CarolineMuellenbroich/Giovanni-goes-Giorgio/Neurophotonics/Images/laser-dpss-continuo-113403-3916845.jpg

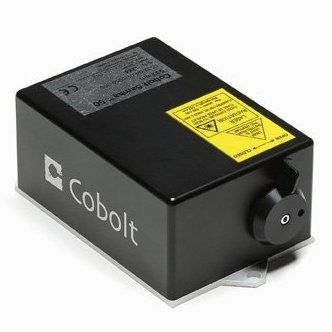
Neurophotonics/Images/laser-dpss-continuo-113403-3916845.jpg
