CarolineMuellenbroich/Giovanni-goes-Giorgio/Neurophotonics/Images/MDSnCxx_medium.jpg

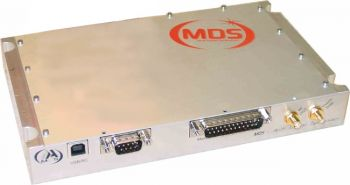
Neurophotonics/Images/MDSnCxx_medium.jpg
