CarolineMuellenbroich/Giovanni-goes-Giorgio/Neurophotonics/Stuff/latex-style-files-used/README.TXT

README - LATEX STYLE FILES USED

These files are supplied in case they are not readily available. It is preferable to download (or have system administrator downloag) current versions from CTAN.ORG.
