CarolineMuellenbroich/Giovanni-goes-Giorgio/Neurophotonics/Submitted files/manuscript_revision.tex

%  The following commands have been added in the SPIE class 
%  file (spieman.cls) and may not be understood in other classes:
%  \affiliations{}, \sup{},\supit{}, \authorinfo{}, \keywords{},
%  \linkable and \video
%  The bibliography style file is called spiejour.bst 

\documentclass[12pt]{spieman}  %>>> 12pt font mandatory; use this for US letter paper 
%%\documentclass[a4paper,12pt]{spieman}  %>>> use this instead for A4 paper
%%\documentclass[nocompress,12pt]{spieman}  %>>> to avoid compression of citations
%% \addtolength{\voffset}{9mm}   %>>> moves text field down
 
\usepackage[]{graphicx}
\usepackage{setspace}
\usepackage{tocloft}
\usepackage{units}
\usepackage{nicefrac}
\usepackage{color}
\usepackage{epstopdf}
\usepackage[globalcitecopy,labelstoglobalaux,sectionbib]{bibunits}
\usepackage[thinspace,thinqspace,squaren]{SIunits}
\usepackage{fancyhdr}
\usepackage{url}
\usepackage{wasysym}
%\usepackage{alltt}
%\renewcommand{\ttdefault}{txtt} 
\usepackage{array}
%\usepackage[version=3]{mhchem}
%\usepackage[T1]{fontenc}
%\usepackage{textcomp}
%\usepackage{verbatim} 
%\usepackage{mathpazo}
%\usepackage{amsmath} %>>> for AMS math formatting including bold Greek symbols
%\usepackage{mathtools}
\usepackage{amssymb}
\usepackage{accents}
%\usepackage{hyperref}
\usepackage{url}
\usepackage{amscd}
\usepackage{epsfig}
\usepackage{cite}
\usepackage{subfig}
\usepackage[globalcitecopy,labelstoglobalaux,sectionbib]{bibunits}
%\usepackage[sectionbib]{bibunits}
\usepackage{appendix}
\usepackage{slashbox}
\usepackage{multirow}
\usepackage{pbox}
%\usepackage{caption}
\usepackage{pdflscape}
\usepackage{nicefrac}
\usepackage{rotating}
\usepackage[colorlinks=true,citecolor=blue,urlcolor=blue,linkcolor=blue,
		pagebackref,
		hyperindex,%linktocpage,
		bookmarksnumbered=true,bookmarksopen=true,bookmarksopenlevel=0,
		pdfstartview=FitV,
		pdfstartpage=1]
	{hyperref} % makes pdf look nice with hyperlinks

\title{Comprehensive optical and data management infrastructure for high-throughput light-sheet microscopy of whole mouse brains} 

\author{M. Caroline M\"{u}llenbroich,\supscr{a,b} Ludovico Silvestri, \supscr{a,c} Leonardo Onofri,\supscr{a} Irene Costantini,\supscr{a} Marcel van 't Hoff,\supscr{a,b} Leonardo Sacconi,\supscr{a,c} Giulio Iannello,\supscr{e} Francesco S. Pavone,\supscr{a,b,c,d}  }

\affiliation{\supscrsm{a}European Laboratory for Non-Linear Spectroscopy (LENS), University of Florence, Italy\\
\supscrsm{b}Department of Physics and Astronomy, University of Florence, Italy\\
\supscrsm{c}National Institute of Optics, National Research Council, Italy\\
\supscrsm{d}International Center for Computational Neurophotonics (ICON Foundation), Italy\\
\supscrsm{e}Integrated Research Centre, University Campus Bio-Medico of Rome, Italy\\
}

%%%%%%%%%%%%%%%%%%%%%%%%%%%%%%%%%%%%%%%%%%%%%%%%%%%%%%%%%%%%% 
\renewcommand{\cftdotsep}{\cftnodots}
\cftpagenumbersoff{figure}
\cftpagenumbersoff{table} 
\begin{document} 
\maketitle 

%%%%%%%%%%%%%%%%%%%%%%%%%%%%%%%%%%%%%%%%%%%%%%%%%%%%%%%%%%%%% 
\begin{abstract}
The comprehensive mapping and quantification of neuronal projections in the central nervous system requires high-throughput imaging of large volumes with microscopic resolution. To this end, we have developed a confocal light-sheet microscope that has been optimised for the 3D imaging of structurally intact clarified whole-mount mouse brains. Here we describe the optical and electro-mechanical arrangement of the microscope and give details on the organisation of the microscope management software. The software orchestrates all components of the microscope, coordinates critical timing and synchronisation and has been written in a versatile and modular structure using the LabVIEW language.  It can easily be adapted and integrated to other microscope systems and has been made freely available to the light-sheet community. The tremendous amount of data routinely generated by light-sheet microscopy further requires novel strategies for data handling and storage. To complete the full imaging pipeline of our high- throughput microscope we further elaborate on big data management from streaming of raw images up to stitching of 3D data sets. The meso-scale neuroanatomy imaged at micron-scale resolution in those datasets allows characterisation and quantification of neuronal projections in unsectioned mouse brains. 
\end{abstract}

%>>>> Include a list of up to six keywords after the abstract
\keywords{Light-sheet microscopy, selective plane illumination microscopy, whole brain imaging, data management, software management, high-throughput imaging}

%>>>> Include contact information for corresponding author
{\noindent \footnotesize{\bf Address all correspondence to}: Francesco S. Pavone, LENS, University of Florence, Via Nello Carrara 1, 50019 Sesto Fiorentino (FI), Italy; Tel: +39 055 457 2480; E-mail:  \linkable{francesco.pavone@unifi.it} }
%%%%%%%%%%%%%%%%%%%%%%%%%%%%%%%%%%%%%%%%%%%%%%%%%%%%%%%%%%%%%

\begin{spacing}{2}   % use double spacing for rest of manuscript

%%%%%%%%%%%%%%%%%%%%%%%%%%%%%%%%%%%%%%%%%%%%%%%%%%%%%%%%%%%%%
\section{Introduction}
\label{sect:intro}  

The highly ambitious project of mapping and understanding each and every neuronal projection in the whole brain has been moved to feasible reality by the recent advent of light-sheet fluorescent microscopy (LSFM)\cite{Huisken2004,Dodt2007,Keller2012}. With this technique 3D data sets can be acquired with a resolution that is high enough to identify neurons and their dendritic and axonal features in time scales which are no longer the bottle neck of high-throughput acquisition. In LSFM, the sample is illuminated with a thin sheet of light confined into the focal plane of the detection objective, which collects the fluorescence emission along an axis perpendicular to the illumination plane\cite{Huisken2009}. This technique drastically reduces the imaging acquisition time by recording millions of pixels in parallel due to its wide-field detection and affords intrinsic optical sectioning due to the light-sheet illumination. Consequently fluorophores outside the light-sheet are neither bleached nor contribute blurring out-of-focus noise. Together these attributes cause a high spatio-temporal resolution and an excellent signal to noise ratio in LSFM. 

Several challenges remain to be overcome, however, to allow fast and, most of all, systematic production of reliable datasets and their meaningful interpretation to further our understanding of neuronal networks. Those challenges include fast, cheap and reproducible sample preparation and mounting, automated image acquisition and, most crucially, storage, interpretation and analysis of the vast data sets light-sheet microscopy routinely produces\cite{Freeman2014,Burns2014}. The mapping and understanding of this ``big data" is an immense task that requires the expertise of computer scientists to employ fully automated, scalable post-processing, for example, to do blood vessel segmentation or cell counting\cite{Frasconi2014}. On the other hand, the imaging of large, intrinsically opaque samples in LSFM necessitates clearing protocols based on refractive index matching which render the tissue transparent\cite{Chung2013,Tomer2014}. Therefore technological advances in LSFM need to be matched by novel development in the area of information- and biotechnology.

Here we will present a state-of-the-art light-sheet microscope, as it is implemented in our lab, that is especially well suited to acquire 3D data sets of clarified and structurally intact mouse brains. The LSFM features double-sided illumination with a digitally scanned light-sheet and a sample chamber which has been specifically designed for the the imaging of large ($> 1cm^3$) immersed and freely movable samples. After briefly introducing the optical setup we explain how to prepare and mount the samples for stable 3D imaging for several days. In addition, a full description of the control hardware and software is presented. The microscope software coordinates every microscope component and ensures critical timing and synchronisation between those components. We further give a systematic and robust approach to handle and store light-sheet microscopy data of several terabytes. To conclude the comprehensive and high-throughput imaging pipeline we furthermore elaborate on stitching of large 3D data sets. The imaging capabilities of our light-sheet microscope are exemplified with tomographies of whole transgenic mouse brains.

\section{Optical setup}

\subsection{Laser unit}		
The custom-made confocal light-sheet microscope is equipped with five linearly polarised, continuous-wave lasers for fluorescence excitation (Fig. \ref{fig:excitation},A). The wavelengths were chosen to excite the most common fluorophores (see Table \ref{tab:optomechanics} for the manufacturer and specifications of microscope components). The beam from each laser is first collimated and expanded with a telescope made of singlet lenses (f140, f200) and then combined into a common path with a mirror and a long-pass filter (Semrock, LaserMUX\texttrademark\ series). From here on all lenses are achromatic doublets coated for the visible spectrum. An acousto-optical tunable filter (AOTF) acts as fast ($\mu s$) electronically tunable filter and intensity modulator. Due its nonlinear response we measured the AOTF light transmittance for each wavelength as a function of radio frequency amplitude and determined a look-up table to linearise the output. The zero order light is blocked by an iris. A 1:1 telescope (f150,f150) is used to re-collimate the beam after the AOTF. An electro-optical laser modulator (EOM) acts like a wave plate with electronically controlled retardation and rapidly rotates (few hundreds ns) the input polarisation of the excitation light by $90\degree$. A digital line is used to switch between the voltage levels, allowing control of the frequency with which the polarisation is changed (see also section \ref{sec:timing} on timing).

\subsection{Illumination unit}		
The light impinges onto a polarising beam splitter cube which splits the excitation light depending on its polarisation into one of the two identical excitation arms. The beam diameter is reduced with a telescope (f350, f200) whose telecentric plane coincides with the mirrored surface of a galvanometric scanner (galvo). Both galvos are mounted on a custom made optical breadboard which features two circular holes to pass the periscopic beams and a large central cut-out for the sample chamber and motor stages (Fig. \ref{fig:excitation},B). 

Each scan mirror surface is re-imaged with a telescope (f50, f100) onto the back aperture of a long working distance low magnification objective (Nikon, 10x 0.3NA WD 17.5mm). The focal lengths of the doublets making up the telescope have been chosen for space considerations and to achieve a $1/e^2$ beam radius of 0.73mm at the back focal plane resulting in an effective NA of 0.025 (see also section \ref{sec:characterisation}). The galvos are in planes conjugated with the back focal plane of their respective excitation objective to ensure that a tilt angle of the galvo converts into a lateral translation of the Gaussian beam across the specimen. The two excitation objectives are designed for air immersion but are immersed into the clearing solution (n=1.45) within the sample chamber. A coverslip glued to the front housing edge serves the dual purpose of maintaining the first diffractive surface between the front optical element and the air and to protect the front lens elements from the clearing agent. A guide to align objectives to a common focus can be found in the supplementary information. The light-sheet is generated digitally\cite{Keller2008a,Keller2008b} by scanning the excitation beam across the focal plane of the detection objective. This generates incoherent illumination resulting in fewer artefacts. Additionally each line in the specimen is illuminated with the same intensity creating a homogeneous light-sheet which is particularly advantageous for the quantitative and qualitative investigation of large samples in their entirety.

\subsection{Detection unit}
			 
Fluorescence is collected with an objective that is specifically designed for immersion in clearing solutions. The objective is equipped with a correction collar allowing for immersion in media with refractive indices ranging from 1.41 to 1.52 (Olympus, XLSLPLN25XGMP, 25x, 1.0NA, effective focal length 7.2 mm, working distance 8mm). A tube lens of 200mm creates an image on a sCMOS camera (Orca Flash4.0, Hamamatsu) with a chip of over 4 megapixels. The cell size of the OrcaFlash is $p^2= (6.5\micro m)^2$ over an active area of $r^2= (13.3mm)^2$. With a 200mm tube lens the field of view (FOV) in the sample is $(480\micro m)^2$ (see also Table \ref{tab:resolution} in the supplementary information for relevant formulas). 

In the camera's rolling shutter acquisition mode only a subset of adjacent horizontal pixel lines is simultaneously exposed and this active detection region is moved across the image sensor\cite{Baumgart2012}. With the delay between the exposure of two adjacent lines set to the minimum time required to read out a single line ($t_{\text{shutter}}=9.7\micro s$) the entire frame of 2048 horizontal lines is activated within 19.86ms. Setting the line exposure time to $t_{\text{exp}}=0.3ms$, for instance, results in $l=\nicefrac{t_{\text{exp}}}{t_{\text{shutter}}}\approx31$  lines being simultaneously exposed at any time. This detection area is swept from the top to the bottom of the chip and acts like a moving, virtual confocal slit corresponding to a width of $s_{\text{object}}=\nicefrac{l p}{M_{\text{eff}}}= 7.2 \micro m $ in the sample space, where $M_{\text{eff}}$ is the effective magnification of the detection objective. With the given values of line exposure and line read out time, the camera acquires images at a full-frame rate of  $R_{\text{frame}} = \nicefrac{1}{(\#_{\text{horiz. lines}}*t_{\text{shutter}}+t_{\text{exp}})} \approx 50Hz$. 

The camera was run as master in the internal trigger mode and a synchronisation pulse generated with the exposure of each new line was used as an output trigger for a DAQ board (NI PCIe-6353, National Instruments) which was operated as slave. The saw-tooth driving signal for the galvo mirrors was generated by the DAQ and synchronised with the pixel line reset pulses from the camera to achieve confocal line detection (see also section \ref{sec:timing} on synchronisation).  

\subsection{Sample mounting and motion}
\label{sec:mounting}
		
We designed a cubic water-tight sample chamber (Fig. \ref{fig:frame2},A) that allows access from all six sides while maintaining the 3D integrity of large clarified and fluorescently labelled mouse brains. The sample chamber is tightly bolted  to the optical breadboard while soft connections using silicone bellows allow for adjustive movements of the objectives and free 3D motion of the motor stages (Fig. \ref{fig:frame2},B). Connections are sealed with rubber rings and silicone caulk and additionally tightened with cable binders. In this way the objectives can be refocused and realigned without compromising the watertight seal of the chamber (Fig. \ref{fig:frame2},C). The clarified brains are imaged immersed in clearing solution composed of 63\% 2,2'-thiodiethanol (TDE) in Phosphate buffered saline (PBS) and a refractive index of $n \approx 1.45$\cite{Costantini}. To fill the entire volume of the sample chamber approximately 150ml clearing solution are needed. A motorised x-, y-, z-, $\theta$-stage (see Table \ref{tab:optomechanics}) allows free 3D motion and rotation of a Teflon cylinder which reaches into the centre of the chamber (Fig. \ref{fig:frame2},D). Illumination and detection axes are horizontal while sample rotation occurs around the vertical axis.		
		
To elucidate neuronal projections in structurally intact tissue it is paramount to be able to image centimeter-sized clarified samples, such as mouse brains, with high resolution in whole mount preparation. The problem of sample mounting in a light-sheet microscope arises from the fact that optical access to the sample is required from 3-4 planar sides leaving only two opposing sides to insert, fix and move the sample. Stable mounting is hereby a key concern as a whole-brain tomography can require image acquisition in excess of 24 hours and the effects of gravity, tissue shrinking/expansion and evaporation of the clearing solution over such time spans might have to be considered. 

For the acquisition of whole-brain data sets, we fix a clarified and fluorescently-labelled mouse brain with super glue to a coverslip (Fig. \ref{fig:frame2},E). The brain is oriented along its axial orientation with the olfactory bulbs at the top and the cerebellum at the bottom of the coverslip. The coverslip is slid into a bottom adaptor and tightened with a plastic-capped grub screw. The bottom adaptor is inserted into a Teflon cylinder with the coverslip being positioned on the far side of the detection objective. Three different slits in the adapter correspond to varying distances to the detection objective and give variability in sample thickness for example to allow also for the mounting of rat brain hemispheres.
	
\subsection{Optical characterisation}
\label{sec:characterisation}
\subsubsection{Theoretical considerations}

The optical properties of a microscope can be quantified by the point-spread function (PSF), which is the image of a point source in object space. The radial (i.e. perpendicular to the detection axis) and axial (i.e. parallel to the detection axis) resolution of the microscope are most commonly described by the full width at half-maximum (FWHM) of the PSF itself along the chosen direction (Fig. \ref{fig:origin},A). In a light-sheet microscope axial and radial resolution are determined by the numerical aperture (NA) of the illumination and detection optics respectively. The radial PSF is a standard Airy function whose FWHM is given by:

\begin{equation}
\text{FWHM}_{\text{radial}} \simeq \frac{0.51 \lambda_0}{\text{NA}_{\text{d}}},
\end{equation}
$\lambda_0$ being the wavelength in vacuum and $\text{NA}_{\text{d}}$ the NA of the detection objective. The axial resolution is dominated by the thickness of the light sheet which for high NA detection objectives is usually larger than the depth of field of the detection objective. If Gaussian beams are used for illumination, the thickness of the light sheet can be calculated by the well-known formulas of Gaussian optics\cite{Teich}. The radius of the beam waist is given by:

\begin{equation}
w_0 = \frac{\lambda f_{\text{i}}^{\text{eff}}}{\pi w},
\end{equation}
where $w$ is the $1/e^2$ radius of the beam entering the illumination objective, $ f_{\text{i}}^{\text{eff}}$ is the effective focal length of the illumination optics and $\lambda$ is the wavelength in the medium ($\lambda = \lambda_0 / n$, $n$ being the refractive index). Note that for air objectives (as the one we use for illumination) the effective focal length is extended by a factor $n$ when used inside a medium with refractive index different from unity\cite{Silvestri2012}.
The axial FWHM is then given by:

\begin{equation}
\text{FWHM}_{\text{axial}} \simeq 1.177 w_0.
\end{equation}
The thickness of the light sheet is not constant throughout the FOV due to the limited depth of focus of the Gaussian beam. The latter can be quantified by the confocal parameter $b$, which is the distance along which the beam $1/e^2$ radius remains relatively constant and smaller than $\sqrt{2} w_0$:

\begin{equation}
b = \frac{2\pi w_0^2}{\lambda} = \frac{2 \lambda  {(f_{\text{i}}^{\text{eff}})}^2}{\pi w^2}.
\end{equation}
The need to have an almost uniform resolution in the camera FOV imposes a lower bound to $b$ and thus (according to the previous equations) a limit to the axial resolution. In our setup we adjusted the telescopes in the excitation path in order to have $w \simeq 0.73 mm$, resulting in $b \simeq 346 \micro m$ (corresponding to 72\% of the FOV) and $\text{FWHM}_{\text{axial}} \simeq 5.13 \micro m$ (assuming $\lambda_0 = 0.5 \micro m$). An overview of the relevant formulas concerning the optical properties of a light-sheet microscope is given in Table \ref{tab:resolution}. The reader is referred to this table as a quick guide to tailor their microscope to their specific needs.

\subsubsection{Experimental characterisation}

For optimal imaging it is crucial that the sample-emitted line of fluorescence is in the centre of the rolling shutter at the start of each image acquisition and furthermore travels with the same speed during stack acquisition. To this end the galvo scanners were calibrated using a fluorescein solution in the sample chamber and an image of the focal line was acquired for a set of mirror angles. By fitting each focal line profile to a Gaussian curve the position of the beam main axis was determined and plotted against the voltage applied to the galvo scanner. A linear fit to this data yielded the precise amplitude and offset for each galvo scanner. The finite width of the confocal slit was hereby taken into account such that maximum beam deflection corresponded to the central pixel line of the confocal slit coinciding with the first and last pixel row on the camera chip. From the same data the average FWHM of the Gaussian excitation line over the FOV of the camera was calculated as $(8.60\pm0.67)\micro m$ (n= 14). The disagreement with the theoretical value of $5.13 \micro m$ is likely attributed to the refractive index mismatch introduced in the excitation arm by the protective coverslip and by the optical path inside a medium with a refractive index different from air, both causing spherical aberrations\cite{Booth2001}.

For quantitative analysis of spatial resolution and the signal to noise ratio (SNR) image stacks of nanometric fluorescent beads ($0.51 \micro m$ diameter, Bangs Laboratories) were acquired. The spatial resolution, in agreement with previous findings\cite{Wilson1987,Cox2004}, was not affected by the confocal slit width on the camera (Fig. \ref{fig:origin},B). The lateral and axial FWHMs were $(1.00\pm0.04) \micro m$ and $(8.13\pm0.14) \micro m$ respectively, averaged through stack depths and confocal slit widths. The experimentally determined lateral FWHM was larger than the theoretically calculated value of $0.26 \micro m$ by a factor of four. The discrepancy is likely caused by higher order aberrations introduced by the gel embedding the fluorescent beads exacerbated by the high NA of our detection objective\cite{Schwertner2004,Schwertner2007}.

Qualitatively, the SNR increased with increasing slit width up to a maximum around the $1/e^2$ illumination beam diameter of $8.6 \micro m$ and then decreased again with further increasing slit width (Fig. \ref{fig:origin},C) in agreement with previous observations\cite{Baumgart2012}.   

\section{Microscope management software}

\subsection{General design}
The many components of the microscope (camera, lasers, AOTF, stages, etc.) are orchestrated and operated through a custom-made software written in the LabVIEW language (National Instruments, Austin, US). Since the microscope should work mainly without human intervention for many hours (a whole-brain tomography can last a couple of days) without losing precise synchronisation, stringent software design is a primary concern. The overall architecture of the software and its practical implementation were chosen to satisfy two main principles; firstly, operation in a distributed environment and secondly, robustness and ease of maintenance. This means, the apparatus should be able to deal with many independent hardware components and with several data streams (see below). Individual processing steps and/or data transfer can be computationally intensive, and may need to be distributed over several computers to perform properly at run-time. Any kind of hardware failure, from timing delays to complete system crash, must be automatically handled to avoid loss of data.

An object-oriented programming framework \cite{castagna1997object} has been used for software development, dividing the entire project into well-defined self-contained modules. This framework, besides helping defining the proper scope of each software component, guarantees robustness, ease of maintenance, scalability and reusability. Code was stored on GitHub (www.github.org) to help multiple users developing software simultaneously. The Murmex software development kit (see supplementary information \ref{sec:murmex}) was used to operate the software efficiently and synchronously on different computers.

\subsection{System timing}
\label{sec:timing}

A schematic overview of the hardware architecture of our LSFM is shown in Fig. \ref{fig:connectivity}. One personal computer (Precision T5600, Dell, see also Table \ref{tab:optomechanics}) controlled all the remote hardware components with the exception of the camera, which was controlled by a second, dedicated computer (Precision T7500, Dell) to handle and manage the enormous streams of data produced (see also section \ref{sec:dataflow}). Various instrumentations were addressed either through computer ports (as USB, RS232 and CameraLink) or via analog and/or digital signals generated by the DAQ board.

Synchronisation of the camera rolling shutter to the scanning of the light sheet was achieved by letting the camera acquiring in free-run mode, and using a trigger output from the camera itself to time the generation of the waveforms sent to the galvo drivers. The HSYNC signal from the camera was used which provided true-type-logic (TTL) pulse every time the rolling shutter stepped from one line to the next one. This trigger signal was used as a clock by the DAQ board so that the line producing the light sheet moved step by step with the rolling shutter. The same HSYNC signal was also used to trigger the DAQ digital signal sent to the laser modulator. Since at each position of the scanning line the modulator should go trough at least two states (vertical and horizontal polarisation), HSYNC was used as a trigger signal while the the much faster internal clock of the DAQ board served as clock.

\section{Data Management}
\label{sec:dataflow}

The volume of an adult mouse brain has been estimated from MRI measurements \cite{Kovacevic2005} as $\simeq 0.5$ $\text{cm}^3$; the same authors determined that a parallelepiped encompassing the whole brain would have a volume of $\simeq 0.9$ $\text{cm}^3$. Given the pixel size of the camera and the magnification of the system, and assuming a $z$ step of 2 $\micro$m, the voxel size amounts to $0.234\times0.234\times2$ $\micro\text{m}^3$. This means that a mouse brain will be represented with about 4.6 TeraVoxels, while a parallelepiped encompassing the brain will result in 8.2 TeraVoxels. Since the camera produces 16 bit images with no compression, each raw voxel occupies 2 bytes of disk space, resulting in 8.3 TB solely for the whole brain and 14.8 TB for the encompassing parallelepiped (see Table \ref{tab:dataproduction}). However, image stacks are acquired with 10\% of linear superposition, which is later used for image stitching. This redundancy expands the size of raw data to 10.2 TB and 18.3 TB, respectively.

This tremendous amount of data challenges the traditional way we interact with our data. Having far passed the point of taking your data home with you on a hard drive at the end of the experiment, the handling of data in light-sheet microscopy requires the development of a robust data management infrastructure and of novel software tools to process the images in order to extract meaningful information.

The camera flushed the data stream directly to a dedicated workstation with 12 solid-state drives (SSD) operating in RAID 0 configuration, resulting in a virtual drive of 10.9 TB. Although this was already a large and expensive system for the current SSD technology, it was much smaller than the size of the raw datasets produced in each tomography. We thus connected the workstation to a larger network area storage (NAS) via a 10 Gbit/s network copper cable. The NAS operates in a safer data modality (RAID 5) with 32.4 TB of useful disk space. The NAS is then connected by a dedicated 10 Gbit/s link provided by the Consortium GARR (the Public Institution managing research networks in Italy) to CINECA (the main Italian supercomputing centre). The data flow scheme is summarised in Fig. \ref{fig:DataFlow}.

While transferring data from the SSDs to the NAS, we perform on-the-fly conversion of files generated during sample acquisitions to a losslessly compressed multi-page TIFF format. Our conversion module leveraged the functionalities offered by the interface of the DCIMGAPI library, supplied by Hamamatsu, and the freely available LibTIFF library. The module read a single \textit{.cxd} 3D image and wrote it in a variable number of multi-page TIFF files, depending on the user-defined limit of pages per file. Since the output of the Hamamatsu camera may exceed tens of GB, the image in proprietary format was read slice by slice to minimise memory requirements. The conversion module ran concurrently with the microscope controlling software and was synchronised to convert stack files as soon as they are completed. The module provided options to downsample the image or to save the input image at full or reduced resolution in order to adapt to storage requirements. Usually we downsampled the image in the XY plane by a factor 2 and left the Z sampling unaltered. This downsampling, in combination with the lossless compression offered by the TIFF format, reduced data size by about one order of magnitude. Thus the parallelepiped volume containing the whole mouse brain took up about 2-3 TB of disk space. 

The process executing the file conversion was set to low priority to prevent interference with the Camera component, which needs to be perfectly timed with acquisition. Although file conversion drastically reduces data size, in the current implementation it was slower than data production. The camera flushed data to the SSDs with a rate $R_{\text{data}}$ dependent on the frame rate $R_{\text{frame}}$ and on the image size: $R_{\text{data}} [\text{Bytes}] = 2\cdot R_{\text{frame}} \cdot \#_{\text{pixels}}$
where the factor of two takes into account the 16 bit grey depth of images. The volumetric imaging rate is given by $R_{\text{volume}} = 0.5 R_{\text{data}} \cdot \text{voxel size}$.

With a standard image size of $2048 \times 2048$ pixels, and $R_{\text{frame}}=50$ Hz, data were produced at a rate $R_{\text{data}}=400$ MB/s $\approx 1.37$ TB/h, which resulted in a volumetric rate $R_{\text{volume}} \approx 2.3 \times 10^7$ $\micro\text{m}^3/s$ $\approx 0.08$ $\text{cm}^3$/h. The conversion module freed the SSDs with an average rate of $\approx$ 0.7 TB/h, meaning that the SSDs were actually filled up during imaging at a rate of $\approx$ 0.67 TB/h. Imaging sessions needed thus to be shorter than 16.3 hours which limited the maximum amount of raw data being acquired continuously to $\approx$ 22.3 TB. However, this was well above the disk space needed to image the parallelepiped volume encompassing a whole mouse brain. Larger specimens, as rat brain or portions of human brain, must be imaged in consecutive session until faster strategies for image conversion are devised.

\begin{table}%[t!]
	\centering
		\caption[Data production]{Data production rates for typical camera operation.\label{tab:dataproduction}}
		\begin{tabular}{lrl}
		\\
		Voxel size																								& $0.234 \times 0.234 \times 2$	& $\micro\text{m}^3$ 	\\
		Frame rate																								& 50														& Hz								\\
		Frame size																								& $2048 \times 2048$ 						& pixels						\\
		Frame disk size																						& 8									 						& MB								\\
		Data production rate																			& 1.37							 						& TB/h 							\\
		Data conversion rate																			& 0.7								 						& TB/h 							\\
		Net SSD filling rate																			& 0.67							 						& TB/h 							\\
		SSD RAID size																							& 10.9							 						& TB								\\
		Max acquisition time to fill up SSDs											& 16.3							 						& h									\\
		Max raw data size that can be acquired continuously				& 22.3							 						& TB								\\
		Max volume that can be imaged 														& 1.04							 						& $\text{cm}^3$ 		\\
		(considering 10\% superposition between adjacent stacks)	&										 						&										\\
		\end{tabular}
\end{table}

After acquisition, the tiled raw images produced had to be stitched to a 3D data set. To perform this operation we used the TeraStitcher\cite{Bria2012}, a fully automated stitching tool designed to deal with tiled images of virtually unlimited size. TeraStitcher can run on machines with limited resources with a performance essentially determined only by the transfer rate towards secondary storage. TeraStitcher can be freely downloaded from https://github.com/abria/TeraStitcher.

\section{Representative results}

Some representative data produced by our microscope are reported in Fig. \ref{fig:LSMdata}. With the apparatus described in this paper, whole mouse brains could be imaged in their entirety (Fig. \ref{fig:LSMdata},A), maintaining a high quality of the image also when going deep inside the specimen (Fig. \ref{fig:LSMdata},B). The resolution and contrast of the images allowed to clearly distinguish axonal tracts (Fig. \ref{fig:LSMdata},C) in the brain of a PV-cre-dTomato transgenic mouse, in which parvalbuminergic neurons are fluorescently labelled. Lateral and axial intensity profiles through a fine axonal projection were used to estimate resolution in a brain data set in terms of the FWHM in the lateral and axial directions (Fig. \ref{fig:LSMdata},D). The lateral and axial FWHM were $1.7 \micro m$ and $8.5 \micro m$ respectively, in agreement with the measurements on fluorescent beads.  Whole-brain datasets as presented here can be used to localise cell distributions in 3D using automatic cell-detection software \cite{Frasconi2014}.

\section{Discussion and conclusion}

Light-sheet microscopy has already been a game changer for large-scale, high-throughput imaging by yielding data of high spatio-temporal scale. This measurement technique will continue to have a high impact in the field of whole-brain imaging due to its ability to record millions of images over the course of days or even weeks. Here we have presented a complete and detailed framework for whole mouse brain imaging. Starting with a full description of our double-sided light-sheet microscope and its constituent components we further gave details of the custom-written control software which coordinates the microscope's reliably synchronised operation. The data produced in our experiments easily amounts several TB per data set and needs to be compressed, stored, transferred, retrieved and processed necessitating the concurrent development of novel computational interface and analysis methods. Here we have presented a comprehensive, robust and fully automated pipeline of data management starting from the streaming of raw images up to the stitching of 3D data sets.

%clearing
The mouse brains imaged in our microscope are intrinsically opaque and need to be clarified before imaging. A successful optical clearing method not only renders the tissue transparent but also causes neither quenching of protein fluorescence nor tissue distortion and is compatible with repetitive immunostaining. A very promising method called CLARITY\cite{Chung2013,Tomer2014} transforms tissue into a nanoporous, hydrogel-hybridised, lipid-free form. Crucially for the high-throughput imaging of large samples that we aim for, the protocol, however, is also fast, easy and cheap. We therefore developed a versatile, simple, rapid and inexpensive clearing method described elsewhere\cite{Costantini} which in combination with CLARITY allows for the optical clearing of entire mouse brains or portions of human tissue.

%ao
Even in refractive index-matched samples we have noticed that significant aberrations degrade image quality, especially at depths towards the end of the stack. Recently objectives specifically conceived for LSFM have become commercially available\cite{Marx2014} which have been designed for use with clearing solutions and typically also feature a correction collar for the compensation of a certain amount of spherical aberration. A complete correction of system-induced aberrations, however, requires the ability to also correct for residual spherical aberration and higher-order aberrations introduced by the sample mount, immersion medium and slight misalignments of the optical system. Of course, aberrations introduced by the sample itself also degrade image quality and it is those aberrations that are most difficult to correct at run-time due to their modal complexity, large amplitude and high spatial variability\cite{Wang2014}. 

Additionally another problem inherent to light-sheet microscopy degrades image quality: due to the uncoupled nature of excitation and detection in LSFM, the aberrations encountered in each arm are independent too and this can lead to a walk-off between the light sheet and the detection FOV when large samples are imaged at depths. Adaptive optics\cite{Booth2007} provides a means to compensate for these aberrations and has recently been applied to improve LSFM\cite{Jorand2012}. The prospect of high quality images is especially essential for high through-put imaging methods for whole-brain 3D reconstructions because the size of data sets is so large they warrant fully automated post processing for example for automated cell counting and identification\cite{Frasconi2014}. The effect of optical aberrations can severely obscure features even above the resolution limit and therefore hinder automated segmentation of the data. We have mounted the camera on a separate breadboard which leaves us with a lot of free, infinity-corrected space in the detection path. The implementation of adaptive optics technology into the fluorescence emission path of our LSFM in order to demonstrate real-time aberration corrected images for whole-brain reconstructions will be considered in the future. 

%Bessel beam
Further improvements in image quality may be achieved with beam shaping in the illumination arm, for example by implementing Bessel beam illumination\cite{Fahrbach2010,Planchon2011,Gao2014}. Using these self-reconstructing, non-diffractive beams the optical sectioning capability can be improved over an extended FOV. 

The streamlining of high-throughput imaging of entire mouse brains, starting from the live animal up to quantifiable data sets, requires tight integration of all aspects of the work flow. Even if the brains we image are transparent, their large size means that also comparatively small heterogenities in the refractive index matching sum up to large optical path differences and therefore strong aberrations at large imaging depth. The microscope used for whole-brain imaging needs to be developed and adapted bearing those imaging circumstances in mind and sample preparation methods, imaging technology and data management schemes have to work as a unit in order to deliver on the highly anticipated, quantifiable data sets of whole-brain neuronal projections.

\begin{landscape}
\begin{table}[t!]
	\centering
		\caption[Components]{Overview of microscope components.\label{tab:optomechanics}}
		\begin{tabular}{llll}
		Component														&	Manufacturer																& Part\# 						& Specifications 														\\\hline\hline
		\multirow{5}{*}[2.5em]{Lasers} 			& \multirow{5}{*}[2.5em]{Cobolt AB, Sweden}		& MLD								& 405nm,  80mW, s-polarised											\\
																				&																							& MLD								& 445nm, 50mW, s-polarised											\\
																				&   																					& Calypso						& 491nm, 50mW, s-polarised											\\
																				&																							& Fandango					& 515nm, 50mW, s-polarised											\\
																				&																							& Jive							& 561nm, 50mW, s-polarised											\\\hline
		AOTF																& AA Opto-Electronic, France									&AOTFnC-400.650-TN 	&	\pbox[t]{10.5cm}{$>90\%$ diffraction efficiency, 3nm resolution, low cross talk between laser lines, high separation angle}\\\hline
		Laser modulator 										& Qioptiq	GmbH, Germany												& LM 0202 VIS ADP		& 400-650nm , $\nicefrac{\lambda}{2}$-voltage (633nm): 210V			\\\hline
		Pulse amplifier 										& Falco Systems, The Netherlands							& WMA-300						& 50x amplification up to $\pm$ 150V, DC to 5MHz signal bandwidth		\\\hline
		Galvo scanner 											& Cambridge Technology, USA										& 6220H 						& small angle step response $200\mu s$								\\\hline		
		\multirow{2}{*}[0.6em]{Objectives}	&	Nikon; Japan																& Plan Fluor EPI 		& 10x0.3NA, WD 17.5mm, EFL 20mm (excitation)						\\
																				& Olympus, Japan															& LMPLFLN20X 				& 20x0.4NA, WD 12mm, EFL 9mm (detection)							\\\hline
		\multirow{3}{*}[1.2em]{Motor stages}& \multirow{2}{*}[0.6em]{Physik Instrumente, Germany}& C-863.11		& DC servo-motor controller								\\
																				&																							&	M-122							& Travel range 25mm, $0.1\micro m$ resolution, max. velocity 20mm/s	\\
																				&																							& M-116 						& Precision Rotation Stage, $2.5\micro rad$, max. velocity $20\degree /s$ \\\hline
		Camera 															& Hamamatsu, Japan														& Orca Flash4.0 	V2.0	& \pbox[t]{10.5cm}{sCMOS sensor, 2048(H) x 2048(V), cell dim.: $6.5\micro m$, active area: 13.3mm x 13.3mm, 16bit images}\\\hline
		DAQ board														& National Instruments, USA										& NI PCIe-6353			& \pbox[t]{10.5cm}{AI: 1 MS/s multichannel; 16-bit resolution, ±10 V; AO: 2.86 MS/s, 16-bit resolution, ±10 V; digital I/O lines (hardware-timed up to 10 MHz), 100MHz max counter frequency}\\\hline
		Workstation 1												& Dell, USA																		& T7500							&  \pbox[t]{10.5cm}{12GB RAM, Intel Xeon Processor X5647 @ 2.93 GHz, OS Windows 7 64 bit}\\
		Workstation 2												& Dell, USA																		& T5600							&  \pbox[t]{10.5cm}{8GB RAM, Intel Xeon Processor E5-2620 @ 2 GHz, OS Windows 7 64 bit}\\
		\end{tabular}
\end{table}
\end{landscape}

%%%%%%%%%%%%%%%%%%%%%%%%%%%%%%%%%%%%%%%%%%%%%%%%%%%%%%%%%%%%%
\acknowledgments
The authors are grateful to Riccardo Ballerini and Ahmed Hajeb from the mechanics workshop at LENS for fabrication of the sample chamber. We further thank Marco De Pas from the electronic workshop for his expertise in the fabrication of the custom-made amplification electronics. We thank GARR for the 10GB optical fibre connection to CINECA and  CINECA for hosting our data.\\ 
The research leading to these results has received funding from the European Union Seventh Framework Program (FP7\slash2007-2013) under grant agreements no. 604102 (Human Brain Project) and n$\degree$ 284464 (LASERLAB-EUROPE). The research has also been supported by the Italian Ministry for Education, University and Research in the framework of the Flagship Project NanoMAX, by  ``Ente Cassa di Risparmio di Firenze" (private foundation). Research activities were also supported by Regione Toscana in the program POR-CreO 2007-2013 (Linea di interventi 1.5.a - 1.6 - Bando Unico R\&S 2012) under grant agreement (CUP) n$\degree$ 6408.30122011.026000201. 

\section*{Conflict of interest}
M.v.H has a financial interest in Murmex by Distrio, Amsterdam the Netherlands.

%%%%%%%%%%%%%%%%%%%%%%%%%%%%%%%%%%%%%%%%%%%%%%%%%%%%%%%%%%%%%
%%%%% References %%%%%

%\bibliography{report2}   %>>>> bibliography data in report.bib
\bibliographystyle{spiejour}   %>>>> makes bibtex use spiejour.bst
\begin{thebibliography}{0}

\bibitem{Huisken2004} J. Huisken, J. Swoger, F. Bene, J. Wittbrodt, and E. Stelzer, ``Optical Sectioning Deep Inside Live Embryos by Selective Plane Illumination Microscopy," \emph{Science} \textbf{305}(5686), 1007–1009 (2004). 

\bibitem{Keller2012} P. Keller and H.-U. Dodt, ``Light sheet microscopy of living or cleared specimens," \emph{Curr. Opin. Neurobiol.} \textbf{22}(1), 138–43 (2012). 

\bibitem{Dodt2007} H.-U. Dodt, U. Leischner, A. Schierloh, N. J\"{a}hrling, C. Mauch, K. Deininger, J. Deussing, M. Eder, W. Zieglg\"{a}nsberger, et al., ``Ultramicroscopy: three-dimensional visualization of neuronal networks in the whole mouse brain," \emph{Nat. Methods} \textbf{4}(4), 331–336 (2007). 

\bibitem{Huisken2009} J. Huisken and D. Y. Stainier, ``Selective plane illumination microscopy techniques in developmental biology," \emph{Development} \textbf{136}(12), 1963–1975 (2009).

\bibitem{Freeman2014} J. Freeman, N. Vladimirov, T. Kawashima, Y. Mu, N. Sofroniew, D. Bennett, J. Rosen, C.-T. Yang, L. Looger, et al., ``Mapping brain activity at scale with cluster computing," \emph{Nat. Methods} \emph{11}(9), 941–950 (2014).

\bibitem{Burns2014} R. Burns, J. Vogelstein, and A. Szalay, ``From Cosmos to Connectomes: The Evolution of Data-Intensive Science," \emph{Neuron} \emph{83}(6), 1249-1252 (2014).

\bibitem{Frasconi2014} P. Frasconi, L. Silvestri, P. Soda, R. L. Cortini, F. S. Pavone and G. Iannello, ``Large-scale automated identification of mouse brain cells in confocal light sheet microscopy images," \emph{Bioinformatics} \textbf{30}(17), i587-i593 (2014).

\bibitem{Chung2013} K. Chung, J. Wallace, S. Y. Kim, S. Kalyanasundaram, A. S. Andalman, T. J. Davidson and K. Deisseroth, ``Structural and molecular interrogation of intact biological systems," \emph{Nature} \textbf{497}(7449), 332–33 (2013).

\bibitem{Tomer2014} R. Tomer, L. Ye, B. Hsueh and K. Deisseroth, ``Advanced CLARITY for rapid and high-resolution imaging of intact tissues," \emph{Nat. Protoc.} \textbf{9}(7), 1682-1697 (2014).

\bibitem{Keller2008a} P. J. Keller and E. H. K. Stelzer, ``Quantitative in vivo imaging of entire embryos with digital scanned laser light-sheet fluorescence microscopy," \emph{Curr. Opin. Neurobiol.} \textbf{18}(6), 624–632 (2008).

\bibitem{Keller2008b} P. J. Keller, A. D. Schmidt, J. Wittbrodt, and E. H. K. Stelzer, ``Reconstruction of zebrafish early embryonic development by scanned light-sheet microscopy," \emph{Science} \textbf{322}(5904), 1065–1069 (2008).

\bibitem{Costantini} I. Costantini, J.-P. Ghobril, A. P. Di Giovanna, A. L. Allegra Mascaro, L. Silvestri, M. C. M\"{u}llenbroich, L. Onofri, V. Conti, F. Vanzi, L. Sacconi, R. Guerrini, H. Markram, G. Iannello, and F. S. Pavone, ``A versatile clearing agent for multi-modal brain imaging," \emph{Sci. Rep.} \textbf{5}(9808), (2015).

\bibitem{Baumgart2012} E. Baumgart and U. Kubitscheck, ``Scanned light-sheet microscopy with confocal slit detection," \emph{Opt. Express} \textbf{20}(19), 21805-21814 (2012).

\bibitem{Teich} M. C. Teich and B. E. A. Saleh, ``Fundamentals of photonics," \emph{Canada, Wiley Interscience} 3 (1991).

\bibitem{Silvestri2012} L. Silvestri, A. Bria, L. Sacconi, G. Iannello,  and F. S. Pavone,  ``Confocal light-sheet microscopy: micron-scale neuroanatomy of the entire mouse brain," \emph{Opt. Express} \textbf{20}(18), 20582-20598 (2012).

\bibitem{Booth2001} M. J. Booth and T. Wilson, ``Refractive-index-mismatch induced aberrations in single-photon and two-photon microscopy and the use of aberration correction," \emph{J. Biomed. Opt.} \textbf{6}(3), 266–272 (2001).

\bibitem{Wilson1987} T. Wilson and A. R. Carlini, ``Size of the detector in confocal imaging systems," \emph{Opt. Lett.} \textbf{12}(4), 227–229 (1987).

\bibitem{Cox2004} G. Cox and C. J. Sheppard, ``Practical limits of resolution in confocal and non-linear microscopy," \emph{Microsc. Res. Tech.} \textbf{63}(1), 18–22 (2004).

\bibitem{Schwertner2004} M. Schwertner, M. J. Booth, and T. Wilson, ``Characterizing specimen induced aberrations for high NA adaptive optical microscopy," \emph{Opt. Express} \textbf{12}(26), 6540–6552 (2004).

\bibitem{Schwertner2007} M. Schwertner, M. J. Booth, and T. Wilson, ``Specimen‐induced distortions in light microscopy," \emph{J. Microsc.} \textbf{228}(1), 97-102 (2007).

\bibitem{Kovacevic2005} N. Kovacevic, J. T. Henderson, E. Chan, N. Lifshitz, J. Bishop, A. C. Evans, R. M. Henkelman, and X. J. Chen, "A Three-dimensional MRI Atlas of the Mouse Brain with Estimates of the Average and Variability", \emph{Cereb. Cortex} \textbf{15}(5), 639-45 (2005).

\bibitem{Bria2012} A. Bria and G. Iannello,  ``TeraStitcher-A tool for fast automatic 3D-stitching of teravoxel-sized microscopy images,"  \emph{BMC bioinformatics} \textbf{13}(1), 316 (2012).

\bibitem{Marx2014} V. Marx, ``Microscopy: seeing through tissue," \emph{Nat. Methods} \textbf{11}(12), 1209–1214 (2014).

\bibitem{Booth2007} M. J. Booth, ``Adaptive optics in microscopy," \emph{Transactions of the Royal Society A} \textbf{365}(1861), 2829-2843 (2007).

\bibitem{Jorand2012} R. Jorand, G. Corre, J. Andilla, A. Maandhui, C. Frongia, V. Lobjois, B. Ducommun, and C. Lorenzo, ``Deep and Clear Optical Imaging of Thick Inhomogeneous Samples," \emph{PLoS ONE} \textbf{7}(4), e35795 (2012).

\bibitem{Wang2014} K. Wang, D. E. Milkie, A. Saxena, P. Engerer, T. Misgeld, M. E. Bronner, J. Mumm, and E. Betzig, ``Rapid adaptive optical recovery of optimal resolution over large volumes," \emph{Nat. Methods} \textbf{11}(6), 625–628 (2014).

\bibitem {Fahrbach2010} F. Fahrbach and A. Rohrbach, ``A line scanned light-sheet microscope with phase shaped self-reconstructing beams," \emph{Opt. Express} \textbf{18}(23), 780–785 (2010).

\bibitem {Planchon2011} T. Planchon, L. Gao, D. Milkie, M. Davidson, J. Galbraith, C. Galbraith, and E. Betzig, ``Rapid three-dimensional isotropic imaging of living cells using Bessel beam plane illumination," \emph{Nat. Methods} \textbf{8}(5), 417–423 (2011).

\bibitem {Gao2014} L. Gao, L. Shao, B.-C. Chen, and E. Betzig, ``3D live fluorescence imaging of cellular dynamics using Bessel beam plane illumination microscopy," \emph{Nat. Protoc.} \textbf{9}(5), 1083–1101 (2014).

\bibitem{castagna1997object} G. Castagna, \emph{``Object-Oriented Programming A Unified Foundation,"} Birkh{\"a}user, Boston (1997).

\end{thebibliography}

\pagebreak
\section{Supplementary information}

\subsection{Alignment}

For LSFM it is crucial that excitation and detection occur on perpendicular axes because any deviation from this geometry results in obscured images of reduced resolution and contrast. The objectives need to be perfectly confocal so that the fluorescence generated in the swept excitation beam also falls within the detection objective's focal plane. Telecentric imaging, that is the imaging with two lenses which are the sum of their focal lengths apart (Fig. \ref{fig:alignment},A), is used to re-image the galvo scanners onto the back apertures of the excitation objectives. In the detection path, the camera chip needs to be positioned in an image plane of the detection objective. Additionally, homogeneous illumination from both sides impose strict symmetry considerations on both illumination arms that have not only to be sufficiently aligned with respect to themselves but function as a pair with recursive dependence. 

Our microscope was aligned with two tools, a shear plate to qualitatively assess collimation and a small mirror that can be mounted inside the sample chamber. The 0.5in mirror was first pierced with a drill using a ceramic drill bit to produce a hole roughly in its centre of the approximately the same diameter as the excitation beam inside the sample chamber (Fig. \ref{fig:alignment},B). Using a compact single axis adjustable mirror mount (V50-AX, Newport) attached to the Teflon cylinder allows to to adjust the pitch of the reflection with the mount and the yaw with the rotation stage while at the same time providing a very space efficient mounting for the pierced 0.5in mirror. With this ``sample mirror" three different positions can be easily implemented, firstly, back reflection by hitting the reflective surface at $0\degree$, secondly, transmission by laterally displacing the mirror until the light passes through the drilled hole (Fig. \ref{fig:alignment},C), and thirdly, reflection of the light by $90\degree$ by precisely turning the mirror mount by $45\degree$ using the rotation stage (Fig. \ref{fig:alignment},D). 

The excitation objectives are fixed on mounts which allow three dimensional translation plus pitch and yaw adjustment (LP-1A, Newport). In a first alignment step the beam paths of both excitation arms where brought to overlap through irises placed on the breadboard and the optical bench without any microscope objectives. We found it useful to use two mirrors in each periscope, one vertically mounted and one mounted at $45\degree$ for vertical deflection of the incoming beam. In this way full beam steering can be achieved to realign the periscope before hitting the galvo scanner. After this initial alignment the sample mirror was placed with its reflective surface in the centre of the central cut-out of the breadboard. The first excitation objective was placed into the beam path and brought to focus onto the sample mirror which was adjusted to reflect the light back into the same objective through the irises. Using a shear plate and a beam splitter cube the back reflected light was qualitatively adjusted for collimation using translation along the excitation axis of the objective mount (Fig. \ref{fig:alignment2},B). The sample mirror was then moved laterally to allow the excitation beam to pass through the drilled hole and the second excitation objective was placed (Fig. \ref{fig:alignment2},C). This time collimation was checked with the light going through both objectives and so their confocal placement was insured. Both excitation arms were then aligned recursively by starting at the putative confocal point between the objectives and placing successively lens after lens in the direction towards the light source, alternating between the two modalities illustrated in Fig. \ref{fig:alignment2},A. Finally, the sample mirror was positioned in deflection mode and the detection objective was aligned (Fig. \ref{fig:alignment2},D). 

\subsection{Sample preparation for optical characterisation}

The fluorescent beads (CP01F, Bang Laboratories, $0.51 \micro m$ diameter) used for quantitative analysis of spatial resolution and signal to noise ratio (SNR) were embedded in low- melting point agarose (4\% agarose in 63\%TDE in PBS). The agarose (A9793, Sigma-Aldrich) was dissolved then mixed with a diluted bead solution and left to polymerise over night on a coverslip. The coverslip was mounted inside the sample chamber as described in section \ref{sec:mounting}. The embedded sub-diffraction fluorescent beads were imaged with varying confocal slit widths ranging from $0.175 \micro m-70 \micro m$ in the sample space. For each slit width one stack of $200\micro m$ depth ($1 \micro m$ step size) was acquired and the one dimensional PSF in the lateral and axial directions were extracted manually with FIJI/ImageJ throughout the depth of the image stack. After fitting the lateral and axial profiles with Gaussian curves, the lateral and axial FWHM were averaged (n=10 data points) for different slit widths. The SNR was calculated according to $\text{SNR} = \nicefrac{(y_0 + A)}{y_0}$ where $y_0$ and $A$ are the offset and amplitude of the Gaussian fits.

\subsection{Sample preparation for whole-brain imaging}

Mouse brains were processed using a modified CLARITY protocol \cite{Chung2013} and cleared with a new refractive-index-matching medium \cite{Costantini}. Adult mice (post-natal day 56) were anaesthetised with isoflurane and transcardially perfused with 20 ml ice-cold phosphate-buffered saline (PBS) solution (pH 7.6) followed by 20 ml of a mixture of 4\% (wt/vol) paraformaldehyde (PFA), 4\% (wt/vol) acrylamide, 0.05\% (wt/vol) bis-acrylamide, 0.25\% (wt/vol) VA044 in PBS. We then extracted the brains from the skull and put them in the same PFA/acrylamide/bis-acrylamide/VA044/PBS solution at $4 \degree$ C for 3 days. Afterwards, we degassed the samples and increased their temperature to $37 \degree$ C to initiate polymerisation. The embedded samples were then extracted from the gel and washed with clearing solution solution (sodium borate buffer (200 mM, pH 8.5) containing 4\% (wt/vol) sodium dodecyl sulfate) at $37 \degree $ C through gentle shaking. To perform electrophoretic tissue clearing (ETC), hydrogel-embedded brains were placed in a custom-built organ-electrophoresis chamber. The same clearing solution was circulated through the chamber and a voltage of 20V was applied across the ETC chamber at $37 \degree$ C for several days. After clearing, brains were incubated in PBST0.1 (PBS and 0.1\% Triton X-100, pH 7.6) at $37 \degree$ C for 2 days to remove the clearing solution. As a final step, murine brains were incubated in 50 ml of 30\% and 63\% (vol/vol) 2,2'-thiodiethanol in 0.01M PBS (TDE/PBS), each for 1 day respectively at $37 \degree$ C while gently shaking. The final 63\% TDE/PBS solution has a refractive index $n\simeq 1.45$, allowing for refractive index matching and thus tissue transparency. The experimental protocols involving animals were designed in accordance with the laws of the Italian Ministry of Health. All experimental protocols were approved by the Italian Ministry of Health.

\subsection{Murmex}
\label{sec:murmex}

To operate the software efficiently and synchronously on different machines, the \href{http://sine.ni.com/nips/cds/view/p/lang/en/nid/212895}{Murmex} software development kit was used. This kit integrates the object-oriented programming paradigm with a messaging system, and can be used to create communicating yet independent software modules within a standardised programming scheme.

Murmex creates distributed finite state machines, design patterns in which one component proceeds from a particular state to another based on the message it receives either from itself or from other components. For sending and receiving messages, Murmex uses the library \href{http://sine.ni.com/nips/cds/view/p/lang/en/nid/211065}{LabbitMQ}, which is a wrapper of \href{http://www.rabbitmq.com/}{RabbitMQ}, a message-oriented middle-ware, however, these layers of abstraction are mostly hidden from the developers. 
Buffered, asynchronous and reliable communication between several software components is established by routing of messages by the broker to the specific software component pinpointed by its ID.
Murmex has twelve pre-defined states (eg, Initialise, Configure, Start, Stop, Proceed, Update) and a generic state for implementing custom states. Usually, just a few of this states are actually used in standard applications. An example of a standard implementation of the Murmex state machine for the camera is shown in Fig. \ref{fig:murmex}. Each Murmex component streams information about its current status to its 'observers' which are other components specified in its configuration file. Using this oberserver/observee hierarchy, it is possible to design a large and complex network of different components, running on various computers connected through a local connection or the internet while maintaining precise timing and synchronisation.

%\subsection{Software organisation}
Each hardware component in the LSFM was managed through its own software component (see supplementary information \ref{sec:murmex}). Since the galvo scanners and the electro-optical modulator were not addressed directly, but via analog and digital signals generated by the DAQ board, their software component just sent analog and digital waveforms to an additional intermediate component responsible for DAQ board management. Beyond hardware-related software, two additional software components, the Stack and Tomo components orchestrated the operation of the entire system. 

The Stack component was used to acquire image stacks along the detection axis, here the $z$ direction, and coordinates the Camera and the Stages components. Stacks are collected by continuously moving the sample along $z$ while keeping the camera acquiring in free run. The translation speed was calculated such that in the time needed to collect a single frame the specimen was moved by a $z$ step specified in the GUI. The Camera component used low-level libraries from Hamamatsu to save the data, producing one single \emph{.cxd} file (the proprietary, non-compressed, tiff-like format from Hamamatsu) for each image stack. The Camera component must write data to disk with perfect synchronisation, otherwise the nominal $z$ position of each frame is no more coincident with the real $z$ position of the plane imaged. For this reason, the process executing the Camera code was set to highest priority. Additionally, the Stack component checked the timing of data production, in order to re-acquire the image stack if the camera had encountered a timing issue. 

The Tomo component is a high-level component which coordinated the acquisition of adjacent, parallel, partially-overlapping stacks. The user can specify the volume to be imaged either by inserting the minimum and maximum $x$, $y$ and $z$ coordinates of a parallelepiped or by providing a \textit{.txt} file with the coordinates of individual stacks to be collected. The Tomo component informs the experimenter via email when the acquisition is terminated either cleanly or through errors.

All the software described here can be freely downloaded from \href{https://github.com/marcelvanthoff/Giorgio}{GitHub}. Due to its modular structure and of the extensive documentation, it can be easily integrated and adapted in other microscopy systems.

\subsection{Formulas}

In the table, $f_{\text{TL}}^{\text{design}}$ is the focal length of the tube lens for which the objective has been designed (200 mm for Leica and Nikon, 180 mm for Olympus and 165 mm for Zeiss), $f_{\text{TL}}^{\text{real}}$ the focal length of the tube lens actually employed, $\text{M}$ the nominal magnification of the objective, $n$ the refractive index of the immersion medium, $\lambda_0$ the wavelength in vacuum, $\lambda$ the wavelength in the medium, $w$ the $1/e^2$ radius of the Gaussian beam at the objective back focal plane, FN the field number of the objective, $p$ the physical pixel size, $r_{\text{chip}}$ the size of the camera chip, $t_{\text{shutter}}$ the pace of the rolling shutter (i.e. the time between exposure start in subsequent lines), $ t_{\text{exp}}$ the line exposure time. The subscripts $_i$ and $_d$ refers to illumination and detection, respectively.

\begin{table}[t!]
	\centering
		\caption[Main formulas]{Overview of the main formulas related to light-sheet microscopy. \label{tab:resolution}}
		\begin{tabular}{lrcl}
		\\
		\multicolumn{4}{l}{General formulas for microscope objectives}\\\hline\hline 
		Nominal focal length							& $f$ 													& $=$					& $f_{\text{TL}}^{\text{design}}/\text{M}$				\\	
		Effective focal length						& $f^{\text{eff}}$							& $=$					& $nf$													\\
		Effective magnification						& $\text{M}^{\text{eff}}$				& $=$					& $f_{\text{TL}}^{\text{real}}/f^{\text{eff}}$			\\\\
		\multicolumn{4}{l}{Excitation (Gaussian)}\\\hline\hline	
		Beam waist												&$w_0$													& $=$ 				& $ \lambda f_{\text{i}}^{\text{eff}} / \pi w$				\\
		Axial resolution									&$\text{FWHM}_{\text{axial}}$		& $\approx$   & $ 1.17 w_0 $											\\
		Confocal parameter								& b															& $=$  				& $2 \pi \omega_0^2 / \lambda$							\\
																			&  															& $=$   			& $2 \lambda {(f_{\text{i}}^{\text{eff}})}^2 / \pi w^2 $	\\\\
		\multicolumn{4}{l}{Detection}\\\hline\hline  
		Radial resolution									&$\text{FWHM}_{\text{radial}}$	& $=$					& $0.5 \lambda_0 / \text{NA}_{d}$						\\
		Objective field size							& S															& $=$					& $\text{FN}/{\text{M}}$								\\\\
		\multicolumn{4}{l}{Camera}\\\hline\hline  
		Pixel size object space						& $ p_{\text{object}}$					& $=$					& $p/  \text{M}^{\text{eff}}$							\\
		Camera FOV object space						&$\text{FOV}_{\text{object}}$		& $=$					& $r_{\text{chip}} / \text{M}^{\text{eff}}$				\\
																			&																& $=$					& $p_{\text{object}} \cdot \#_{\text{pixels}}$			\\
		Slit width on camera							& $s_{\text{camera}}$						& $=$					& $ p \cdot t_{\text{exp}} / t_{\text{shutter}} $			\\
		Slit width in object space				& $s_{\text{object}}$						& $=$					& $ s_{\text{camera}}/ \text{M}^{\text{eff}}$			\\
		Frame rate												& $\nu$													& $=$					& $1/(\#_{\text{horiz. lines}} \cdot t_{\text{shutter}} + t_{\text{exp}})$ \\\\

		\end{tabular}
\end{table}

\newpage
\pagebreak

		\begin{figure}
   \begin{center}
   \begin{tabular}{c}
   %\includegraphics[width=\textwidth]{panel1.eps}
   \end{tabular}
   \end{center}
   \caption{\label{fig:excitation} (A) Schematic of the light path. The galvo scanners are mounted above periscopes. LP: long-pass filter, I: iris, AOTF: acousto-optical tunable filter, LM: laser modulator, PBS: polarisation beam splitter. Green dotted: detection path. (B) Oblique view of the microscope. A custom-made breadboard serves to mount the sample chamber and objectives at an elevated height and features two circular holes at the edges for the periscopes and a large central cut-out for the translation stages. A second breadboard is used for the camera.} 
   \end{figure}
	
	\begin{figure}
   \begin{center}
   \begin{tabular}{c}
   %\includegraphics[width=\textwidth]{panel2.eps}
   \end{tabular}
   \end{center}
   \caption{\label{fig:frame2} Schematic of sample mounting and motion. (A) Fluorescence excitation (along x axis) and detection (along z axis) are operated on independent perpendicular light paths where the excitation light-sheet and the detection focal plane overlap. (B) The custom-made sample chamber is assembled with silicone bellows and seal rings. The clarified fluorescently-labelled brain is mounted on a Teflon cylinder in the centre of the watertight chamber filled with clearing solution (C) and can be translated and rotated freely with piezo motors (D). (E) Mounting of a clarified fluorescently labelled brain. The brain is glued onto a coverslip and inserted into an adapter that slides into the Teflon cylinder.} 
   \end{figure}		

\begin{figure}
   \begin{center}
   \begin{tabular}{c}
   %\includegraphics[width=\textwidth]{panel3.eps}
   \end{tabular}
   \end{center}
   \caption{\label{fig:origin} Optical characterisation. (A) Exemplary lateral and axial intensity profiles of nanometric beads and fits to Gaussian curves. (B) FWHM of the Gaussian fits with confocal slit width. Each data point is the average of 10 bead profiles. (C) Signal to noise ratio (SNR) as a function of slit width.} 
\end{figure}

\begin{figure}
   \begin{center}
   \begin{tabular}{c}
   %\includegraphics[width=\textwidth]{panel4.eps}
   \end{tabular}
   \end{center}
   \caption{\label{fig:connectivity} Schematic view of the hardware architecture of the microscope. Different kind of physical connections are depicted with different colours.} 
   \end{figure}
	
\begin{figure}
   \begin{center}
   \begin{tabular}{c}
   %\includegraphics[width=\textwidth]{panel5.eps}
   \end{tabular}
   \end{center}
   \caption{\label{fig:DataFlow} Scheme of the data flow. (A) Data streaming on the microscope. SSD: solid-state disk, RAID: redundant array of independent disks. Colours indicate the time-criticality (red: higher to green: lower) of each data stream. (B) Data production rate versus data conversion rate showing the maximum acquisition time and tomography size feasible before the SSD are filled up. NAS: network-attached storage} 
   \end{figure}	

\begin{figure}
   \begin{center}
   \begin{tabular}{c}
   %\includegraphics[width=\textwidth]{panel6.eps}
   \end{tabular}
   \end{center}
   \caption{\label{fig:LSMdata} Whole mouse brain tomography. Imaging of whole transgenic mouse brain treated with CLARITY and cleared with TDE 63\% imaged with Olympus, 25X objective. (A) 3D rendering of a parvalbumin-dTomato brain. (B) 3D rendering of a stack from PV-dTomato mouse brain, scale bar = $400 \micro m$. (C) High resolution insert showing axonal projections. Scale bar = $100 \micro m$. (D) Lateral and axial FWHM of the intensity profiles through single axon. Modified with permission from \cite{Costantini}.} 
   \end{figure}
	
\begin{figure}
   \begin{center}
   \begin{tabular}{c}
   %\includegraphics[width=\textwidth]{SOI1.eps}
   \end{tabular}
   \end{center}
   \caption{\label{fig:alignment} (A) Basic geometrical optics of a double-sided illumination light-sheet microscope. AD: achromatic doublet, PBS: polarising beam splitter, red: objective back focal planes and conjugated telecentric planes, green: image planes, blue: 4f telecentric lens system, black: alignment irises. (B) Alignment mirror with drilled hole for light transmission, mount for tip adjustment and adaptor for the Teflon tube. (C) With lateral movement the alignment mirror can be placed such that light is transmitted into the opposing excitation arm. (D) The alignment mirror can be rotated to precisely reflect by $90\degree$.} 
   \end{figure}	

\begin{figure}
   \begin{center}
   \begin{tabular}{c}
   %\includegraphics[width=\textwidth]{SOI2.eps}
   \end{tabular}
   \end{center}
   \caption{\label{fig:alignment2} (A) Working principle of a microscope objective (left): a collimated input beam is converted into a spherical wavefront. Right: inverted light path, a focal spot in the back aperture creates a collimated output. (B) Recursive placement of lenses using the sample mirror in back-reflection mode, (C) in transmission mode and (D) in reflection mode.} 
   \end{figure}	
	
\begin{figure}
   \begin{center}
   \begin{tabular}{c}
   %\includegraphics[width=\textwidth]{SOI3.eps}
   \end{tabular}
   \end{center}
   \caption{\label{fig:murmex} Schematic view of the work flow of a representative Murmex component operating a camera.} 
   \end{figure}
	
%\listoffigures
\end{spacing}
\end{document}
