CarolineMuellenbroich/Giovanni-goes-Giorgio/Neurophotonics/Stuff/manuscript_snellendo_Ludo.tex

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

%%%%%%%%%%%%%%%%%%%%%%%%%%%%%%%%%%%%%%%%%%%%%%%%%%%%%%%%%%%%% 
\renewcommand{\cftdotsep}{\cftnodots}
\cftpagenumbersoff{figure}
\cftpagenumbersoff{table} 
\begin{document} 
\maketitle 

%%%%%%%%%%%%%%%%%%%%%%%%%%%%%%%%%%%%%%%%%%%%%%%%%%%%%%%%%%%%% 
\begin{abstract}
The comprehensive mapping and quantification of neuronal projections in the central nervous system requires high-throughput imaging of large volumes with microscopic resolution. We have developed a confocal light-sheet microscope that has been optimised for the 3D imaging of structurally intact clarified whole-mount mouse brains. Here we describe the optical and electro-mechanical arrangement of the microscope and give details on the organisation of the microscope management software. The software orchestrates all components of the microscope, coordinates critical timing and synchronisation and has been written in a versatile and modular structure using the LabVIEW language.  It can easily be adapted and integrated to other microscope systems and has been made freely available to the light-sheet community. The tremendous amount of data routinely generated by light-sheet microscopy further requires novel strategies for data handling and storage. To complete the full imaging pipeline of our high- throughput microscope we further elaborate on big data management from the data streaming of raw images up to stitching and visualisation of 3D data sets. The meso-scale neuroanatomy imaged at micron-scale resolution in those datasets allows characterization and quantification of neuronal projections in unsectioned mouse brains. 
\end{abstract}

%>>>> Include a list of up to six keywords after the abstract
\keywords{Light-sheet microscopy, whole brain mounting, whole brain imaging, big data, data management, software management, imaging pipeline, high-throughput imaging}

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

%\begin{spacing}{2}   % use double spacing for rest of manuscript

%%%%%%%%%%%%%%%%%%%%%%%%%%%%%%%%%%%%%%%%%%%%%%%%%%%%%%%%%%%%%
\section{Introduction}%funnel shape
\label{sect:intro}  

The highly ambitious project of mapping and understanding each and every neuronal projection in the whole brain has been moved to feasible reality by the recent advent of light-sheet fluorescent microscopy (LSFM). With this technique 3D data sets can be acquired with a resolution that is high enough to identify neurons and their dendritic, axonal and spine features in time scales which are no longer the bottle neck of high-throughput acquisition. In LSFM, the sample is illuminated with a thin sheet of light confined into the focal plane of the detection objective, which collects the fluorescence emission along an axis perpendicular to the illumination plane\cite{Huisken2009}. This technique drastically reduces the imaging acquisition time by recording millions of pixels in parallel and affords optical sectioning by operating fluorescence excitation and detection on separate perpendicularly oriented paths where the excitation light-sheet and the detection focal plane overlap. Consequently fluorophores outside the light-sheet are neither bleached nor contribute blurring out-of-focus noise. 

Several challenges remain to be overcome, however, to allow fast and, most of all, systematic production of reliable datasets and their meaningful interpretation to further our understanding of neuronal networks. Those challenges include fast cheap and reproducible sample preparation and mounting, automated image acquisition and, most crucially, the storage, interpretation and analysis of the vast data sets light-sheet microscopy routinely produces. The mapping and understanding of this ``big data" is an immense task that requires the expertise of computer scientists to employ fully automated post-processing, for example, to do cell counting or blood vessel segmentation. On the other hand, the imaging of large, intrinsically opaque samples in LSFM necessitates clearing protocols based on refractive index matching which render the tissue transparent. Therefore technological advances in LSFM need to be matched by novel development in the area of information- and biotechnology.

Here we will present a state-of-the-art light-sheet microscope, as it is implemented in our lab, that is especially well suited to acquire 3D data sets of large clarified and structurally intact mouse brains. The LSFM features double-sided illumination with a digitally scanned light-sheet and a sample chamber which has been specifically designed for the the imaging of large ($> 1cm^3$) immersed and freely movable samples. After briefly introducing the optical setup we explain how to prepare and mount the samples for stable, 3D imaging for several days. In addition, a full description of the control hardware and software is presented. The microscope software coordinates every microscope component and ensures critical timing and synchronisation between those components. %The software code has been implemented using a versatile and modular scheme in the LabVIEW language and has been made freely available to the light-sheet community. 
We further give a systematic and robust approach to handle, store and analyse light-sheet microscopy data of tens of terabytes. To conclude the comprehensive and high-throughput imaging pipeline we furthermore elaborate on stitching and visualisation of large 3D data sets. The imaging capabilities of our light-sheet microscope are exemplified with tomographies of whole transgenic mouse brains.

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

\section{Optical path}

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

\subsection{Laser unit}		
The custom-made confocal light-sheet microscope is equipped with 5 linearly polarised cw lasers for fluorescence excitation (Fig. \ref{fig:excitation},A). The wavelengths were chosen to excite the most common fluorophores (see Table \ref{tab:optomechanics} for the manufacturer and specifications of opto-mechanical components). The laser light from each laser is first collimated and expanded with a telescope (f140, f200) and then combined into a common path with a beam steering mirror and a long-pass filter (Semrock, LaserMUX\texttrademark\ series). An acousto-optical tunable filter (AOTF) acts as fast ($\mu s$) electronically tunable filter and intensity modulator. %which uses the acousto-optical interaction inside an anisotropic medium to select and transmit any combination of up to four of the laser lines. The radio-frequency applied on the AOTF transducer controls the wavelength being transmitted into the first order and the radio-frequency amplitude allows to adjust the transmitted light intensity. 
Due its nonlinear response we measured the AOTF light transmittance for each wavelength as a function of radio frequency amplitude and determined a look-up table to linearise the output. The zero order light is blocked by an iris. An electro-optical laser modulator (EOM) acts like a wave plate with electronically controlled retardation and rapidly rotates (few hundreds ns) the input polarisation of the excitation light by $90\degree$. %The wavelength-dependent high voltage that needs to be applied to the birefringent crystal inside the modulator to change the optical path length is provided by a two-step amplification system. First, a low voltage analog signal from the data acquisition and generation (DAQ) board is pre-amplified with custom made electronics and then fed into a commercial high voltage amplifier. 
A digital line is used to switch between the voltage levels, allowing control of the frequency with which the polarisation is changed (see also section \ref{sec:timing} on timing). After the laser modulator the excitation beam is further expanded by a factor of two with two achromatic doublets (f100, f200). 

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

Each scan mirror surface is re-imaged with a telescope (f50, f100) onto the back aperture of a long working distance low magnification objective (Nikon, 10x 0.3NA WD 17.5mm).  The galvos are in planes conjugate with the back focal plane of their respective excitation objective to ensure that a tilt angle of the galvo converts into a lateral translation of the Gaussian beam across the specimen. The two excitation objectives are designed for air immersion but are immersed into the clearing solution (n=1.45) within the sample chamber. A coverslip glued to the front housing edge serves the dual purpose of maintaining the first diffractive surface between the front optical element and the air and to protect the front lens elements from the organic solvent. A guide to align objectives to a common focus can be found in the supplementary information. The light-sheet is generated digitally\cite{Keller2008a,Keller2008b} by scanning the excitation beam across the focal plane of the detection objective. This generates incoherent illumination resulting in fewer artefacts. %cite{StelzerNatMeth2014}.
Additionally each line in specimen is illuminated with the same intensity creating a homogeneous light-sheet which is particularly advantageous for the quantitative and qualitative investigation of large samples in their entirety.

\subsection{Detection unit}
			
%In its simplest form, the fluorescence detection unit of a light-sheet microscope is a conventional wide-field microscope: an objective lens, a fluorescent filter and a tube lens form an image on a wide-field detector. 
Fluorescence is collected with an objective that is specifically designed for immersion in clearing solutions. The objective is equipped with a correction collar allowing for immersion in media with refractive indices ranging from 1.41 to 1.52 (Olympus, XLSLPLN25XGMP, 25x, 1.0NA, effective focal length 7.2 mm). %To image the whole volume of interest the objective has a relatively low magnification of 25x and a large working distance of 8mm yet a high numerical aperture (1.0NA) affords high resolution imaging. 
A tube lens of 200mm creates the primary image on a sCMOS camera (Orca Flash4.0, Hamamatsu) with a chip of over 4 megapixels. %In contrast to CCD sensors each pixel of a sCMOS camera sensor has a separate photodetector and amplification unit which means that sCMOS pixels can be read out independently from each other. 
The cell size of the OrcaFlash is $p^2= (6.5\micro m)^2$ over an active area of $r^2= (13.3mm)^2$. With a 200mm tube lens the field of view (FOV) in the sample is $480\micro m$ (see also Table \ref{tab:resolution} for relevant formulas). 

In the camera's rolling shutter data acquisition mode only a subset of adjacent horizontal pixel lines is simultaneously exposed and this active detection region is moved across the image sensor\cite{Baumgart2012}. With the delay between the exposure of two adjacent lines set to the minimum time required to read out a single line ($t_{\text{shutter}}=9.7\micro s$) the entire frame of 2048 horizontal lines is activated within 19.86ms. Setting the line exposure time to $t_{\text{exp}}=0.3ms$ results in $l=\nicefrac{t_{\text{exp}}}{t_{\text{shutter}}}\approx31$  lines being simultaneously exposed at any time. This detection area is swept from the top to the bottom of the chip and acts like a moving, virtual confocal slit corresponding to a width of $s_{\text{object}}=\nicefrac{l p}{M_{\text{eff}}}= 7.2 \micro m $ in the sample space, where $M_{\text{eff}}$ is the effective magnification of the detection objective. With the given values of line exposure and line read out time, the camera acquires images at a frame rate of $\nu = \nicefrac{1}{(\#_{\text{horiz. lines}}*t_{\text{shutter}}+t_{\text{exp}})} \approx 50Hz$. 

The camera was run as master in the internal trigger mode and a synchronisation pulse generated with the exposure of each new line was used as as an output trigger for the DAQ board which was operated as slave. The saw-tooth driving signal for the galvo mirrors was generated by the DAQ and synchronised with the pixel line reset pulses from the camera to achieve confocal line detection\cite{Baumgart2012} (see also section \ref{sec:timing} on synchronisation). %Any deviation from precise synchronisation results in image artefacts and severely degraded image contrast. The confocal resolution can be changed at run-time by changing the user-defined line exposure time and with it the rolling shutter width, that is the number of horizontal pixel lines simultaneously exposed.   

\section{Sample mounting and motion}
\label{sec:mounting}
%Biological tissue is, bar of very few exemptions like the cornea or zebrafish larvae, highly scattering. Scattering is the deflection of light rays due to the heterogeneous mixture of cells and sub-cellular structures with varying refractive indices. Rayleigh scattering, the nearly isotropic and strongly wavelength dependent scattering of light by particles much smaller than the wavelength of light, and Mie scattering, which occurs on cellular structures such as organelles and other refractive structures which are larger than the wavelength of light, far outweigh absorption and cause most biological tissues to be opaque. In the visible spectrum, the scattering of fluorescence photons is dominant over ballistic fluorescence such that for the imaging of large samples optical clearing methods based on refractive index matching have been employed. These methods involve several chemical sample preparation steps to generate transparent yet structurally and anatomically intact tissue.
%
%A successful optical clearing method not only renders the tissue transparent but also causes neither quenching of protein fluorescence nor tissue distortion and is compatible with repetitive immunostaining. A very promising method called CLARITY\cite{Chung2013,Tomer2014} transforms tissue into a nanoporous, hydrogel-hybridized, lipid-free form. Crucially for high through-put clearing and imaging of large samples, the protocol, however, is ideally also fast, easy and cheap. Our lab therefore development a versatile, simple, rapid and inexpensive clearing method based on a water-soluble agent, 2,2'-thiodiethanol (TDE) which in combination with CLARITY allows for the optical clearing of entire mouse brains or human biopsies. With this protocol (see [cite Irene] for a detailed description) a mouse brain (Figure\ref{fig:Panel1},B) takes 1 month to clear at a costs of \$XY.
		
\begin{figure}
   \begin{center}
   \begin{tabular}{c}
   
   \end{tabular}
   \end{center}
   \caption{\label{fig:frame2} Schematic of sample mounting and motion. (A) Fluorescence excitation (along x axis) and detection (along z axis) are operated on independent perpendicular light paths where the excitation light-sheet and the detection focal plane overlap. (B) The custom-made sample chamber is assembled with silicone bellows and seal rings. The clarified fluorescently-labelled brain is mounted on a Teflon cylinder in the centre of the watertight chamber filled with clearing solution (C) and can be translated and rotated freely with piezo motors (D). (E) Mounting of a clarified fluorescently labelled brain. The brain is glued onto a coverslip and inserted into an adapter that slides into the Teflon cylinder.} 
   \end{figure}		

We designed a cubic water-tight sample chamber (Fig. \ref{fig:frame2},A) that allows access from all six sides while maintaining the 3D integrity of large clarified and fluorescently-labelled mouse brains. The sample chamber is tightly bolted  to the optical breadboard while soft connections using silicone bellows allow for adjustive movements of the objectives and free 3D motion of the motor stages (Fig. \ref{fig:frame2},B). All connections are sealed with rubber rings and silicone caulk and additionally tightened with cable binders. In this way the objectives can be refocused and realigned without compromising the watertight seal of the chamber (Fig. \ref{fig:frame2},C). The clarified brains are imaged immersed in clearing solution composed of 63\% TDE in Phosphate buffered saline (PBS) and a refractive index of 1.45. To fill the entire volume of the sample chamber approximately 250ml clearing solution are needed. A motorized x-, y-, z-, $\theta$-stage (Physik Instrumente, see Table \ref{tab:optomechanics}) allows free 3D motion and rotation of a Teflon cylinder which reaches into the centre of the chamber (Fig. \ref{fig:frame2},D). Illumination and detection axes are horizontal while sample rotation occurs around the vertical axis.		
		
To elucidate neuronal projections in structurally intact tissue it is paramount to be able to image centimeter-sized clarified samples, such as mouse brains, with high resolution in whole mount preparation. %While promising clearing protocols are well documented in literature\cite{Chung2013,Tomer2014}, the question of sample preparation and mounting in light-sheet microscopy is not trivial but requires novel approaches to such extent that it is becoming a separate field of research and very diverse strategies such as FEP tubes, 3D printed chambers and Quartz cuvettes have been reported\cite{Kaufmann2012,Pitrone2013,Olarte2012,Tomer2014}, however, these approaches are limited to much smaller sample volumes. 
The problem of sample mounting in a light-sheet microscope arises from the fact that optical access to the sample is required from 3-4 planar sides leaving only two opposing sides to insert, fix and move the sample. %Most commonly the vertical direction is chosen. 
Stable mounting is hereby a key concern as a whole brain tomography can require image acquisition in excess of 24 hours and the effects of gravity, tissue shrinking/expansion and evaporation of the clearing solution over such time spans might have to be considered. 

For the acquisition of whole brain data sets, we fix a clarified and fluorescently-labelled mouse brain with super glue to a coverslip (Fig. \ref{fig:frame2},E). The brain is oriented along its axial orientation with the olfactory bulbs at the top and the cerebellum at the bottom of the coverslip. The coverslip is slid into a bottom adaptor and tightened with a plastic-capped grub screw. The bottom adaptor is inserted into a Teflon cylinder with the coverslip being positioned on the far side of the detection objective. Three different slits in the adapter correspond to varying distances to the detection objective and give variability in sample thickness for example to allow also for the mounting of rat brain hemispheres.
	
\section{Optical characterisation}

\subsection{Theoretical considerations}

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

\begin{equation}
w_0 = \frac{\lambda f_{\text{i}}^{\text{eff}}}{\pi w} \, ,
\end{equation}

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

\begin{equation}
\text{FWHM}_{\text{axial}} \simeq 1.177 w_0 \, .
\end{equation}

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

The need to have an almost uniform resolution in the camera FOV imposes a lower bound to $b$ and thus (according to the previous equations) a limit to the axial resolution. In our setup we adjusted the telescopes in the excitation path in order to have $w \simeq 0.73 mm$, resulting in $b \simeq 346 \micro m$ (corresponding to 72\% of the FOV) and $\text{FWHM}_{\text{axial}} \simeq 5.13 \micro m$. An overview of the relevant formulas concerning the optical properties of a light-sheet microscope is given in Table \ref{tab:resolution}. The reader is referred to this table as a quick guide to tailor their microscope to their specific needs.

\subsection{Experimental characterisation}

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

For quantitative analysis of spatial resolution and the signal to noise ratio (SNR) we acquired image stacks of subresolution sized fluorescent beads ($0.51 \micro m$ diameter, Bangs Laboratories). The spatial resolution, in agreement with previous findings\cite{Wilson1987,Cox2004}, was not affected by the confocal slit width on the camera (Fig. \ref{fig:origin},B). The lateral and axial FWHMs averaged to $(1.00\pm0.04) \micro m$ and $(8.13\pm0.14) \micro m$ respectively (n=10). The experimentally determined lateral FWHM was larger than the theoretically expected value of $0.26 \micro m$ by a factor of four and this increase was most likely due to.... The experimentally determined axial FWHM was in good agreement with our measured light-sheet thickness of $8.6\micro m$ and marginally larger than the theoretically expected value.

The SNR increased with increasing slit width up to a maximum at a slit width of $7 \micro m$ (Fig. \ref{fig:origin},C).   

\section{System timing}
\label{sec:timing}

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

\section{Data Management}

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

\subsection{Data handling, storage and stitching}

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

With a standard image size of $2048\times 2048$ pixels, and $R_{\text{frame}}=44$ Hz, data are produced at a rate $R_{\text{data}}=352$ MB/s $\approx 1.2$ TB/h, which results in a volumetric rate $R_{\text{volume}} \approx 2\times 10^7$ $\micro\text{m}^3/s$ $\approx 0.07$ $\text{cm}^3$/h. The conversion module can empty the SSD with an average rate of about 0.7 TB/h, meaning that the SSD is actually filled up during imaging at a rate of about 0.5 TB/h. Imaging sessions should thus be shorter than 21.8 hours: this limits the maximum amount of raw data being acquired continuously to approximately 25.4 TB. This is well above the disk space needed to image the parallelepiped volume encompassing a whole mouse brain. Larger specimens, as rat brain or portion of human brain, must be imaged in consecutive session until faster strategies for image conversion are devised.

	\begin{figure}
   \begin{center}
   \begin{tabular}{c}
   
   \end{tabular}
   \end{center}
   \caption{\label{fig:DataFlow} Scheme of the data flow. (A) Data streaming on the microscope. SSD: solid-state disk, RAID: redundant array of independent disks, NAS: network-attached storage. Different colours (red, yellow and green) indicate the time-sensitivity (higher to lower) of each data movement. (B) Data production rate versus data conversion rate showing the maximum acquisition time and tomography size feasible before the SSD are filled up.} 
   \end{figure}

\begin{table}%[t!]
	\centering
		\caption[Data production]{Data production rates for typical camera operation.\label{tab:dataproduction}}
		\begin{tabular}{lrl}
		\\
		Voxel size																								& $0.234 \times 0.234 \times 2$	& $\micro\text{m}^3$ 	\\
		Frame rate																								& 44														& Hz								\\
		Frame size																								& $2048 \times 2048$ 						& pixels						\\
		Frame disk size																						& 8									 						& MB								\\
		Data production rate																			& 1.2								 						& TB/h 							\\
		Data conversion rate																			& 0.7								 						& TB/h 							\\
		Net SSD filling rate																			& 0.5								 						& TB/h 							\\
		SSD RAID size																							& 10.9							 						& TB								\\
		Max acquisition time to fill up SSDs											& 21.8							 						& h									\\
		Max raw data size that can be acquired continuously				& 25.4							 						& TB								\\
		Max volume that can be imaged 														& 1.24							 						& $\text{cm}^3$ 		\\
		(considering 10\% superposition between adjacent stacks)	&										 						&										\\
		\end{tabular}
\end{table}

%relevant dimensions in typical acquisition sessions 

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

\section{Representative results}

	\begin{figure}
   \begin{center}
   \begin{tabular}{c}
   
   \end{tabular}
   \end{center}
   \caption{\label{fig:LSMdata} Whole mouse brain tomography. Imaging of whole transgenic mouse brains treated with CLARITY and cleared with TDE 63\% imaged with Olympus, 25X objective. (A) 3D rendering of a parvalbumin-dTomato brain. (B) 3D rendering of stacks from PV-dTomato mouse brain, GAD-dTomato mouse brain,  PI stained mouse brain, scale bar = $400 \micro m$. (C,D,E) High resolution insert, of the stack corresponding to red boxes in C. Scale bar = $100 \micro m$. Modified with permission from \cite{Costantini}.} 
   \end{figure}
	
Some representative data produced by our microscope are reported in Fig. \ref{fig:LSMdata}. With the apparatus describe in this paper, whole mouse brains can be imaged in their entirety (Fig. \ref{fig:LSMdata}A), maintaining a high quality of the image also while going deep inside the specimen (Figs. \ref{fig:LSMdata}B). The resolution and contrast of the images allow distinguish axonal tracts (Fig. \ref{fig:LSMdata}C) in the brain of a PV-cre-dTomato transgenic mouse, in which parvalbuminergic neurons are fluorescently labeled. GABAergic interneurons can be clearly identified using a GAD2-cre-dTomato mouse (Fig. \ref{fig:LSMdata}D), while nuclear staining with propidium iodide (PI) permits to visualize all the cells (neuronal or not) in the brain. Such whole-brain dataset can be used to localize cellular distribution in three-dimensions using automatic cell-detection software \cite{Frasconi2014}.

\section{Conclusion}

Light sheet microscopy has already been a game changer for large-scale imaging by yielding data with a extraordinary spatio-temporal scale. The impact of this measurement technique will continue to have a high impact in the field of whole brain imaging due to its ability to record millions of images over the course of days or even weeks. The data produced in this fashion easily amounts several TB per data set and needs to be stored, transferred, retrieved, processed and visualised necessitating the concurrent development of novel computational interface and analysis methods. The latter need to be robust, standardised and fully automated processes yet allow for flexible, exploratory and tailored analysis. 

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

%%%%%%%%%%%%%%%%%%%%%%%%%%%%%%%%%%%%%%%%%%%%%%%%%%%%%%%%%%%%%
\acknowledgments
The authors are grateful to Riccardo Ballerini and Ahmed Hajeb from the mechanics workshop at LENS for the their expertise in the conception and fabrication of the sample chamber. We thank GARR for the 10GB optical fibre connection to CINECA and  CINECA for hosting us on PICO. Human Brain Project tutta la vita. 

%%%%%%%%%%%%%%%%%%%%%%%%%%%%%%%%%%%%%%%%%%%%%%%%%%%%%%%%%%%%%
%%%%% References %%%%%

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

\bibitem{castagna1997object} G. Castagna, \emph{``Object-Oriented Programming A Unified Foundation,"} Birkh{\"a}user, Boston (1997).

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

\bibitem{Costantini} I. Costantini, J.-P. Ghobril, A. P. Di Giovanna, A. L. Allegra Mascaro, L. Silvestri, M. C. Muellenbroich, L. Onofri, V. Conti, F. Vanzi, L. Sacconi, R. Guerrini, H. Markram, G. Iannello, and F. S. Pavone, \emph{submitted}.

\end{thebibliography}

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

%\listoftables
\pagebreak
\section{Supplementary information}

\subsection{Alignment}

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

\subsection{Methods}

\subsubsection{Sample preparation for optical characterisation}
The fluorescent beads (CP01F, Bang Laboratories, $0.51 \micro m$ diameter) used for quantitative analysis of spatial resolution and the signal to noise ratio (SNR) were embedded in low- melting point agarose (2\% agarose in 64\%TDE in PBS). The low melting point agarose (A-4018, Sigma-Aldrich) was dissolved at $40 \degree$ C then mixed with a diluted bead solution and left to polymerise over night on a coverslip. The coverslip was then mounted inside the sample chamber as described in section \ref{sec:mounting}. The embedded sub-diffraction fluorescent beads were imaged with varying confocal slit widths ranging from 0.25 units to 100 confocal units corresponding to slit widths changing from $0.175 \micro m-70 \micro m$ in the sample space. For each slit width one stack of $200\micro m$ depth ($1 \micro m$ step size) was acquired and the one dimensional PSF in the lateral and axial directions were extracted manually with FIJI/ImageJ (eg. Fig. \ref{fig:origin},A) throughout the depth of the image stack. After fitting the lateral and axial profiles with Gaussian curves, the lateral and axial FWHM were averaged (n=10 data points) for different slit widths. The SNR was calculated according to $\text{SNR} = \nicefrac{y_0 + A}{y_0}$ where $y_0$ and $A$ are the offset and amplitude of the Gaussian fits.

\subsubsection{Sample preparation for whole brain imaging}
Mouse brains were processed using the CLARITY protocol \cite{Chung2013} and cleared with a new refractive-index-matching medium \cite{Costantini}. Adult mice (post-natal day 56) were anaesthetized with isoflurane and transcardially perfused with 20 ml ice-cold phosphate-buffered saline (PBS) solution (pH 7.6) followed by 20 ml of a mixture of 4\% (wt/vol) paraformaldehyde (PFA), 4\% (wt/vol) acrylamide, 0.05\% (wt/vol) bis-acrylamide, 0.25\% (wt/vol) VA044 in PBS. We then extracted the brains from the skull and put them in the same PFA/acrylamide/bis-acrylamide/VA044/PBS solution at 4°C for 3 days. Afterwards, we degassed the samples and increased their temperature to 37 °C to initiate polymerization. The embedded samples were then extracted from the gel and washed with clearing solution solution (sodium borate buffer (200 mM, pH 8.5) containing 4\% (wt/vol) sodium dodecyl sulfate) at 37 °C through gentle shaking. To perform electroforetic tissue clearing (ETC), hydrogel-embedded brains were placed in a custom-built organ-electrophoresis chamber. The same clearing solution was circulated through the chamber and a voltage of 20V was applied across the ETC chamber at 37 °C for several days. After clearing, brains were incubated in PBST0.1 (PBS and 0.1\% Triton X-100, pH 7.6) at 37 °C for 2 days to remove the clearing solution. As a final step, murine brain were incubated in 50 ml of 30\% and 63\% (vol/vol) 2,2'-thiodiethanol in 0.01M PBS (TDE/PBS), each for 1 day respectively at 37°C while gently shaking. The final 63\% TDE/PBS solution has a refractive index $n\simeq 1.45$, allowing for refractive index matching and thus tissue transparency.

\subsection{Software management}

\subsubsection{General design}

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

\subsubsection{Murmex}
\label{sec:murmex}
	\begin{figure}
   \begin{center}
   \begin{tabular}{c}
   
   \end{tabular}
   \end{center}
   \caption{\label{fig:murmex} Schematic view of the work flow of a representative Murmex component operating a camera.} 
   \end{figure}

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

\subsubsection{Microscope software}
Each hardware component in the microscope (AOTF, galvo scanners, electro-optical modulator, sample stages, camera, lasers) is managed through its own Murmex component (see supplementary information \ref{sec:murmex}). Since the galvo scanners and the electro-optical modulator are not addressed directly, but via analog and digital signals generated by the DAQ board, their software component just sends analog and digital waveforms to an additional intermediate component responsible for DAQ board management. Beyond hardware-related software, two additional Murmex components, the Stack and Tomo components (see below) orchestrate the operation of the entire system. 

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

\subsection{Formulas}
\begin{table}[t!]
	\centering
		\caption[Main formulas]{Overview of the main formulas related to light-sheet microscopy. In the table, $f_{\text{TL}}^{\text{design}}$ is the focal length of the tube lens for which the objective has been designed (200 mm for Leica and Nikon, 180 mm for Olympus and 165 mm for Zeiss), $f_{\text{TL}}^{\text{real}}$ the focal length of the tube lens actually employed, $\text{M}$ the nominal magnification of the objective, $n$ the refractive index of the immersion medium, $\lambda_0$ the wavelength in vacuum, $\lambda$ the wavelength in the medium, $w$ the $1/e^2$ radius of the Gaussian beam at the objective back focal plane, FN the field number of the objective, $p$ the physical pixel size, $r_{\text{chip}}$ the size of the camera chip, $t_{\text{shutter}}$ the pace of the rolling shutter (i.e. the time between exposure start in subsequent lines), $ t_{\text{exp}}$ the line exposure time. The subscripts $_i$ and $_d$ refers to illumination and detection, respectively. \label{tab:resolution}}
		\begin{tabular}{lrcl}
		\\
		\multicolumn{4}{l}{General formulas for microscope objectives}\\\hline\hline 
		Nominal focal length							& $f$ 													& $=$					& $f_{\text{TL}}^{\text{design}}/\text{M}$				\\	
		Effective focal length						& $f^{\text{eff}}$							& $=$					& $nf$													\\
		Effective magnification						& $\text{M}^{\text{eff}}$				& $=$					& $f_{\text{TL}}^{\text{real}}/f^{\text{eff}}$			\\\\
		\multicolumn{4}{l}{Excitation (Gaussian)}\\\hline\hline	
		Beam waist												&$w_0$													& $=$ 				& $ \lambda f_{\text{i}}^{\text{eff}} / \pi w$				\\
		Axial resolution									&$\text{FWHM}_{\text{axial}}$		& $\approx$   & $ 1.17 w_0 $											\\
		Confocal parameter								& b															& $=$  				& $2 \pi \omega_0^2 / \lambda$							\\
																			&  															& $=$   			& $2 \lambda {(f_{\text{i}}^{\text{eff}})}^2 / \pi w^2 $	\\\\
		\multicolumn{4}{l}{Detection}\\\hline\hline  
		Radial resolution									&$\text{FWHM}_{\text{radial}}$	& $=$					& $0.5 \lambda_0 / \text{NA}_{d}$						\\
		Objective field size							& S															& $=$					& $\text{FN}/{\text{M}}$								\\\\
		\multicolumn{4}{l}{Camera}\\\hline\hline  
		Pixel size object space						& $ p_{\text{object}}$					& $=$					& $p/  \text{M}^{\text{eff}}$							\\
		Camera FOV object space						&$\text{FOV}_{\text{object}}$		& $=$					& $r_{\text{chip}} / \text{M}^{\text{eff}}$				\\
																			&																& $=$					& $p_{\text{object}} \cdot \#_{\text{pixels}}$			\\
		Slit width on camera							& $s_{\text{camera}}$						& $=$					& $ p \cdot t_{\text{exp}} / t_{\text{shutter}} $			\\
		Slit width in object space				& $s_{\text{object}}$						& $=$					& $ s_{\text{camera}}/ \text{M}^{\text{eff}}$			\\
		Frame rate												& $\nu$													& $=$					& $1/(\#_{\text{horiz. lines}} \cdot t_{\text{shutter}} + t_{\text{exp}})$ \\\\

		\end{tabular}
\end{table}

%\end{spacing}
\end{document}
