CarolineMuellenbroich/Giovanni-goes-Giorgio/Neurophotonics/Stuff/manuscript_snellendo.tex

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

%%%%%%%%%%%%%%%%%%%%%%%%%%%%%%%%%%%%%%%%%%%%%%%%%%%%%%%%%%%%% 
\renewcommand{\cftdotsep}{\cftnodots}
\cftpagenumbersoff{figure}
\cftpagenumbersoff{table} 
\begin{document} 
\maketitle 

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

%\begin{spacing}{2}   % use double spacing for rest of manuscript

%%%%%%%%%%%%%%%%%%%%%%%%%%%%%%%%%%%%%%%%%%%%%%%%%%%%%%%%%%%%%
\section{Introduction}%funnel shape
\label{sect:intro}  

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

\section{Optical setup}

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

\subsubsection{Theoretical considerations}

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

\begin{equation}
w_0 = \frac{\lambda f_{\text{i}}^{\text{eff}}}{\pi w} \, ,
\end{equation}

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

\begin{equation}
\text{FWHM}_{\text{axial}} \simeq 1.177 w_0 \, .
\end{equation}

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

\subsubsection{Experimental characterisation}

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

For quantitative analysis of spatial resolution and the signal to noise ratio (SNR) we acquired image stacks of nanometric fluorescent beads ($0.51 \micro m$ diameter, Bangs Laboratories). The spatial resolution, in agreement with previous findings\cite{Wilson1987,Cox2004}, was not affected by the confocal slit width on the camera (Fig. \ref{fig:origin},B). The lateral and axial FWHMs were $(1.00\pm0.04) \micro m$ and $(8.13\pm0.14) \micro m$ respectively, averaged through stack depths and confocal slit widths. The experimentally determined lateral FWHM was larger than the theoretically calculated value of $0.26 \micro m$ by a factor of four while the experimentally determined axial FWHM was 1.6x larger than the theoretically calculated value of $5.13 \micro m$. The discrepancies, most notably in the lateral direction, are likely caused by aberrations introduced by the gel embedding the fluorescent beads.

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

\section{Microscope management software}

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

\subsection{System timing}
\label{sec:timing}

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

%relevant dimensions in typical acquisition sessions 

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

\section{Data}

	\begin{figure}
   \begin{center}
   \begin{tabular}{c}
   
   \end{tabular}
   \end{center}
   \caption{\label{fig:LSMdata} Whole mouse brain tomography. Imaging of whole transgenic mouse brains treated with CLARITY and cleared with TDE 63\% imaged with Olympus, 25X objective. (A) 3D rendering of a parvalbumin-dTomato brain. (B) 3D rendering of stacks from PV-dTomato mouse brain, GAD-dTomato mouse brain,  PI stained mouse brain, scale bar = $400 \micro m$. (C,D,E) High resolution insert, of the stack corresponding to red boxes in C. Scale bar = $100 \micro m$.} 
   \end{figure}
	
	To exemplify the imaging capabilities of our microscope see Fig. \ref{fig:LSMdata}. 

\section{Conclusion}

%essential features of a good discussion:
%• Try to present the principles, factual relationships and generalisations shown by the results. Discuss dont recapitulate.
%• Noting strengths and limitations. Point out nay exceptions or any lack of correlation and define unsettled points. Never take the high-risk alternative of trying to cover up or fudge data that do not quite fit.
%• Show how your results and interpretations agree (or contrast) with previously published work.
%• Significance of the work: ..so what? Don’t be shy, discuss the theoretical implimication of your work, as well as any possible practical applications. The discussion should end with a short summary or conclusion regarding the significance of the work. Leave with a bang not a whimper.
%• State your conclusions as clearly as possible.
%• Summarise your evidence for each conclusion. Never assume anything.
%• Introduction and discussion function as a pair: the intro should have posed one or more questions. The discussion should indicate what the findings say about the answers. Be sure the discussion answers what the intro asked.
%• Reverse funnel structure: first restate the main findings, then discuss how they relate to findings in previous research, then note implications and applications, and then identify unanswered questions well suited for future research.

Light sheet microscopy has already been a game changer for large-scale, high-throughput imaging by yielding data with a high spatio-temporal scale. The impact of this measurement technique will continue to have a high impact in the field of whole brain imaging due to its ability to record millions of images over the course of days or even weeks. Here we have presented a complete and detailed framework for whole mouse brain imaging. Starting with a full description of our double-sided light sheet microscope and its constituent components we further gave details of the custom-written control software which coordinates the microscope's reliably synchronised operation. The data produced in our experiments easily amounts several TB per data set and needs to be compressed, stored, transferred, retrieved, processed and visualised necessitating the concurrent development of novel computational interface and analysis methods. Here we have presented a comprehensive, robust and fully automated pipeline of data management starting from the streaming of raw images up to the stitching of 3D data sets.

%clearing
The mouse brains imaged in our microscope are intrinsically opaque and need to be clarified before imaging. A successful optical clearing method not only renders the tissue transparent but also causes neither quenching of protein fluorescence nor tissue distortion and is compatible with repetitive immunostaining. A very promising method called CLARITY\cite{Chung2013,Tomer2014} transforms tissue into a nanoporous, hydrogel-hybridized, lipid-free form. Crucially for the high-throughput imaging of large samples that we aim for the protocol, however, is also fast, easy and cheap. We therefore development a versatile, simple, rapid and inexpensive clearing method described elsewhere\cite{Costantini} which in combination with CLARITY allows for the optical clearing of entire mouse brains or human biopsies.

%ao
We have noticed that significant aberrations degrade image quality, especially at depths towards the end of the stack, even in refractive index-matched samples. Recently objectives specifically conceived for LSFM have become commercially available\cite{Marx2014} which have been designed for use with clearing solutions and typically also feature a correction collar for the compensation of a certain amount of spherical aberration. A complete correction of system-induced aberrations, however, requires the ability to also correct for residual spherical aberration and higher-order aberrations introduced by the sample mount, immersion medium and slight misalignments of the optical system. Additionally aberrations introduced by the sample itself degrade image quality. Additionally another problem inherent to light sheet microscopy degrades image quality: due to the uncoupled nature of excitation and detection in LSFM, the aberrations encountered in each arm are independent too and this can lead to a walk-off between the light-sheet and the detection FOV when large samples are imaged at depths. Adaptive optics\cite{Booth2007} provides a means to compensate for these aberrations and has recently been applied to improve LSFM\cite{Jorand2012,Wang2014}. The prospect of high quality images is especially essential for high through-put imaging methods like light-sheet microscopy and whole brain 3D reconstruction because the size of data sets are so large they warrant fully automated post processing for example for automated cell counting and identification\cite{Frasconi2014}. The effect of optical aberrations can severely obscure features even above the resolution limit and therefore hinder automated segmentation of the data. We have mounted the camera on a separate breadboard which leaves us with a lot of free infinity-corrected space in the detection path. In a future paper we aim to implement adaptive optics technology into the fluorescence emission path of our LSFM in order to demonstrate aberration corrected images for whole brain reconstructions. 

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

%%%%%%%%%%%%%%%%%%%%%%%%%%%%%%%%%%%%%%%%%%%%%%%%%%%%%%%%%%%%%
\acknowledgments
The authors are grateful to Riccardo Ballerini and Ahmed Hajeb from the mechanics workshop at LENS for the conception and fabrication of the sample chamber. We further thank Marco De Pas from the electronic workshop for his expertise in the fabrication of the custom-made amplification electronics. We thank GARR for the 10GB optical fibre connection to CINECA and  CINECA for hosting us on PICO. Human Brain Project tutta la vita and also Ludo's long sentence copy pasta.

\section*{Conflict of interest}
M.v.H has a financial interest in Murmex, Distrio, Amsterdam the Netherlands.

%%%%%%%%%%%%%%%%%%%%%%%%%%%%%%%%%%%%%%%%%%%%%%%%%%%%%%%%%%%%%
%%%%% References %%%%%

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

\bibitem{castagna1997object} G. Castagna, \emph{``Object-Oriented Programming A Unified Foundation,"} Birkh{\"a}user, Boston (1997).

\end{thebibliography}

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

%\listoftables
\pagebreak
\section{Supplementary information}

\subsection{Alignment}

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

\subsection{Methods}

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

\subsubsection{Sample preparation for whole brain imaging}

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

\subsection{Formulas}

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

		\end{tabular}
\end{table}

%\end{spacing}
\end{document}
