CarolineMuellenbroich/Giovanni-goes-Giorgio/Neurophotonics/Stuff/manuscript_Leo.tex

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

%%%%%%%%%%%%%%%%%%%%%%%%%%%%%%%%%%%%%%%%%%%%%%%%%%%%%%%%%%%%% 
\renewcommand{\cftdotsep}{\cftnodots}
\cftpagenumbersoff{figure}
\cftpagenumbersoff{table} 
\begin{document} 
\maketitle 

%%%%%%%%%%%%%%%%%%%%%%%%%%%%%%%%%%%%%%%%%%%%%%%%%%%%%%%%%%%%% 
\begin{abstract}
The comprehensive mapping and quantification of neuronal connections in the central nervous system requires high-throughput imaging of large volumes with microscopic resolution. We have developed a confocal light sheet microscope that has been optimised for the 3D imaging of structurally intact clarified whole-mount mouse brains. Here we describe the optical and electro-mechanical arrangement of the microscope and give details on the organisation of the microscope management software. The software orchestrates all components of the microscope, coordinates critical timing and synchronisation and has been written in a versatile and modular structure using the LabVIEW language.  It can easily be adapted and integrated to other microscope systems and has been made freely available to the light sheet community. The unprecedented amount of data routinely generated by light sheet microscopy further requires novel strategies for data handling and storage. To complete the full imaging pipeline of our high- throughput microscope we further elaborate on big data management from the data streaming of raw images up to stitching and visualisation of 3D data sets. The meso-scale neuroanatomy imaged at micron-scale resolution in those datasets allows characterization and quantification of neuronal connections in unsectioned mouse brains. 
\end{abstract}

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

%\begin{spacing}{2}   % use double spacing for rest of manuscript

%%%%%%%%%%%%%%%%%%%%%%%%%%%%%%%%%%%%%%%%%%%%%%%%%%%%%%%%%%%%%
\section{Introduction}%funnel shape
\label{sect:intro}  

The highly ambitious project of mapping and understanding each and every neuronal connection in the whole brain has been moved from the realm of wishful longing to feasible reality by the recent advent of light sheet fluorescent microscopy (LSFM). With this technique 3D data sets can be acquired with a resolution that is high enough to identify neurons and their dendritic, axonal and spine features in time scales which are no longer the bottle neck of high-throughput acquisition. In LSFM, the sample is illuminated with a thin sheet of light confined into the focal plane of the detection objective, which collects the fluorescence emission along an axis perpendicular to the illumination plane\cite{Huisken2009}. This technique drastically reduces the imaging acquisition time by recording millions of pixels in parallel and affords optical sectioning by operating fluorescence excitation and detection on separate perpendicularly oriented paths where the excitation light sheet and the detection focal plane overlap. Consequently fluorophores outside the light sheet are neither bleached nor contribute blurring out-of-focus noise. Hence LSFM reduces phototoxicity and photobleaching while achieving excellent resolution at high penetration depths.

Several challenges remain to be overcome, however, to allow fast and, most of all, systematic production of reliable datasets and their meaningful interpretation to further our understanding of neuronal networks. Those challenges include fast cheap and reproducible sample preparation and mounting, automated image acquisition that does not require constant attention by an expert and, most crucially, the storage, interpretation and analysis of the unprecedented huge data sets light sheet microscopy routinely produces. The mapping and understanding of this ``big data" is a colossal task that requires the expertise of computer scientists to employ fully automated post-processing, for example, to do cell counting or blood vessel segmentation. On the other hand, the imaging of large intrinsically opaque samples in light sheet microscopy necessitates clearing protocols based on refractive index matching which render the tissue transparent. This makes LSFM a truly interdisciplinary field in which the technological advances by optical developers need to be matched by novel development in the area of information and biotechnology.

Here we will present a state-of-the-art LSFM, as it is implemented in our lab, which is especially beneficial to acquire 3D data sets of large clarified and structurally intact mouse brains. The LSFM features double-sided illumination with a digitally scanned light sheet and a sample chamber which has been specifically designed for the the imaging of large ($> 1cm^3$) immersed and freely movable samples. After briefly introducing the optical setup we explain how to prepare and mount the samples for stable, 3D imaging for several days. In addition, a full description of the control hardware and software is presented. The microscope software coordinates every microscope component and ensures critical timing and synchronisation between those components. The software code has been implemented using a versatile and modular scheme in the LabVIEW language and has been made freely available to the light sheet community. We further give a systematic and robust approach to handle, store and analyse light sheet microscopy data of tens of terabytes. To conclude the comprehensive and high-throughput imaging pipeline we furthermore elaborate on stitching and visualisation of large 3D data sets. \textit{Include sentence about data if we show any.}

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

\section{Optical path}

		\begin{figure}
   \begin{center}
   \begin{tabular}{c}
   
   \end{tabular}
   \end{center}
   \caption{\label{fig:excitation} (A) Topview of the excitation path. The galvo scanners are mounted above periscopes. LP: long-pass filter, I: iris, AOTF: acousto-optical tunable filter, LM: laser modulator, PBS: polarisation beam splitter. Inset: detection path. (B) Oblique view of the microscope. A custom-made breadboard serves to mount the sample chamber and objectives at an elevated height and features two circular holes at the edges for the periscopes and a large central cut-out for the translation stages. A second breadboard is used for the camera.} 
   \end{figure}

\subsection{Laser unit}		
The custom-made confocal light sheet microscope is equipped with 5 linearly polarised cw lasers for fluorescence excitation (Fig. \ref{fig:excitation},A). The wavelengths were chosen to excite the most common fluorophores (see Table \ref{tab:optomechanics} for the manufacturer and specifications of opto-mechanical components). The laser light from each laser is first collimated and expanded with a telescope (f140, f200) and then combined into a common path with a beam steering mirror and a long-pass filter (Semrock, LaserMUX\texttrademark\ series). An acousto-optical tunable filter (AOTF) acts as fast ($\mu s$) electronically tunable filter which uses the acousto-optical interaction inside an anisotropic medium to select and transmit any combination of up to four of the laser lines. The radio-frequency applied on the AOTF transducer controls the wavelength being transmitted into the first order and the radio-frequency amplitude allows to adjust the transmitted light intensity. Due its nonlinear response we measured the AOTF light transmittance for each wavelength as a function of radio frequency amplitude and determined a look-up table to linearise the output. The zero order light is blocked by an iris. An electro-optical laser modulator (EOM) acts like a wave plate with electronically controlled retardation and rapidly rotates (few hundreds ns) the input polarisation of the excitation light by $90\degree$. The wavelength-dependent high voltage that needs to be applied to the birefringent crystal inside the modulator to change the optical path length is provided by a two-step amplification system. First, a low voltage analog signal from the data acquisition and generation (DAQ) board is pre-amplified with custom made electronics and then fed into a commercial high voltage amplifier. A digital line is used to switch the output of the pre-amplifier to zero, allowing control of the frequency with which the polarisation is changed (see also section \ref{sec:timing} on timing). After the laser modulator the excitation beam is further expanded by a factor of two with two achromatic doublets (f100, f200). 

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

Each scan mirror surface is re-imaged with a telescope (f50, f100) onto the back aperture of a long working distance low magnification objective (Nikon, 10x 0.3NA WD 17.5mm).  The galvos are in planes conjugate with the back focal plane of their respective excitation objective to ensure that a tilt angle of the galvo converts into a lateral translation of the Gaussian beam across the specimen. The two excitation objectives are designed for air immersion but are immersed into the clearing solution within the sample chamber. A coverslip glued to the front housing edge serves the dual purpose of maintaining the first diffractive surface between the front optical element and the air and to protect the front lens elements from the organic solvent. A guide to align objectives to a common focus can be found in the supplementary information. The light sheet is generated digitally\cite{Keller2008a,Keller2008b} by scanning the excitation beam across the focal plane of the detection objective. This generates incoherent illumination resulting in fewer artefacts. %cite{StelzerNatMeth2014}.
Additionally each line in specimen is illuminated with the same intensity creating a homogeneous light sheet which is particularly advantageous for the quantitative investigation of large samples in their entirety.

\subsection{Detection unit}
			
In its simplest form, the fluorescence detection unit of a light sheet microscope is a conventional wide-field microscope: an objective lens, a fluorescent filter and a tube lens form an image on a wide-field detector. We collect fluorescence with an objective that is specifically designed for immersion in clearing solutions. The objective is equipped with a correction collar allowing for immersion in media with refractive indices ranging from 1.41 to 1.52 (Olympus, XLSLPLN25XGMP, effective focal length 7.2 mm). To image the whole volume of interest the objective has a relatively low magnification of 25x and a large working distance of 8mm yet a high numerical aperture (1.0NA) affords high resolution imaging. A tube lens of 200mm creates the primary image on a sCMOS camera (Orca Flash4.0, Hamamatsu) with a chip of over 4 megapixels. In contrast to CCD sensors each pixel of a sCMOS camera sensor has a separate photodetector and amplification unit which means that sCMOS pixels can be read out independently from each other. The cell size of the OrcaFlash is $p^2= (6.5\micro m)^2$ over an active area of $r^2= (13.3mm)^2$. With a 200mm tube lens the field of view (FOV) in the sample is $480\micro m$ (see also Table \ref{tab:resolution} for relevant formulas). 

In the camera's rolling shutter data acquisition mode only a subset of adjacent horizontal pixel lines is simultaneously exposed and this active detection region is moved across the image sensor\cite{Baumgart2012}. With the delay between the exposure of two adjacent lines set to the minimum time required to read out a single line ($t_{\text{shutter}}=9.7\micro s$) the entire frame of 2048 horizontal lines is activated within 19.86ms. Setting the line exposure time to $t_{\text{exp}}=0.3ms$ results in approx. $l=\nicefrac{t_{\text{exp}}}{t_{\text{shutter}}}\approx31$  lines being simultaneously exposed at any time. This detection area is swept from the top to the bottom of the chip and acts like a moving, virtual confocal slit corresponding to a width of 

\begin{equation}
s_{\text{object}}=\frac{l p}{M_{\text{eff}}}= 7.2 \micro m 
\end{equation}

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

\begin{equation}
\nu = \frac{1}{(\#_{\text{horiz. lines}}*t_{\text{shutter}}+t_{\text{exp}})} \approx 50Hz. 
\end{equation}

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

We designed a cubic water-tight sample chamber (Fig. \ref{fig:frame2},A) that allows access from all six sides while maintaining the 3D integrity of large clarified and fluorescently-labelled mouse brains. The sample chamber is tightly bolted  to the optical breadboard while soft connections using silicone bellows allow for adjustive movements of the objectives and free 3D motion of the motor stages (Fig. \ref{fig:frame2},B). All connections are sealed with rubber rings and silicone caulk and additionally tightened with cable binders. In this way the objectives can be refocused and realigned without compromising the watertight seal of the chamber (Fig. \ref{fig:frame2},C). The clarified brains are imaged immersed in clearing solution composed of 63\% TDE in Phosphate buffered saline (PBS) and a refractive index of 1.45. To fill the entire volume of the sample chamber approximately 250ml clearing solution are needed. A motorized x-, y-, z-, $\theta$-stage (Physik Instrumente, see Table \ref{tab:optomechanics}) allows free 3D motion and rotation of a Teflon cylinder which reaches into the centre of the chamber (Fig. \ref{fig:frame2},D). Illumination and detection axes are horizontal while sample rotation occurs around the vertical axis.		
		
To elucidate neuronal projections and functional connections in structurally intact tissue it is paramount to be able to image centimeter-sized clarified samples, such as mouse brains, with high resolution in whole mount preparation. While promising clearing protocols are well documented in literature\cite{Chung2013,Tomer2014}, the question of sample preparation and mounting in light sheet microscopy is not trivial but requires novel approaches to such extent that it is becoming a separate field of research and very diverse strategies such as FEP tubes, 3D printed chambers and Quartz cuvettes have been reported\cite{Kaufmann2012,Pitrone2013,Olarte2012,Tomer2014}, however, these approaches are limited to much smaller sample volumes. The problem of sample mounting in a light sheet microscope arises form the fact that optical access to the sample is required from 3-4 planar sides leaving only two opposing sides to insert, fix and move the sample. Most commonly the vertical direction is chosen. Stable mounting is hereby a key concern as a whole brain tomography can require image acquisition in excess of 24 hours and the effects of gravity, tissue shrinking/expansion and evaporation of the clearing solution over such time spans might have to be considered. 

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

\subsection{Theoretical considerations}

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

\begin{equation}
w_0 = \frac{\lambda f_{\text{i}}^{\text{eff}}}{\pi w} \, ,
\end{equation}

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

\begin{equation}
\text{FWHM}_{\text{axial}} \simeq 1.177 w_0 \, .
\end{equation}

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

\subsection{Experimental characterisation}

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

\section{Microscope management software}

\subsection{General design principles}

The many components of the microscope (camera, lasers, AOTF, stages, etc.) are orchestrated and operated through a custom-made software. Since the microscope should work mainly without human intervention for many hours (a whole-brain tomography can last a couple of days) without losing precise synchronization, software design is not a secondary issue when building a light sheet microscope for whole-brain imaging. The overall architecture of the software and its practical implementation were chosen to satisfy several principles:

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

Our microscope management software has been written in LabVIEW (National Instruments, Austin, US), as this language is particularly well suited for hardware control and data acquisition through pre-developed methods. An object-oriented programming framework \cite{castagna1997object} has been used, dividing the entire project into well-defined self-contained modules. This framework, besides helping defining the proper scope of each software component, guarantees robustness, ease of maintenance, scalability and reusability. Code is stored on GitHub (www.github.org) to help multiple users developing software simultaneously. The graphical user interface (GUI) provides intuitive control of the apparatus as well as full personalisation. In general, the instrument parameters are already set to optimal values stored on disk, and on-line tips on how to set or change the various settings are provided. Both GUIs and code are developed according to the LabVIEW Style Guide \cite{LabviewStyle}.

\subsection{Murmex}

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

To let the software operate efficiently and synchronously on different machines, the \href{http://sine.ni.com/nips/cds/view/p/lang/en/nid/212895}{Murmex} software development kit was used. This kit integrates the object-oriented programming paradigm with a messaging system, and can be used to create communicating yet independent software modules within a standardized programming scheme.

Basically, Murmex creates distributed finite state machines. These are design patterns in which one component proceeds from one particular state to another based on the message it receives either from itself or from other components. For sending and receiving messages, Murmex uses the library \href{http://sine.ni.com/nips/cds/view/p/lang/en/nid/211065}{LabbitMQ}, which is a wrapper of \href{http://www.rabbitmq.com/}{RabbitMQ}, a message-oriented middleware facilitating message shipment and receival. These layers of abstraction are mostly hidden for the developers. The RabbitMQ server (message broker) needs to be installed either locally or somewhere in the network. The message-based communication allows for buffered, asynchronous and reliable message communication between several software components. Messages are routed by the broker to the specific software component by its ID. The LabbitMQ wrapper allows use of RabbitMQ inside the LabVIEW programming environment.

Murmex design pattern has twelve pre-defined common states (Initialise, Configure, Start, Stop, Proceed, Update, Reset, Inspect, Inform, Acknowledge, Fetch, Terminate) and a generic state for implementing custom states. Usually, just a few of this states are actually used in standard application. An example of a standard implementation of the Murmex state machine for the camera is shown in Fig. \ref{fig:murmex}. Each Murmex component streams information about its current status to its 'observers' which are other components specified in its configuration file. Using this oberserver/observee hierarchy, it is possible to design large and complex network of different components, running on any number of computers connected through a local connection or the Internet. A special component, named ServiceManager (also based on Murmex), which must be running on each computer, allows to start executables remotely in user-defined compositions of components. This allows the user to start up a sophisticated configuration with multiple components executed on different computers, but operated from one computer.

\subsection{System timing and software organization}
\label{sec:timing}

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

Each hardware component (AOTF, galvo scanners, electro-optical modulator, sample stages, camera, lasers) is managed through its own Murmex component. Since the galvo scanners and the electro-optical modulator are not addressed directly, but via analog and digital signals generated by the DAQ board, their software component just sends analog and digital waveforms to an additional intermediate component responsible for DAQ board management. Beyond hardware-related software, two additional Murmex components (named Stack and Tomo) orchestrate the operation of the entire system. 

The Stack component is used to acquire single image stacks along the detection axis, here the $z$ direction, and to this aim sends specific messages to coordinate the Camera and the Stages components. Stacks are collected by moving continuously the sample along $z$ while keeping the camera acquiring in free run. The translation speed is calculated such that in the time needed to collect a single frame the specimen has moved by a $z$ step specified in the GUI. The Camera component uses low-level libraries from Hamamatsu to save the data, producing one single \emph{.cxd} file (which is a proprietary tiff-like format from Hamamatsu) for each image stack. Note that the Camera component must write data to disk in perfect time, otherwise the nominal $z$ position is of each frame is no more coincident with the real $z$ position of the plane imaged. For this reason, we set the process executing the Camera code to be of highest priority. The Stack component checks the timing of data production, in order to re-acquire the image stack if the camera has been out-of-time. The Stack component also specify the name and the path of the \emph{.cxd} file.

The Tomo component is used to image the entire sample by collecting many adjacent, parallel, partially-overlapping stacks. To this aim it exchanges messages with the Stack and the Stages components. The user can specify the volume to be imaged either by inserting the minimum and maximum $x$, $y$ and $z$ coordinates of a parallelepiped, or by providing a text file with the list of stacks to be collected ($x$ and $y$ coordinates, starting and ending $z$s). The Tomo component also informs the experimenter about the state of the acquisition by sending an email when acquisition is finished or if any trouble is experienced.

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

\section{Data Management}

The volume of a mouse brain has been estimated from MRI measurements \cite{Kovacevic2005} as $\simeq 0.5$ $\text{cm}^3$; the same Authors find out that a parallelepiped encompassing the whole brain would have a volume of $\simeq 0.9$ $\text{cm}^3$. Given the pixel size of the camera and the magnification of the system, and assuming a $z$ step of 2 $\micro$m, the voxel size amounts to $0.234\times0.234\times2$ $\micro\text{m}^3$. This means that a mouse brain will be represented with about 4.6 TeraVoxels, while a parallelepiped encompassing the brain will result in 8.2 TeraVoxels. Since the camera produces 16 bit images with no compression, each raw voxel occupies 2 bytes of disk space, resulting in 8.3 TB for the whole brain "alone" and 14.8 TB for the parallelepiped (see Table \ref{tab:dataproduction}). However, image stacks are acquired with a 10\% of linear superposition, which is later used for image stitching. This redundancy expands the size of raw data to 10.2 TB and 18.3 TB, respectively.

This unprecedented amount of data challenges the traditional way we interact with our data. Having far passed the point of taking your data home with you on a hard drive at the end of the experiment, data management in light sheet microscopy requires the development of a robust data management infrastructure, and of novel software tools to process the images in order to extract meaningful information.

\subsection{Data handling and storage}

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

While transferring the data from the SSD to the NAS, we also perform a file conversion from the proprietary Hamamatsu format to a more manageable one. We chose the TIFF format among the others because it permits to store 3D image with lossless compression in a single file. Furthermore, it is a flexible and platform-independent format supported by numerous image processing applications. We thus developed a conversion module that leverages the functionalities offered by the interface of the DCIMGAPI library, supplied by Hamamatsu, and the freely available LibTIFF library. The module reads a single .cxd 3D image and writes it in a variable number of multi-page TIFF files, depending on the user-defined limit of pages per file. Since the output of the Hamamatsu camera may exceed tens of GB, the image in proprietary format is read slice by slice to minimize memory requirements. The module has also an option to downsample the image or save the input image at full or reduced resolution, in order to adapt to storage availability. Usually we downsample the image in the XY plane by a factor 2 and leave the Z sampling unaltered. This kind of downsampling, in combination with the lossless compression offered by the TIFF format, reduces data size by about one order of magnitude. Thus the parallelepiped volume containing the whole mouse brain can be represented using about 2-3 TB of disk space. 

The process executing the file conversion code is set to low execution priority to prevent interference with the Camera component, which needs to be perfectly timed with acquisition. Thus, although file conversion drastically reduces data size, in the current implementation it is quite slower than data production. The Camera component flushes data on the SSD with a rate $R_{\text{data}}$ dependent on the frame rate $R_{\text{frame}}$ and on the image size:
\begin{equation}
R_{\text{data}} [\text{Bytes}] = 2\cdot R_{\text{frame}} \cdot \#_{\text{pixels}}\,,
\end{equation}
where the factor of two takes into account the 16 bit grey depth of images. The volumetric imaging rate is given by $R_{\text{volume}} = 0.5 R_{\text{data}} \cdot \text{Voxel size}$.

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

\subsection{Stitching and visualisation}
	
Given the limited field of view of the microscope, the acquisition of macroscopic specimens required many parallel image stacks to cover all the volume. Thus, in order to achieve a 3D image of the whole specimen from raw data, the Terastitcher\cite{Bria2012} has been recently proposed, i.e. a stitching tool capable to deal with teravoxel-sized images. However, the Terastitcher does not support input data acquired through the serial sectioning procedure, which leads to a specimen partitioned in different layers. Furthermore, only single channel images can be processed. For these reasons, we extended the Terastitcher functionalities introducing the two following additional features: i) stitching of a specimen partitioned in a number of overlapping layers for the hippocampus reconstruction and, ii) coping with images containing more than one channel for the human brain tomography.
With respect to the first requirement, that is allowing a complete reconstruction of a multi-layered raw data, we schematically depict in Fig.1 the adopted strategy. First of all, the various input layers, each of which is composed of several parallel overlapping stacks, are separately stitched by using the existing Terastitcher tool. After this preliminary step,  leveraging the layer coordinates provided by the instrument, we import the processed layers as a new volume where each layer has a partial overlap with adjacent layers.  Furthermore, each layer is organized in a non-overlapping tiled format, enabling the application of a multi MIP-NCC approach\cite{Bria2012}, which computes the displacement  between two adjacent layers along all of the three directions (Fig. 1). When a displacement computation for each pair of adjacent layers has been computed, the overlapping regions are merged through a blending procedure which smooths the transition between layers, resembling once more the procedure used by Terastitcher for combining adjacent stacks. Finally, we note that due to the repositioning of each layer, the volume containing the reconstructed specimen might contain empty regions, which are thereby filled with black voxels. 
Turning our attention to the second additional feature, that is handling multi-channel images, the Terastitcher has been extended so that the MIP-NCC algorithm used for displacement computation can work on an image, which can be either 
the fusion of the input channels or one of the input channels. This permits to privilege the channel with more information content over the other channels as well as discard noisy channels. Note that the reconstructed 3D image can be produced with the same channel composition of raw data.

\section{Data}

	%\begin{figure}
   %\begin{center}
   %\begin{tabular}{c}
   %\includegraphics[height=16cm]{LSMdata.eps}
   %\end{tabular}
   %\end{center}
   %\caption{\label{fig:LSMdata} Whole mouse brain tomography. Imaging of whole transgenic mouse brains treated with CLARITY and cleared with TDE 63\% imaged with LSM (Olympus, 25X objective). (A) 3D rendering of a parvalbumin-dTomato brain. (B) 3D rendering of stacks from PV-dTomato mouse brain, GAD-dTomato mouse brain,  PI stained mouse brain, FITC-albumin labeled mouse brain, scale bar = 400 µm. (C,D,E,F) High resolution insert, of the stack corresponding to red boxes in C. Scale bar = 100 µm.} 
   %\end{figure}
	%
	%Everybody take a look at Fig. \ref{fig:LSMdata} because it is the best we have. 

\section{Conclusion}

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

		\end{tabular}
\end{table}

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

%%%%%%%%%%%%%%%%%%%%%%%%%%%%%%%%%%%%%%%%%%%%%%%%%%%%%%%%%%%%%
%%%%% References %%%%%

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

\bibitem{castagna1997object} G. Castagna, \emph{``Object-Oriented Programming A Unified Foundation,"} Birkh{\"a}user, Boston (1997).

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

\end{thebibliography}

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

%\listoftables

\section{Supplementary information}

\subsection{Alignment}

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

\subsection{Methods}

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

%\end{spacing}
\end{document}
