CarolineMuellenbroich/Giovanni-goes-Giorgio/Neurophotonics/Stuff/manuscript_merged_Ludo.tex

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

\title{Comprehensive optical and data management infrastructure for high through-put light sheet microscopy of whole mouse brains} 

\author{M. Caroline M\"{u}llenbroich,\supscr{a,b} Ludovico Silvestri, \supscr{a,c} Leonardo Onofri,\supscr{e} Irene Costantini,\supscr{a} Marcel van 't Hoff,\supscr{a,b,f} Leonardo Sacconi,\supscr{a,c} Giulio Iannello,\supscr{e} Francesco S. Pavone,\supscr{a,b,c,d}  }

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

%%%%%%%%%%%%%%%%%%%%%%%%%%%%%%%%%%%%%%%%%%%%%%%%%%%%%%%%%%%%% 
\renewcommand{\cftdotsep}{\cftnodots}
\cftpagenumbersoff{figure}
\cftpagenumbersoff{table} 
\begin{document} 
\maketitle 

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

%\begin{spacing}{2}   % use double spacing for rest of manuscript

%%%%%%%%%%%%%%%%%%%%%%%%%%%%%%%%%%%%%%%%%%%%%%%%%%%%%%%%%%%%%
\section{Introduction}%funnel shape
\label{sect:intro}  

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

\section{Optical path}

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

\subsection{Laser unit}		
The custom-made, confocal light sheet microscope is equipped with 5 linearly polarised, cw lasers for fluorescence excitation (Figure\ref{fig:excitation},A). The wavelengths were chosen to excite the most common fluorophores (see Table\ref{tab:optomechanics} for the manufacturer and specifications of opto-mechanical components). The laser light from each laser is first collimated and expanded with a telescope (f140, f200) and then combined into a common path with a beam steering mirror and a long-pass filter (Semrock, LaserMUX\texttrademark\ series). An acousto-optical tunable filter (AOTF) acts as fast ($\mu s$) electronically tunable filter which uses the acousto-optical interaction inside an anisotropic medium to select and transmit any combination of up to four of the laser lines. The radio-frequency applied on the AOTF transducer controls the wavelength being transmitted into the first order and the radio-frequency amplitude allows to adjust the transmitted light intensity. Due its nonlinear response we measured the AOTF light transmittance for each wavelength as a function of radio frequency amplitude and determined a look-up table to linearise the output. The zero order light is blocked by an iris. An electro-optical laser modulator (EOM) acts like a wave plate with electronically controlled retardation and rapidly rotates (few hundreds ns) the input polarisation of the excitation light by $90\degree$. The wavelength-dependent, high voltage that needs to be applied to the birefringent crystal inside the modulator to change the optical path length is provided by a two-step amplification system. First, a low voltage, analog signal from the DAQ board is pre-amplified with custom made electronics and then fed into a commercial high voltage amplifier. A digital line is used to switch to zero the output of the pre-amplifier, allowing control of the frequency with which the polarisation is changed. After the laser modulator the excitation beam is further expanded by a factor of two with two achromatic doublets (f100, f200). 

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

The scan mirror surface is re-imaged with a telescope (f50, f100) onto the back aperture of a long working distance, low magnification objective (Nikon, 10x 0.3NA WD 17.5mm). The two excitation objectives are designed for air immersion but are immersed into the clearing solution within the sample chamber. A coverslip glued to the front housing edge serves the dual purpose of maintaining the first diffractive surface between the front optical element and the air and to protect the front lens elements from the organic solvent. The light sheet is generated digitally\cite{Keller2008a,Keller2008b} by scanning the excitation beam across the focal plane of the detection objective. This generates incoherent illumination resulting in fewer artefacts.%cite{StelzerNatMeth2014}.
Additionally each line is specimen is illuminated with the same intensity creating a homogeneous light sheet which is particularly advantageous for the quantitative investigation of large samples in their entirety.

\subsection{Detection unit}
			
In it's simplest form, the fluorescence detection unit of a light sheet microscope is a conventional wide-field microscope: an objective lens, a fluorescent filter and a tube lens for an image on a wide-field detector. Fluorescence is collected with an objective that is specifically designed for immersion in clearing solutions. The objective is equipped with a correction collar allowing for immersion in media with refractive indices ranging from 1.41 to 1.52 (Olympus, XLSLPLN25XGMP, effective focal length 7.2 mm). To image the whole volume of interest the objective has a relatively low magnification of 25x and a large working distance of 8mm yet a high numerical aperture (1.0NA) affords high resolution imaging. A tube lens of 200mm creates the primary image on a sCMOS camera (Orca Flash4.0, Hamamatsu) with a chip of over 4 megapixels. In contrast to CCD sensors each pixel of a sCMOS camera sensor has a separate photodetector and amplification unit which means that sCMOS pixels can be read out independently from each other. The cell size of the OrcaFlash is $p^2= 6.5\micro m$ x $6.5\micro m$ over an active area of 13.3mm. With a 200mm tube lens the field of view in the sample is $480\micro m$. 

In the rolling shutter data acquisition mode only a subset of adjacent horizontal pixel lines is simultaneously exposed and this active detection region is moved across the image sensor. With the delay between the exposure of two adjacent lines set to the minimum time required to read out a single line ($t=9.7\micro s$, see Table\ref{tab:resolution}) the entire frame of 2048 horizontal lines is activated within 19.86ms. Setting the line exposure time to $l=3ms$ results in approx. $k=\nicefrac{l}{t}\approx300$  lines being simultaneously exposed at any time. This detection area is swept from the top to the bottom of the chip and acts like a moving, virtual confocal slit corresponding to a width of $d_s=\nicefrac{k p}{M_{\text{eff}}}= 0.72m$ in the sample space. With the given values of line exposure and line read out time, the camera acquires images at a frame rate of $\nu = \nicefrac{1}{(2048t+l)} \approx 44Hz$. 

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

\section{Sample mounting and motion}
%Biological tissue is, bar of very few exemptions like the cornea or zebrafish larvae, highly scattering. Scattering is the deflection of light rays due to the heterogeneous mixture of cells and sub-cellular structures with varying refractive indices. Rayleigh scattering, the nearly isotropic and strongly wavelength dependent scattering of light by particles much smaller than the wavelength of light, and Mie scattering, which occurs on cellular structures such as organelles and other refractive structures which are larger than the wavelength of light, far outweigh absorption and cause most biological tissues to be opaque. In the visible spectrum, the scattering of fluorescence photons is dominant over ballistic fluorescence such that for the imaging of large samples optical clearing methods based on refractive index matching have been employed. These methods involve several chemical sample preparation steps to generate transparent yet structurally and anatomically intact tissue.
%
%A successful optical clearing method not only renders the tissue transparent but also causes neither quenching of protein fluorescence nor tissue distortion and is compatible with repetitive immunostaining. A very promising method called CLARITY\cite{Chung2013,Tomer2014} transforms tissue into a nanoporous, hydrogel-hybridized, lipid-free form. Crucially for high through-put clearing and imaging of large samples, the protocol, however, is ideally also fast, easy and cheap. Our lab therefore development a versatile, simple, rapid and inexpensive clearing method based on a water-soluble agent, 2,2'-thiodiethanol (TDE) which in combination with CLARITY allows for the optical clearing of entire mouse brains or human biopsies. With this protocol (see [cite Irene] for a detailed description) a mouse brain (Figure\ref{fig:Panel1},B) takes 1 month to clear at a costs of \$XY.
		
\begin{figure}
   \begin{center}
   \begin{tabular}{c}
   
   \end{tabular}
   \end{center}
   \caption{\label{fig:frame2} Schematic of light sheet microscopy. (A) Fluorescence excitation (along x axis) and detection (along z axis) are operated on independent, perpendicular light paths where the excitation light sheet and the detection focal plane overlap. (B) The custom-made sample chamber is assembled with silicone bellows and seal rings. The clarified, fluorescently-labelled brain is mounted on a Teflon cylinder in the centre of the watertight chamber (C) and can be translated and rotated freely with piezo motors (D). (E) Mounting of a clarified, fluorescently labelled brain. The brain is glued onto a coverslip and inserted into an adapter that slides into the Teflon cylinder.} 
   \end{figure}		
		
To elucidate neuronal projections and functional connections in structurally intact tissue it is paramount to be able to image centimeter-sized, clarified samples, such as mouse brains, with high resolution in whole mount preparation. While promising clearing protocols are well documented in literature\cite{Chung2013,Tomer2014}, the question of sample preparation and mounting in light sheet microscopy is not trivial but requires novel approaches to such extent that it is becoming a separate field of research and very diverse strategies such as FEP tubes, 3D printed chambers and Quartz cuvettes have been reported\cite{Kaufmann2012,Pitrone2013,Olarte2012,Tomer2014}, however, these approaches are limited to much smaller sample volumes. The problem of sample mounting in a light sheet microscope arises form the fact that optical access to the sample is required from 3-4 planar sides leaving only two opposing sides to insert, fix and move the sample. Most commonly the vertical direction is chosen. Stable mounting is hereby a key concern as a whole brain tomography can require image acquisition in excess of 24 hours and the effects of gravity, tissue shrinking/expansion and evaporation of the clearing solution over such time spans might have to be considered. 

For the acquisition of whole brain data sets, we fix a clarified and fluorescently-labelled mouse brain with super glue to a coverslip (Figure\ref{fig:frame2},D). The brain is oriented along its axial orientation with the olfactory bulbs at the top and the cerebellum at the bottom of the coverslip. The coverslip is slid into a bottom adaptor and tightened with a plastic-capped grub screw. The bottom adaptor is inserted into a Teflon cylinder with the coverslip being positioned on the far side of the detection objective. Three different slits in the adapter correspond to varying distances to the detection objective and give variability in sample thickness for example to allow also for the mounting of rat brain hemispheres.
	
We designed a cubic, water-tight sample chamber (Figure\ref{fig:frame2},A) that allows access from all six sides while maintaining the 3D integrity of large, clarified and fluorescently-labelled mouse brains. The sample chamber is tightly bolted  to the optical breadboard while soft connections using silicone bellows allow for adjustive movements of the objectives and free 3D motion of the motor stages (Figure\ref{fig:frame2},B). All connections are sealed with rubber rings and silicone caulk and additionally tightened with cable binders. In this way the objectives can be refocused and realigned without compromising the watertight seal of the chamber (Figure\ref{fig:frame2},C). The clarified brains are imaged immersed in clearing solution composed of 63\% TDE in Phosphate buffered saline (PBS) and a refractive index of 1.45. To fill the entire volume of the sample chamber approximately 400ml clearing solution are needed. A motorized x-, y-, z-, $\theta$-stage (Physik Instrumente, see Table\ref{tab:optomechanics}) allows free 3D motion and rotation of the Teflon cylinder which reaches into the centre of the chamber (Figure\ref{fig:frame2},D). Illumination and detection axes are horizontal and the sampler rotation occurs around the vertical axis.		

\section{Optical characterisation}

The optical properties of a microscope can be summarized by the point-spread function (PSF), which is the image of a point source in object space. In particular, the radial (i.e. perpendicular to the detection axis) and axial (i.e. parallel to the detection axis) resolutions of the microscope can be quantified with the full width at half-maximum (FWHM) of the PSF itself along the chosen direction. In a light sheet microscope, axial and radial resolutions are determined by the NA of the illumination and detection optics, respectively. The radial PSF is a standard Airy function, whose FWHM is given by:
\begin{equation}
\text{FWHM}_{\text{radial}} \simeq \frac{0.51 \lambda_0}{\text{NA}_{\text{d}}} \, ,
\end{equation}
$\lambda_0$ being the wavelength in vacuum and $\text{NA}_{\text{d}}$ the NA of the detection objective. 

The axial resolution is given by the thickness of the light sheet. If Gaussian beams are used for illumination, the thickness of the light sheet can be calculated by the well-known formulas of Gaussian optics \cite{something}. The $1/e^2$ radius of the beam waist is given by:
\begin{equation}
w_0 = \frac{\lambda f_{\text{i}}^{\text{eff}}}{\pi w} \, ,
\end{equation}
where $w$ is the $1/e^2$ radius of the beam entering the illumination objective, $ f_{\text{i}}^{\text{eff}}$ is the effective focal length of the illumination optics and $\lambda$ is the wavelength in the medium ($\lambda = \lambda_0 / n$, $n$ being the refractive index). Note that, for air objectives (as the one we use for illumination) the effective focal length is extended by a factor $n$ when used inside a medium with refractive index different from 1 \cite{Silvestri2012}.
The axial FWHM is then given by:
\begin{equation}
\text{FWHM}_{\text{axial}} \simeq 1.177 w_0 \, .
\end{equation}

The thickness of the light sheet is not constant throughout the field of view due to the limited depth of focus of the Gaussian beam. This latter can be quantified by the confocal parameter $b$, which is the distance along which the beam $1/e^2$ radius is not bigger than $\sqrt{2} w_0$:
\begin{equation}
b = \frac{2\pi w_0^2}{\lambda} = \frac{2 \lambda  {(f_{\text{i}}^{\text{eff}})}^2}{\pi w^2}\, .
\end{equation}

The need to have an almost uniform resolution in the camera field of view (FOV) imposes a lower bound to $b$ and thus (according to the previous equations) a limit to the axial resolution. In our setup we adjusted the telescopes in the excitation path in order to have $w \simeq ???$, resulting in $b \simeq ???$ and $\text{FWHM}_{\text{axial}} \simeq?????$. 

An overview of the relevant formulas for the optical properties of a light sheet microscope is given in Table\ref{tab:resolution}. The reader could refer to this table as a quick guide to tailor the apparatus to her specific needs.

AND HERE THE AMMAZING OURS DATAS

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

\section{Microscope management software}

	\begin{figure}
   \begin{center}
   \begin{tabular}{c}
   
   \end{tabular}
   \end{center}
   \caption{\label{fig:connectivity} Schematic view of the hardware architecture of the microscope. Different kind of physical connections are depicted with different colors.} 
   \end{figure}

\subsection{General design principles}

The many components of the microscope (camera, lasers, AOTF, stages, etc.) are orchestrated together and operated through a custom-made software. Since the microscope should work mainly without human intervention for many hours (a whole-brain tomography can last a couple of days) without losing proper synchronization, software design is not a secondary issue when building a light sheet microscope for whole-brain imaging. The overall architecture of the software and its practical implementation were chosen to satisfy several principles:

\begin{itemize}
\item{\emph{User-friendliness}. The light sheet microscope here presented was designed and developed by optical technology specialists yet needs to be operational in a multi-user environment. The greatest challenge therefore consists in making the use of the microscope easy and intuitive such that no formidable expertise is needed when it is operated by researchers with no expertise in optics and/or software development.}
\item{\emph{Working in a distributed environment}. The apparatus should deal with many independent hardware components, and with several data streams (see below). Individual processing steps and/or data transfer can be computationally intensive, and may need to be distributed over several computers to perform properly at run-time.}
\item{\emph{Robustness and ease of maintenance}. Any kind of hardware problem, from timing delay to real failure, must be automatically handled to avoid loss of precious data. Furthermore, developers must be able to fix existing code or to develop new one without having to change the whole software.}
\item{\emph{Reusability and scalability}. When a second or third microscope with basic similarity yet slightly specialised equipment is being designed in the same or in other laboratories, re-writing all the code from scratch is pure loss of time. Writing well structured, scalable and easily maintainable scientific software can help avoiding redundancy and boosting up productivity.}
\end{itemize}

Our microscope management software has been written in LabVIEW (National Instruments, Austin, US), as this language is particularly well suited for hardware control and data acquisition through pre-developed methods. An object-oriented programming framework \cite{castagna1997object} has been used, dividing the entire project into well-defined self-contained modules. This framework, besides helping defining the proper scope of each software component, guarantees robustness, ease of maintenance, scalability and reusability. Code is stored on GitHub (www.github.org) to help multiple users developing software simultaneously. The graphical user interface (GUI) provides intuitive control of the apparatus as well as deep personalization. In general, the intrument parameters are already set to optimal values stored on disk, and on-line tips on how to set or change the various settings are provided. Both GUIs and code are developed according to the LabVIEW Style Guide \cite{LabviewStyle}.

\subsection{Murmex}

	\begin{figure}
   \begin{center}
   \begin{tabular}{c}
   
   \end{tabular}
   \end{center}
   \caption{\label{fig:murmex} Schematic view of the workflow of a representative Murmex component operating a camera.} 
   \end{figure}

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

Basically, Murmex creates distributed finite state machines. These are design patterns in which one component proceed from one particular state to another based on the message it receives either from itself or from other components. For sending and receiving messages, Murmex uses the library \href{http://sine.ni.com/nips/cds/view/p/lang/en/nid/211065}{LabbitMQ}, which is a wrapper of \href{http://www.rabbitmq.com/}{RabbitMQ}, a message-oriented middleware facilitating message shipment and receival. These layers of abstraction are mostly hidden for the developers. The RabbitMQ server (message broker) needs to be installed either locally or somewhere in the network. The message-based communication allows for buffered, asynchronous and reliable message communication between several software components. Messages are routed by the broker to the specific software component by its ID. The LabbitMQ wrapper allows use of RabbitMQ inside the LabVIEW programming environment.

Murmex design pattern has twelve pre-defined common states (Initialise, Configure, Start, Stop, Proceed, Update, Reset, Inspect, Inform, Acknowledge, Fetch, Terminate) and a generic state for implementing custom states. Usually, just a few of this states are actually used in standard application. An example of a standard implementation of the Murmex state machine for a scanning system is shown in Fig. \ref{fig:murmex}. Each Murmex component streams information about its current status to its 'observers', other components specified in its configuration file. Using this oberserver/observee hierarchy, it is possible to design large and complex network of different components, running on whatsoever number of computers connected through a local connection or the Internet. A special component, named ServiceManager (also based on Murmex), which must be running on each computer, can start executables remotely. This allows the user to start up a sophisticated configuration with multiple components executed on different computers, but steered from one computer.

\subsection{System timing and software organization}

A schematic overview of the hardware architecture of our light sheet microscope is shown in Fig. \ref{fig:connectivity}. One personal computer (Precision T5600, Dell, Round Rock, USA) controls all the remote hardware components with the exception of the camera, which is controlled by a second, dedicated computer (Precision T7500, Dell, Round Rock, USA) to handle and manage the enormous streams of data produced (see next section). Various instrumentations are addressed either through computer ports (as USB, RS232 and CameraLink) or via analog and/or digital signals generated by a DAQ board (NI PCIe-6353, National Instruments, Austin, USA).

Synchronization of the camera rolling shutter to the scanning of the light sheet is achieved by letting the camera acquiring in free-run mode, and using a trigger output from the camera itself to time the generation of the waveforms sent to the galvo drivers. In particular, the HSYNC signal from the camera is used, providing a true-type-logic (TTL) pulse everytime the rolling shutter steps from one line to the next one. This trigger signal is used as a clock by the DAQ board, so that the line producing the light sheet moves step by step with the rolling shutter. The same HSYNC signal is used to trigger the DAQ digital signal sent to the electro-optic laser modulator. In this case, since at each position of the scanning line the modulator should go trough at least two states (vertical polarization and horizontal polarization), HSYNC is used as a trigger while the clock used is the (much faster) internal clock of the DAQ board.

Each hardware component (AOTF, galvo scanners, electro-optical modulator, sample stages, camera, lasers) is managed through its own Murmex component. Since the galvo scanners and the electro-optical modulator are not addressed directly, but via analog and digital signals generated by the DAQ board, their software component just send analog and digital waveforms to an additional intermediate component responsible for DAQ board management. Beyond hardware-related software, two additional Murmex components (named Stack and Tomo) orchestrate the operation of the entire system. 

The stack component is used to acquire single image stacks along the $z$ direction, and to this aim send specific messages to coordinate the Camera and the Stages components. Stacks are collected by moving continuously the sample along $z$ while keeping the camera acquiring in free run. The translation speed is such that in the time needed to collect a single frame the specimen has moved by a $z$ step specified in the GUI. The Camera component uses low-level libraries from Hamamatsu to save the data, producing one single \emph{.cxd} file (which is a proprietary tiff-like format from Hamamatsu) for each image stack. Note that the Camera component must write data to disk in perfect time, otherwise the nominal $z$ position is of each frame is no more coincident with the real $z$ position of the plane imaged. For this reason, we set the process executing the Camera code to be of highest priority. The Stack component checks the timing of data production, in order to re-acquire the image stack if the camera has been out-of-time. The Stack component also specify the name and the path of the \emph{.cxd} file.

The tomo component is used to image the entire sample by collecting many adjacent, parallel, partially-overlapping stacks. To this aim it exchanges messages with the Stack and the Stages components. The user can specify the volume to be imaged either by inserting the maximum $x$, $y$ and $z$ coordinates of a parallelepiped, or by providing a text file with the list of stacks to be collected ($x$ and $y$ coordinates, starting and ending $z$s). The Tomo component also inform the experimenter about the state of the acquisition by sending an email when it's finished or if any trouble is experienced.

All the software described here can be freely downloaded from \href{https://github.com/marcelvanthoff/Giorgio}{GitHub}. Beacuse of its modular structure and of the extensive documentation, it can be easily integrated and adapted in other microscopy systems.

\section{Data Management}

The volume of a mouse brain have been estimated from MRI measurements \cite{Kovacevic2005} as $\simeq 0.5$ $\text{cm}^3$; the same Authors find out that a parallelepiped encompassing the whole brain would have a volume of $\simeq 0.9$ $\text{cm}^3$. Given the pixel size of the camera and the magnification of the system, and assuming a $z$ step of 2 $\micro$m, the voxel size results $0.234\times0.234\times2$ $\micro\text{m}^3$. This means that a mouse brain will be represented with about 4.6 TeraVoxels, while a parallelepiped encompassing the brain will result in 8.2 TeraVoxels. Since the camera produces 16 bit images with no compression, each raw voxel occupies 2 bytes of disk space, resulting in 8.3 TB for the whole brain "alone" and 14.8 TB for the parallelepiped (see Table \ref{tab:dataproduction}). However, image stacks are acquired with a 10\% of linear superposition, which is used later for image stitching. This redundancy expands the size of raw data to 10.2 TB and 18.3 TB, respectively.

This unprecedented amount of data challenges to the traditional way we interact with our data. Having far passed the point of taking your data home with you on a hard drive at the end of the experiment, data management in light sheet microscopy requires the development of a robust data management infrastructure, and of novel software tools to process the images in order to extract meaningful information.

\subsection{Data handling and storage}

The camera used in our light sheet microscope (Hamamatsu Orca Flash 4.0 v2) flushes the datastream directly to a dedicated workstation with 12 solid-state drives (SSD) operating in RAID 0 configuration, resulting in a virtual drive of 10.9 TB. Although this is already a large and expensive system for the current SSD technology, it is way smaller than the size of the raw datasets produced in each tomography. We thus connected the workstation to a larger network area storage (NAS) via a 10 Gbit/s network copper cable. The NAS operates in a safer data modality (RAID 5) with 32.4 TB of useful disk space. The NAS is then connected by a dedicated 10 Gbit/s link provided by the Consortium GARR (the Public Institution managing research networks in Italy) to CINECA (the main italian supercomputing center). The data flow scheme is summarized in Figure \ref{fig:DataFlow}.

While transferring the data from the SSD to the NAS, we also perform a file conversion from the proprietary Hamamatsu format to a more manageable one. We chose the TIFF format among the others because it permits to store 3D image with lossless compression in a single file. Furthermore, it is a flexible and platform-independent format supported by numerous image processing applications. We thus developed a conversion module that leverages the functionalities offered by the interface of the DCIMGAPI library, supplied by Hamamatsu, and the freely available LibTIFF library. The module reads a single .cxd 3D image and writes it in a variable number of multi-page TIFF files, depending on the user-defined limit of pages per file. Since the output of the Hamamatsu camera may exceed tens of GB, the image in proprietary format is read slice by slice to minimize memory requirements. The module has also an option to downsample the image on save the input image at full or reduced resolution, in order to adapt to storage availability. Usually we downsample the image in the XY plane by a factor 2 and leave the Z sampling as usual. This kind of downsampling, in combination with the lossless compression offered by the TIFF format, reduces data size by about one order of magnitude. Thus the parallelepid volume cointaining the whole mouse brain can be represented using about 2-3 TB of disk space. 

The process executing the file conversion code is set to low execution priority to prevent interference with the Camera component, which needs to be perfectly timed with acquisition. Thus, although file conversion drastically reduces data size, in the current implementation it is quite slower than data production. The Camera component flushes data on the SSD with a rate $R_{\text{data}}$ dependent on frame rate $R_{\text{frame}}$ and on the image size:
\begin{equation}
R_{\text{data}} [\text{Bytes}] = 2\cdot R_{\text{frame}} \cdot \#_{\text{pixels}}\,,
\end{equation}
where the factor takes into account the 16 bit grey depth of images. The volumetric imaging rate is given by $R_{\text{volume}} = 0.5 R_{\text{data}} \cdot \text{Voxel size}$.

With a standard image size of $2048\times 2048$ pixels, and $R_{\text{frame}}=44$ Hz, data are produced at a rate $R_{\text{data}}=352$ MB/s $\approx 1.2$ TB/h, which results in a volumetric rate $R_{\text{volume}} \approx 2\times 10^7$ $\micro\text{m}^3/s$ $\approx 0.07$ $\text{cm}^3$/h. The conversion module can empty the SSD wih an average rate of about 0.7 TB/h, meaning that the SSD is actually filled up during imaging at a rate of about 0.5 TB/h. Imaging sessions should thus be shorter than 21.8 hours: this limits the maximum amount of raw data being acquired continuously to approximately 25.4 TB. This is well above the disk space needed to image the parallelepieped volume encompassing a whole mouse brain. Larger specimens, as rat brain or portion of human brain, must be imaged in consecutive session until faster strategies for image conversion are devised.

	\begin{figure}
   \begin{center}
   \begin{tabular}{c}
   
   \end{tabular}
   \end{center}
   \caption{\label{fig:DataFlow} Scheme of the data flow. (A) Data streaming on the microscope. SSD: solid-state disk, RAID: redundant array of independent disks, NAS: network-attached storage. Different colors (red, yellow and green) indicate the time-sensitivity (higher to lower) of each data movement. (B) Data production rate versus data conversion rate showing the maximum acquisition time and tomography size feasible before the SSD are filled up.} 
   \end{figure}

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

\section{Data}

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

\begin{table}[t!]
	\centering
		\caption[Main formulas]{Overview of the main formulas related to light sheet microscopy. In the table, $f_{\text{TL}}^{\text{design}}$ is the focal length of the tube lens for which the objective has been designed (200 mm for Leica and Nikon, 180 mm for Olympus and 165 mm for Zeiss), $f_{\text{TL}}^{\text{real}}$ the focal length of the tube lens actually used, $\text{M}$ the nominal magnification of the objective, $n$ the refractive index of the immersion medium, $\lambda_0$ the wavelength in vacuum, $\lambda$ the wavelength in the medium, $w$ the $1/e^2$ radius of the Gaussian beam at the objective back focal plane, FN the field number of the objective, $p$ the physical pixel size, $l_{\text{chip}}$ the size of the camera chip, $t_{\text{shutter}}$ the pace of the rolling shutter (i.e. the time between exposure start in subsequent lines), $ t_{\text{exp}}$ the line exposure time. The subscripts $_i$ and $_d$ refers to illumination and detection, respectively. \label{tab:resolution}}
		\begin{tabular}{lrcl}
		\\
		\multicolumn{4}{l}{General formulas for microscope objectives}\\\hline\hline 
		Nominal focal length				& $f$ 							& $=$	& $f_{\text{TL}}^{\text{design}}/\text{M}$				\\	
		Effective focal length				& $f^{\text{eff}}$				& $=$	& $nf$													\\
		Effective magnification			& $\text{M}^{\text{eff}}$		& $=$	& $f_{\text{TL}}^{\text{real}}/f^{\text{eff}}$			\\\\
		\multicolumn{4}{l}{Excitation (Gaussian)}\\\hline\hline
		Beam waist						&$w_0$							& $=$ 	& $ \lambda f_{\text{i}}^{\text{eff}} / \pi w$				\\
		Axial resolution					&$\text{FWHM}_{\text{axial}}$	& $=$   & $1.177 w_0 $											\\
		Confocal parameter				& b								& $=$   & $2 \pi \omega_0^2 / \lambda$							\\
										& b								& $=$   & $2 \lambda {(f_{\text{i}}^{\text{eff}})}^2 / \pi w^2 $	\\\\
		\multicolumn{4}{l}{Detection}\\\hline\hline  
		Radial resolution					&$\text{FWHM}_{\text{radial}}$	& $=$	& $0.5 \lambda_0 / \text{NA}_{d}$						\\
		Objective field size				& S								& $=$	& $\text{FN}/{\text{M}}$								\\\\
		\multicolumn{4}{l}{Camera}\\\hline\hline  
		Pixel size in object space			& $ p_{\text{object}}$			& $=$	& $p/  \text{M}^{\text{eff}}$							\\
		Camera FOV in object space		&$\text{FOV}_{\text{object}}$	& $=$	& $l_{\text{chip}} / \text{M}^{\text{eff}}$				\\
										&$\text{FOV}_{\text{object}}$	& $=$	& $p_{\text{object}} \cdot \#_{\text{pixels}}$			\\
		Slit width on the camera			& $s_{\text{camera}}$			& $=$	& $ p \cdot t_{\text{shutter}} / t_{\text{exp}} $			\\
		Slit width in object space			& $s_{\text{object}}$			& $=$	& $ s_{\text{camera}}/ \text{M}^{\text{eff}}$			\\
		Frame rate						& $\nu$							& $=$	& $1/(\#_{\text{vert. pixels}} \cdot t_{\text{exp}} + t_{\text{shutter}})$ \\\\

		\end{tabular}
\end{table}

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

%%%%%%%%%%%%%%%%%%%%%%%%%%%%%%%%%%%%%%%%%%%%%%%%%%%%%%%%%%%%%
%%%%% References %%%%%

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

\bibitem{castagna1997object} G. Castagna, \emph{``Object-Oriented Programming A Unified Foundation,"} Birkh{\"a}user, Boston (1997).

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

\end{thebibliography}

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

\listoftables

\section{Supplementary information}

\subsection{Alignment}

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

%\end{spacing}
\end{document}
