CarolineMuellenbroich/Giovanni-goes-Giorgio/Neurophotonics/Stuff/manuscript_merged.tex

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

\title{Robust data management for high through-put light sheet microscopy of whole mouse brains} 

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

%%%%%%%%%%%%%%%%%%%%%%%%%%%%%%%%%%%%%%%%%%%%%%%%%%%%%%%%%%%%% 
\renewcommand{\cftdotsep}{\cftnodots}
\cftpagenumbersoff{figure}
\cftpagenumbersoff{table} 
\begin{document} 
\maketitle 

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

%\begin{spacing}{2}   % use double spacing for rest of manuscript

%%%%%%%%%%%%%%%%%%%%%%%%%%%%%%%%%%%%%%%%%%%%%%%%%%%%%%%%%%%%%
\section{Introduction}%funnel shape
\label{sect:intro}  

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

\section{Optical path}

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

\section{Microscope management software}

	\begin{figure}
   \begin{center}
   \begin{tabular}{c}
   
   \end{tabular}
   \end{center}
   \caption{\label{fig:connectivity} Schematic views of the hardware (A) and software (B) architectures of the microscope, showing physical and logical connections, respectively. The software architecture scheme clarifies the hierachic structure of the Murmex components. AO analog output, DO digital output, DI digital input.} 
   \end{figure}

\subsection{General design principles}

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

\subsection{Murmex}

	\begin{figure}
   \begin{center}
   \begin{tabular}{c}
   
   \end{tabular}
   \end{center}
   \caption{\label{fig:murmex} This graph needs a caption.} 
   \end{figure}

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

Murmex design pattern has twelve pre-defined common states (Initialise, Configure, Start, Stop, Proceed, Update, Reset, Inspect, Inform, Acknowledge, Fetch, Terminate) and a generic state for implementing custom states. Usually, just a few of this states are actually used in standard application. An example of a standard implementation of the Murmex state machine for a scanning system is shown in Fig. BLABLA. Each Murmex component streams information about its current status to its 'observers', other components specified in its configuration file. Using this oberserver/observee hierarchy, it is possible to design large and complex network of different components, running on whatsoever number of computers connected through a local connection or the Internet. A special component, named ServiceManager (also based on Murmex), which must be running on each computer, can start executables remotely. This allows the user to start up a sophisticated configuration with multiple components executed on different computers, but steered from one computer.

\subsection{System timing and software organization}

A schematic overview of the hardware and software architecture of our light sheet microscope is shown in Fig. BLABLA, respectively. One personal computer (Precision T5600, Dell, Round Rock, USA) controls all the remote hardware components with the exception of the camera, which is controlled by a second, dedicated computer (Precision T7500, Dell, Round Rock, USA) to handle and manage the enormous streams of data produced (see next section). Various instrumentations are addressed either through computer ports (as USB, RS232 and CameraLink) or via analog and/or digital signals generated by a DAQ board (NI PCIe-6353, National Instruments, Austin, USA).

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

The stack component is used to acquire single image stacks along the $z$ direction, and to this aim send specific messages to coordinate the Camera and the Stages components. Stacks are collected by moving continuously the sample along $z$ while keeping the camera acquiring in free run. The translation speed is such that in the time needed to collect a single frame the specimen has moved by a $z$ step specified in the GUI. The Camera component uses low-level libraries from Hamamatsu to save the data, producing one single \emph{.cxd} file (which is a proprietary tiff-like format from Hamamatsu) for each image stack. The name of this file and the path to it is specified by the Stack component.

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

\section{Data Management}

The volume of a mouse brain have been estimated from MRI measurements \cite{Kovacevic2005} as $\simeq 0.5$ $\text{cm}^3$; the same Authors find out that a parallelepiped encompassing the whole brain would have a volume of $\simeq 0.9$ $\text{cm}^3$. Given the pixel size of the camera and the magnification of the system, and assuming a $z$ step of 2 $\mu$m, the voxel size results $0.234\times0.234\times2$ $\mu\text{m}^3$. This means that a mouse brain will be represented with about 4.6 TeraVoxels, while a parallelepiped encompassing the brain will result in 8.2 TeraVoxels. Since the camera produces 16 bit images with no compression, each raw voxel occupies 2 bytes of disk space, resulting in 8.3 TB for the whole brain "alone" and 14.8 TB for the parallelepiped (see Table XXXX). However, image stacks are acquired with a 10\% of linear superposition, which is used later for image stitching. This redundancy expands the size of raw data to 10.2 TB and 18.3 TB, respectively.

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

\subsection{Data handling and storage}

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

While transferring the data from the SSD to the NAS, we also perform a file conversion from the proprietary Hamamatsu format to a more manageable one. We chose the TIFF format among the others because it permits to store 3D image with lossless compression in a single file. Furthermore, it is a flexible and platform-independent format supported by numerous image processing applications. We thus developed a conversion module that leverages the functionalities offered by the interface of the DCIMGAPI library, supplied by Hamamatsu, and the freely available LibTIFF library. The module reads a single .cxd 3D image and writes it in a variable number of multi-page TIFF files, depending on the user-defined limit of pages per file. Since the output of the Hamamatsu camera may exceed tens of Gbytes, the image in proprietary format is read slice by slice to minimize memory requirements. The module has also an option to downsample the image on save the input image at full or reduced resolution, in order to adapt to storage availability. Usually we downsample the image in the XY plane by a factor 2 and leave the Z sampling as usual. This kind of downsampling, in combination with the lossless compression offered by the TIFF format, reduces data size by about one order of magnitude. Thus the parallelepid volume cointaining the whole mouse brain can be represented using about 2-3 TB of disk space.

Although file conversion drastically reduces data size, in the current implementation it is quite slower than data production. The Camera component flushes data on the SSD with a rate $R_{data}$ dependent on frame rate $R_{frame}$ and on the image size:
\begin{equation}
R_{data} [\text{Bytes}] = 2\times R_{frame} \times \#_{pixels}\,,
\end{equation}
where the factor takes into account the 16 bit grey depth of images. The volumetric imaging rate is given by $R_{volume} = 0.5 R_{data} \times \text{Voxel size}$.

With a standard image size of $2048\times 2048$ pixels, and $R_{frame}=44$ Hz, data are produced at a rate $R_{data}=352$ MB/s $\approx 1.2$ TB/h, which results in a volumetric rate $R_{volume} \approx 2\times 10^7$ $\mu\text{m}^3/s$ $\approx 0.07$ $\text{cm}^3$/h. The conversion module can empty the SSD wih an average rate of about 0.7 TB/h, meaning that the SSD is actually filled up during imaging at a rate of about 0.5 TB/h. Imaging sessions should thus be shorter than 21.8 hours: this limits the maximum amount of raw data being acquired continuously to approximately 25.4 TB. This is well above the disk space needed to image the parallelepieped volume encompassing a whole mouse brain. Larger specimens, as rat brain or portion of human brain, must be imaged in consecutive session until faster strategies for image conversion are devised.

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

\section{Data}

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

\begin{landscape}
\begin{table}[t!]
	\centering
		\caption[Resolution]{Imaging properties and derived quantities. The thickness of the light sheet is approximately of the same size as the depth of field of the high NA detection lens.\label{tab:resolution}}
		\begin{tabular}{lrlrl}
		\multicolumn{5}{l}{Detection}\\\hline\hline  
		wavelength																	&	$\lambda$				&																																					& 0.5			& $\mu m$	\\
		refractive index														&	n								&																																					& 1.45		& 				\\
		numerical aperture 													&	$\text{NA}_d$		&																																					& 1				& 				\\
		%angular aperture 													& $\alpha$				&	$=sin^{-1}(\nicefrac{\text{NA}_d}{n})$																	& 43.6		& $deg$		\\
		magnification 															& $M_{\text{eff}}$&	$= \nicefrac{f_{\text{TL}}}{\text{EFL}}$																& 27.8		&					\\
		tube lens 																	& $f_{\text{TL}}$	&																																					& 200			&	$mm$		\\
		effective focal length objective						& EFL							& $=\nicefrac{f_{\text{TL}}}{M}$																					& 7.2			& $mm$		\\
		diameter back focal plane										& BFP							& $= 2\cdot \text{EFL} \cdot \text{NA}_d$																	& 14.4		& $mm$		\\
		field number																& FN							&																																					& 18			& $mm$		\\
		field size in specimen											& S								& $=\nicefrac{\text{FN}}{M}$																							& 0.65		& $mm$		\\
		depth of field															& $\Delta$				& $=\nicefrac{\lambda \cdot n}{(\text{NA}_d)^2}+ \nicefrac{n \cdot e}{M \cdot \text{NA}_d}$	& 1.06 		& $\mu m$	\\ 
		Airy radius lat.														& $r_A$						& $=\nicefrac{0.61 \lambda}{\text{NA}_d}$																	& 0.31		& $\mu m$	\\\\
		\multicolumn{5}{l}{Excitation}\\\hline\hline
		numerical aperture 													&	$\text{NA}_e$		&																																					& 0.3			& 				\\
		magnification,	nominal											& m								&																																					& 10			&					\\
		tube lens 																	& $f_{\text{tl}}$	&																																					& 100			&	$mm$		\\
		effective focal length, objective						& efl							& $=\nicefrac{f_{\text{tl}}}{m}$																					& 20			& $mm$		\\
		magnification, effective										& $m_e$						&	$=\nicefrac{f_{\text{tl}}}{\text{efl}}$																	& 5				&					\\
		refractive index														&	$\eta$					&																																					& 1				& 				\\
		beam radius																	& $\omega$				&																																					& 4.5			& $mm$		\\
		%Airy radius lat.														& $r_a$						& $=\nicefrac{0.61 \lambda}{\text{NA}_e}$																	& 1.02		& $\mu m$	\\
		min light sheet waist												& $\omega_0$			& $=\nicefrac{\lambda \text{efl}}{\pi \omega}$														& 1.41		& $\mu m$	\\
		confocal parameter													& b								& $=\nicefrac{2 \pi \omega_0^2}{\lambda}$																	& 25.15		& $\mu m$	\\\\
		\multicolumn{5}{l}{Camera}\\\hline\hline
		cell size																		& e								&																																					& 6.5			&	$\mu m$	\\
		effective area 															& $r^2$						&																																					& $13.3^2$	&	$\text{mm}^2$	\\
		line read out time													& t								&																																					& 9.7			&	$\mu s$	\\
		line exposure time													& l								&																																					& 3				&	ms			\\
		slit width, camera space										& $d_c$						& $=\nicefrac{l \cdot e}{t} $																							& 2				&	mm	\\
		slit width, sample space										& $d_s$						&	$=\nicefrac{d_c}{M}$																										& 0.72		&	mm	\\
		frame rate																	& $\nu$						&	$=\nicefrac{1}{(2048 \cdot t + l})$																			& 43.6		& Hz\\
		\end{tabular}
\end{table}
\end{landscape}		

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

%%%%%%%%%%%%%%%%%%%%%%%%%%%%%%%%%%%%%%%%%%%%%%%%%%%%%%%%%%%%%
%%%%% References %%%%%

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

\bibitem{castagna1997object} G. Castagna, \emph{``Object-Oriented Programming A Unified Foundation,"} Birkh{\"a}user, Boston (1997).

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

\end{thebibliography}

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

\listoftables

\section{Supplementary information}

\subsection{Alignment}

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

%\end{spacing}
\end{document}
