CarolineMuellenbroich/Giovanni-goes-Giorgio/FOM/To Ludo.pptx

Spherical aberration funtion

Residual
(spherical aberration)

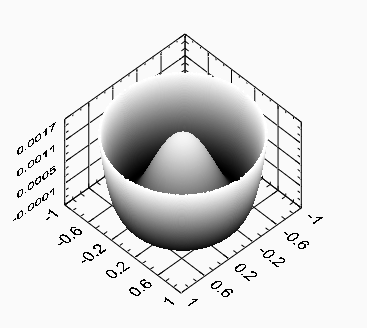
[picture p3: figure]

Total Aberration function

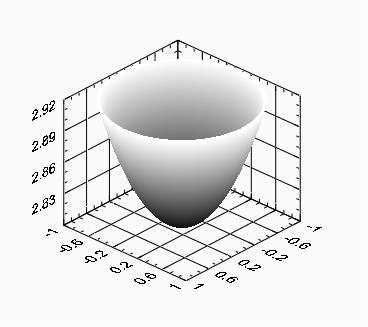
[picture p4: figure]

Piston + Defocusing

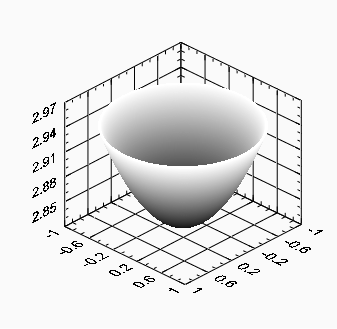
[picture p5: figure]

=
