CarolineMuellenbroich/Giovanni-goes-Giorgio/Neurophotonics/last min corr.docx

Removed all %commented out text from .tex file

Introduction:

- Added reference Freeman2014 and Burns2014 in introduction bcause of relevance to audience
- Cited frasconi chung tomer earlier to increase intro citations to 9

Optical setup:

- Added that first telescope made up of singlet lenses
- “From here on all lenses are achromatic doublets coated for the visible spectrum.”
- Telescope between aotf and lm is in schematic but not in text, added sentence: “A 1:1 telescope (f150,f150) is used to re-collimate the beam after the AOTF.”
- Fig 1B was not refered to in text
- Added sentence in illumination unit about lens diameter being chose for entry beam diameter of reference resolution paragraph mentioned effective NA: “The focal lengths of the doublets making up the telescope have been chosen for space considerations and to achieve a $1/e^2$ beam radius of 0.73mm at the back focal plane resulting in an effective NA of 0.025 (see also section\ref{sec:characterisation}).”

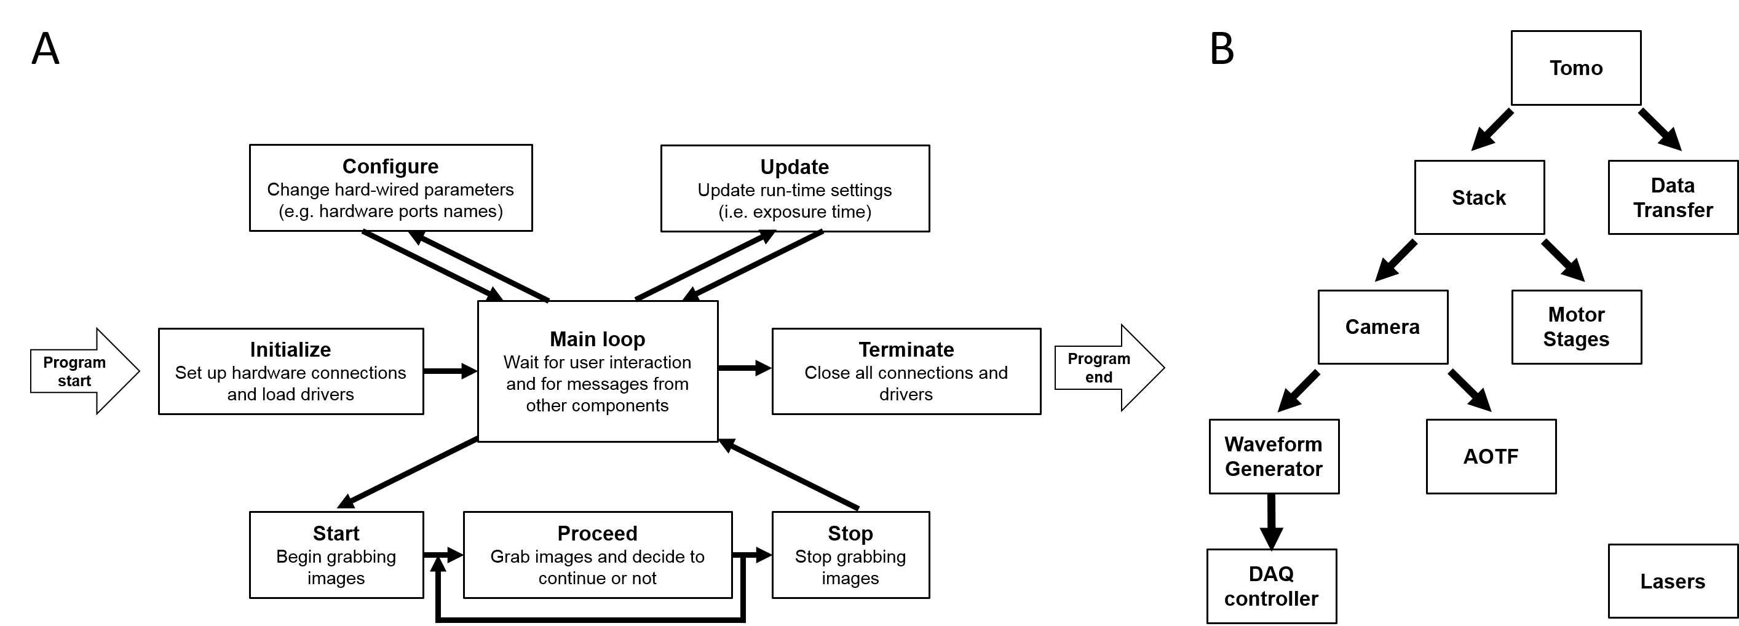
[picture p6: figure]
