CarolineMuellenbroich/Giovanni-goes-Giorgio/Neurophotonics/Stuff/Connectivity_scheme.pptx

Galvo
scanners

XYZ + rot.
motors

sCMOS
camera

BNC – AO

DIO (trigger)

USB

DAQ

CameraLink

data flow

AOTF

Internal bus

PC 1

???

USB

LAN

PC 2

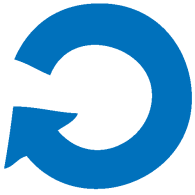
[picture p7: figure]

data flow

circular buffer
(5.6 TB SSD)

Deformable
mirror
driver

HV generator
for electro-optic
modulator

less urgent

???

Low-cost
camera

less urgent

Dedicated board

10 Gbit/s
link

???

Optical fiber

CINECA
