CarolineMuellenbroich/Giovanni-goes-Giorgio/Neurophotonics/Stuff/manuscript_merged_Ludo.pdf

## Comprehensive optical and data management infrastructure for high through-put light sheet microscopy of whole mouse brains

M. Caroline Mullenbroich, ¨

a,b Ludovico Silvestri, a,c Leonardo Onofri,e

Irene Costantini,a
Marcel van ’t Hoff,a,b,f Leonardo Sacconi,a,c Giulio Iannello,e Francesco S. Pavone,a,b,c,d
aEuropean Laboratory for Non-linear Spectroscopy (LENS), University of Florence, Italy
bDepartment of Physics and Astronomy, University of Florence, Italy
cNational Institute of Optics, National Research Council, Italy
dInternational Center for Computational Neurophotonics (ICON Foundation), Italy
e
Integrated Research Centre, University Campus Bio-Medico of Rome, Italy fDistrio, Amsterdam, The Netherlands

Abstract. 200 words limit. no numerical references presenting concisely the objectives, methodology used, results obtained, and their significance.

Keywords: Light sheet microscopy, big data, whole brain mounting, data management, whole brain imaging, rolling shutter, 7,8..

Address all correspondence to: First author, University Name, Faculty Group, Department, Street Address, City, Country, Postal Code; Tel: +1 555-555-5555; Fax: +1 555-555-5556; E-mail: myemail@university.edu

### 1 Introduction

The highly ambitious project of mapping and understanding each and every neuronal connection in the whole brain has been moved from the realm of wishful longing to feasible reality by the recent advent of light sheet fluorescent microscopy (LSFM). With this technique 3D data sets can be acquired with a resolution that is high enough to identify neurons and their dendritic, axonal and spine features in time scales which are no longer the bottle neck of high-throughput acquisition. In LSFM, the sample is illuminated with a thin sheet of light confined into the focal plane of the detection objective, which collects the fluorescence emission along an axis perpendicular to the illumination plane.¹ This technique drastically reduces the imaging acquisition time by recording millions of pixels in parallel and affords optical sectioning by operating fluorescence excitation and detection on separate, perpendicularly oriented paths where the excitation light sheet and the detection focal plane overlap. Consequently fluorophores outside the light sheet are neither bleached nor contribute blurring out-of-focus noise. Consequently LSFM reduces phototoxicity and photobleaching while achieving excellent resolution at high penetration depths; however, it requires the sample to be transparent.
Several challenges remain to be overcome, however, to allow fast and, most of all systematic, production of reliable datasets and their meaningful interpretation to further our understanding of neuronal networks. Those challenges include fast, cheap and reproducible sample preparation, automated image acquisition that does not require constant attention by an expert and, most crucially, the storage, interpretation and analysis of the unprecedented huge data sets light sheet microscopy routinely produces. The mapping and understanding of this “big data” is a colossal task that requires the expertise of computer scientists to employ fully automated post-processing, for example, to do cell counting or blood vessel segmentation. On the other hand, the imaging of large, intrinsically opaque samples in light sheet microscopy necessitates clearing protocols based on refractive index matching which render the tissue transparent. This makes LSFM a truly interdisciplinary field in which the technological advances by optical developers need to be matched by novel development in the area of information and biotechnology.
Here we will present a state-of-the-art LSFM, as it is implemented in our lab, which is especially beneficial to acquire 3D data sets of large, clarified and structurally intact mouse brains. The LSFM features double-sided illumination with a digitally scanned light sheet and a sample chamber which has been specifically designed for the the imaging of large (> 1cm³
), immersed
and freely movable samples. After briefly presenting the optical clearing protocol we employ to render our samples transparent, we explain how to prepare and mount the samples for stable, 3D imaging for several days. In addition to a full description of the optical setup, the control hardware and software, we further present a practical guide for the alignment of a LSFM, a non-trivial task that requires careful consideration. A systematic approach to handle, store and analyse the data is explained in detail. We further explain about the data volume we produce how it can be reduced and handled. The imaging capabilities are demonstrated by 3D reconstructions of biological specimens. The final sentence of the introduction needs to be amazing.

### 2 Optical path

2.1 Laser unit

The custom-made, confocal light sheet microscope is equipped with 5 linearly polarised, cw lasers for fluorescence excitation (Figure1,A). The wavelengths were chosen to excite the most common fluorophores (see Table2 for the manufacturer and specifications of opto-mechanical components). The laser light from each laser is first collimated and expanded with a telescope (f140, f200) and then combined into a common path with a beam steering mirror and a long-pass filter (Semrock, LaserMUXTM series). An acousto-optical tunable filter (AOTF) acts as fast (µs) electronically tunable filter which uses the acousto-optical interaction inside an anisotropic medium to select and transmit any combination of up to four of the laser lines. The radio-frequency applied on the AOTF transducer controls the wavelength being transmitted into the first order and the radio-frequency amplitude allows to adjust the transmitted light intensity. Due its nonlinear response we measured the AOTF light transmittance for each wavelength as a function of radio frequency amplitude and determined a look-up table to linearise the output. The zero order light is blocked by an iris. An electro-optical laser modulator (EOM) acts like a wave plate with electronically controlled retardation and rapidly rotates (few hundreds ns) the input polarisation of the excitation light by 90◦
. The wavelength-dependent, high voltage that needs to be applied to the birefringent crystal inside the modulator to change the optical path length is provided by a two-step amplification system. First, a low voltage, analog signal from the DAQ board is pre-amplified with custom made electronics and then fed into a commercial high voltage amplifier. A digital line is used to switch to zero the output of the pre-amplifier, allowing control of the frequency with which the polarisation is changed. After the laser modulator the excitation beam is further expanded by a factor of two with two achromatic doublets (f100, f200).

2.2 Illumination unit

From here on three different light paths can be chosen through flip mirrors. One light path option guides the light through an axicon (apex angle of 160◦
) and an achromatic doublet (f50) to create a Bessel beam. The other two options create Gaussian beams of different beam diameter. This

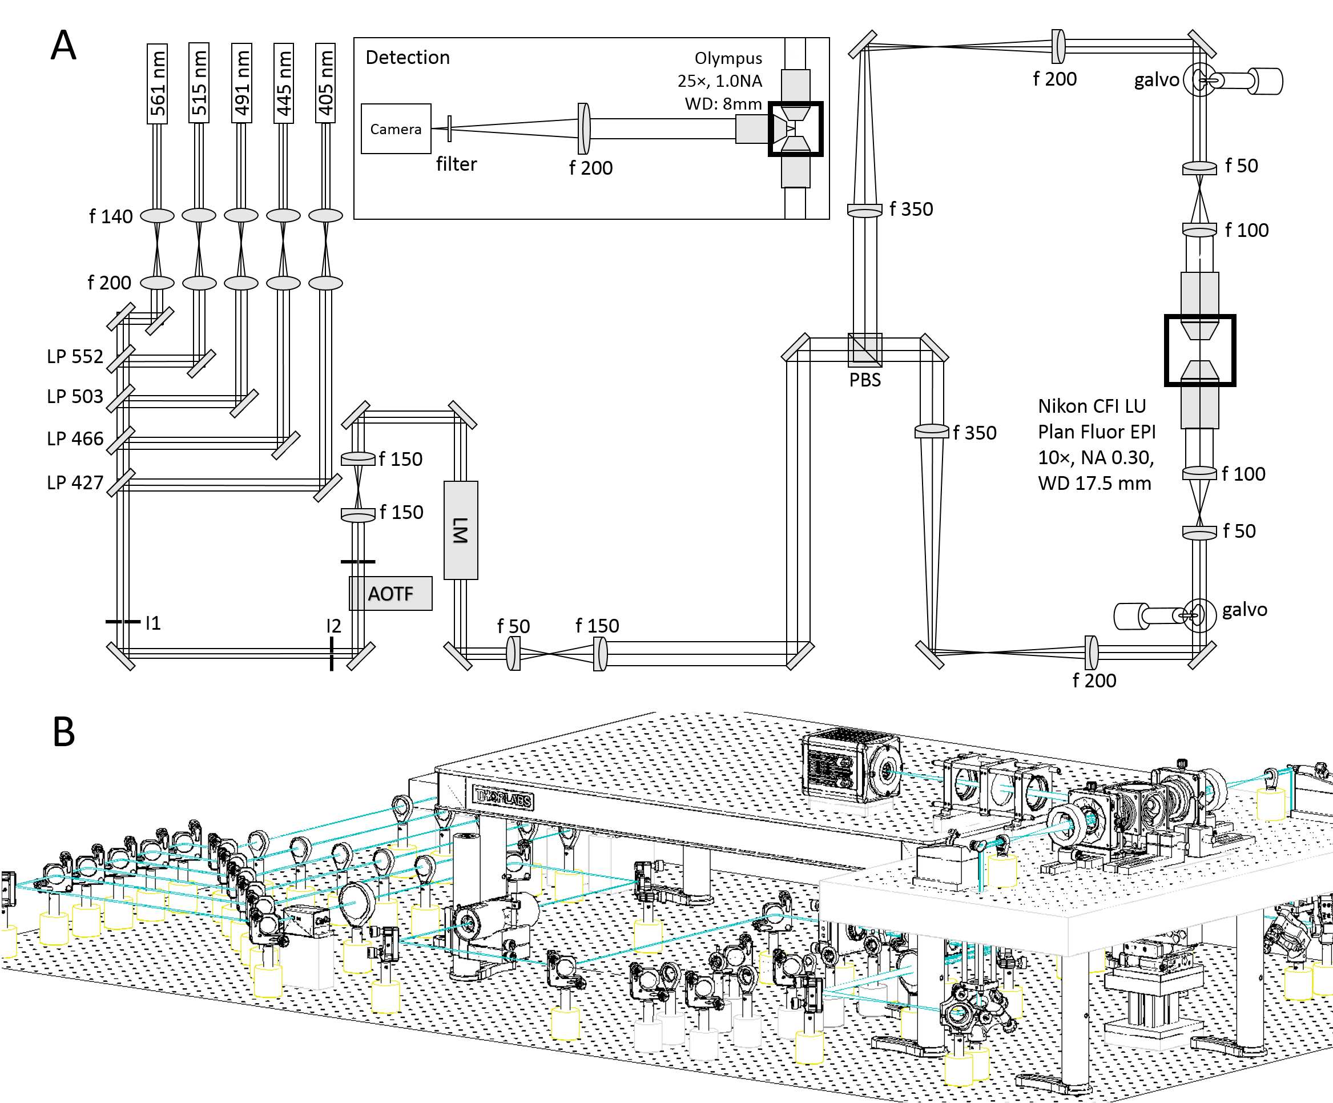
[picture p17: figure]

Fig 1: (A) Topview of the excitation path. The galvo scanners are mounted above periscopes. LP: long-pass filter, I: iris, AOTF: acousto-optical tunable filter, LM: laser modulator, PBS: polarisation beam splitter, ABCD: flip mirrors. Inset: detection. (B) Oblique view of the microscope. A custom-made breadboard serves to mount the sample chamber and objectives at an elevated height and features two circular holes at the edges for the periscopes and a large central cut out for the translation stages. A second breadboard is used for the camera.

diameter variation translates to different fields of view later on in the detection path. The three options are recombined before a polarising beam splitter cube which splits the excitation light depending on its polarisation into one of the two identical excitation arms. The beam is reduced with a telescope (f350, f200) whose telecentric plane coincides with the mirrored surface of a galvanometric scanner (galvo). The galvos are mounted on a custom made optical breadboard which features two circular holes to pass the periscopic beams and a large central cut-out for the sample chamber and motor stages.
The scan mirror surface is re-imaged with a telescope (f50, f100) onto the back aperture of a long working distance, low magnification objective (Nikon, 10x 0.3NA WD 17.5mm). The two excitation objectives are designed for air immersion but are immersed into the clearing solution within the sample chamber. A coverslip glued to the front housing edge serves the dual purpose of maintaining the first diffractive surface between the front optical element and the air and to protect the front lens elements from the organic solvent. The light sheet is generated digitally⁷, 8 by scanning the excitation beam across the focal plane of the detection objective. This generates incoherent illumination resulting in fewer artefacts.Additionally each line is specimen is illuminated with the same intensity creating a homogeneous light sheet which is particularly advantageous for the quantitative investigation of large samples in their entirety.

2.3 Detection unit

In it’s simplest form, the fluorescence detection unit of a light sheet microscope is a conventional wide-field microscope: an objective lens, a fluorescent filter and a tube lens for an image on a wide-field detector. Fluorescence is collected with an objective that is specifically designed for immersion in clearing solutions. The objective is equipped with a correction collar allowing for immersion in media with refractive indices ranging from 1.41 to 1.52 (Olympus, XLSLPLN25XGMP, effective focal length 7.2 mm). To image the whole volume of interest the objective has a relatively low magnification of 25x and a large working distance of 8mm yet a high numerical aperture (1.0NA) affords high resolution imaging. A tube lens of 200mm creates the primary image on a sCMOS camera (Orca Flash4.0, Hamamatsu) with a chip of over 4 megapixels. In contrast to CCD sensors each pixel of a sCMOS camera sensor has a separate photodetector and amplification unit which means that sCMOS pixels can be read out independently from each other. The cell size of the OrcaFlash is p

2 = 6.5µm x 6.5µm over an active area of 13.3mm. With a 200mm tube lens the field of view in the sample is 480µm.
In the rolling shutter data acquisition mode only a subset of adjacent horizontal pixel lines is simultaneously exposed and this active detection region is moved across the image sensor. With the delay between the exposure of two adjacent lines set to the minimum time required to read out a single line (t = 9.7µs, see Table3) the entire frame of 2048 horizontal lines is activated within 19.86ms. Setting the line exposure time to l = 3ms results in approx. k = l/t ≈ 300 lines being simultaneously exposed at any time. This detection area is swept from the top to the bottom of the chip and acts like a moving, virtual confocal slit corresponding to a width of ds = kp/Meff = 0.72m in the sample space. With the given values of line exposure and line read out time, the camera acquires images at a frame rate of ν = 1/(2048t+l) ≈ 44Hz.
The camera was run as master in the internal trigger mode and a synchronisation pulse generated with the exposure of each new line was used as as an output trigger for a data acquisition and generation device (DAQ) from National Instruments which was operated as slave. The saw-tooth


Fig 2: Schematic of light sheet microscopy. (A) Fluorescence excitation (along x axis) and detection (along z axis) are operated on independent, perpendicular light paths where the excitation light sheet and the detection focal plane overlap. (B) The custom-made sample chamber is assembled with silicone bellows and seal rings. The clarified, fluorescently-labelled brain is mounted on a Teflon cylinder in the centre of the watertight chamber (C) and can be translated and rotated freely with piezo motors (D). (E) Mounting of a clarified, fluorescently labelled brain. The brain is glued onto a coverslip and inserted into an adapter that slides into the Teflon cylinder.

driving signal for the galvo mirrors was generated by the DAQ and synchronised with the pixel line reset pulses from the camera to achieve confocal line detection.⁹ For optimal imaging it is crucial that the sample-emitted line of fluorescence is in the centre of the rolling shutter at the start of each image acquisition and furthermore travels with the same speed during stack acquisition. Any deviation from precise synchronisation results in image artefacts and severely degraded image contrast. The confocal resolution can be changed at run-time by changing the user-defined line exposure time and with it rolling shutter width, that is the number of horizontal pixel lines simultaneously exposed.

### 3 Sample mounting and motion

To elucidate neuronal projections and functional connections in structurally intact tissue it is paramount to be able to image centimeter-sized, clarified samples, such as mouse brains, with high resolution in whole mount preparation. While promising clearing protocols are well documented in literature,², 3
the question of sample preparation and mounting in light sheet microscopy is not trivial but requires novel approaches to such extent that it is becoming a separate field of research and very diverse strategies such as FEP tubes, 3D printed chambers and Quartz cuvettes have been reported,³⁻⁶ however, these approaches are limited to much smaller sample volumes. The problem of sample mounting in a light sheet microscope arises form the fact that optical access to the sample is required from 3-4 planar sides leaving only two opposing sides to insert, fix and move the sample. Most commonly the vertical direction is chosen. Stable mounting is hereby a key concern as a whole brain tomography can require image acquisition in excess of 24 hours and the effects of gravity, tissue shrinking/expansion and evaporation of the clearing solution over such time spans might have to be considered.
For the acquisition of whole brain data sets, we fix a clarified and fluorescently-labelled mouse brain with super glue to a coverslip (Figure2,D). The brain is oriented along its axial orientation with the olfactory bulbs at the top and the cerebellum at the bottom of the coverslip. The coverslip is slid into a bottom adaptor and tightened with a plastic-capped grub screw. The bottom adaptor is inserted into a Teflon cylinder with the coverslip being positioned on the far side of the detection objective. Three different slits in the adapter correspond to varying distances to the detection objective and give variability in sample thickness for example to allow also for the mounting of rat brain hemispheres.
We designed a cubic, water-tight sample chamber (Figure2,A) that allows access from all six sides while maintaining the 3D integrity of large, clarified and fluorescently-labelled mouse brains. The sample chamber is tightly bolted to the optical breadboard while soft connections using silicone bellows allow for adjustive movements of the objectives and free 3D motion of the motor stages (Figure2,B). All connections are sealed with rubber rings and silicone caulk and additionally tightened with cable binders. In this way the objectives can be refocused and realigned without compromising the watertight seal of the chamber (Figure2,C). The clarified brains are imaged immersed in clearing solution composed of 63% TDE in Phosphate buffered saline (PBS) and a refractive index of 1.45. To fill the entire volume of the sample chamber approximately 400ml clearing solution are needed. A motorized x-, y-, z-, θ-stage (Physik Instrumente, see Table2) allows free 3D motion and rotation of the Teflon cylinder which reaches into the centre of the chamber (Figure2,D). Illumination and detection axes are horizontal and the sampler rotation occurs around the vertical axis.

### 4 Optical characterisation

The optical properties of a microscope can be summarized by the point-spread function (PSF), which is the image of a point source in object space. In particular, the radial (i.e. perpendicular to the detection axis) and axial (i.e. parallel to the detection axis) resolutions of the microscope can be quantified with the full width at half-maximum (FWHM) of the PSF itself along the chosen direction. In a light sheet microscope, axial and radial resolutions are determined by the NA of the illumination and detection optics, respectively. The radial PSF is a standard Airy function, whose FWHM is given by:

FWHMradial '

0.51λ0
NAd
, | (1)

λ0 being the wavelength in vacuum and NAd the NA of the detection objective.
The axial resolution is given by the thickness of the light sheet. If Gaussian beams are used for illumination, the thickness of the light sheet can be calculated by the well-known formulas of Gaussian optics.? The 1/e²
radius of the beam waist is given by:

w0 =

λfeff
i
πw
, | (2)

where w is the 1/e²
radius of the beam entering the illumination objective, f

eff
i
| is the effective focal
length of the illumination optics and λ is the wavelength in the medium (λ = λ0/n, n being the refractive index). Note that, for air objectives (as the one we use for illumination) the effective focal length is extended by a factor n when used inside a medium with refractive index different from 1.¹⁰ The axial FWHM is then given by:
FWHMaxial ' 1.177w0 . | (3)

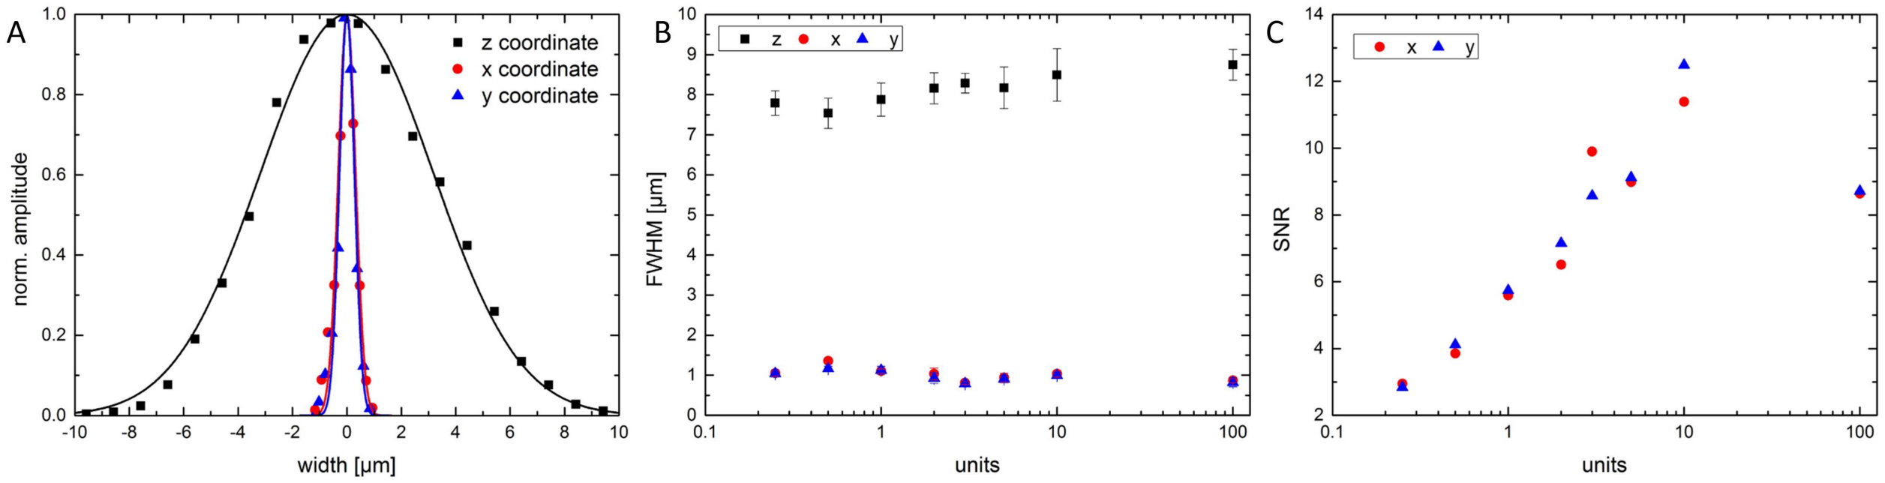
[picture p18: figure]

Fig 3: Optical characterisation. (A) Exemplary lateral and axial intensity profiles of sub-resolution beads and fits to Gaussian. (B) For each unit 10 bead profiles were fitted in all three dimensions and their FWHM was averaged. (C) The signal to noise ratio.

The thickness of the light sheet is not constant throughout the field of view due to the limited depth of focus of the Gaussian beam. This latter can be quantified by the confocal parameter b, which is the distance along which the beam 1/e²

radius is not bigger than √ 2w0:

b =

2πw²
0
λ

=

2λ(f

eff
i

)

2

πw²

. | (4)

The need to have an almost uniform resolution in the camera field of view (FOV) imposes a lower bound to b and thus (according to the previous equations) a limit to the axial resolution. In our setup we adjusted the telescopes in the excitation path in order to have w '???, resulting in b '??? and FWHMaxial '?????.
An overview of the relevant formulas for the optical properties of a light sheet microscope is given in Table3. The reader could refer to this table as a quick guide to tailor the apparatus to her specific needs.
AND HERE THE AMMAZING OURS DATAS

### 5 Microscope management software

5.1 General design principles

The many components of the microscope (camera, lasers, AOTF, stages, etc.) are orchestrated together and operated through a custom-made software. Since the microscope should work mainly without human intervention for many hours (a whole-brain tomography can last a couple of days) without losing proper synchronization, software design is not a secondary issue when building a light sheet microscope for whole-brain imaging. The overall architecture of the software and its practical implementation were chosen to satisfy several principles:

- User-friendliness. The light sheet microscope here presented was designed and developed by optical technology specialists yet needs to be operational in a multi-user environment. The greatest challenge therefore consists in making the use of the microscope easy and intuitive such that no formidable expertise is needed when it is operated by researchers with no expertise in optics and/or software development.

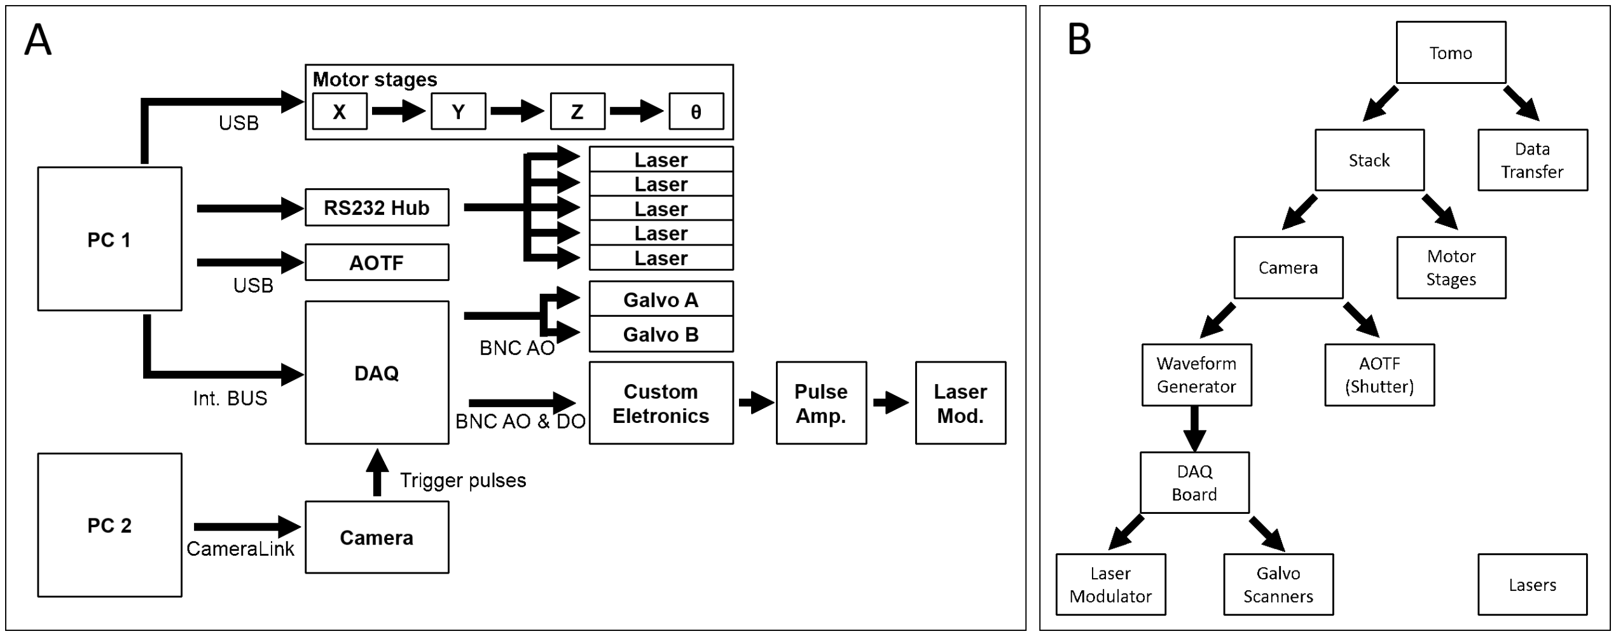
[picture p19: figure]

Fig 4: Schematic view of the hardware architecture of the microscope. Different kind of physical connections are depicted with different colors.

- Working in a distributed environment. The apparatus should deal with many independent hardware components, and with several data streams (see below). Individual processing steps and/or data transfer can be computationally intensive, and may need to be distributed over several computers to perform properly at run-time.
- Robustness and ease of maintenance. Any kind of hardware problem, from timing delay to real failure, must be automatically handled to avoid loss of precious data. Furthermore, developers must be able to fix existing code or to develop new one without having to change the whole software.
- Reusability and scalability. When a second or third microscope with basic similarity yet slightly specialised equipment is being designed in the same or in other laboratories, rewriting all the code from scratch is pure loss of time. Writing well structured, scalable and easily maintainable scientific software can help avoiding redundancy and boosting up productivity.

Our microscope management software has been written in LabVIEW (National Instruments, Austin, US), as this language is particularly well suited for hardware control and data acquisition through pre-developed methods. An object-oriented programming framework¹³ has been used, dividing the entire project into well-defined self-contained modules. This framework, besides helping defining the proper scope of each software component, guarantees robustness, ease of maintenance, scalability and reusability. Code is stored on GitHub (www.github.org) to help multiple users developing software simultaneously. The graphical user interface (GUI) provides intuitive control of the apparatus as well as deep personalization. In general, the intrument parameters are already set to optimal values stored on disk, and on-line tips on how to set or change the various settings are provided. Both GUIs and code are developed according to the LabVIEW Style Guide.¹⁶


Fig 5: Schematic view of the workflow of a representative Murmex component operating a camera.

5.2 Murmex

To let the software operate efficiently and synchronously on different machines, the Murmex (http://sine.ni.com/nips/cds/view/p/lang/en/nid/212895) software development kit was used. This kit integrates the object-oriented programming paradigm with a messaging system, and can be used to create communicating yet independent software modules within a standardized programming scheme.
Basically, Murmex creates distributed finite state machines. These are design patterns in which one component proceed from one particular state to another based on the message it receives either from itself or from other components. For sending and receiving messages, Murmex uses the library LabbitMQ, (http://sine.ni.com/nips/cds/view/p/lang/en/nid/211065) which is a wrapper of RabbitMQ, (http://www.rabbitmq.com/) a message-oriented middleware facilitating message shipment and receival. These layers of abstraction are mostly hidden for the developers. The RabbitMQ server (message broker) needs to be installed either locally or somewhere in the network. The message-based communication allows for buffered, asynchronous and reliable message communication between several software components. Messages are routed by the broker to the specific software component by its ID. The LabbitMQ wrapper allows use of RabbitMQ inside the LabVIEW programming environment.
Murmex design pattern has twelve pre-defined common states (Initialise, Configure, Start, Stop, Proceed, Update, Reset, Inspect, Inform, Acknowledge, Fetch, Terminate) and a generic state for implementing custom states. Usually, just a few of this states are actually used in standard application. An example of a standard implementation of the Murmex state machine for a scanning system is shown in Fig. 5. Each Murmex component streams information about its current status to its ’observers’, other components specified in its configuration file. Using this oberserver/observee hierarchy, it is possible to design large and complex network of different components, running on whatsoever number of computers connected through a local connection or the Internet. A special component, named ServiceManager (also based on Murmex), which must be running on each computer, can start executables remotely. This allows the user to start up a sophisticated configuration with multiple components executed on different computers, but steered from one computer.

5.3 System timing and software organization

A schematic overview of the hardware architecture of our light sheet microscope is shown in Fig.
4. One personal computer (Precision T5600, Dell, Round Rock, USA) controls all the remote hardware components with the exception of the camera, which is controlled by a second, dedicated computer (Precision T7500, Dell, Round Rock, USA) to handle and manage the enormous streams of data produced (see next section). Various instrumentations are addressed either through computer ports (as USB, RS232 and CameraLink) or via analog and/or digital signals generated by a DAQ board (NI PCIe-6353, National Instruments, Austin, USA).
Synchronization of the camera rolling shutter to the scanning of the light sheet is achieved by letting the camera acquiring in free-run mode, and using a trigger output from the camera itself to time the generation of the waveforms sent to the galvo drivers. In particular, the HSYNC signal from the camera is used, providing a true-type-logic (TTL) pulse everytime the rolling shutter steps from one line to the next one. This trigger signal is used as a clock by the DAQ board, so that the line producing the light sheet moves step by step with the rolling shutter. The same HSYNC signal is used to trigger the DAQ digital signal sent to the electro-optic laser modulator. In this case, since at each position of the scanning line the modulator should go trough at least two states (vertical polarization and horizontal polarization), HSYNC is used as a trigger while the clock used is the (much faster) internal clock of the DAQ board.
Each hardware component (AOTF, galvo scanners, electro-optical modulator, sample stages, camera, lasers) is managed through its own Murmex component. Since the galvo scanners and the electro-optical modulator are not addressed directly, but via analog and digital signals generated by the DAQ board, their software component just send analog and digital waveforms to an additional intermediate component responsible for DAQ board management. Beyond hardware-related software, two additional Murmex components (named Stack and Tomo) orchestrate the operation of the entire system.
The stack component is used to acquire single image stacks along the z direction, and to this aim send specific messages to coordinate the Camera and the Stages components. Stacks are collected by moving continuously the sample along z while keeping the camera acquiring in free run. The translation speed is such that in the time needed to collect a single frame the specimen has moved by a z step specified in the GUI. The Camera component uses low-level libraries from Hamamatsu to save the data, producing one single .cxd file (which is a proprietary tiff-like format from Hamamatsu) for each image stack. Note that the Camera component must write data to disk in perfect time, otherwise the nominal z position is of each frame is no more coincident with the real z position of the plane imaged. For this reason, we set the process executing the Camera code to be of highest priority. The Stack component checks the timing of data production, in order to re-acquire the image stack if the camera has been out-of-time. The Stack component also specify the name and the path of the .cxd file.
The tomo component is used to image the entire sample by collecting many adjacent, parallel, partially-overlapping stacks. To this aim it exchanges messages with the Stack and the Stages components. The user can specify the volume to be imaged either by inserting the maximum x, y and z coordinates of a parallelepiped, or by providing a text file with the list of stacks to be collected (x and y coordinates, starting and ending zs). The Tomo component also inform the experimenter about the state of the acquisition by sending an email when it’s finished or if any trouble is experienced.

All the software described here can be freely downloaded from GitHub. (https://github.com/marcelvanthoff/Giorgio) Beacuse of its modular structure and of the extensive documentation, it can be easily integrated and adapted in other microscopy systems.

### 6 Data Management

The volume of a mouse brain have been estimated from MRI measurements¹⁵ as ' 0.5 cm³
; the
same Authors find out that a parallelepiped encompassing the whole brain would have a volume of ' 0.9 cm³
. Given the pixel size of the camera and the magnification of the system, and assuming a z step of 2 µm, the voxel size results 0.234 × 0.234 × 2 µm³
. This means that a mouse brain will be represented with about 4.6 TeraVoxels, while a parallelepiped encompassing the brain will result in 8.2 TeraVoxels. Since the camera produces 16 bit images with no compression, each raw voxel occupies 2 bytes of disk space, resulting in 8.3 TB for the whole brain ”alone” and 14.8 TB for the parallelepiped (see Table 1). However, image stacks are acquired with a 10% of linear superposition, which is used later for image stitching. This redundancy expands the size of raw data to 10.2 TB and 18.3 TB, respectively.
This unprecedented amount of data challenges to the traditional way we interact with our data. Having far passed the point of taking your data home with you on a hard drive at the end of the experiment, data management in light sheet microscopy requires the development of a robust data management infrastructure, and of novel software tools to process the images in order to extract meaningful information.

6.1 Data handling and storage

The camera used in our light sheet microscope (Hamamatsu Orca Flash 4.0 v2) flushes the datastream directly to a dedicated workstation with 12 solid-state drives (SSD) operating in RAID 0 configuration, resulting in a virtual drive of 10.9 TB. Although this is already a large and expensive system for the current SSD technology, it is way smaller than the size of the raw datasets produced in each tomography. We thus connected the workstation to a larger network area storage (NAS) via a 10 Gbit/s network copper cable. The NAS operates in a safer data modality (RAID
5) with 32.4 TB of useful disk space. The NAS is then connected by a dedicated 10 Gbit/s link provided by the Consortium GARR (the Public Institution managing research networks in Italy) to CINECA (the main italian supercomputing center). The data flow scheme is summarized in Figure 6.
While transferring the data from the SSD to the NAS, we also perform a file conversion from the proprietary Hamamatsu format to a more manageable one. We chose the TIFF format among the others because it permits to store 3D image with lossless compression in a single file. Furthermore, it is a flexible and platform-independent format supported by numerous image processing applications. We thus developed a conversion module that leverages the functionalities offered by the interface of the DCIMGAPI library, supplied by Hamamatsu, and the freely available LibTIFF library. The module reads a single .cxd 3D image and writes it in a variable number of multi-page TIFF files, depending on the user-defined limit of pages per file. Since the output of the Hamamatsu camera may exceed tens of GB, the image in proprietary format is read slice by slice to minimize memory requirements. The module has also an option to downsample the image on save the input image at full or reduced resolution, in order to adapt to storage availability. Usually we downsample the image in the XY plane by a factor 2 and leave the Z sampling as usual. This

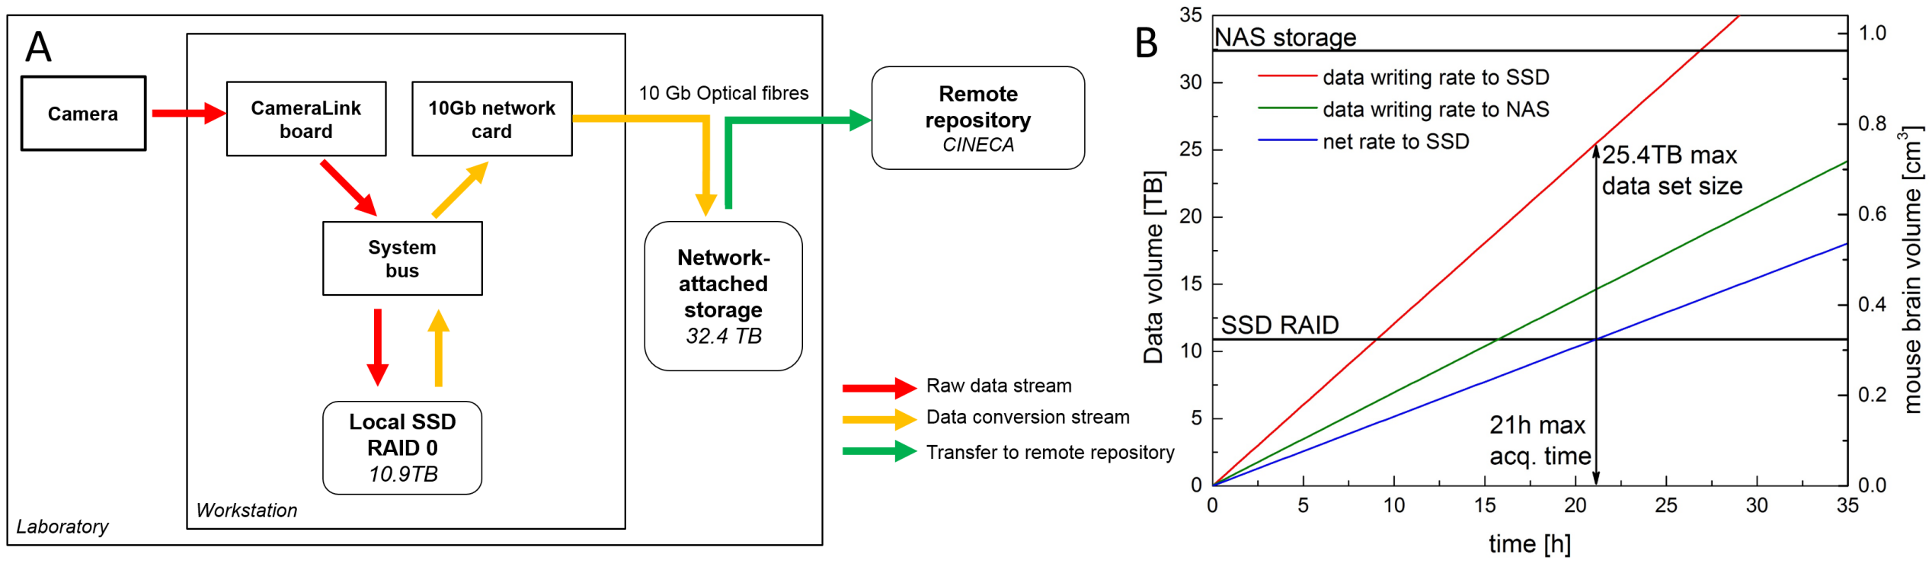
[picture p20: figure]

Fig 6: Scheme of the data flow. (A) Data streaming on the microscope. SSD: solid-state disk, RAID: redundant array of independent disks, NAS: network-attached storage. Different colors (red, yellow and green) indicate the time-sensitivity (higher to lower) of each data movement.
(B) Data production rate versus data conversion rate showing the maximum acquisition time and tomography size feasible before the SSD are filled up.

kind of downsampling, in combination with the lossless compression offered by the TIFF format, reduces data size by about one order of magnitude. Thus the parallelepid volume cointaining the whole mouse brain can be represented using about 2-3 TB of disk space.
The process executing the file conversion code is set to low execution priority to prevent interference with the Camera component, which needs to be perfectly timed with acquisition. Thus, although file conversion drastically reduces data size, in the current implementation it is quite slower than data production. The Camera component flushes data on the SSD with a rate Rdata dependent on frame rate Rframe and on the image size:
Rdata[Bytes] = 2 · Rframe · #pixels , | (5)

where the factor takes into account the 16 bit grey depth of images. The volumetric imaging rate is given by Rvolume = 0.5Rdata · Voxel size.
With a standard image size of 2048 × 2048 pixels, and Rframe = 44 Hz, data are produced at a rate Rdata = 352 MB/s ≈ 1.2 TB/h, which results in a volumetric rate Rvolume ≈ 2 × 10⁷ µm³/s ≈ 0.07 cm³
/h. The conversion module can empty the SSD wih an average rate of about 0.7 TB/h, meaning that the SSD is actually filled up during imaging at a rate of about 0.5 TB/h. Imaging sessions should thus be shorter than 21.8 hours: this limits the maximum amount of raw data being acquired continuously to approximately 25.4 TB. This is well above the disk space needed to image the parallelepieped volume encompassing a whole mouse brain. Larger specimens, as rat brain or portion of human brain, must be imaged in consecutive session until faster strategies for image conversion are devised.

6.2 Stitching and visualisation

Given the limited field of view of the microscope, the acquisition of macroscopic specimens required many parallel image stacks to cover all the volume. Thus, in order to achieve a 3D image of the whole specimen from raw data, the Terastitcher¹² has been recently proposed, i.e. a stitching tool capable to deal with teravoxel-sized images. However, the Terastitcher does not support input

Table 1: Data production rates for typical camera operation.

Voxel size | 0.234 × 0.234 × 2 µm³
Frame rate | 44 Hz
Frame size | 2048 × 2048 pixels
Frame disk size | 8 MB
Data production rate | 1.2 TB/h
Data conversion rate | 0.7 TB/h
Net SSD filling rate | 0.5 TB/h
SSD RAID size | 10.9 TB
Max acquisition time to fill up SSDs | 21.8 h
Max raw data size that can be acquired continuously | 25.4 TB
Max volume that can be imaged | 1.24 cm³
(considering 10% superposition between adjacent stacks)

data acquired through the serial sectioning procedure, which leads to a specimen partitioned in different layers. Furthermore, only single channel images can be processed. For these reasons, we extended the Terastitcher functionalities introducing the two following additional features: i) stitching of a specimen partitioned in a number of overlapping layers for the hippocampus reconstruction and, ii) coping with images containing more than one channel for the human brain tomography. With respect to the first requirement, that is allowing a complete reconstruction of a multi-layered raw data, we schematically depicts in Fig.1 the adopted strategy. First of all, the various input layers, each of which is composed of several parallel overlapping stacks, are separately stitched by using the existing Terastitcher tool. After this preliminary step, leveraging the layer coordinates provided by the instrument, we import the processed layers as a new volume where each layer has a partial overlap with adjacent layers. Furthermore, each layer is organized in a non-overlapping tiled format, enabling the application of a multi MIP-NCC approach,¹² which computes the displacement between two adjacent layers along all of the three directions (Fig. 1). When a displacement computation for each pair of adjacent layers has been computed, the overlapping regions are merged through a blending procedure which smooths the transition between layers, resembling once more the procedure used by Terastitcher for combining adjacent stacks. Finally, we note that due to the repositioning of each layer, the volume containing the reconstructed specimen might contain empty regions, which are thereby filled with black voxels. Turning our attention to the second additional feature, that is handling multi-channel images, the Terastitcher has been extended so that the MIP-NCC algorithm used for displacement computation can work on an image, which can be either the fusion of the input channels or one of the input channels. This permits to privilege the channel with more information content over the other channels as well as discard noisy channels. Note that the reconstructed 3D image can be produced with the same channel composition of raw data.

### 7 Data

Everybody take a look at Figure7 because it is the best we have.

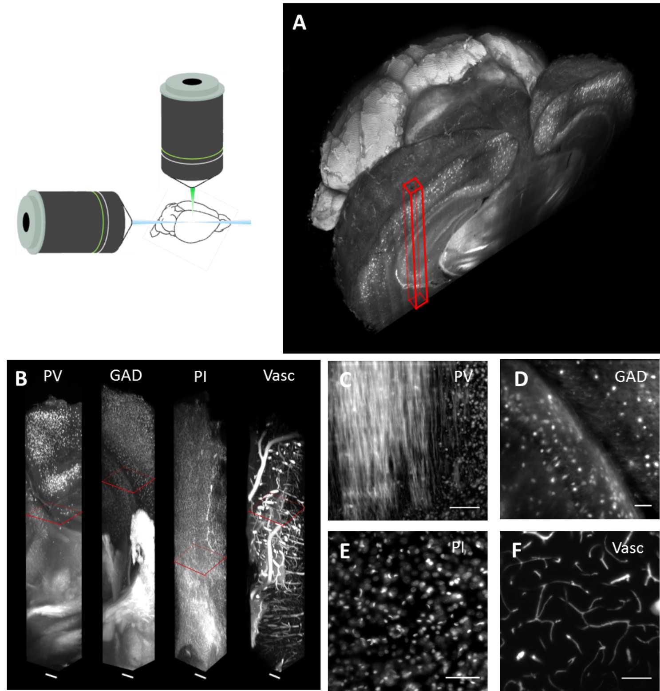
[picture p21: figure]

Fig 7: Whole mouse brain tomography. Imaging of whole transgenic mouse brains treated with CLARITY and cleared with TDE 63% imaged with LSM (Olympus, 25X objective). (A) 3D rendering of a parvalbumin-dTomato brain. (B) 3D rendering of stacks from PV-dTomato mouse brain, GAD-dTomato mouse brain, PI stained mouse brain, FITC-albumin labeled mouse brain, scale bar = 400 m. (C,D,E,F) High resolution insert, of the stack corresponding to red boxes in C. Scale bar = 100 m.

### 8 Conclusion

summary Light sheet microscopy has already been a game changer for large-scale imaging by yielding data with a combination of unprecedented spatio-temporal scale. The impact of this unique measurement technique will continue to revolutionise the field of whole brain connectomics due to its ability to record millions of images over the course of days or even weeks. The data produced in this fashion easily amounts several TB per data set and needs to be stored, transferred, retrieved, processed and visualised necessitating the concurrent development of novel computational interface and analysis methods. The latter need to be robust, standarised and fully automated processes yet allow for flexible, exploratory and tailored analysis.

### 9 Outlook

Table 2: Overview of optomechanical components.
Component | Manufacturer | Part# | Specifications
Lasers | Cobolt AB, Sweden | MLD | 405nm, 80mW, s-polarised
| | MLD | 445nm, 50mW, s-polarised
| | Calypso | 491nm, 50mW, s-polarised
| | Fandango | 515nm, 50mW, s-polarised
| | Jive | 561nm, 50mW, s-polarised
AOTF | AA Opto-Electronic, France | AOTFnC-400.650-TN > 90% diffraction efficiency, 3nm resolution, low cross talk
| | | between laser lines, high separation angle
Laser modulator Qioptiq GmbH, Germany | LM 0202 VIS ADP | 400-650nm , λ/2-voltage (633nm): 210V
Pulse amplifier | Falco Systems, The Netherlands WMA-300 | 50x amplification up to ± 150V, DC to 5MHz signal bandwidth
Galvo scanner | Cambridge Technology, USA | 6220H | small angle step response 200µs
Objectives | Nikon; Japan | Plan Fluor EPI | 10x0.3NA, WD 17.5mm, EFL 20mm (excitation)
| Olympus, Japan | LMPLFLN20X | 20x0.4NA, WD 12mm, EFL 9mm (detection)
Motor stages | Physik Instrumente, Germany | C-863.11 | DC servo-motor controller
| | M-122 | Travel range 25mm, 0.1µm resolution, max. velocity 20mm/s
| | M-116 | Precision Rotation Stage, 2.5µrad, max. velocity 20◦/s
Camera | Hamamatsu, Japan | Orca Flash4.0 V2.0 | sCMOS sensor, 2048(H) x 2048(V), cell dim.: 6.5µm, active
| | | area: 13.3mm x 13.3mm, 16bit images
DAQ board | National Instruments, USA | NI PCIe-6353 | AI: 1 MS/s multichannel; 16-bit resolution, 10 V; AO: 2.86
| | | MS/s, 16-bit resolution, 10 V; digital I/O lines (hardware-
| | | timed up to 10 MHz), 100MHz max counter frequency
Workstation 1 | Dell, USA | T7500 | 12GB RAM, Intel Xeon Processor X5647 @ 2.93 GHz, OS
| | | Windows 7 64 bit
Workstation 2 | Dell, USA | T5600 | 8GB RAM, Intel Xeon Processor E5-2620 @ 2 GHz, OS Win-
| | | dows 7 64 bit

16

Table 3: Overview of the main formulas related to light sheet microscopy. In the table, f

design
TL is
the focal length of the tube lens for which the objective has been designed (200 mm for Leica and Nikon, 180 mm for Olympus and 165 mm for Zeiss), f

real
TL the focal length of the tube lens actually used, M the nominal magnification of the objective, n the refractive index of the immersion medium, λ0 the wavelength in vacuum, λ the wavelength in the medium, w the 1/e²
radius of the
Gaussian beam at the objective back focal plane, FN the field number of the objective, p the physical pixel size, lchip the size of the camera chip, tshutter the pace of the rolling shutter (i.e. the time between exposure start in subsequent lines), texp the line exposure time. The subscripts i and d refers to illumination and detection, respectively.

General formulas for microscope objectives
Nominal focal length | f = f

design
TL | /M
Effective focal length | f
| eff | = nf
Effective magnification | Meff | = f
real

TL /feff

Excitation (Gaussian)
Beam waist | w0 | = λfeff i /πw
Axial resolution | FWHMaxial | = 1.177w0
Confocal parameter | b = 2πω²
| | 0

/λ
b = 2λ(f
| | eff i
)
| | 2 /πw²

Detection
Radial resolution | FWHMradial | = 0.5λ0/NAd
Objective field size | S = FN/M

Camera
Pixel size in object space | pobject | = p/Meff
Camera FOV in object space | FOVobject | = lchip/Meff
| FOVobject | = pobject · #pixels
Slit width on the camera | scamera | = p ·tshutter/texp
Slit width in object space | sobject | = scamera/Meff
Frame rate | ν = 1/(#vert. pixels ·texp + tshutter)

Acknowledgments

workshop boys cause they are amazing. Human Brain Project tutta la vita. GARR gave us a beautiful 10gb fiber to cineca CINECA for hosting us on pico

References
1 J. Huisken and D. Y. Stainier, “Selective plane illumination microscopy techniques in developmental biology,” Development 136(12), 19631975 (2009). 1
2 K. Chung, J. Wallace, S. Y. Kim, S. Kalyanasundaram, A. S. Andalman, T. J. Davidson and
K. Deisseroth, “Structural and molecular interrogation of intact biological systems,” Nature 497(7449), 33233 (2013). 5

3 R. Tomer, L. Ye, B. Hsueh and K. Deisseroth, “Advanced CLARITY for rapid and highresolution imaging of intact tissues,” nature protocols 9(7), 1682-1697 (2014). 5
4 A. Kaufmann, M. Mickoleit, M. Weber and J. Huisken, “Multilayer mounting enables longterm imaging of zebrafish development in a light sheet microscope,” Development 139(17), 3242-3247 (2012). 5
5 P. Pitrone, J. Schindelin, L. Stuyvenberg, S. Preibisch, M. Weber, K. W. Eliceiri, J. Huisken and P. Tomancak, “OpenSPIM-an open access platform for light sheet microscopy,” arXiv reprint arXiv:1302.1987, 3242-3247 (2013). 5
6 O. E. Olarte, J. Licea-Rodriguez, J. A. Palero, E. J. Gualda, D. Artigas, J. Mayer and P. Loza-Alvarez, “Image formation by linear and nonlinear digital scanned light-sheet fluorescence microscopy with Gaussian and Bessel beam profiles,” Biomedical optics express 3(7), 1492-1505 (2012). 5
7 P. J. Keller and E. H. K. Stelzer, “Quantitative in vivo imaging of entire embryos with digital scanned laser light sheet fluorescence microscopy,” urr. Opin. Neurobiol. 18(6), 624632 (2008). 4
8 P. J. Keller, A. D. Schmidt, J. Wittbrodt, and E. H. K. Stelzer, “Reconstruction of zebrafish early embryonic development by scanned light sheet microscopy,” Sciences 322(5904), 10651069 (20108). 4
9 E. Baumgart and U. Kubitscheck, “Scanned light sheet microscopy with confocal slit detection,” Optics express 20(19), 21805-21814 (2012). 5
10 L. Silvestri, A. Bria, L. Sacconi, G. Iannello, and F. S. Pavone, “Confocal light sheet microscopy: micron-scale neuroanatomy of the entire mouse brain,” Opt Express 20(18), 20582-20598 (2012). 6
11 P. Frasconi, L. Silvestri, P. Soda, R. L. Cortini, F. S. Pavone and G. Iannello, “” Bioinformatics 30(), i587-i593 (2014).
12 A. Bria and G. Iannello, “TeraStitcher-A tool for fast automatic 3D-stitching of teravoxel-sized microscopy images,” BMC bioinformatics 13(1), 316 (2012). 12, 13
13 G. Castagna, “Object-Oriented Programming A Unified Foundation,” Birkhauser, Boston ¨ (1997). 8
14 I. Costantini, J.-P. Ghobril, A. P. Di Giovanna, A. L. Allegra Mascaro, L. Silvestri, M. C. Muellenbroich, L. Onofri, V. Conti, F. Vanzi, L. Sacconi, R. Guerrini, H. Markram, G. Iannello, and
F. S. Pavone, submitted.
15 N. Kovacevic, J. T. Henderson, E. Chan, N. Lifshitz, J. Bishop, A. C. Evans, R. M. Henkelman, and X. J. Chen, ”A Three-dimensional MRI Atlas of the Mouse Brain with Estimates of the Average and Variability”, Cereb. Cortex 15(5), 639-45 (2005). 11
16 P. A. Blume, ”The LabVIEW Style Book (National Instruments Virtual Instrumentation Series),” Prentice Hall PTR (2007). 8

## List of Figures

1 | (A) Topview of the excitation path. The galvo scanners are mounted above periscopes.
| LP: long-pass filter, I: iris, AOTF: acousto-optical tunable filter, LM: laser modu-
| lator, PBS: polarisation beam splitter, ABCD: flip mirrors. Inset: detection. (B)
| Oblique view of the microscope. A custom-made breadboard serves to mount the
| sample chamber and objectives at an elevated height and features two circular holes
| at the edges for the periscopes and a large central cut out for the translation stages.
| A second breadboard is used for the camera.
2 | Schematic of light sheet microscopy. (A) Fluorescence excitation (along x axis)
| and detection (along z axis) are operated on independent, perpendicular light paths
| where the excitation light sheet and the detection focal plane overlap. (B) The
| custom-made sample chamber is assembled with silicone bellows and seal rings.
| The clarified, fluorescently-labelled brain is mounted on a Teflon cylinder in the
| centre of the watertight chamber (C) and can be translated and rotated freely with
| piezo motors (D). (E) Mounting of a clarified, fluorescently labelled brain. The
| brain is glued onto a coverslip and inserted into an adapter that slides into the
| Teflon cylinder.
3 | Optical characterisation. (A) Exemplary lateral and axial intensity profiles of sub-
| resolution beads and fits to Gaussian. (B) For each unit 10 bead profiles were fitted
| in all three dimensions and their FWHM was averaged. (C) The signal to noise
| ratio.
4 | Schematic view of the hardware architecture of the microscope. Different kind of
| physical connections are depicted with different colors.
5 | Schematic view of the workflow of a representative Murmex component operating
| a camera.
6 | Scheme of the data flow. (A) Data streaming on the microscope. SSD: solid-state
| disk, RAID: redundant array of independent disks, NAS: network-attached storage.
| Different colors (red, yellow and green) indicate the time-sensitivity (higher to
| lower) of each data movement. (B) Data production rate versus data conversion
| rate showing the maximum acquisition time and tomography size feasible before
| the SSD are filled up.
7 | Whole mouse brain tomography. Imaging of whole transgenic mouse brains treated
| with CLARITY and cleared with TDE 63% imaged with LSM (Olympus, 25X
| objective). (A) 3D rendering of a parvalbumin-dTomato brain. (B) 3D rendering
| of stacks from PV-dTomato mouse brain, GAD-dTomato mouse brain, PI stained
| mouse brain, FITC-albumin labeled mouse brain, scale bar = 400 m. (C,D,E,F)
| High resolution insert, of the stack corresponding to red boxes in C. Scale bar =
| 100 m.


Fig 8: (A) Basic geometrical optics of a double-sided illumination light sheet microscope. AD: achromatic doublet, PBS: polarising beam splitter, red: objective back focal planes and conjugated telecentric planes, green: image planes, blue: 4f telecentric lens system, black: alignment irises.
(B) Alignment mirror with drilled hole for light transmission, mount for tip adjustment and adaptor for the Teflon tube. (C) With lateral movement the alignment mirror can be placed such that light is transmitted into the opposing excitation arm. (D) The alignment mirror can be rotated to precisely reflect by 90◦
8 | (A) Basic geometrical optics of a double-sided illumination light sheet microscope.
| AD: achromatic doublet, PBS: polarising beam splitter, red: objective back focal
| planes and conjugated telecentric planes, green: image planes, blue: 4f telecentric
| lens system, black: alignment irises. (B) Alignment mirror with drilled hole for
| light transmission, mount for tip adjustment and adaptor for the Teflon tube. (C)
| With lateral movement the alignment mirror can be placed such that light is trans-
| mitted into the opposing excitation arm. (D) The alignment mirror can be rotated to precisely reflect by 90◦ .
9 | (A) Working principle of a microscope objective (left): a collimated input beam is
| converted into a spherical wavefront. Right: inverted light path, a focal spot in the
| back aperture creates a collimated output. (B) Recursive placement of lenses using
| the sample mirror in back-reflection mode, (C) in transmission mode and (D) in
| reflection mode.

## List of Tables

1 | Data production
2 | Optomechanics
3 | Main formulas


Fig 9: (A) Working principle of a microscope objective (left): a collimated input beam is converted into a spherical wavefront. Right: inverted light path, a focal spot in the back aperture creates a collimated output. (B) Recursive placement of lenses using the sample mirror in back-reflection mode, (C) in transmission mode and (D) in reflection mode.

### 10 Supplementary information

10.1 Alignment

For light sheet microscopy it is crucial that excitation and detection occur on perpendicular axes because any deviation from this geometry results in obscured images of reduced resolution and contrast. The objectives need to be perfectly confocal so that the fluorescence that is generated in the swept excitation beam also falls within the detection objective’s focal plane. Telecentric imaging, that is the imaging with two lenses which are the sum of their focal lengths apart, a so-called 4f re-imaging system (Figure8,A), is used to re-image the galvo scanners onto the back apertures of the excitation objectives. In the detection path, the camera chip needs to be positioned in an image plane of the detection objective. Additionally, homogeneous illumination from both sides impose strict symmetry considerations on both illumination arms that have not only to be sufficiently aligned within themselves respectively but function as a pair with recursive dependence. Our microscope was aligned with two tools, a shear plate to qualitatively assess collimation and a small mirror that can be mounted inside the sample chamber where the sample would usually be. The 0.5in mirror was first pierced with a drill using a ceramic drill bit to produce a hole roughly in its centre of the approximately the same diameter as the excitation beam inside the sample chamber (Figure8,B). Using a compact single axis adjustable mirror mount (V50-AX, Newport) attached to the Teflon cylinder inside the chamber allows to to adjust the pitch of the reflection with the mount and the yaw with the rotation stage while at the same time providing a very space efficient mounting for the pierced 0.5in mirror. With this “sample mirror” three different position can be easily implemented, firstly, back reflection by hitting the reflective surface at 0

◦
, secondly, transmission
by laterally displacing the mirror until the light passes through the drilled hole (Figure8,C), and thirdly, reflection of the light by 90◦ by precisely turning the mirror mount by 45◦ using the rotation stage (Figure8,D).
The excitation objectives are fixed on mounts which allow three dimensional translation plus pitch and yaw adjustment (LP-1A, Newport). In a first alignment step the beam paths of both excitation arms where brought to overlap through irises placed on the breadboard and the optical bench without any microscope objectives. We found it useful to use two mirrors in each periscope, one vertically mounted and one mounted at 45◦
for vertical deflection of the incoming beam. In this way full beam steering can be achieved to realign the periscope before hitting the galvo scanner. After this initial alignment the sample mirror was placed with its reflective surface in the centre of the central cut-out of the breadboard. The first excitation objective was placed into the beam path and brought to focus onto the sample mirror which was adjusted to reflect the light back into the same objective through the irises. Using a shear plate and a beam splitter cube the back reflected light was qualitatively adjusted for collimation using translation along the excitation axis of the objective mount (Figure9,B). The sample mirror was then moved laterally to allow the excitation beam to pass through the drilled hole and the second excitation objective was placed (Figure9,C). This time collimation was checked with the light going through both objectives and so their confocal placement was insured. Both excitation arms were then aligned recursively by starting at the putative confocal point between the objectives and placing successively lens after lens in the direction towards the light source, alternating between the two modalities illustrated in Figure9,A. Finally, the sample mirror was positioned in deflection mode and the detection objective was aligned (Figure9,D).
