CarolineMuellenbroich/Giovanni-goes-Giorgio/Neurophotonics/Stuff/article.tex

%  article.tex (Version 1.00, released 1 October 2013)
%  LaTeX source file to demonstrate formatting for manuscripts 
%  to be submitted to SPIE journals
%  based on the class file spieman.cls, which requires 
%  the following standard packages:  times.sty, float.sty, 
%  ifthen.sty, cite.sty, color.sty, setspace.sty
%
%  Special instructions are included in this file after the
%  symbol %>>>>
%  Numerous commands are commented out, but included to show how
%  to effect various options, for example, to print page numbers, etc.
%  This LaTeX source file is composed for LaTeX2e.

%  The following commands have been added in the SPIE class 
%  file (spieman.cls) and may not be understood in other classes:
%  \affiliations{}, \sup{},\supit{}, \authorinfo{}, \keywords{},
%  \linkable and \video
%  The bibliography style file is called spiejour.bst 
%  This article.tex file needs the following image files:
%  mcr3b.eps
%  fig2.eps
%  satellite.eps
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
