CarolineMuellenbroich/Giovanni-goes-Giorgio/FOM/0.71offset.jpg

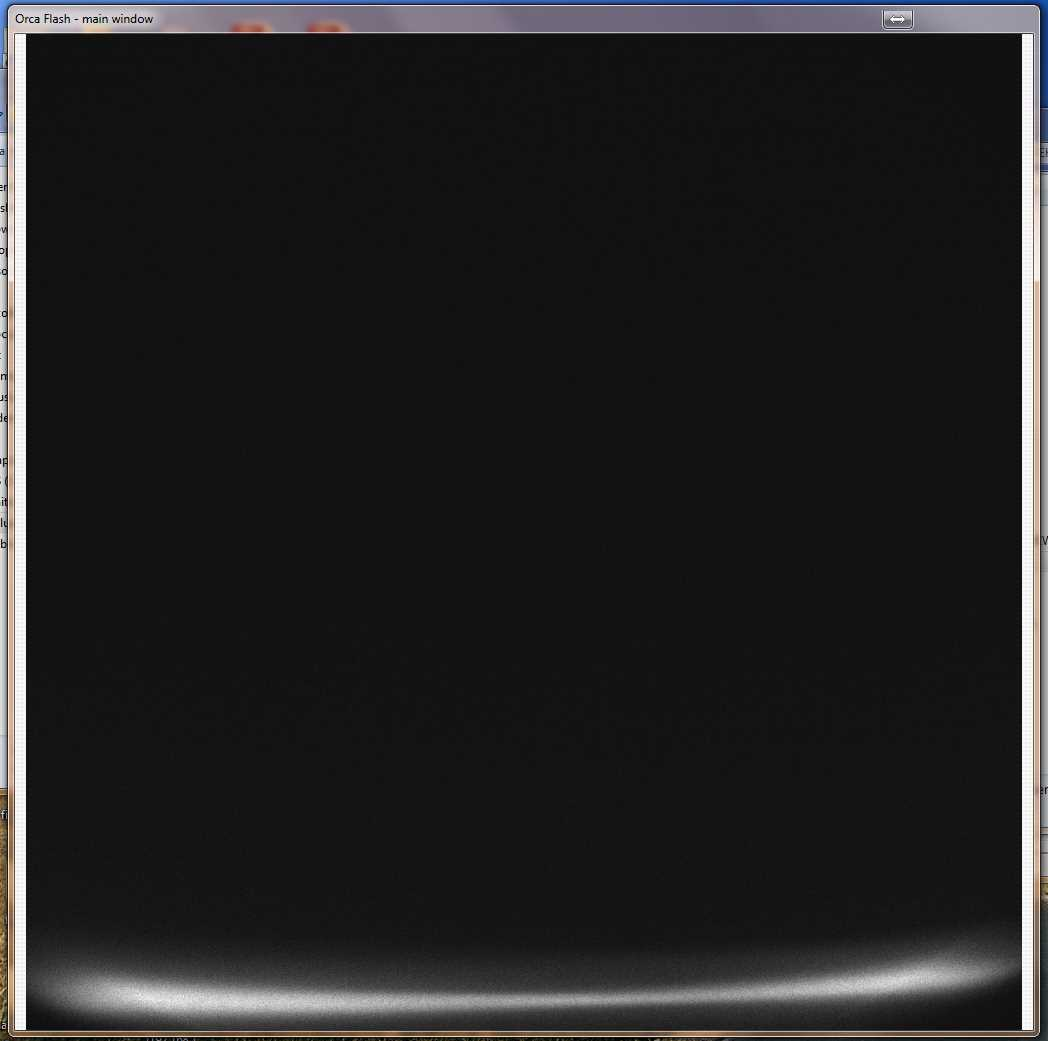
FOM/0.71offset.jpg
