CarolineMuellenbroich/Giovanni-goes-Giorgio/FOM/0SA.jpg

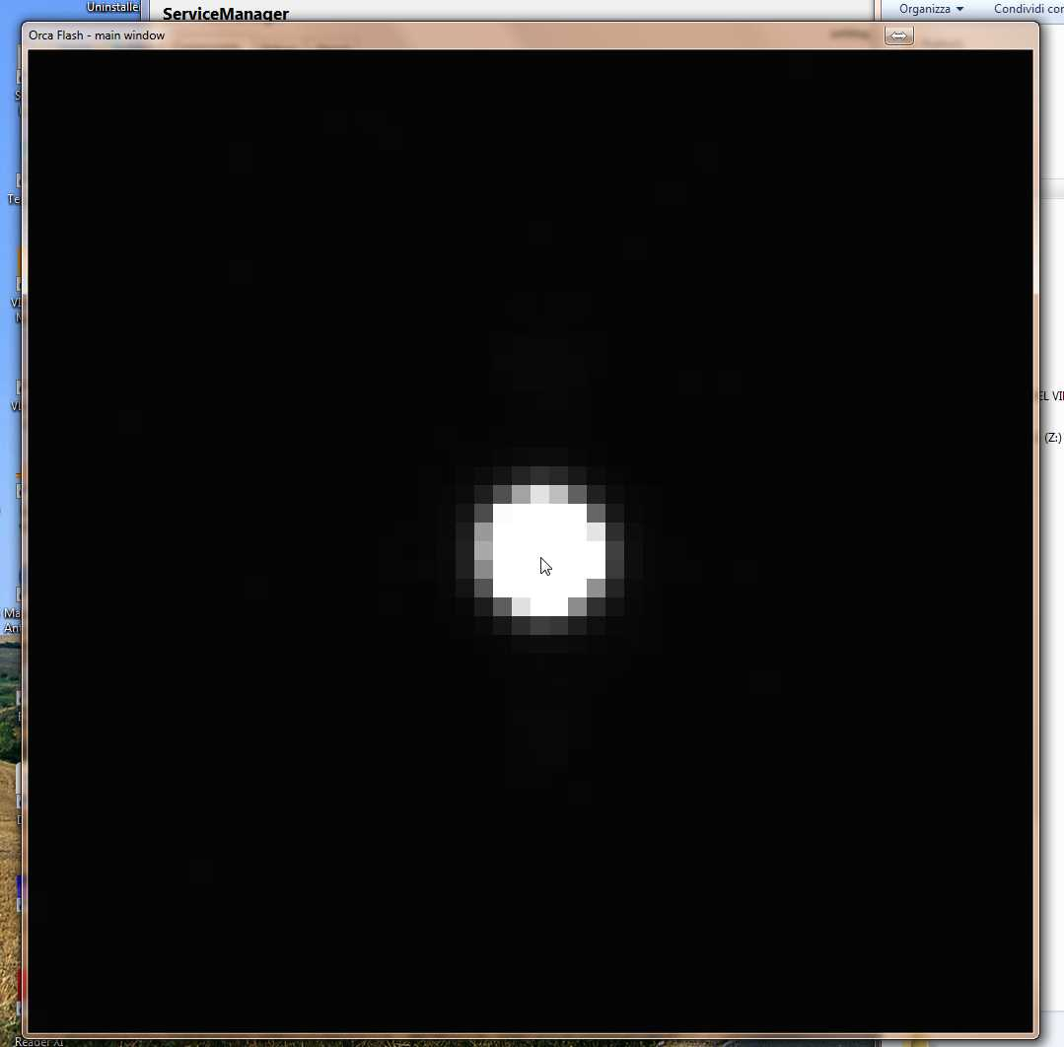
FOM/0SA.jpg
