CarolineMuellenbroich/Giovanni-goes-Giorgio/FOM/BC.png

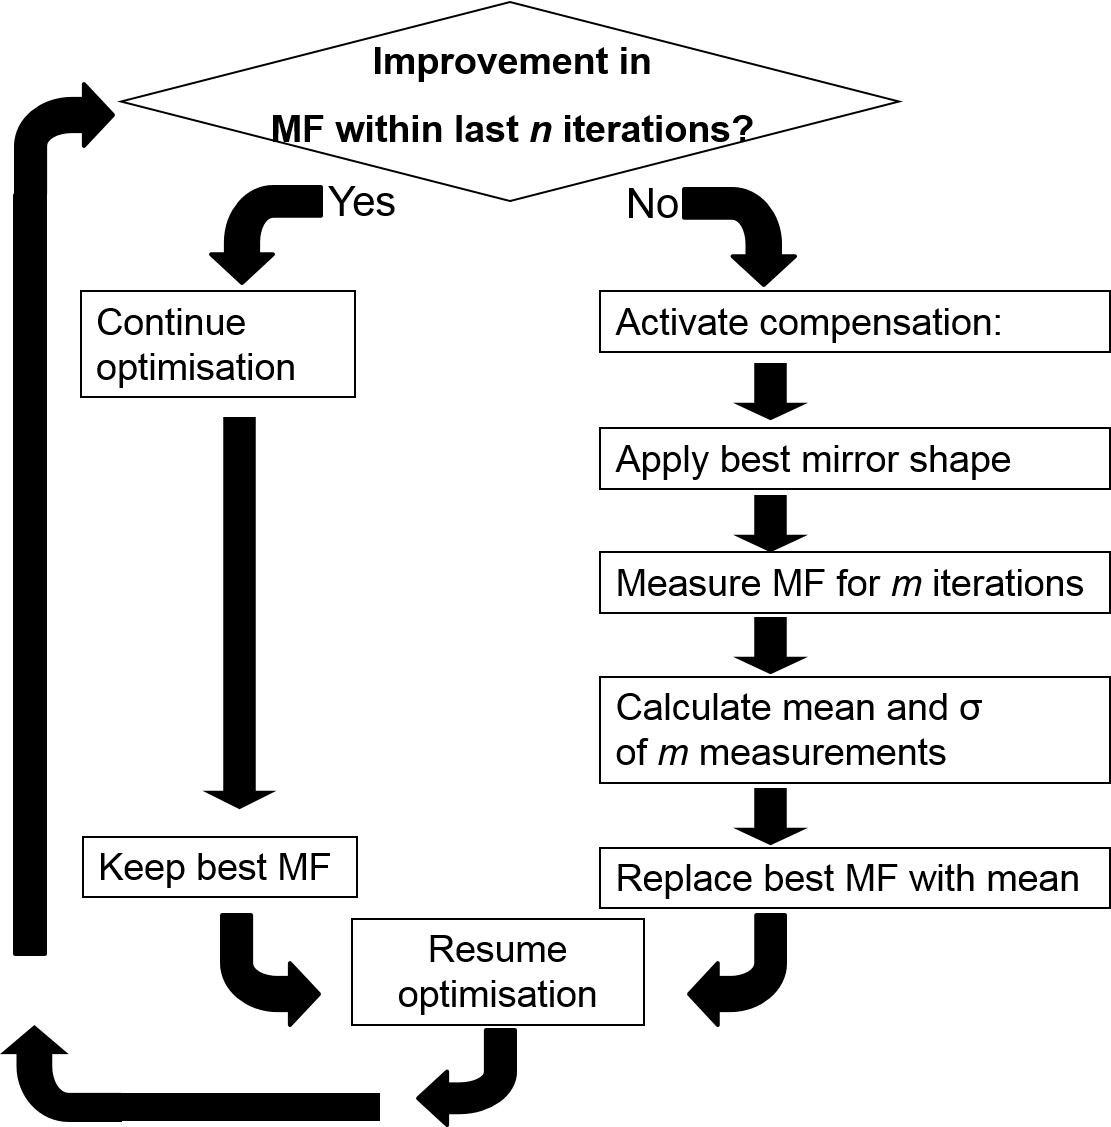
FOM/BC.png
