CarolineMuellenbroich/Giovanni-goes-Giorgio/FOM/derv_erf.jpg

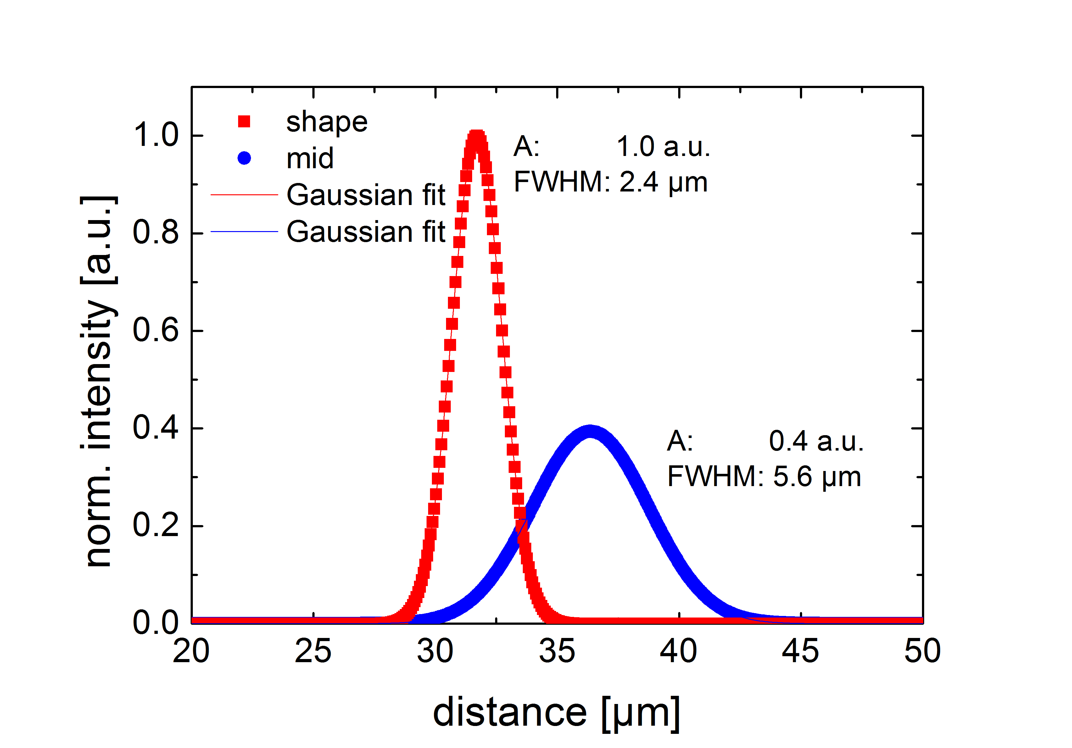
FOM/derv_erf.jpg
