CarolineMuellenbroich/Giovanni-goes-Giorgio/FOM/erf.jpg

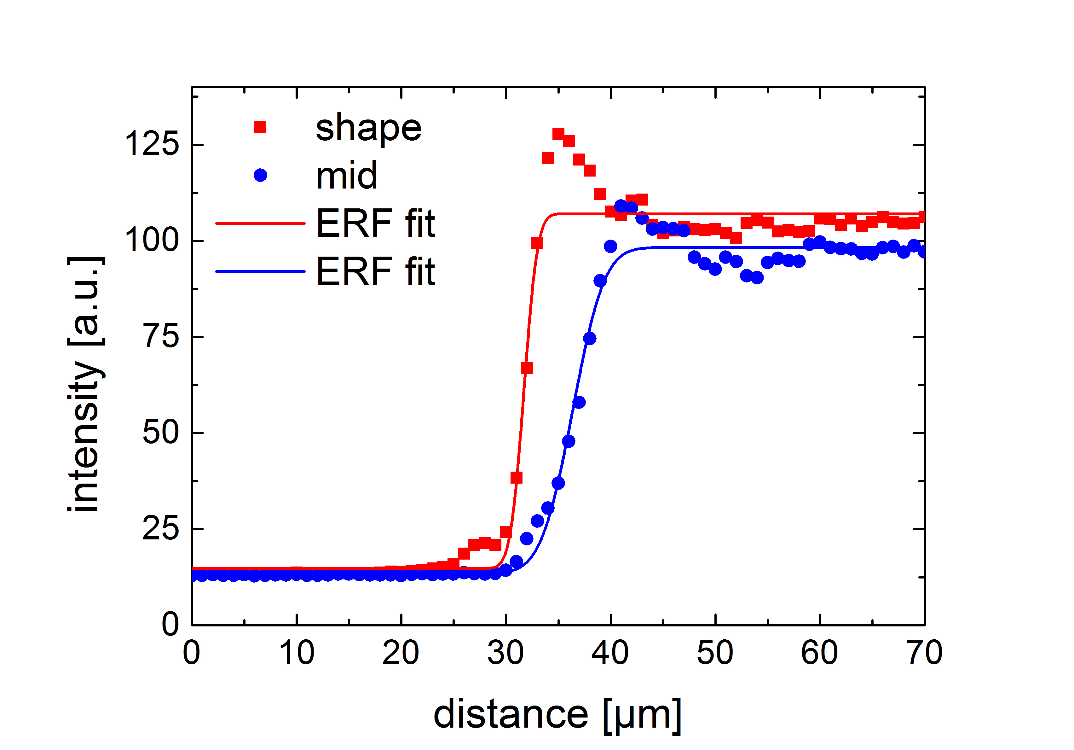
FOM/erf.jpg
