CarolineMuellenbroich/Giovanni-goes-Giorgio/FOM/m0.71offset.jpg

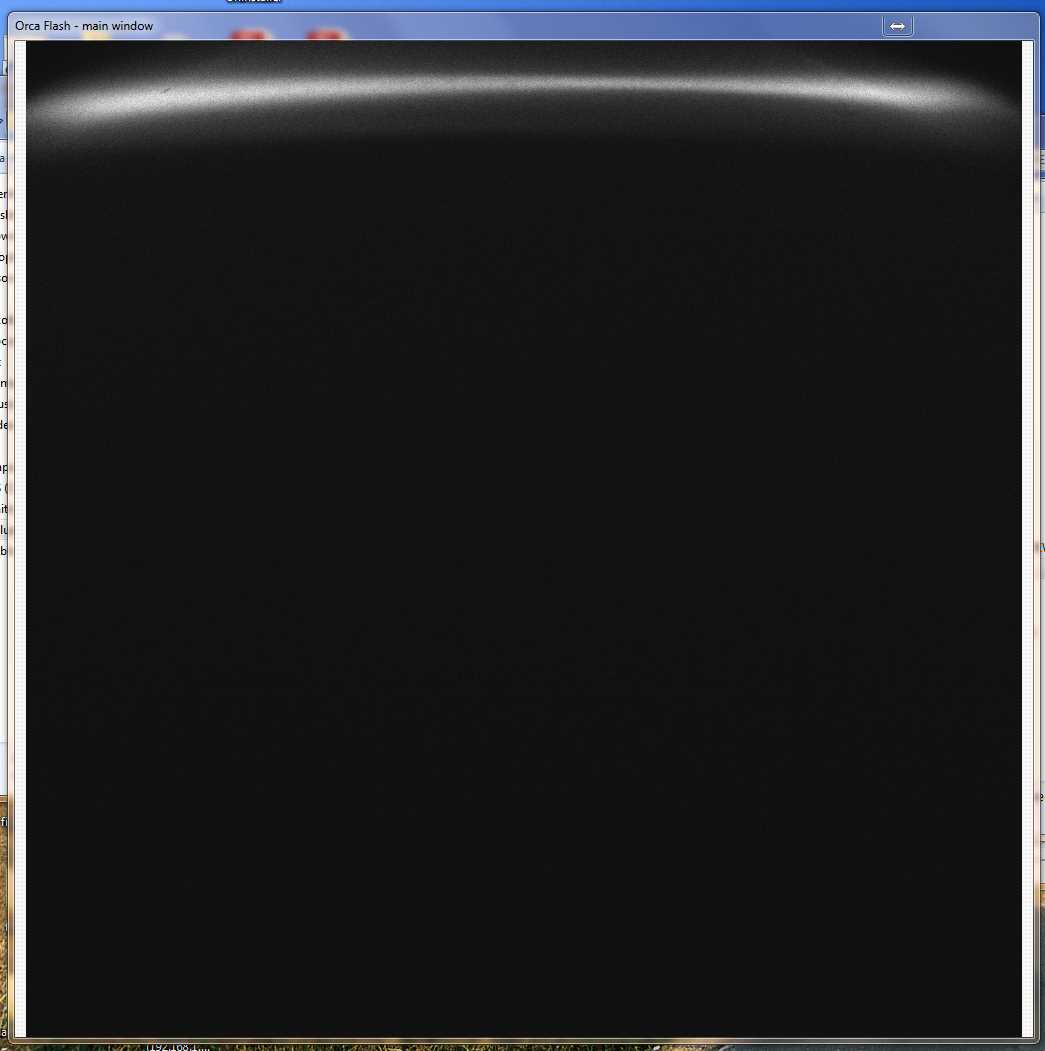
FOM/m0.71offset.jpg
