CarolineMuellenbroich/Giovanni-goes-Giorgio/FOM/MAX_Stack.jpg

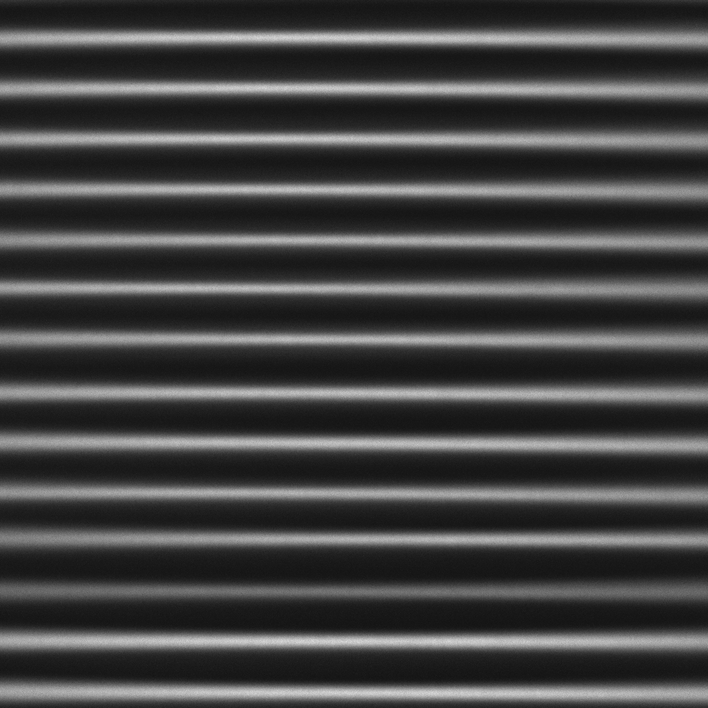
FOM/MAX_Stack.jpg
