CarolineMuellenbroich/Giovanni-goes-Giorgio/FOM/New folder/Screen Shot 03-12-15 at 03.28 PM.PNG

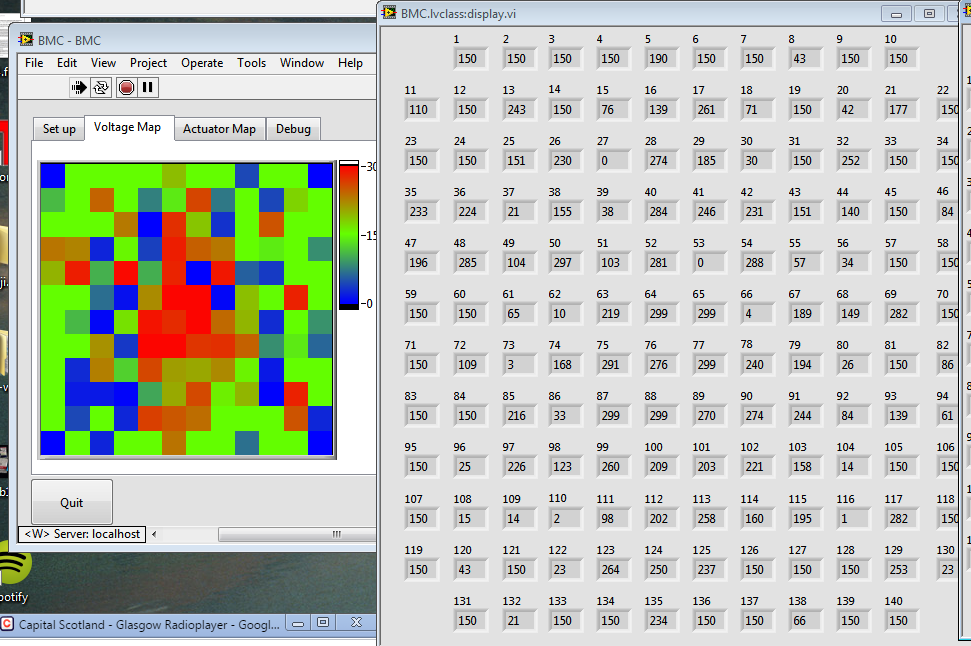
FOM/New folder/Screen Shot 03-12-15 at 03.28 PM.PNG
