CarolineMuellenbroich/Giovanni-goes-Giorgio/FOM/New folder/Screen Shot 03-12-15 at 03.29 PM.PNG

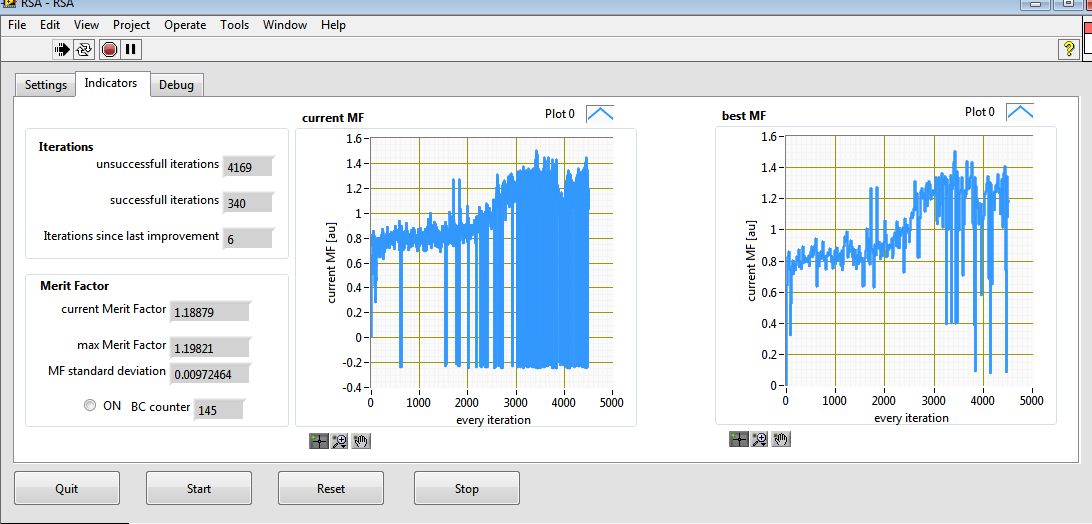
FOM/New folder/Screen Shot 03-12-15 at 03.29 PM.PNG
