CarolineMuellenbroich/Giovanni-goes-Giorgio/FOM/origin_graph.jpg

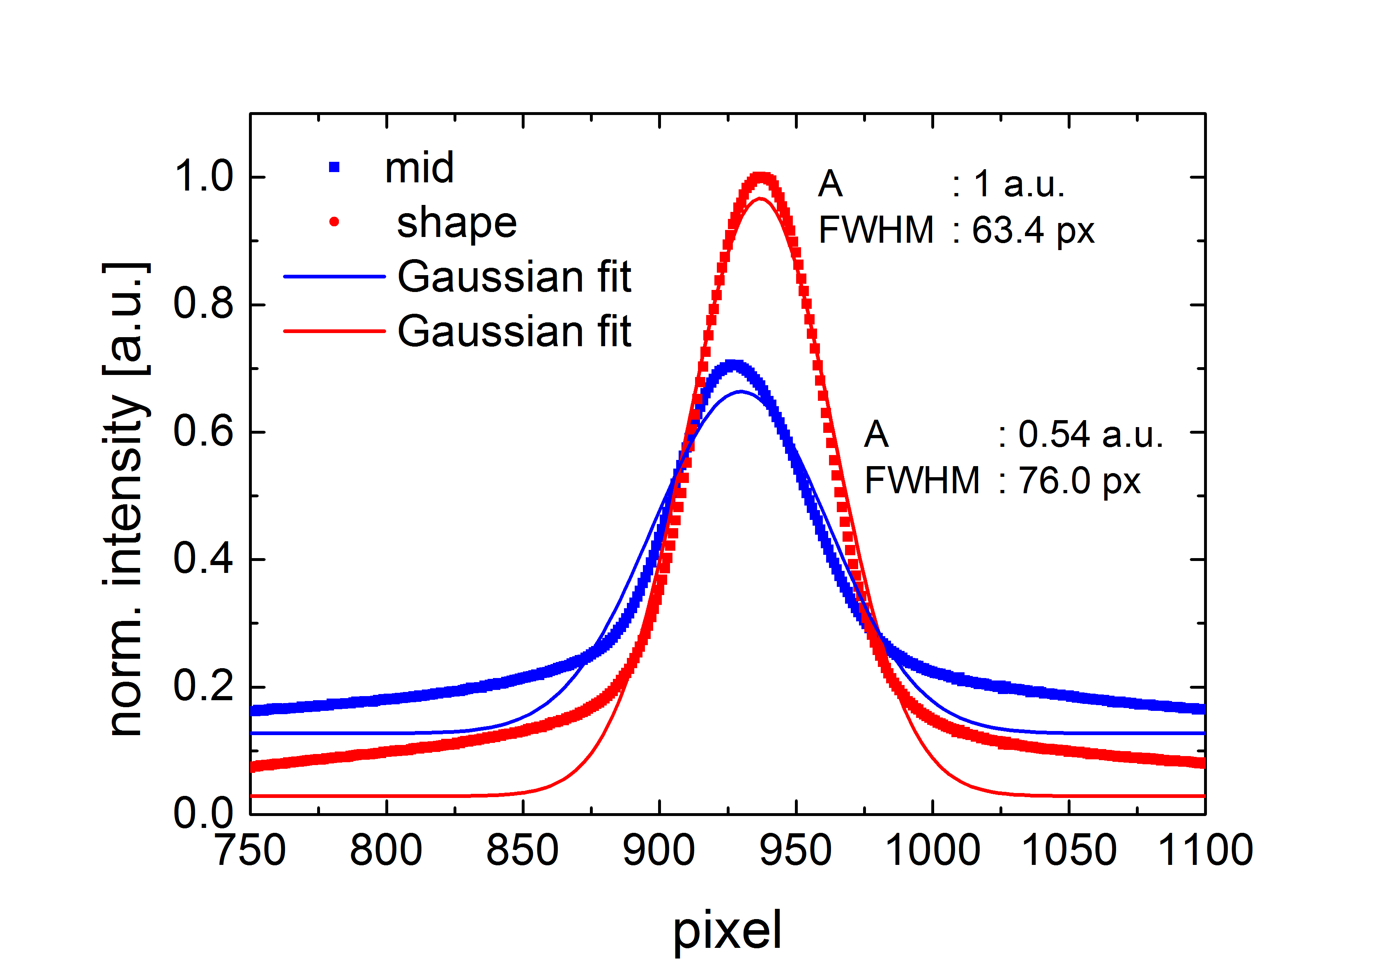
FOM/origin_graph.jpg
