CarolineMuellenbroich/Giovanni-goes-Giorgio/FOM/Picture1.png

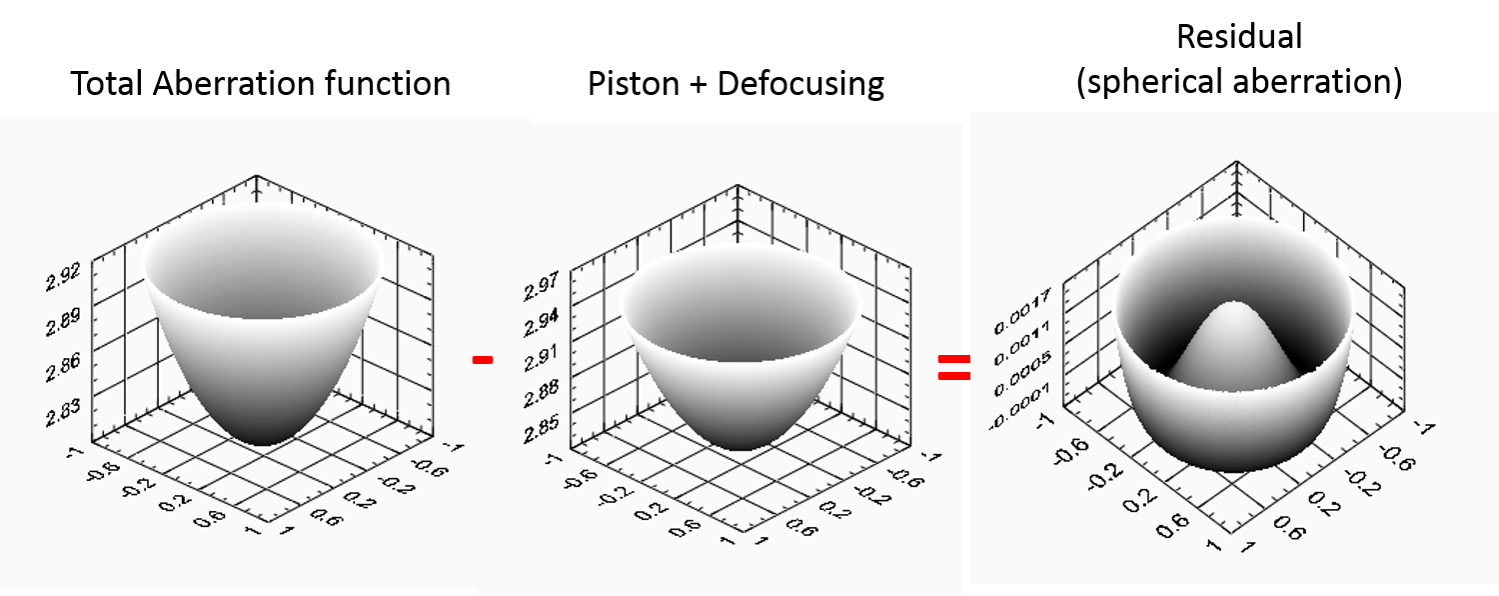
FOM/Picture1.png
