CarolineMuellenbroich/Giovanni-goes-Giorgio/FOM/RSA.png

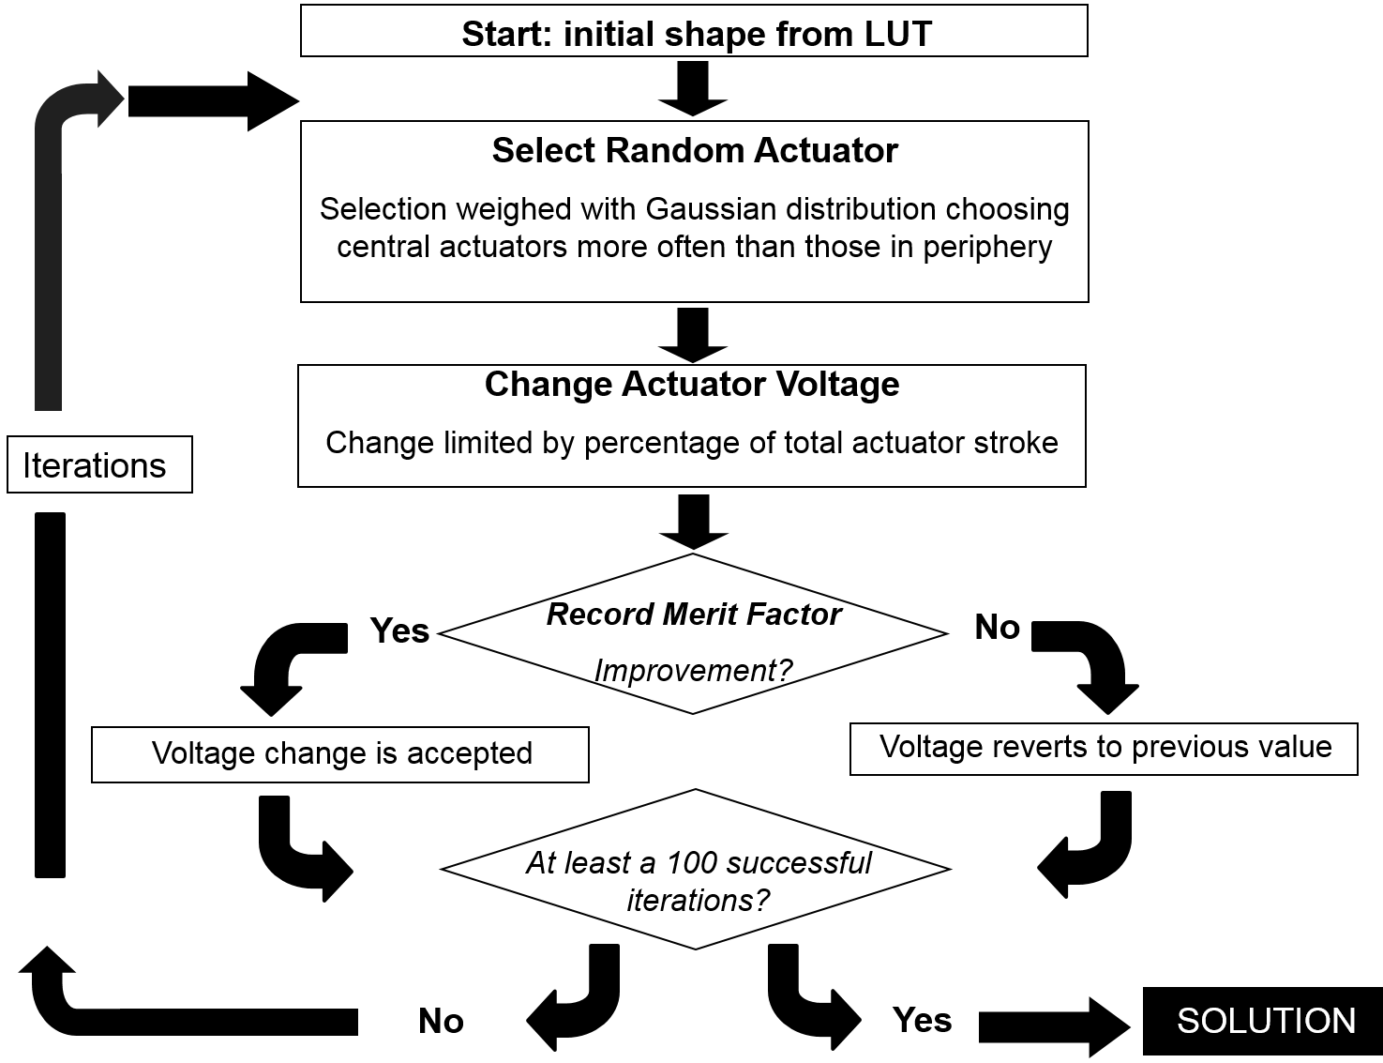
FOM/RSA.png
