CarolineMuellenbroich/Giovanni-goes-Giorgio/FOM/sample_prep.png

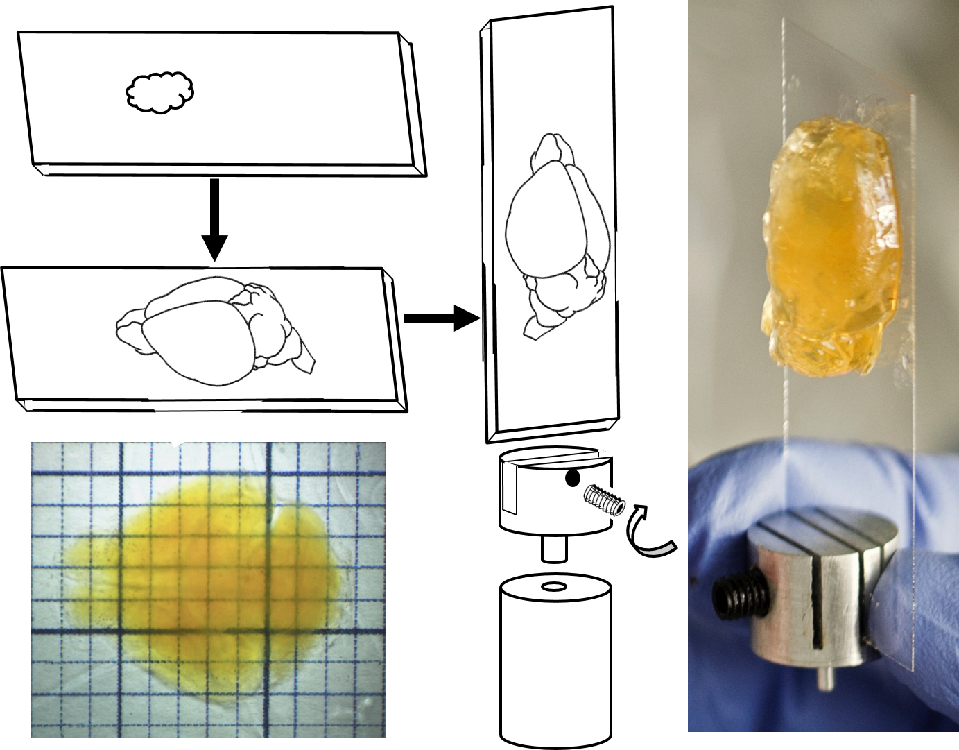
FOM/sample_prep.png
