CarolineMuellenbroich/Giovanni-goes-Giorgio/FOM/Screen Shot 03-10-15 at 08.42 AM.PNG

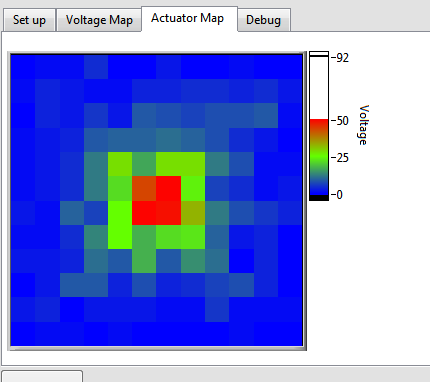
FOM/Screen Shot 03-10-15 at 08.42 AM.PNG
