CarolineMuellenbroich/Giovanni-goes-Giorgio/FOM/Screen Shot 03-25-15 at 05.44 PM.PNG

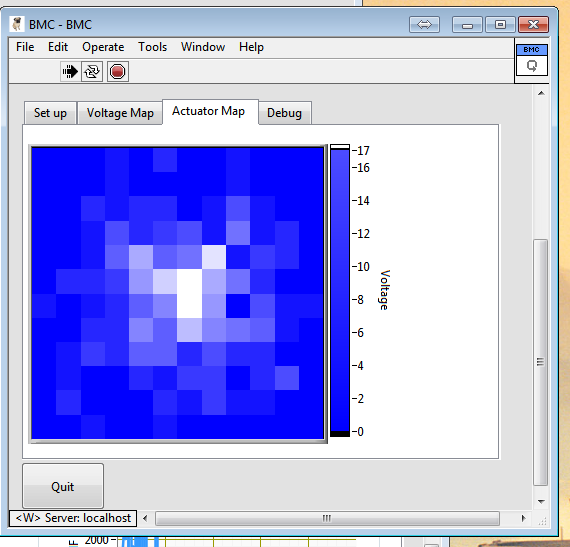
FOM/Screen Shot 03-25-15 at 05.44 PM.PNG
