CarolineMuellenbroich/Giovanni-goes-Giorgio/FOM/ScreenShot039.jpg

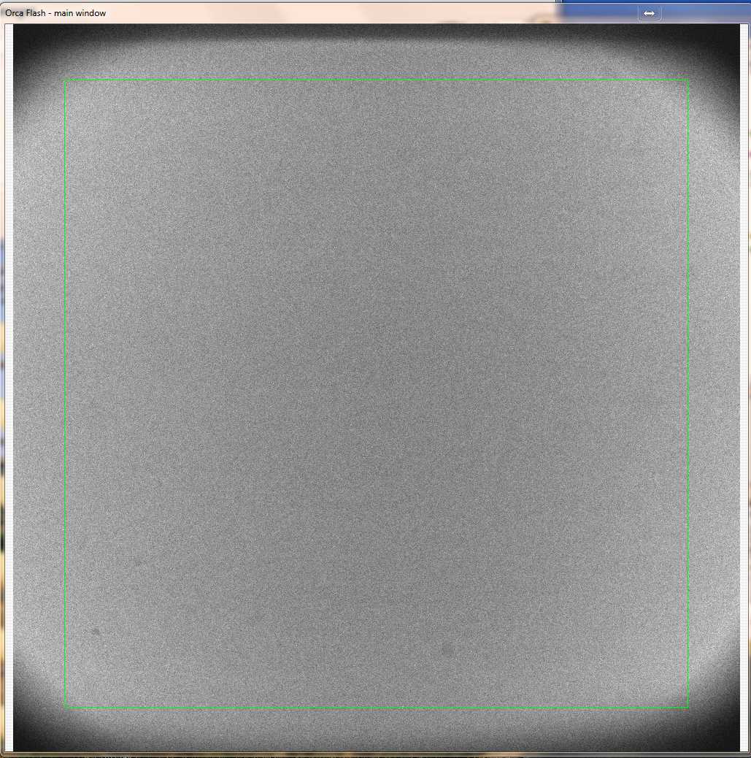
FOM/ScreenShot039.jpg
