CarolineMuellenbroich/Giovanni-goes-Giorgio/FOM/ScreenShot042.jpg

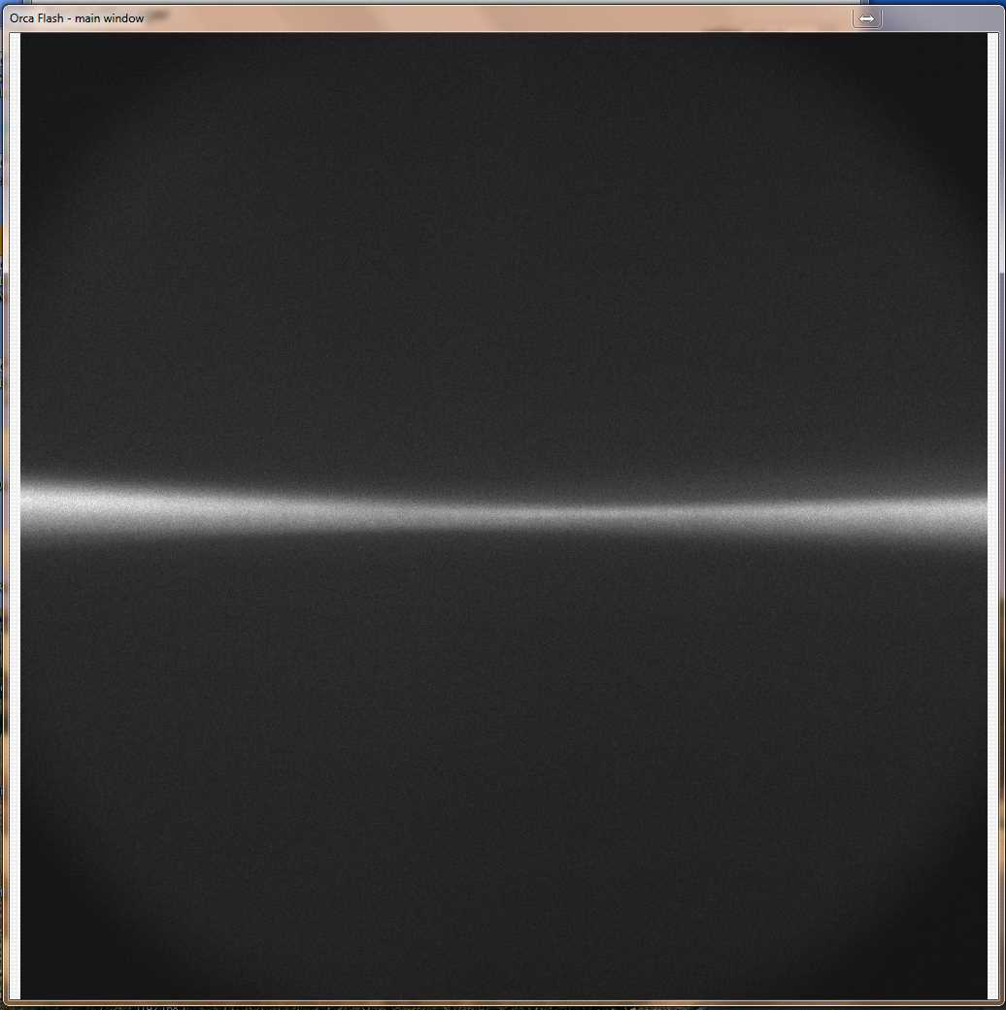
FOM/ScreenShot042.jpg
