CarolineMuellenbroich/Giovanni-goes-Giorgio/FOM/ScreenShot043.jpg

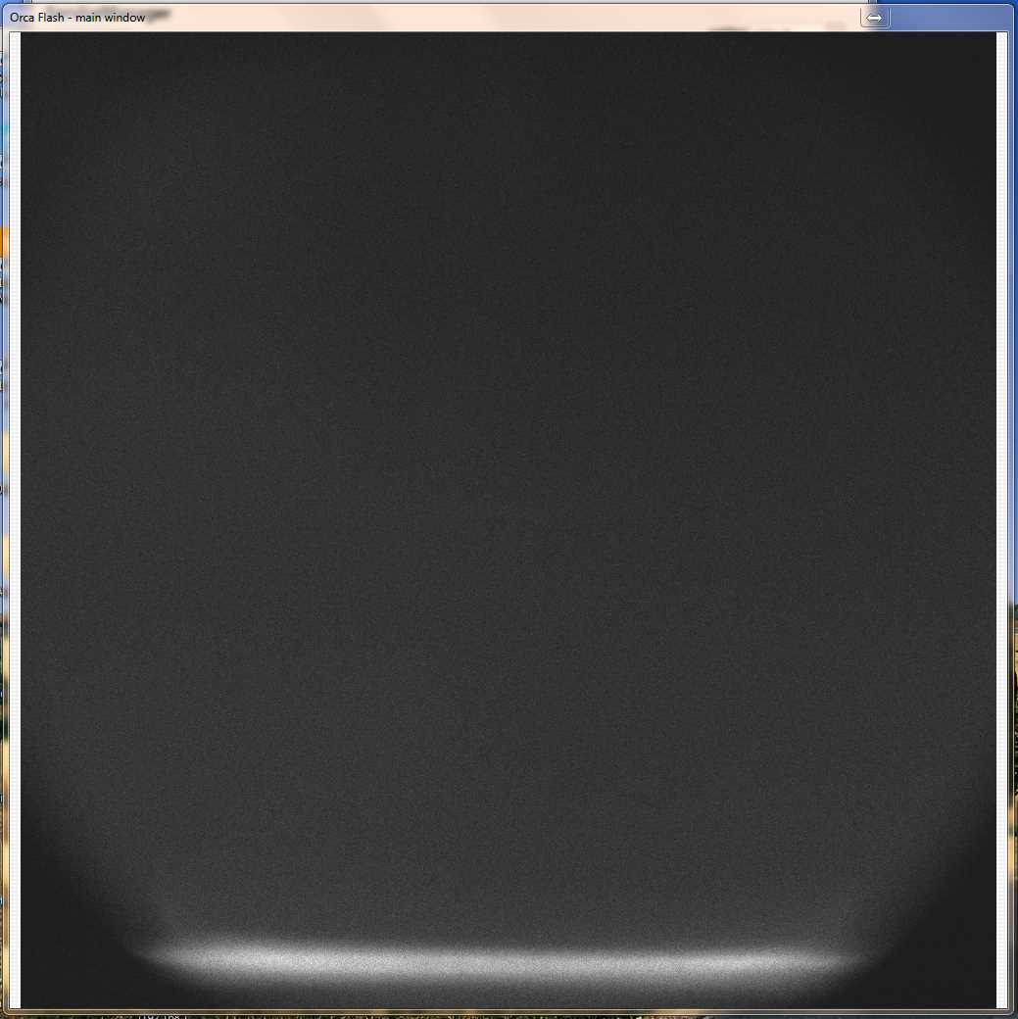
FOM/ScreenShot043.jpg
