CarolineMuellenbroich/Giovanni-goes-Giorgio/FOM/ScreenShot044.jpg

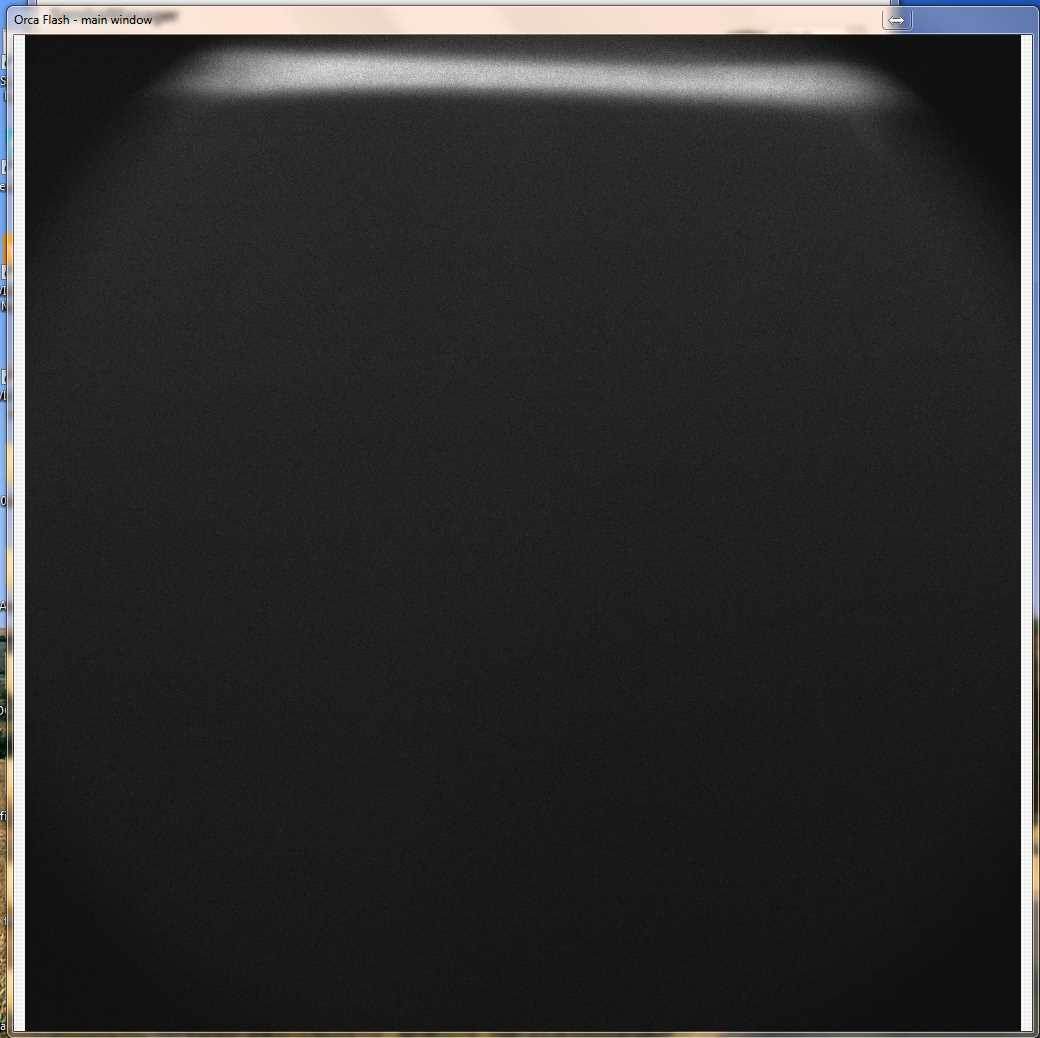
FOM/ScreenShot044.jpg
