CarolineMuellenbroich/Giovanni-goes-Giorgio/FOM/ScreenShot048.jpg

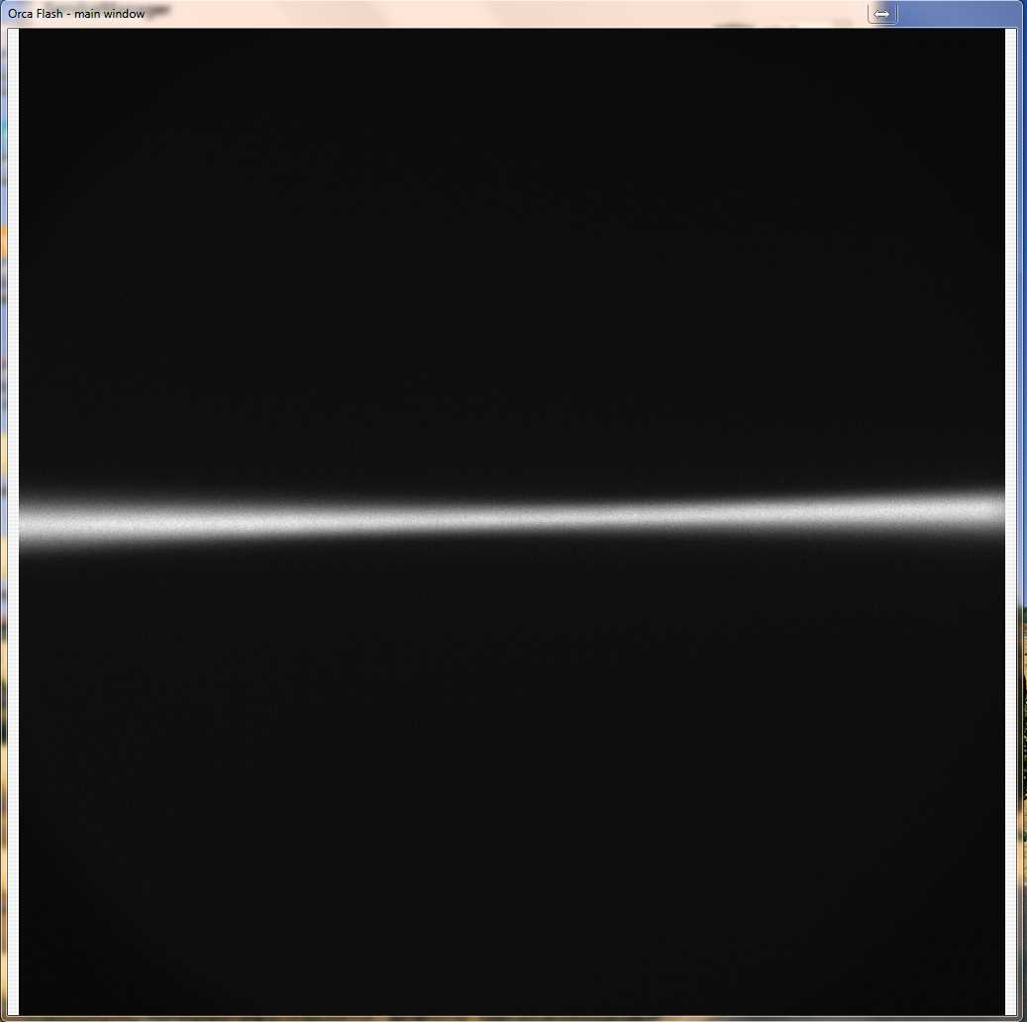
FOM/ScreenShot048.jpg
