CarolineMuellenbroich/Giovanni-goes-Giorgio/FOM/ScreenShot049.jpg

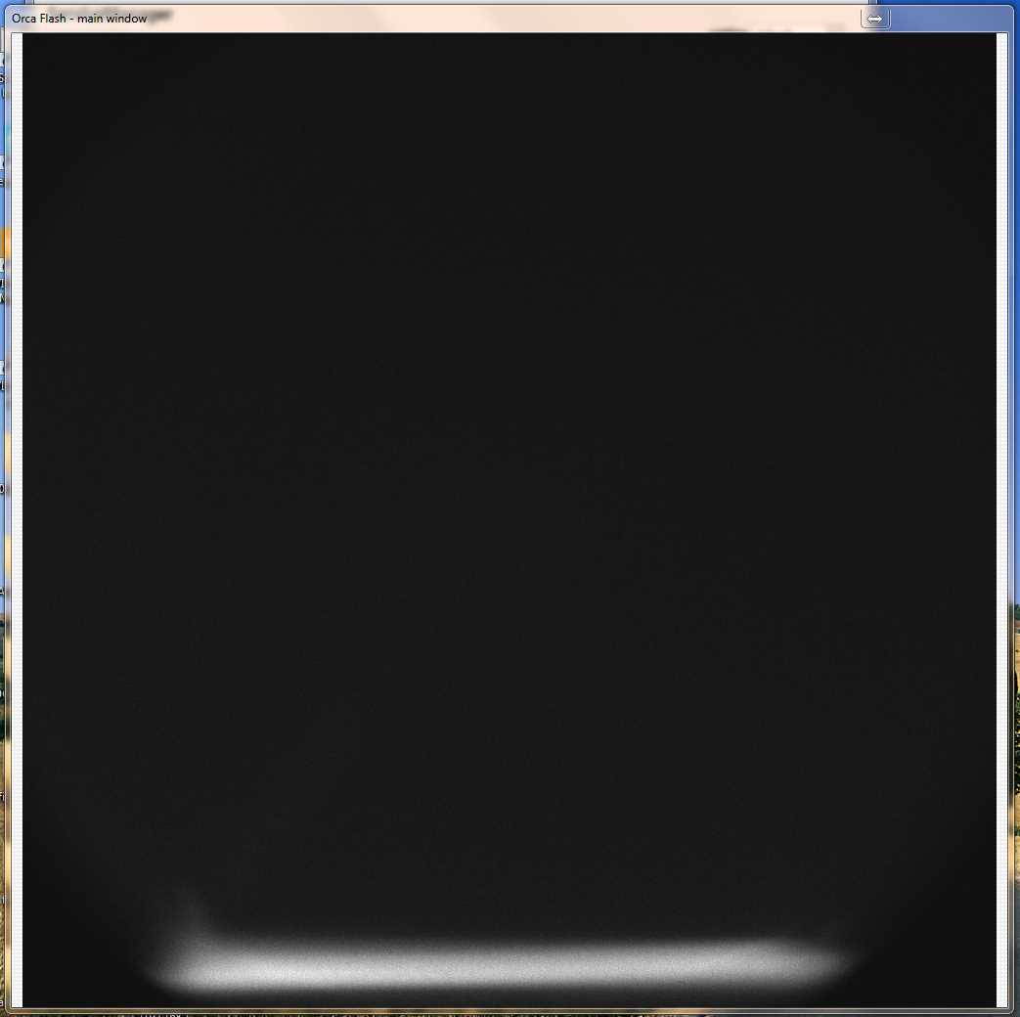
FOM/ScreenShot049.jpg
