CarolineMuellenbroich/Giovanni-goes-Giorgio/FOM/ScreenShot051.jpg

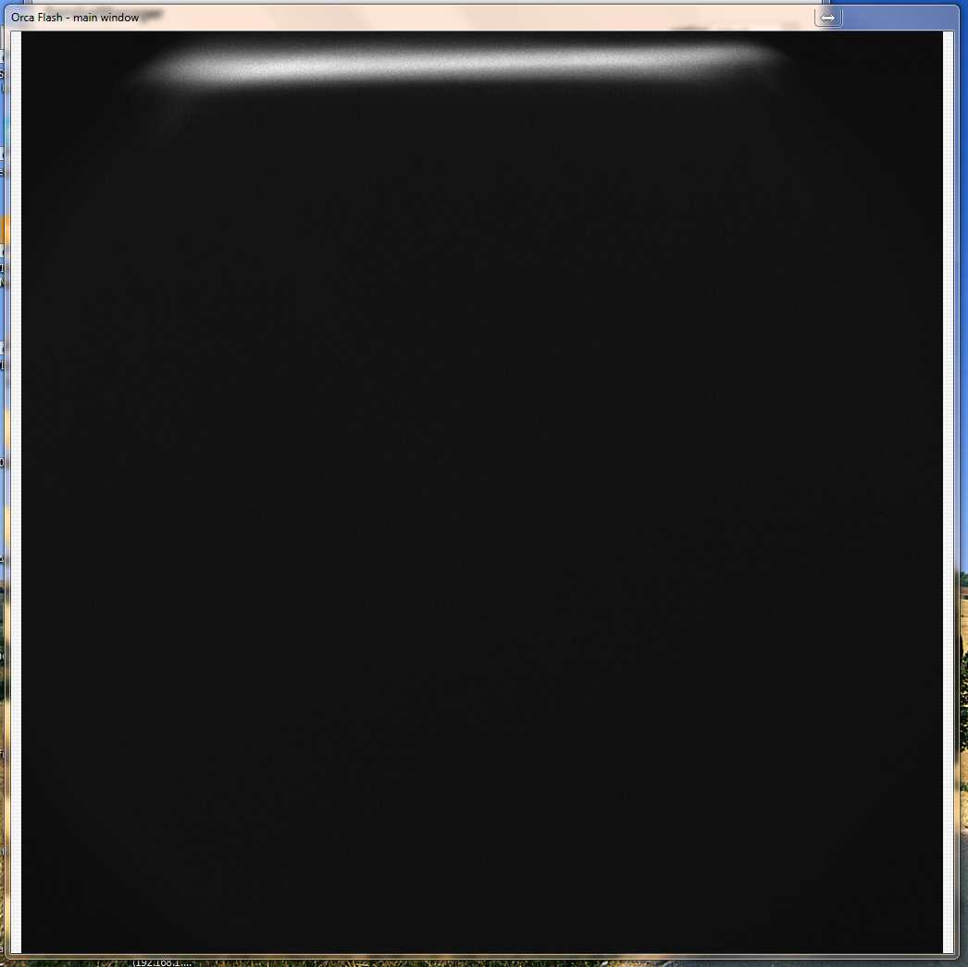
FOM/ScreenShot051.jpg
