CarolineMuellenbroich/Giovanni-goes-Giorgio/FOM/ScreenShot057.jpg

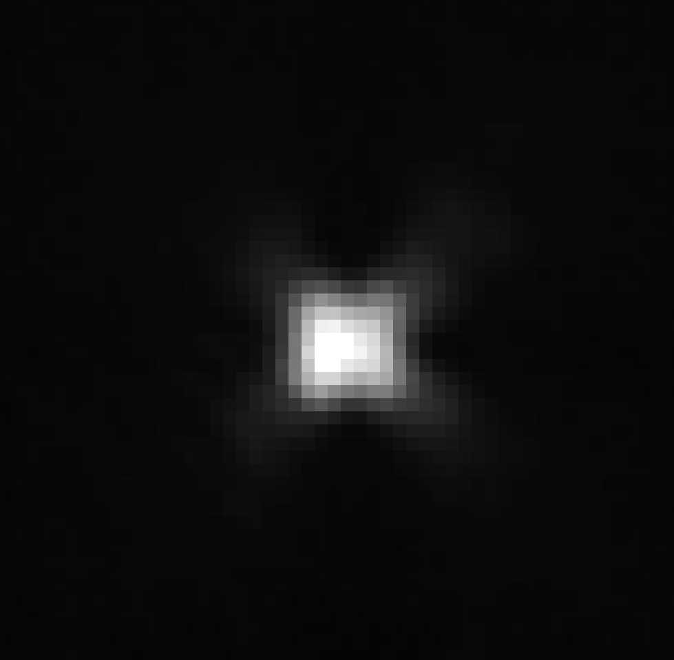
FOM/ScreenShot057.jpg
