CarolineMuellenbroich/Giovanni-goes-Giorgio/FOM/ScreenShot058.jpg

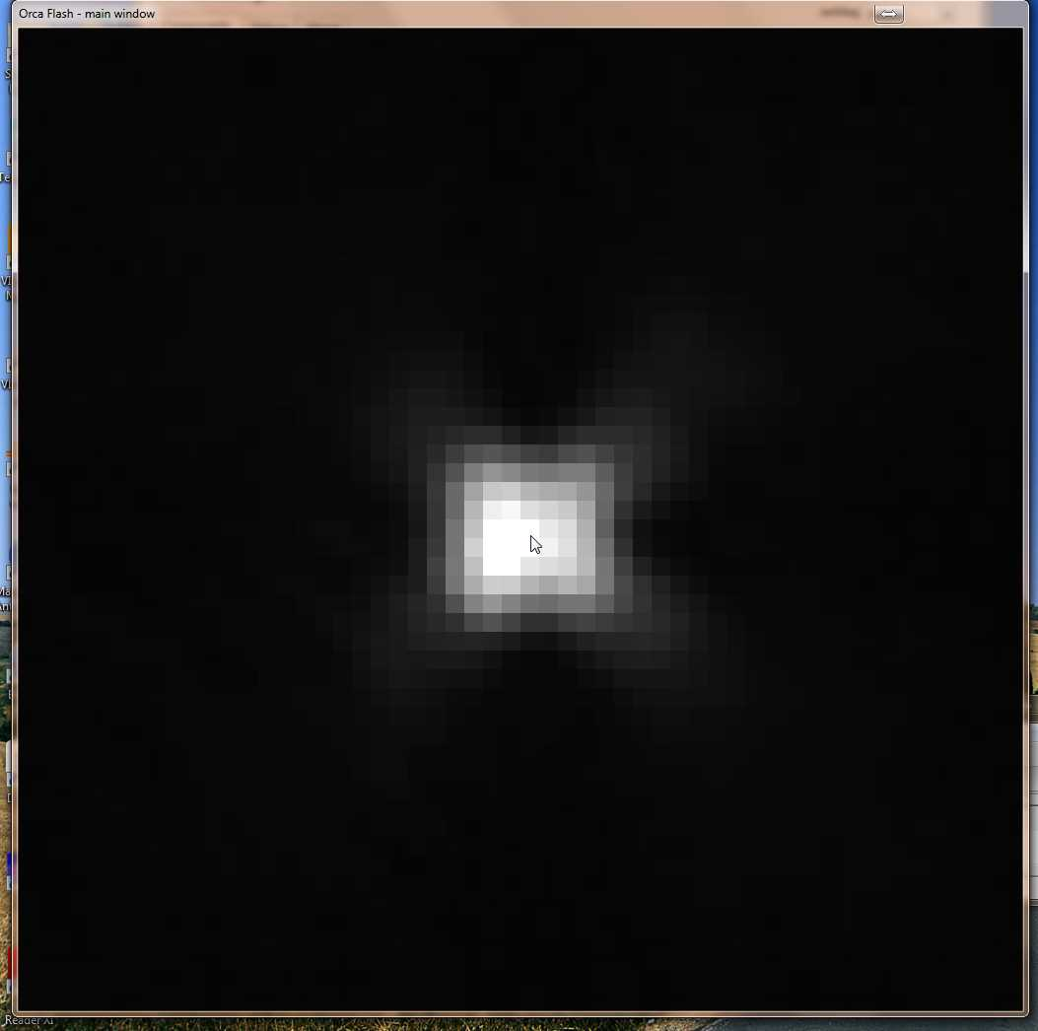
FOM/ScreenShot058.jpg
