CarolineMuellenbroich/Giovanni-goes-Giorgio/FOM/ScreenShot059.jpg

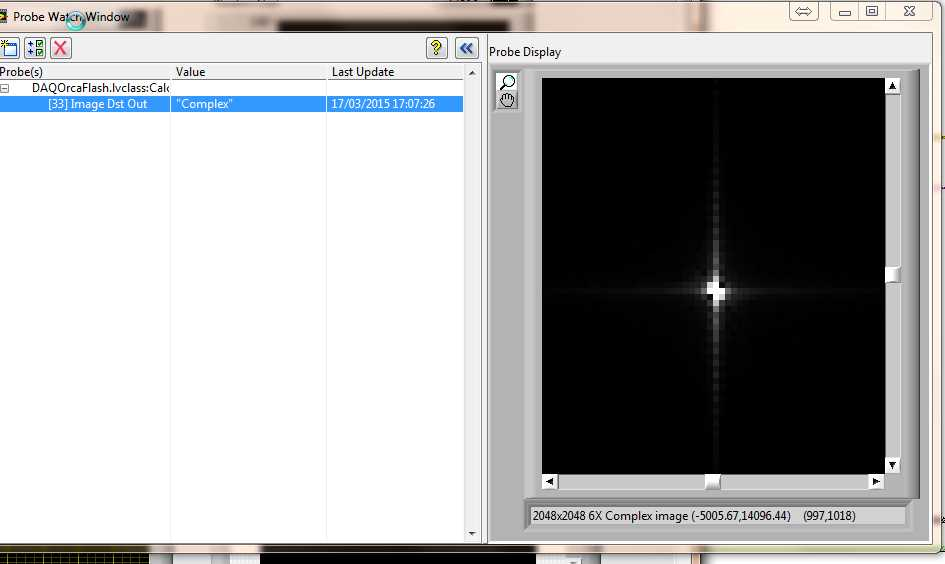
FOM/ScreenShot059.jpg
