CarolineMuellenbroich/Giovanni-goes-Giorgio/FOM/ScreenShot060.jpg

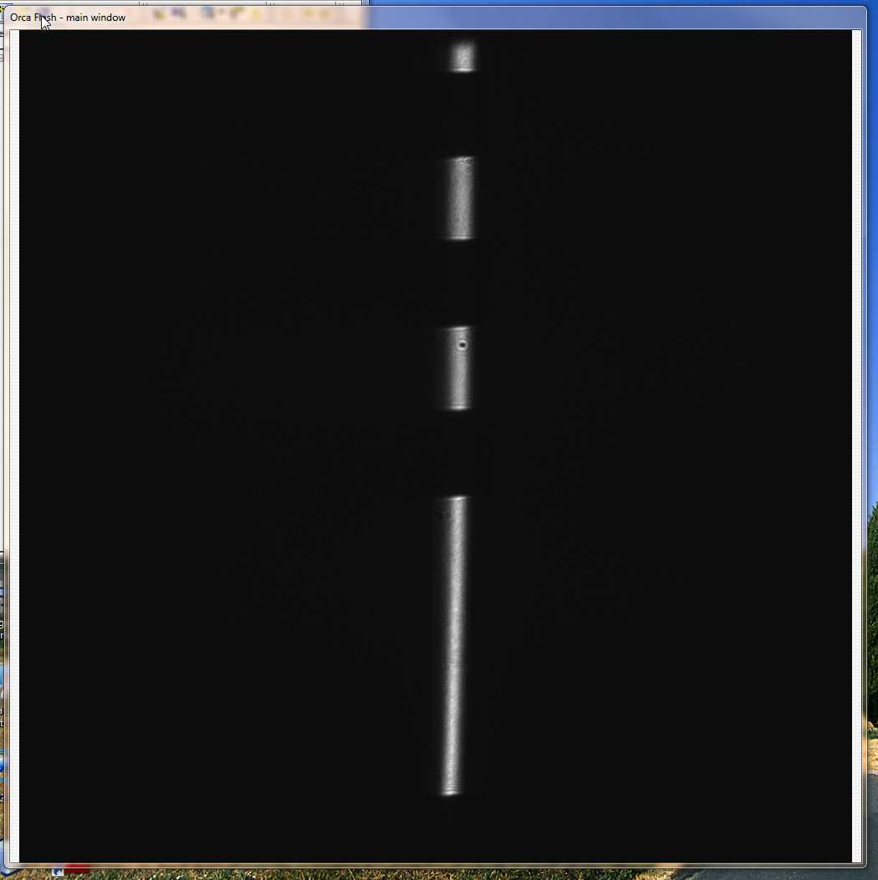
FOM/ScreenShot060.jpg
