CarolineMuellenbroich/Giovanni-goes-Giorgio/Neurophotonics/CAD/bla.jpg

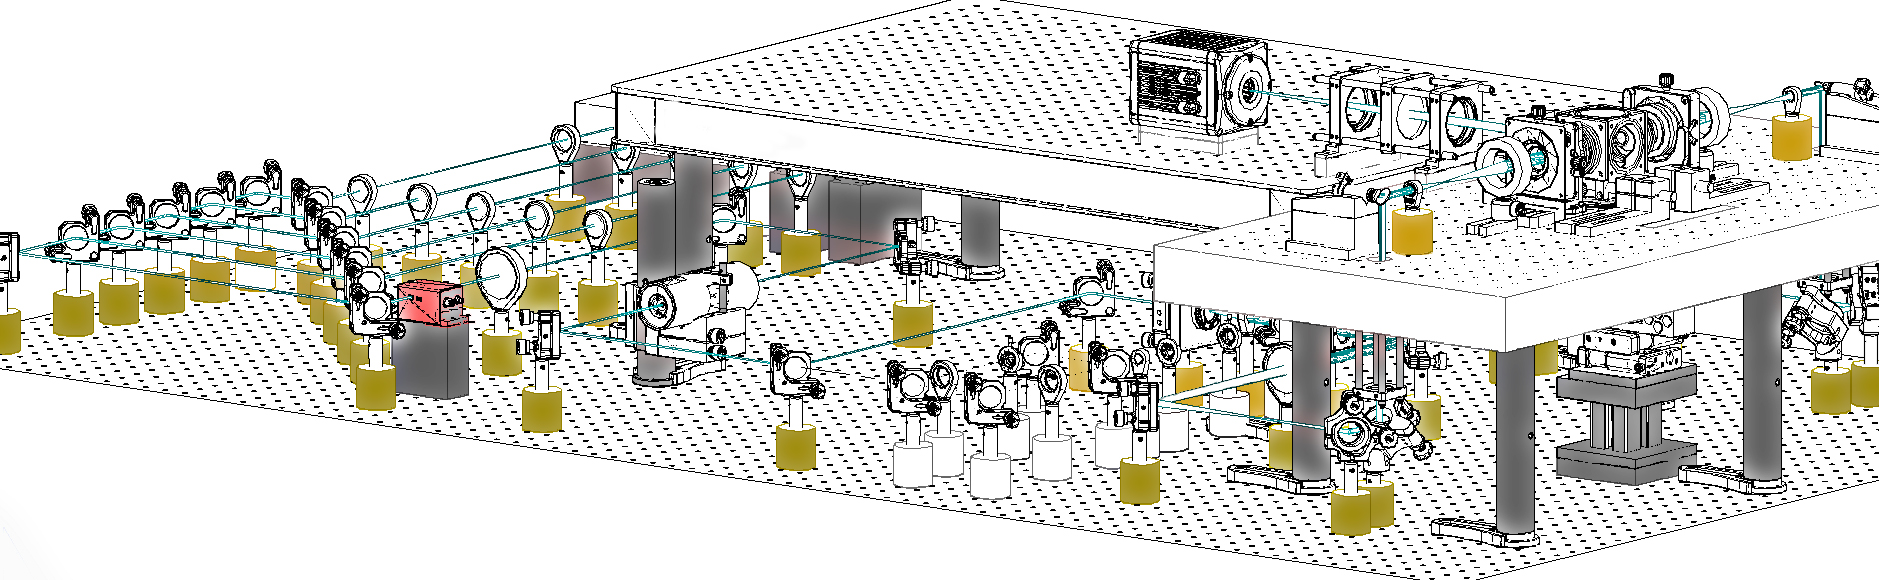
Neurophotonics/CAD/bla.jpg
