CarolineMuellenbroich/Giovanni-goes-Giorgio/Neurophotonics/CAD/CAD.png

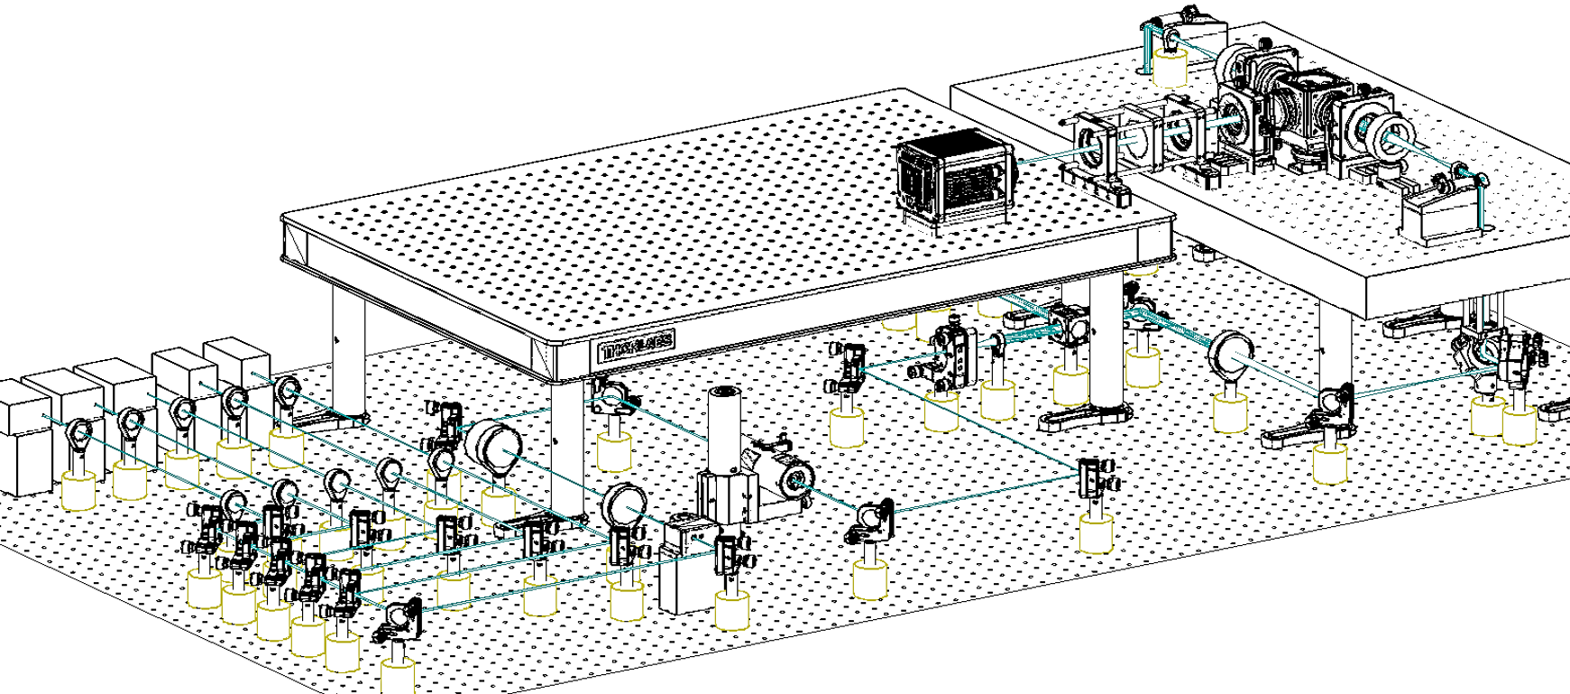
Neurophotonics/CAD/CAD.png
