CarolineMuellenbroich/Giovanni-goes-Giorgio/Neurophotonics/CAD/Screen Shot 01-07-15 at 12.56 PM.PNG

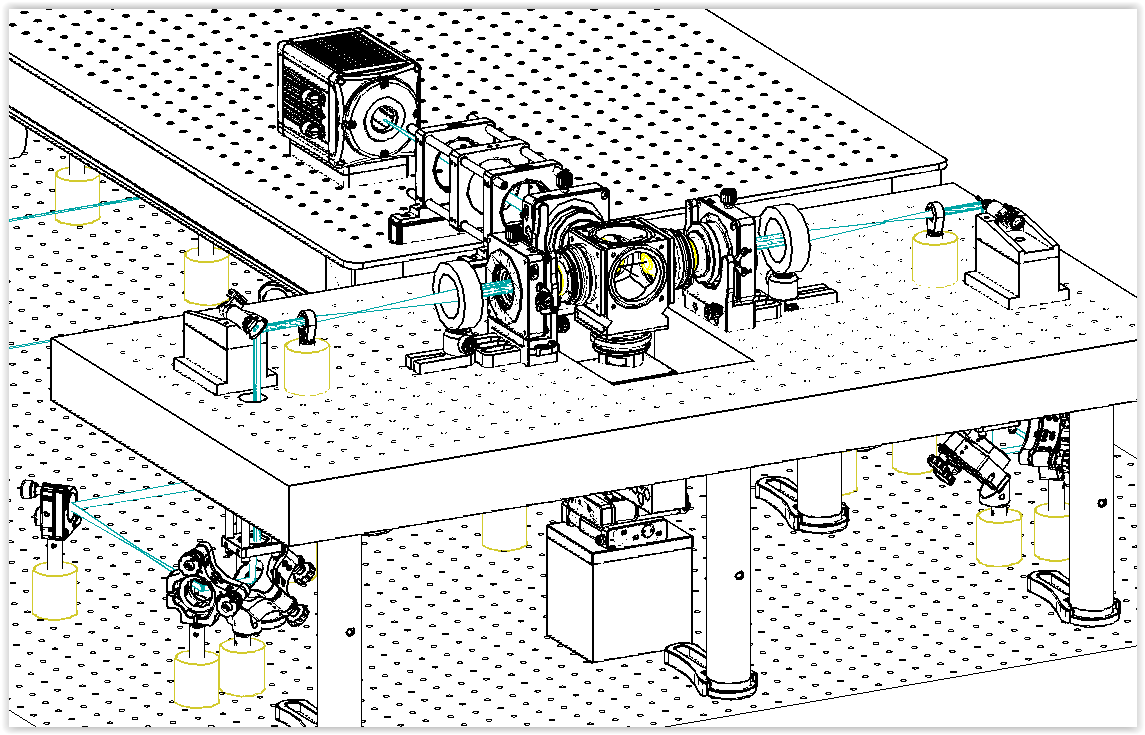
Neurophotonics/CAD/Screen Shot 01-07-15 at 12.56 PM.PNG
