CarolineMuellenbroich/Giovanni-goes-Giorgio/Neurophotonics/CAD/Screen Shot 01-08-15 at 02.33 PM.PNG

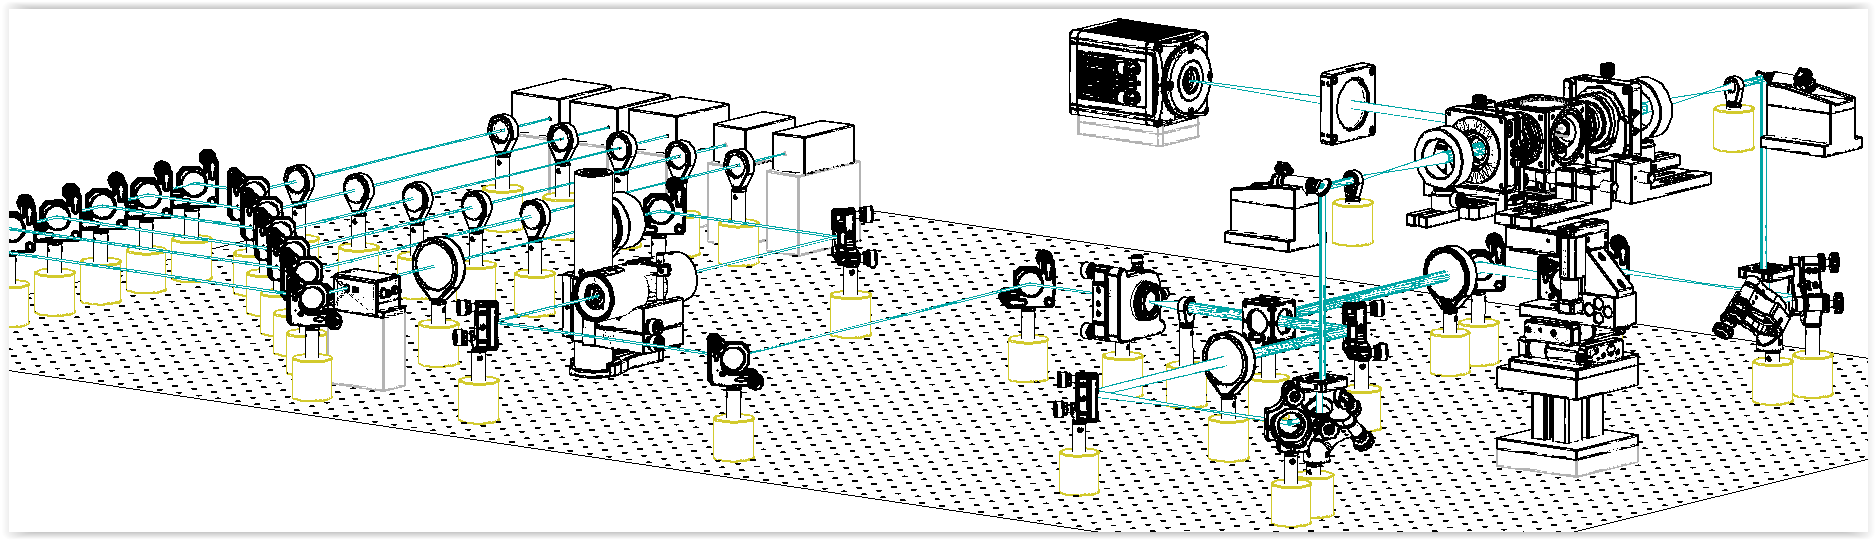
Neurophotonics/CAD/Screen Shot 01-08-15 at 02.33 PM.PNG
