CarolineMuellenbroich/Giovanni-goes-Giorgio/Neurophotonics/CAD/Screen Shot 01-09-15 at 11.52 AM.PNG

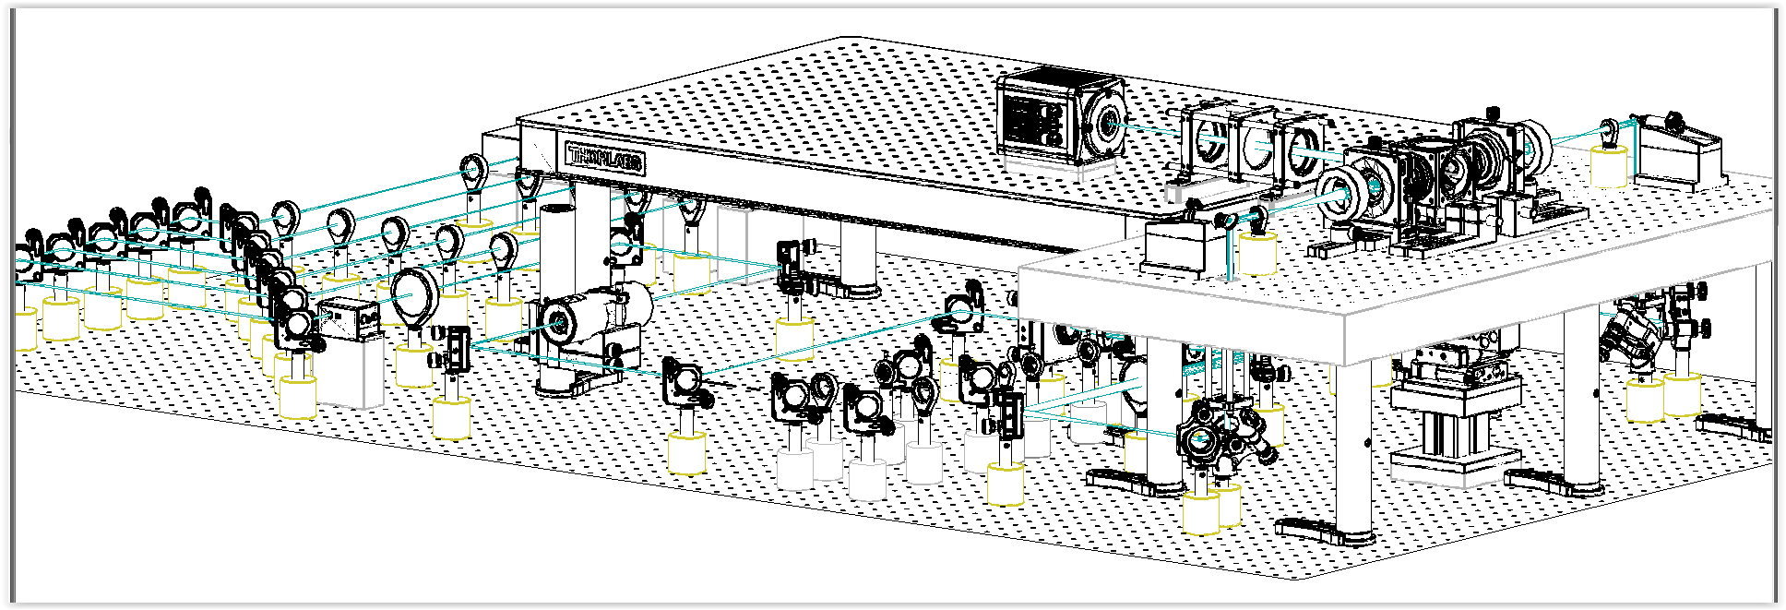
Neurophotonics/CAD/Screen Shot 01-09-15 at 11.52 AM.PNG
