CarolineMuellenbroich/Giovanni-goes-Giorgio/Neurophotonics/CAD/Screen Shot 01-09-15 at 12.16 PM.PNG

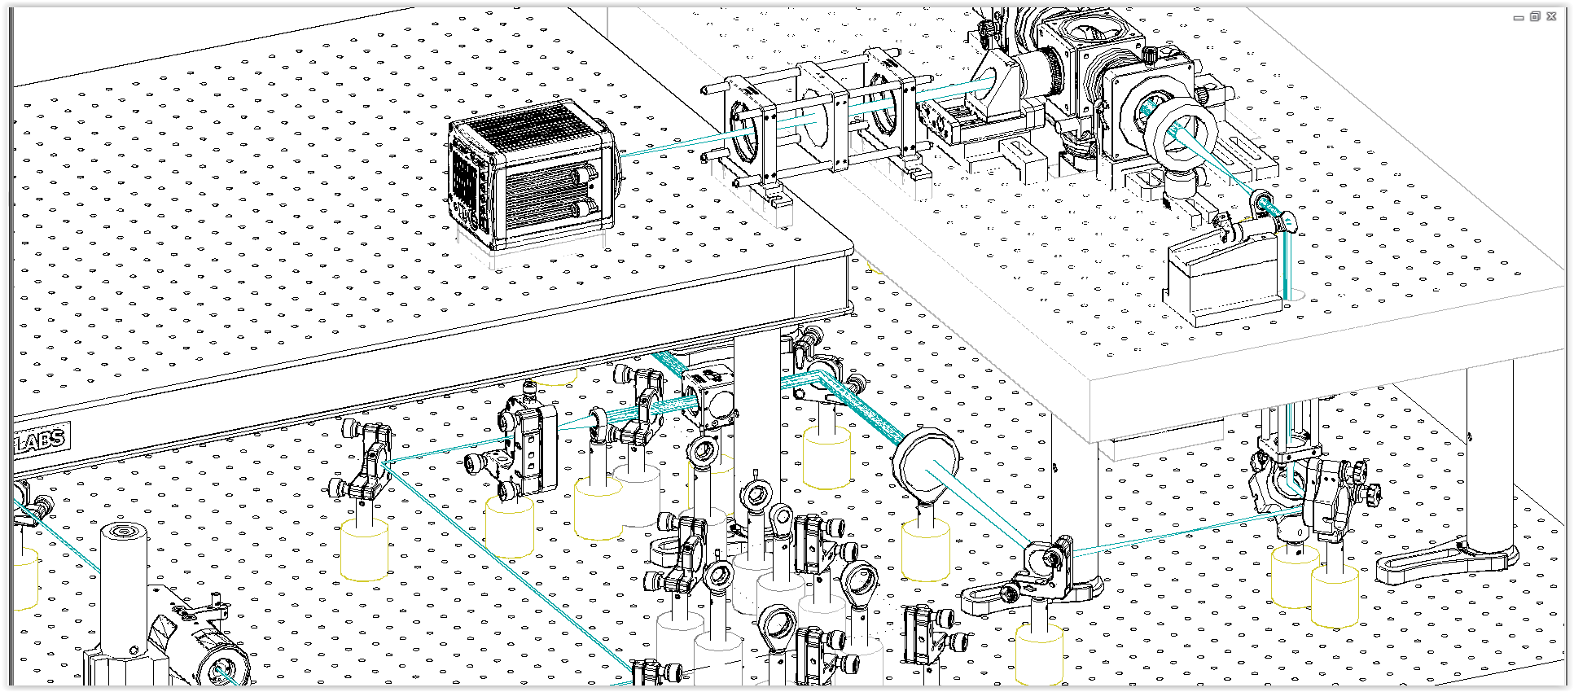
Neurophotonics/CAD/Screen Shot 01-09-15 at 12.16 PM.PNG
