CarolineMuellenbroich/Giovanni-goes-Giorgio/Neurophotonics/CAD/ScreenShot013.jpg

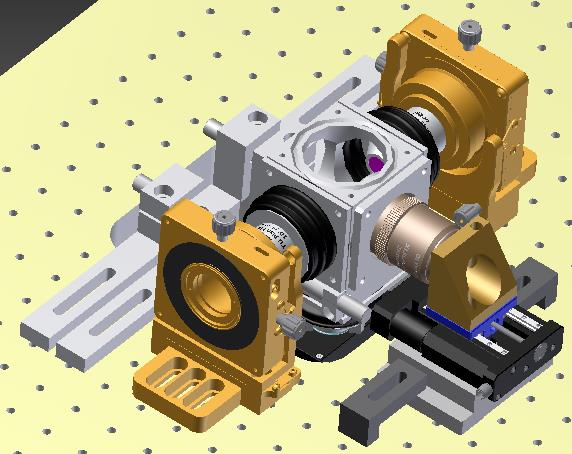
Neurophotonics/CAD/ScreenShot013.jpg
