CarolineMuellenbroich/Giovanni-goes-Giorgio/Neurophotonics/CAD/ScreenShot014.jpg

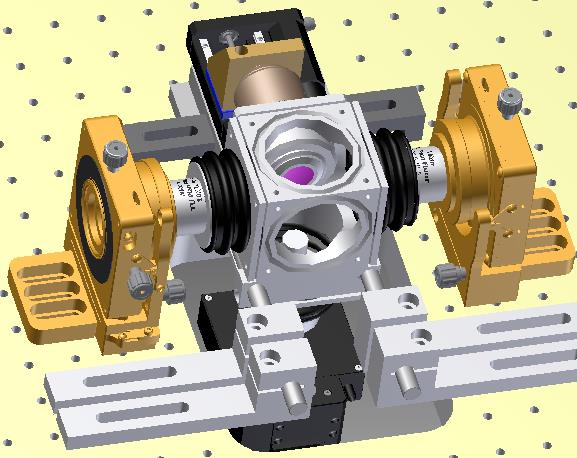
Neurophotonics/CAD/ScreenShot014.jpg
