CarolineMuellenbroich/Giovanni-goes-Giorgio/Neurophotonics/CAD/ScreenShot015.jpg

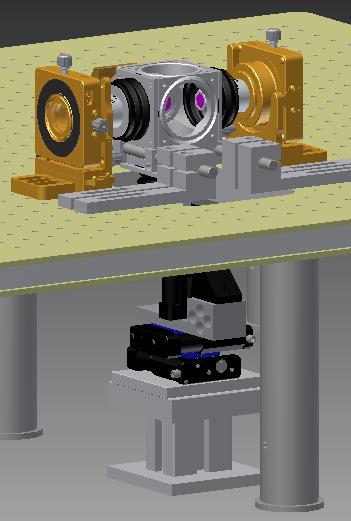
Neurophotonics/CAD/ScreenShot015.jpg
