CarolineMuellenbroich/Giovanni-goes-Giorgio/Neurophotonics/CAD/ScreenShot016.jpg

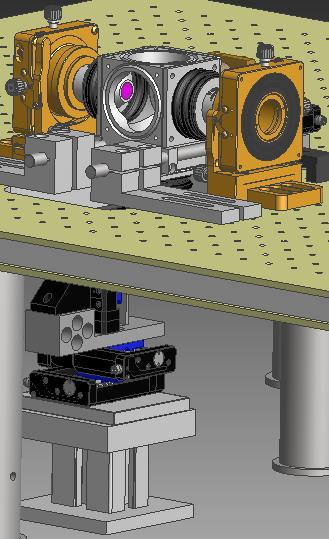
Neurophotonics/CAD/ScreenShot016.jpg
