CarolineMuellenbroich/Giovanni-goes-Giorgio/Neurophotonics/CAD/ScreenShot017.jpg

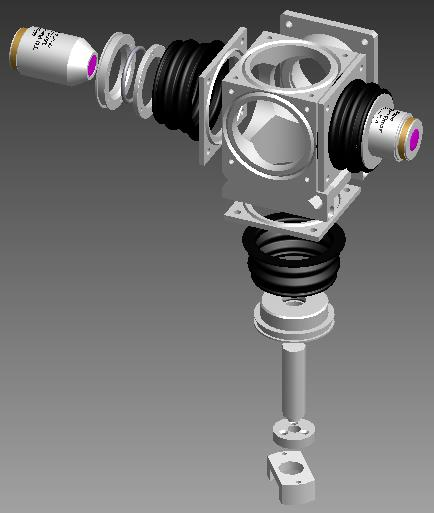
Neurophotonics/CAD/ScreenShot017.jpg
