CarolineMuellenbroich/Giovanni-goes-Giorgio/Neurophotonics/CAD/ScreenShot018.jpg

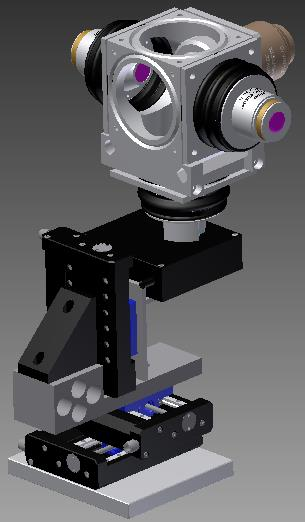
Neurophotonics/CAD/ScreenShot018.jpg
