CarolineMuellenbroich/Giovanni-goes-Giorgio/Neurophotonics/CAD/ScreenShot019.jpg

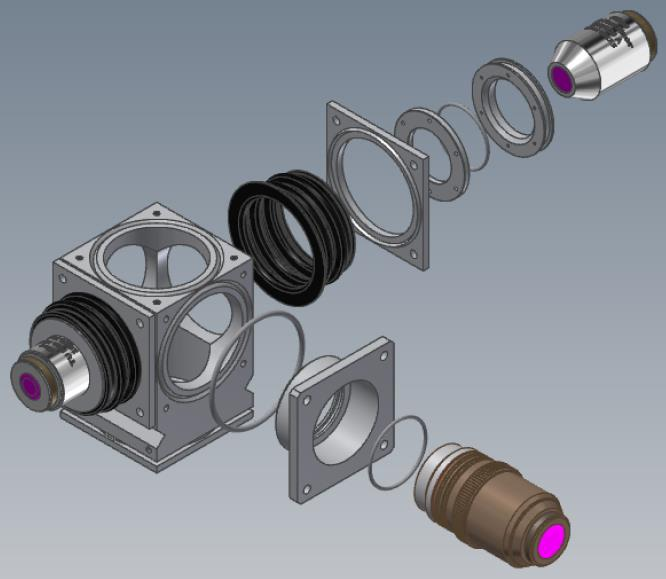
Neurophotonics/CAD/ScreenShot019.jpg
