CarolineMuellenbroich/Giovanni-goes-Giorgio/Neurophotonics/CAD/table.jpg

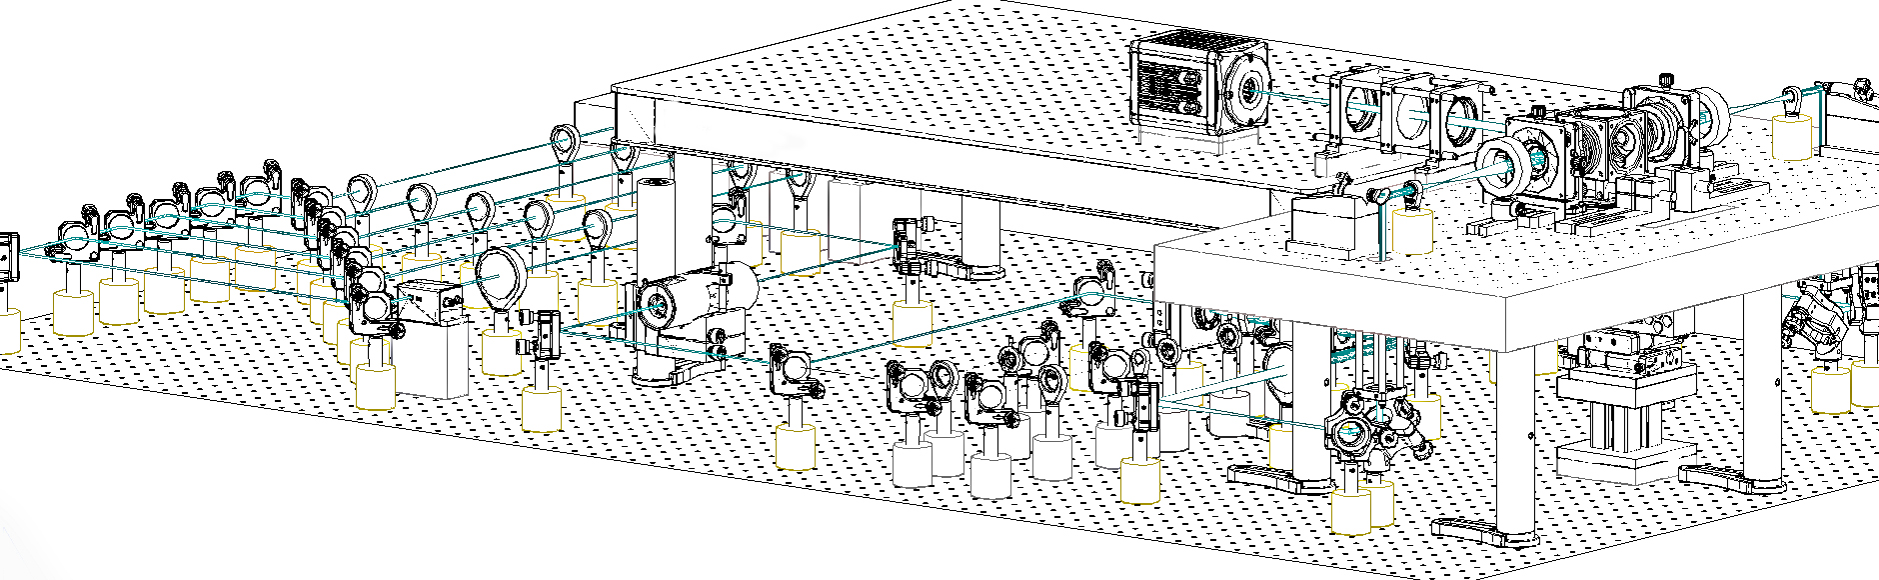
Neurophotonics/CAD/table.jpg
