CarolineMuellenbroich/Giovanni-goes-Giorgio/Neurophotonics/Images/8738_v2.jpg.jpg

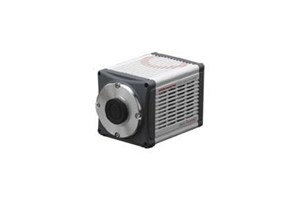
Neurophotonics/Images/8738_v2.jpg.jpg
