CarolineMuellenbroich/Giovanni-goes-Giorgio/Neurophotonics/Images/20121417304469209.png

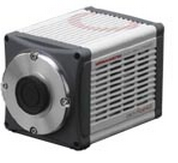
Neurophotonics/Images/20121417304469209.png
