CarolineMuellenbroich/Giovanni-goes-Giorgio/Neurophotonics/Images/AOTFnC.jpg

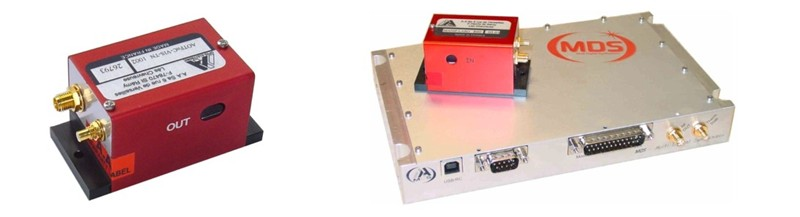
Neurophotonics/Images/AOTFnC.jpg
