CarolineMuellenbroich/Giovanni-goes-Giorgio/Neurophotonics/Images/AOTFnCxx_medium.jpg

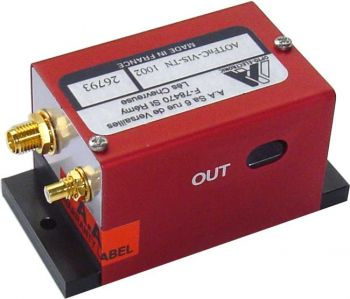
Neurophotonics/Images/AOTFnCxx_medium.jpg
