CarolineMuellenbroich/Giovanni-goes-Giorgio/Neurophotonics/Images/Dell-Precision-T7600-right-630x814.jpg

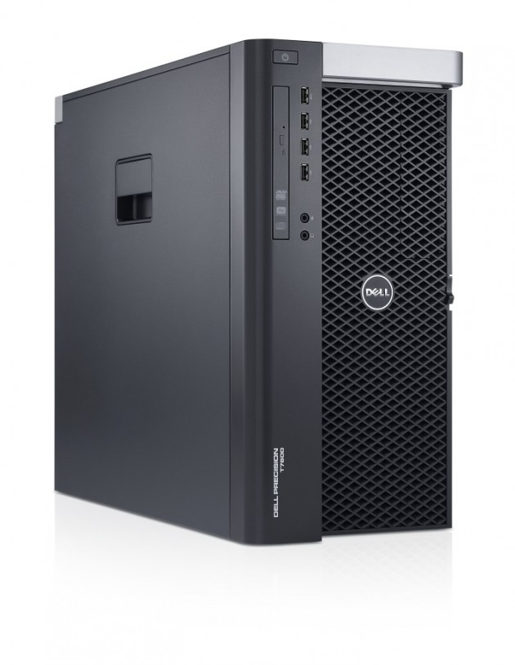
Neurophotonics/Images/Dell-Precision-T7600-right-630x814.jpg
