CarolineMuellenbroich/Giovanni-goes-Giorgio/Neurophotonics/Images/Figuur12b.jpg

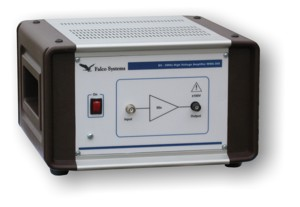
Neurophotonics/Images/Figuur12b.jpg
