CarolineMuellenbroich/Giovanni-goes-Giorgio/Neurophotonics/Images/galvanometer-36210-2629203.jpg

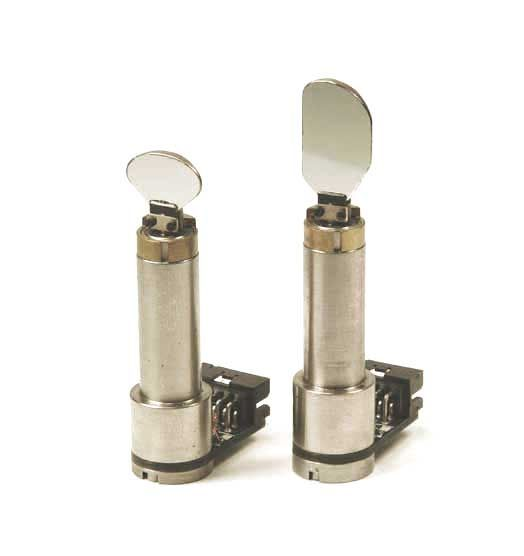
Neurophotonics/Images/galvanometer-36210-2629203.jpg
