CarolineMuellenbroich/Giovanni-goes-Giorgio/Neurophotonics/Images/ICUSB2328I.main.jpg

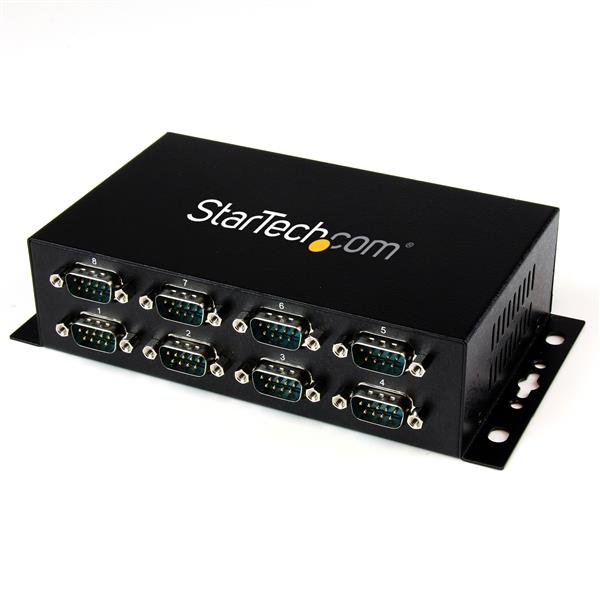
Neurophotonics/Images/ICUSB2328I.main.jpg
