CarolineMuellenbroich/Giovanni-goes-Giorgio/Neurophotonics/Images/im-li-1a.jpg

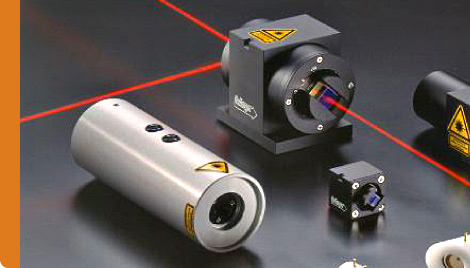
Neurophotonics/Images/im-li-1a.jpg
