CarolineMuellenbroich/Giovanni-goes-Giorgio/Neurophotonics/Images/img11366050.jpg

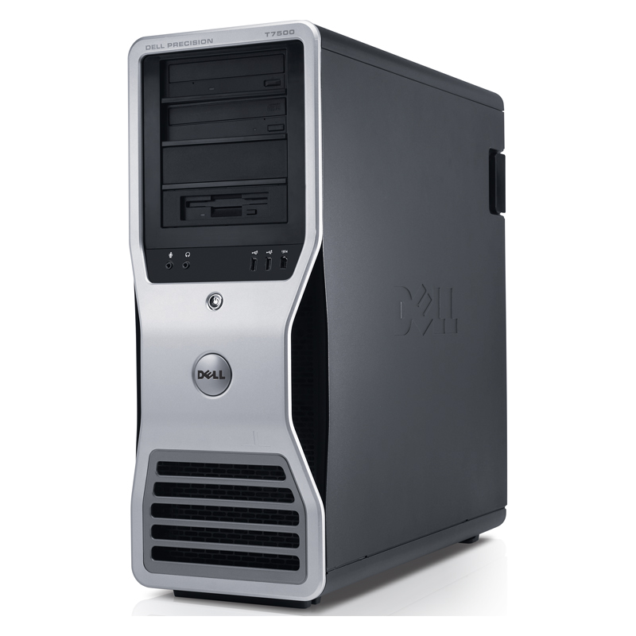
Neurophotonics/Images/img11366050.jpg
