CarolineMuellenbroich/Giovanni-goes-Giorgio/Neurophotonics/Images/moving-magnet-galvanometers-for-optical-scanners-29527-5124651.jpg

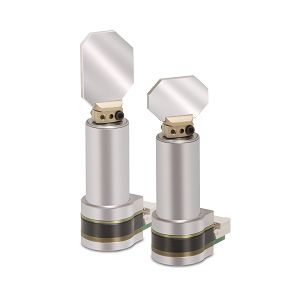
Neurophotonics/Images/moving-magnet-galvanometers-for-optical-scanners-29527-5124651.jpg
