CarolineMuellenbroich/Giovanni-goes-Giorgio/Neurophotonics/Images/TS-1079Pro_02.jpg

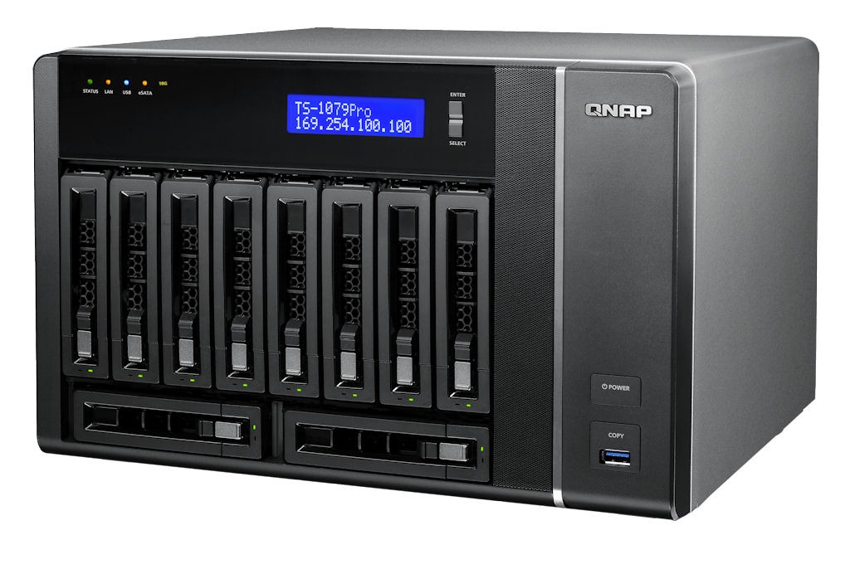
Neurophotonics/Images/TS-1079Pro_02.jpg
