CarolineMuellenbroich/Giovanni-goes-Giorgio/Neurophotonics/Images/UK_LNS_modulators_PI_C.jpg

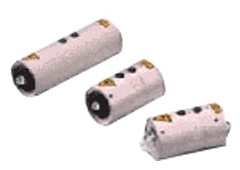
Neurophotonics/Images/UK_LNS_modulators_PI_C.jpg
