CarolineMuellenbroich/Giovanni-goes-Giorgio/Neurophotonics/inkscaping/DLSFM.png

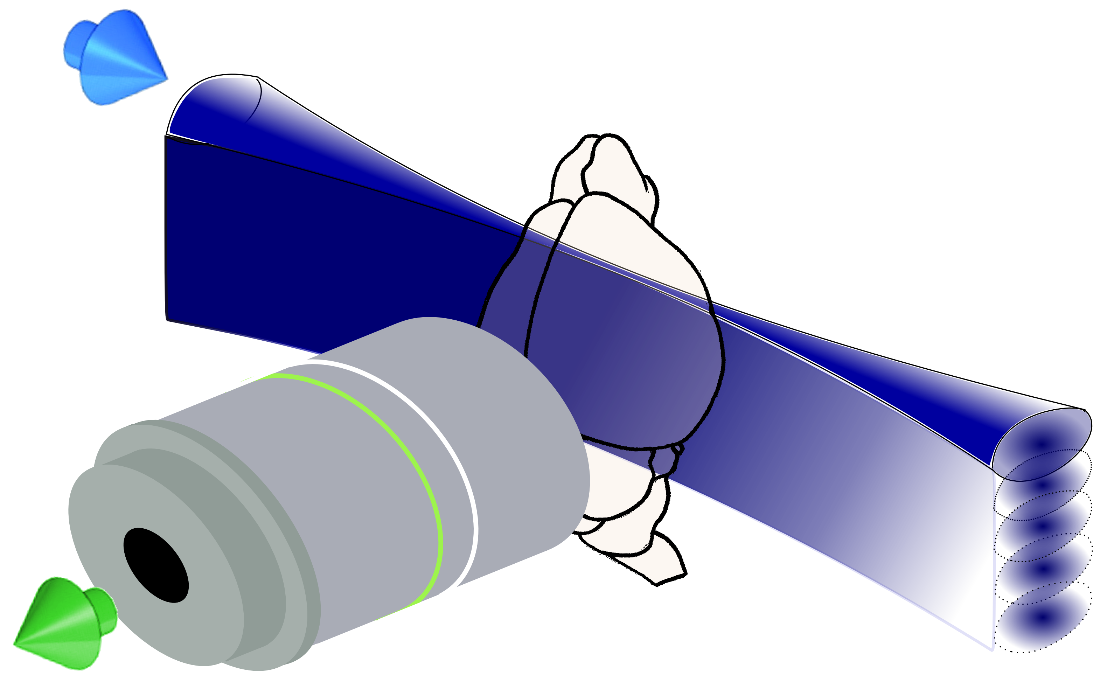
Neurophotonics/inkscaping/DLSFM.png
