CarolineMuellenbroich/Giovanni-goes-Giorgio/Neurophotonics/inkscaping/mouse_brain_cartoon_S_white_2.png

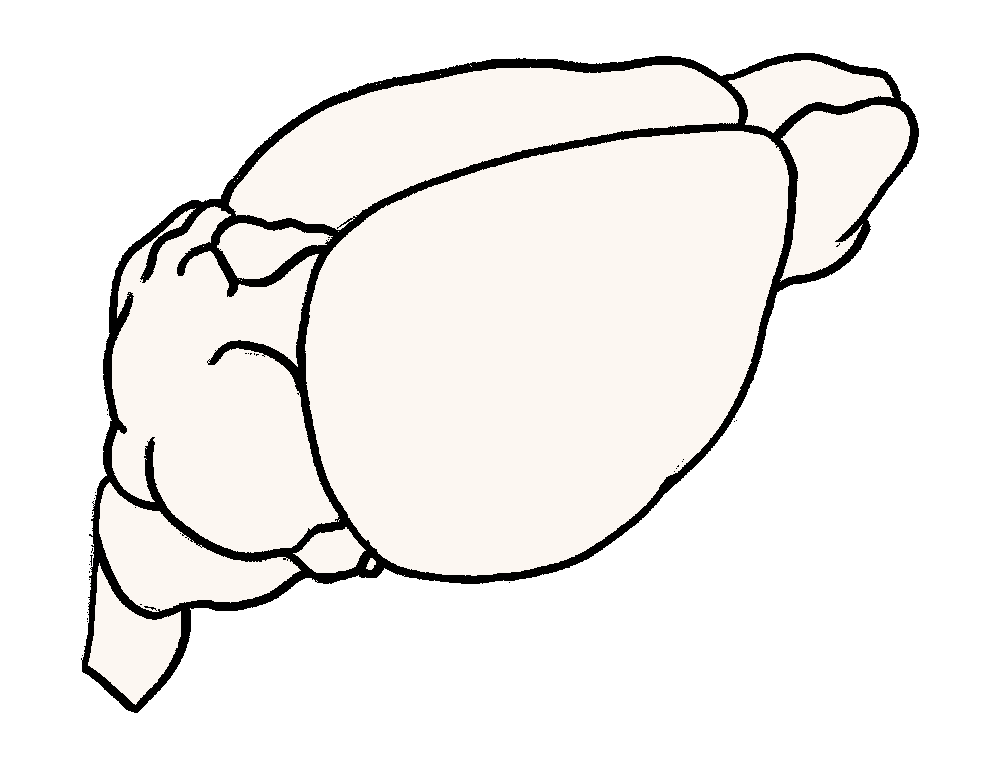
Neurophotonics/inkscaping/mouse_brain_cartoon_S_white_2.png
