CarolineMuellenbroich/Giovanni-goes-Giorgio/Neurophotonics/Stuff/alt_SI.png

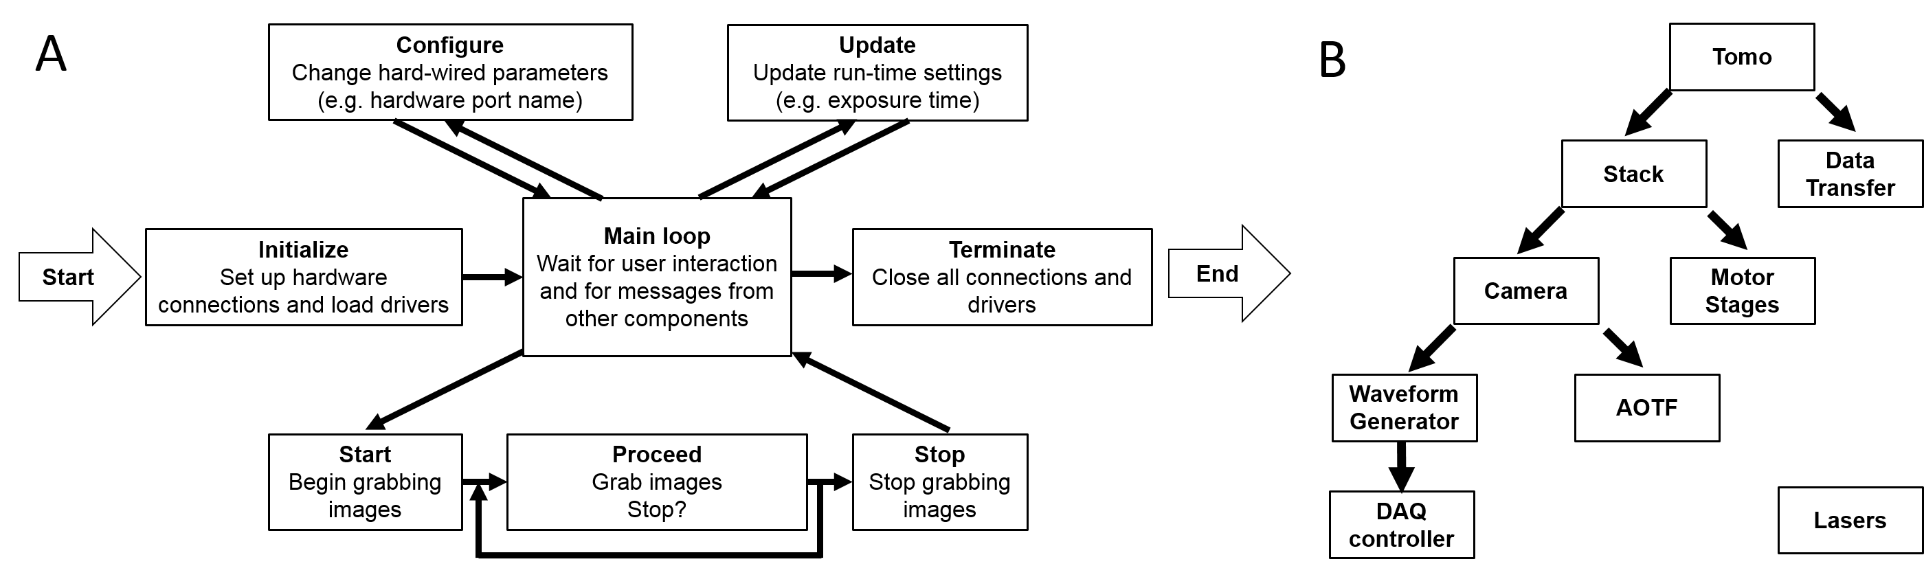
Neurophotonics/Stuff/alt_SI.png
