CarolineMuellenbroich/Giovanni-goes-Giorgio/Neurophotonics/Stuff/brain_tomo.png

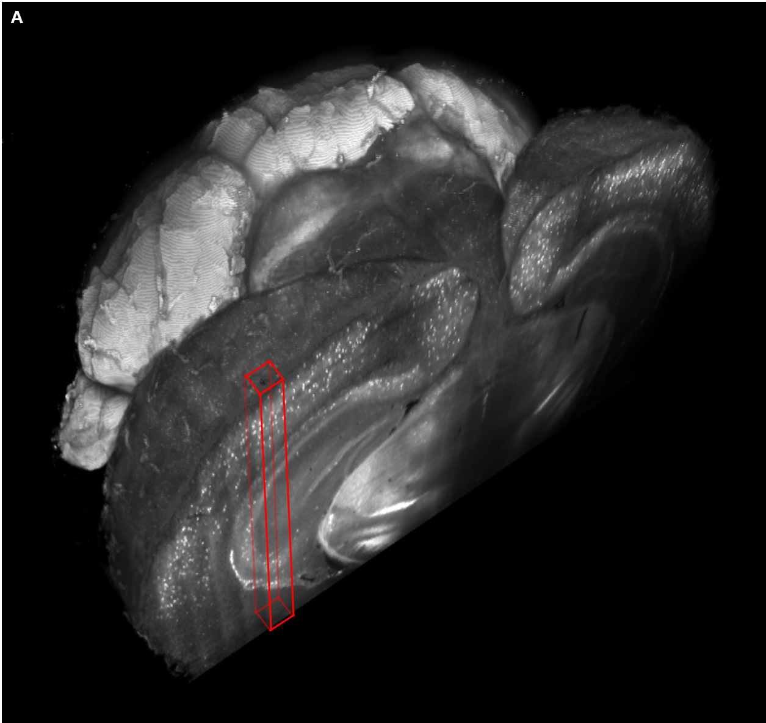
Neurophotonics/Stuff/brain_tomo.png
