CarolineMuellenbroich/Giovanni-goes-Giorgio/Neurophotonics/Stuff/data_panel.png

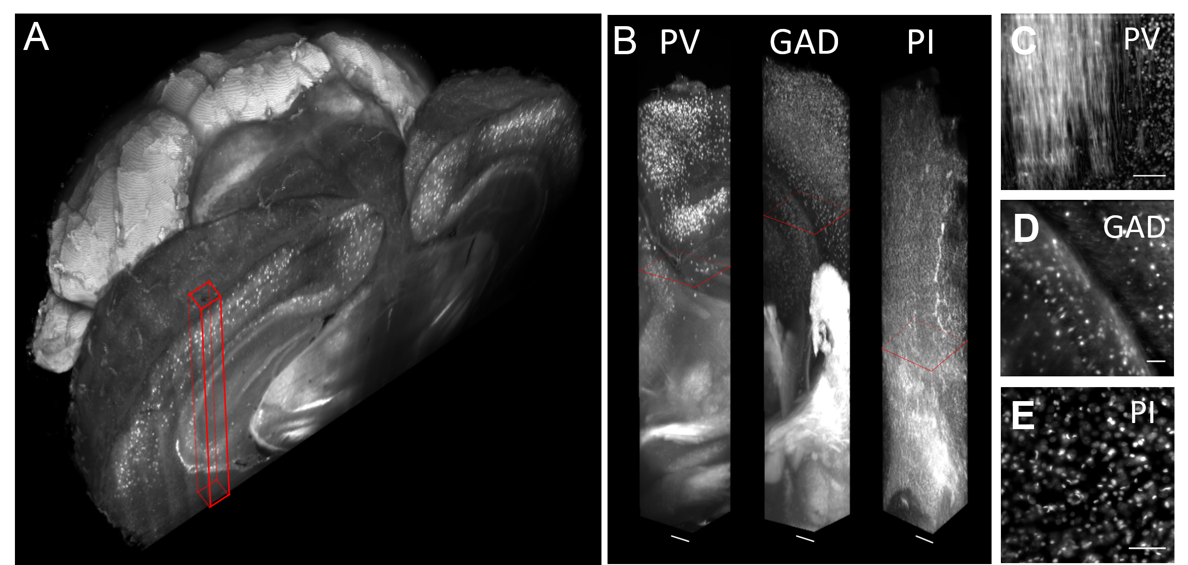
Neurophotonics/Stuff/data_panel.png
