CarolineMuellenbroich/Giovanni-goes-Giorgio/Neurophotonics/Stuff/DataFlow.png

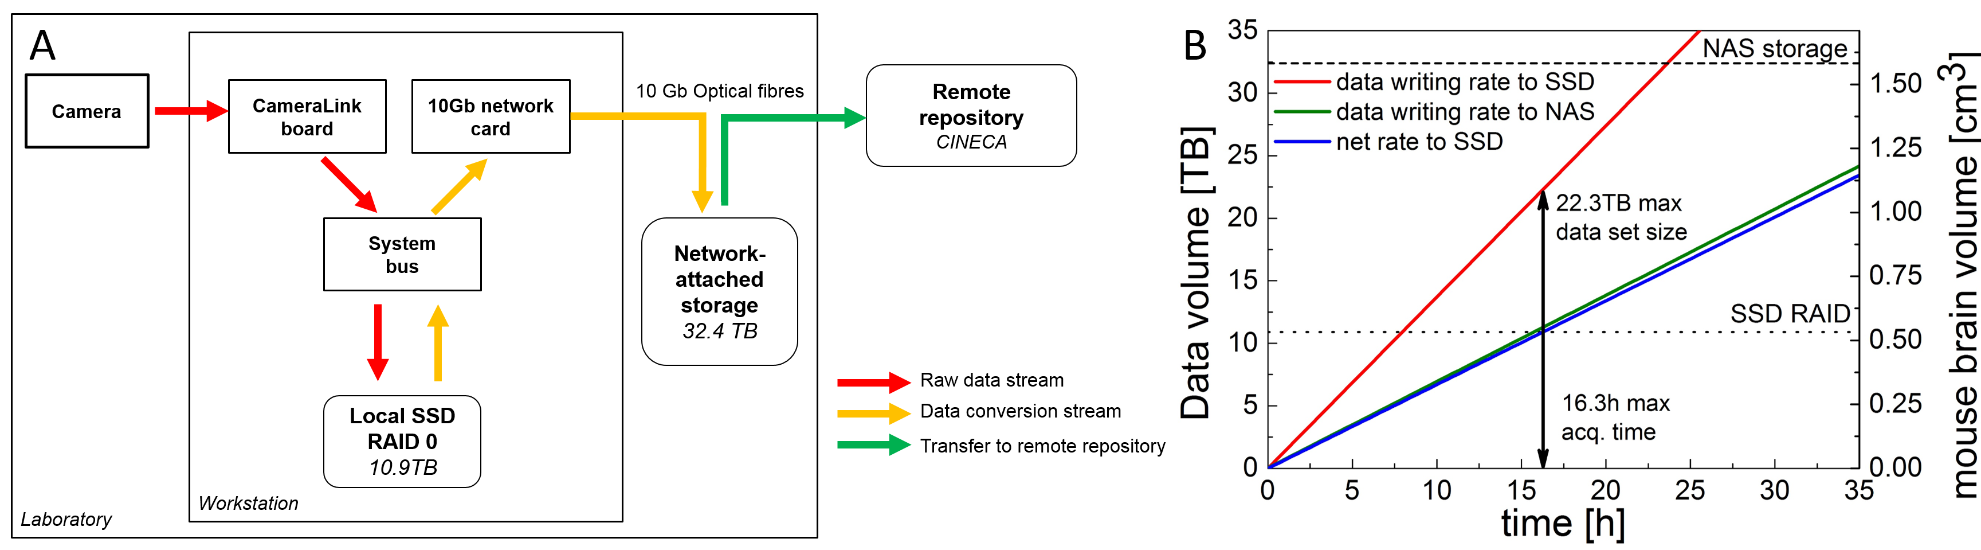
Neurophotonics/Stuff/DataFlow.png
