CarolineMuellenbroich/Giovanni-goes-Giorgio/Neurophotonics/Stuff/datastream1.jpg

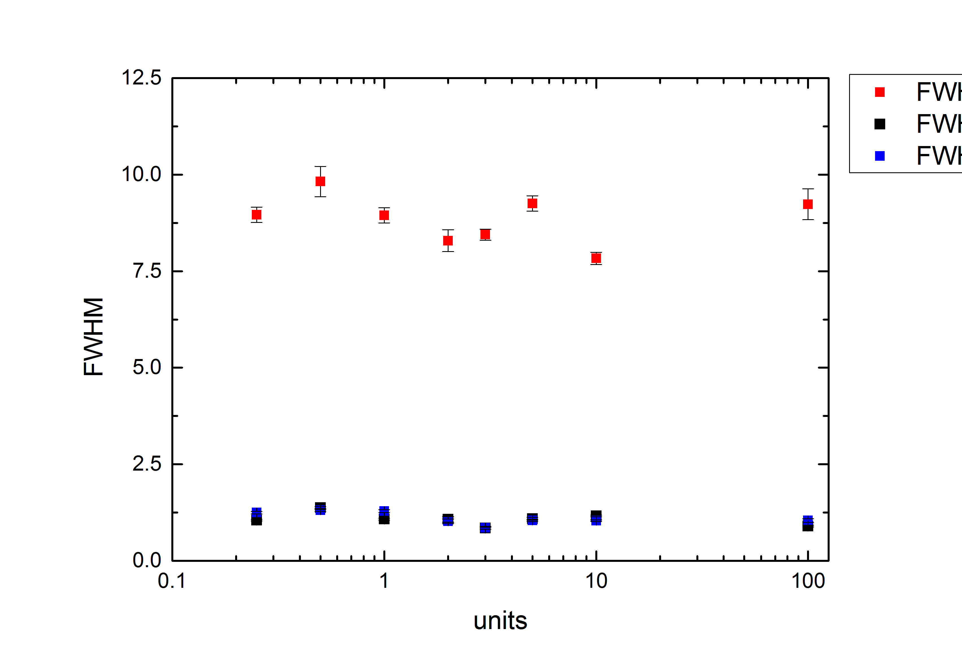
Neurophotonics/Stuff/datastream1.jpg
