CarolineMuellenbroich/Giovanni-goes-Giorgio/Neurophotonics/Stuff/datastream.jpg

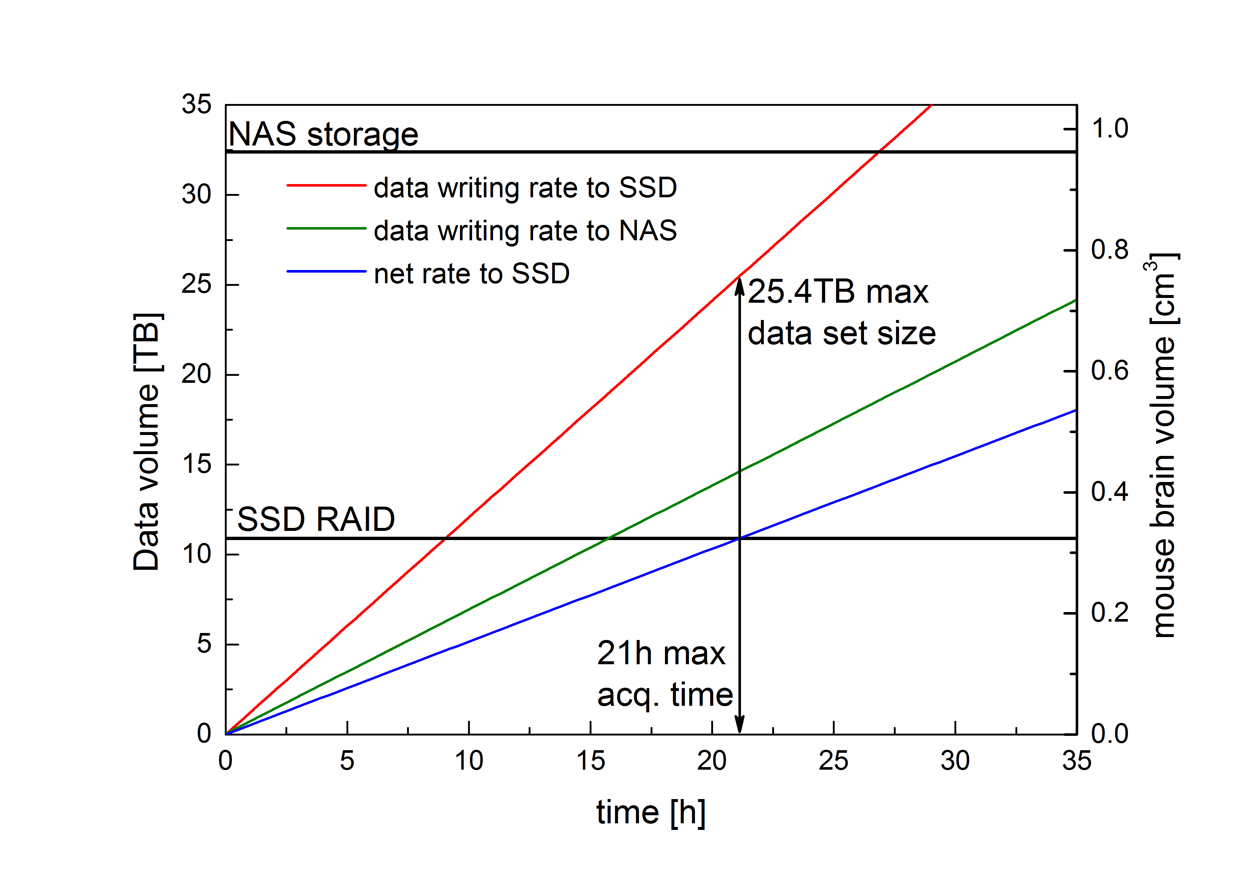
Neurophotonics/Stuff/datastream.jpg
