CarolineMuellenbroich/Giovanni-goes-Giorgio/Neurophotonics/Stuff/excitation.png

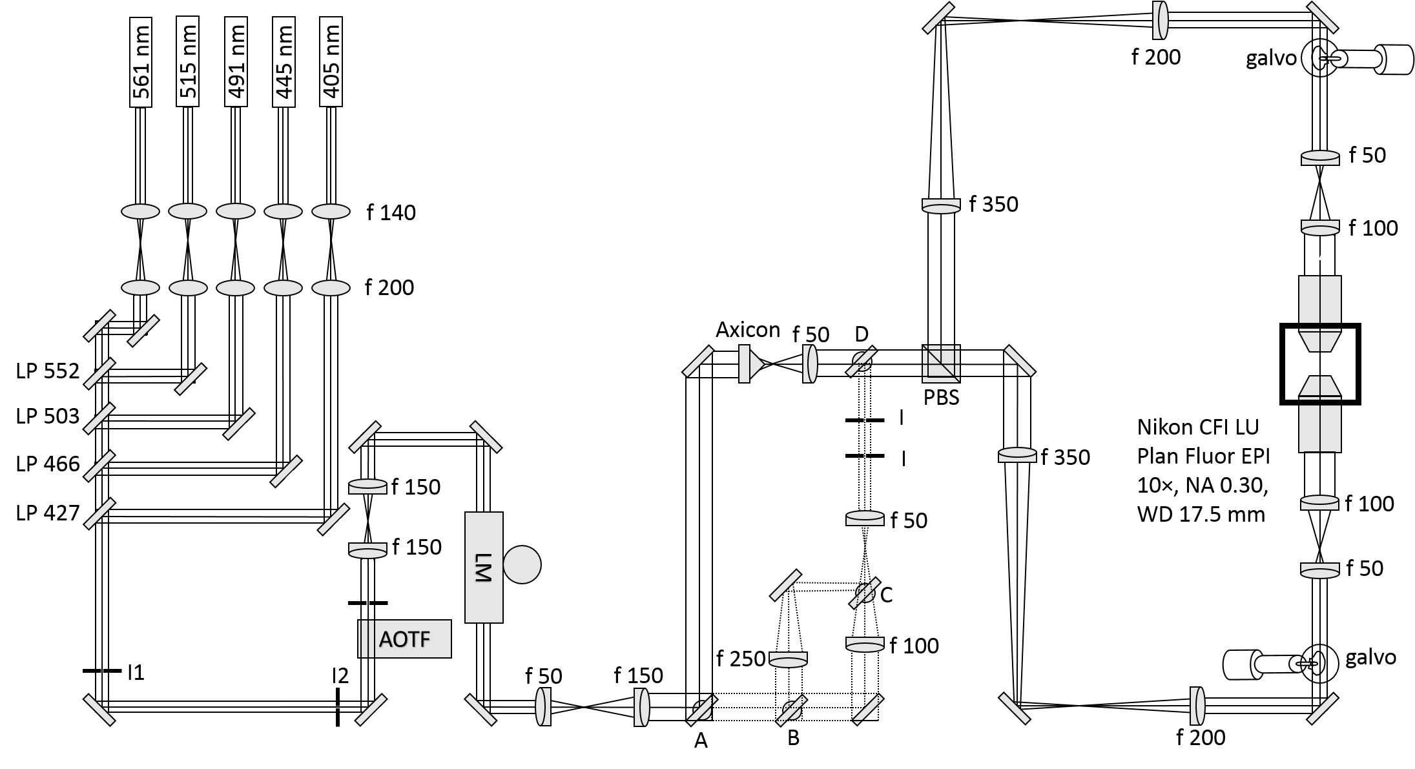
Neurophotonics/Stuff/excitation.png
