CarolineMuellenbroich/Giovanni-goes-Giorgio/Neurophotonics/Stuff/FWHM_units.jpg

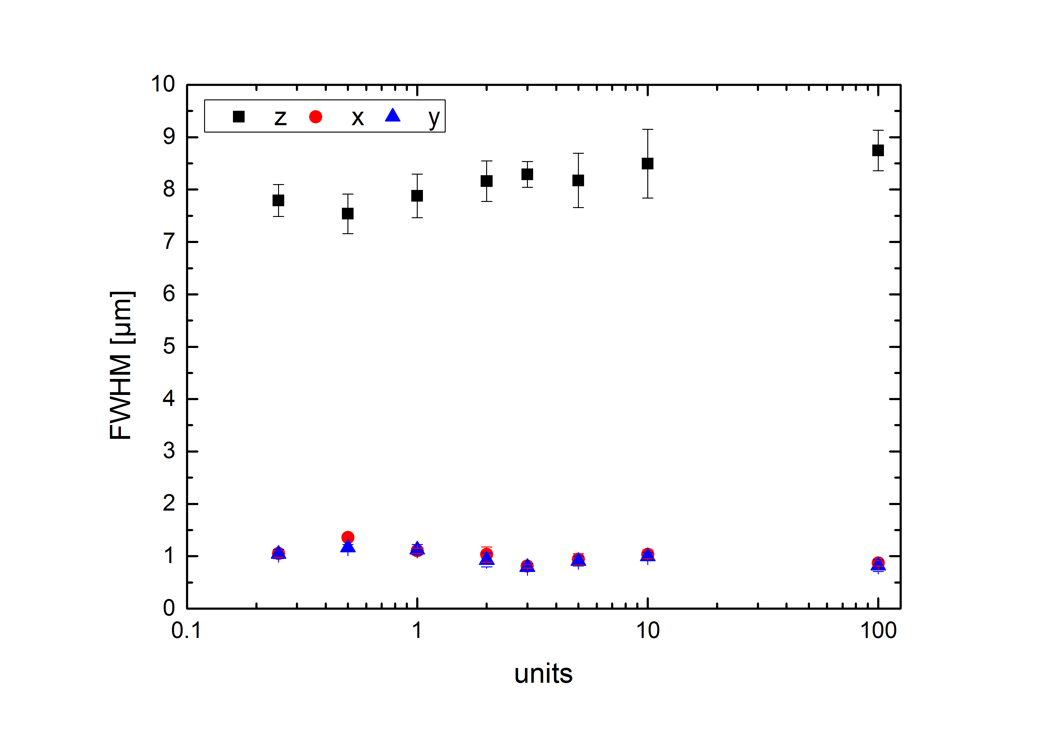
Neurophotonics/Stuff/FWHM_units.jpg
