CarolineMuellenbroich/Giovanni-goes-Giorgio/Neurophotonics/Stuff/FWHMs.jpg

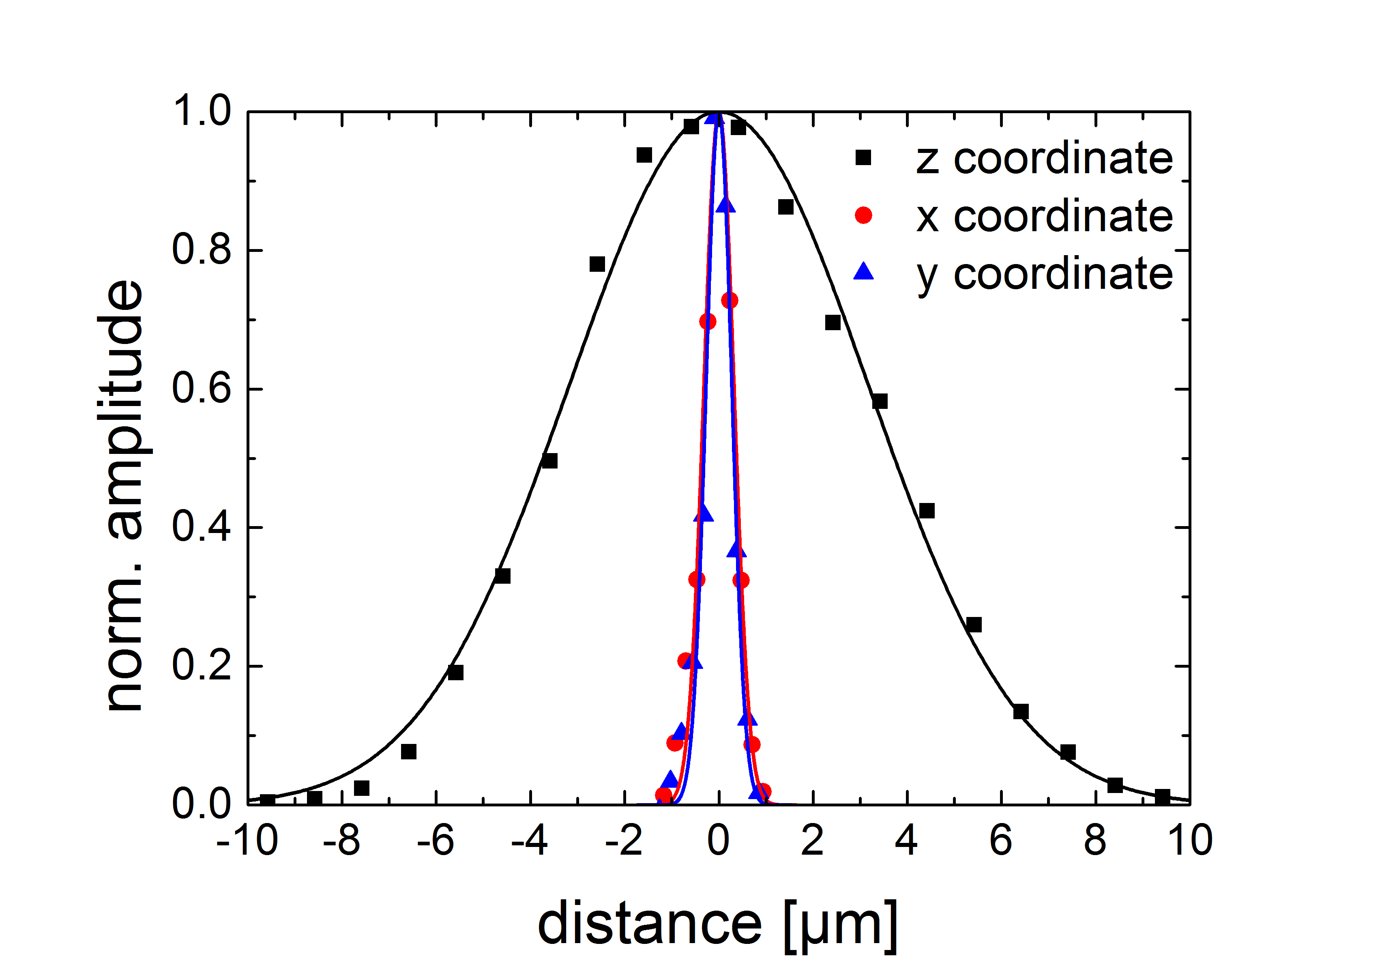
Neurophotonics/Stuff/FWHMs.jpg
