CarolineMuellenbroich/Giovanni-goes-Giorgio/Neurophotonics/Stuff/FWHMs_slitwidth.jpg

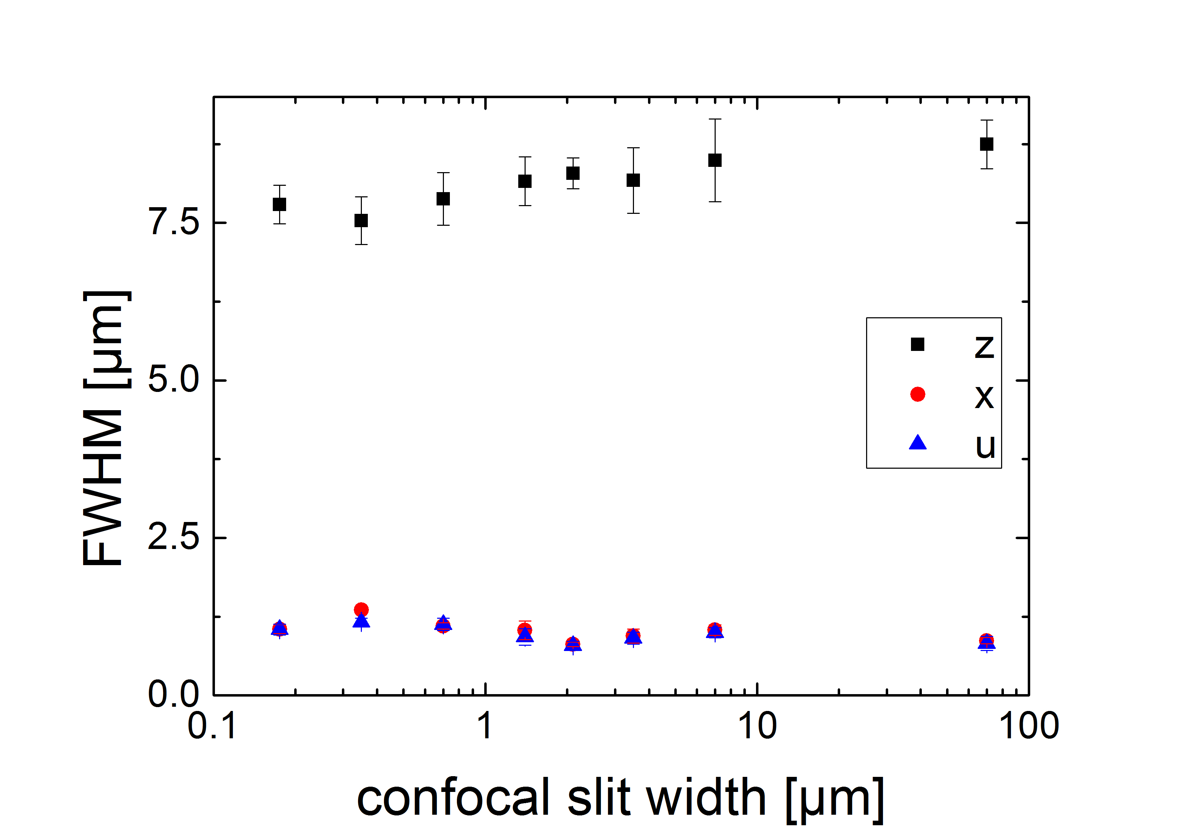
Neurophotonics/Stuff/FWHMs_slitwidth.jpg
