CarolineMuellenbroich/Giovanni-goes-Giorgio/Neurophotonics/Stuff/IMG_2228_kl.jpg

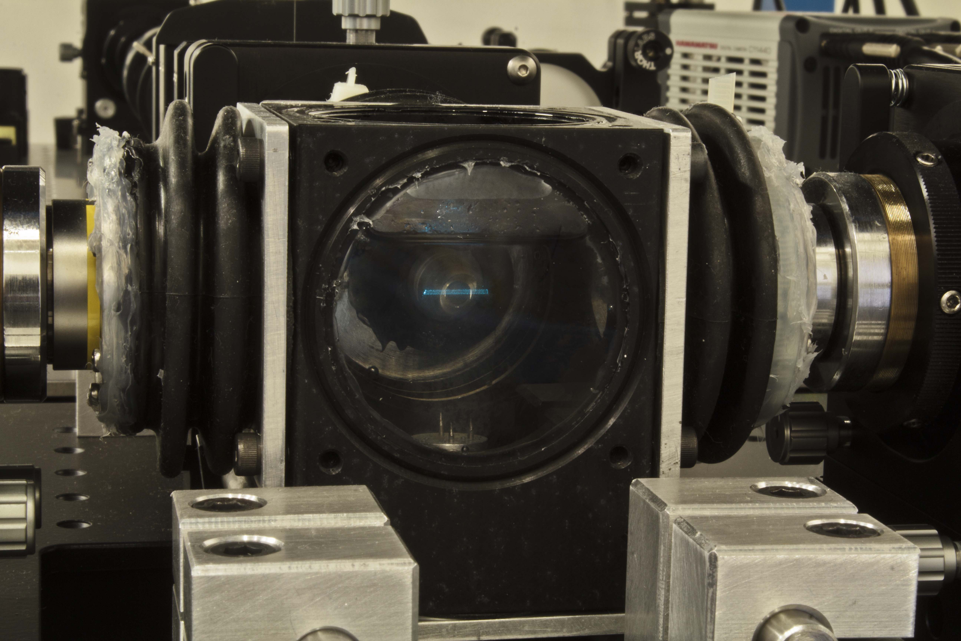
Neurophotonics/Stuff/IMG_2228_kl.jpg
