CarolineMuellenbroich/Giovanni-goes-Giorgio/Neurophotonics/Stuff/option2.png

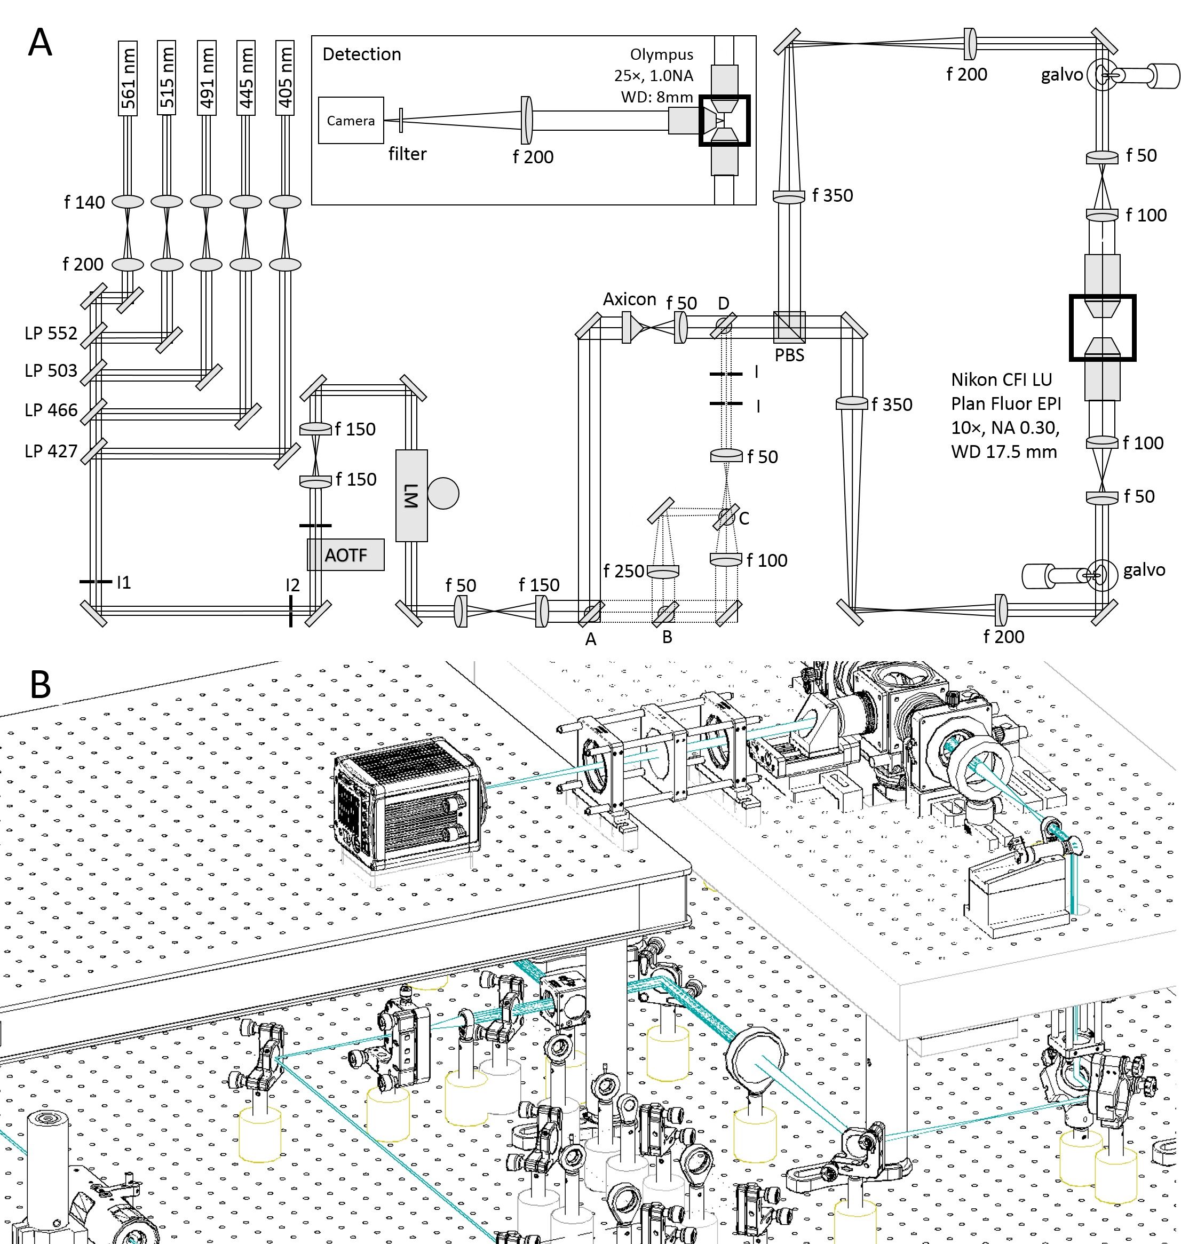
Neurophotonics/Stuff/option2.png
