CarolineMuellenbroich/Giovanni-goes-Giorgio/Neurophotonics/Stuff/origin_graph.jpg

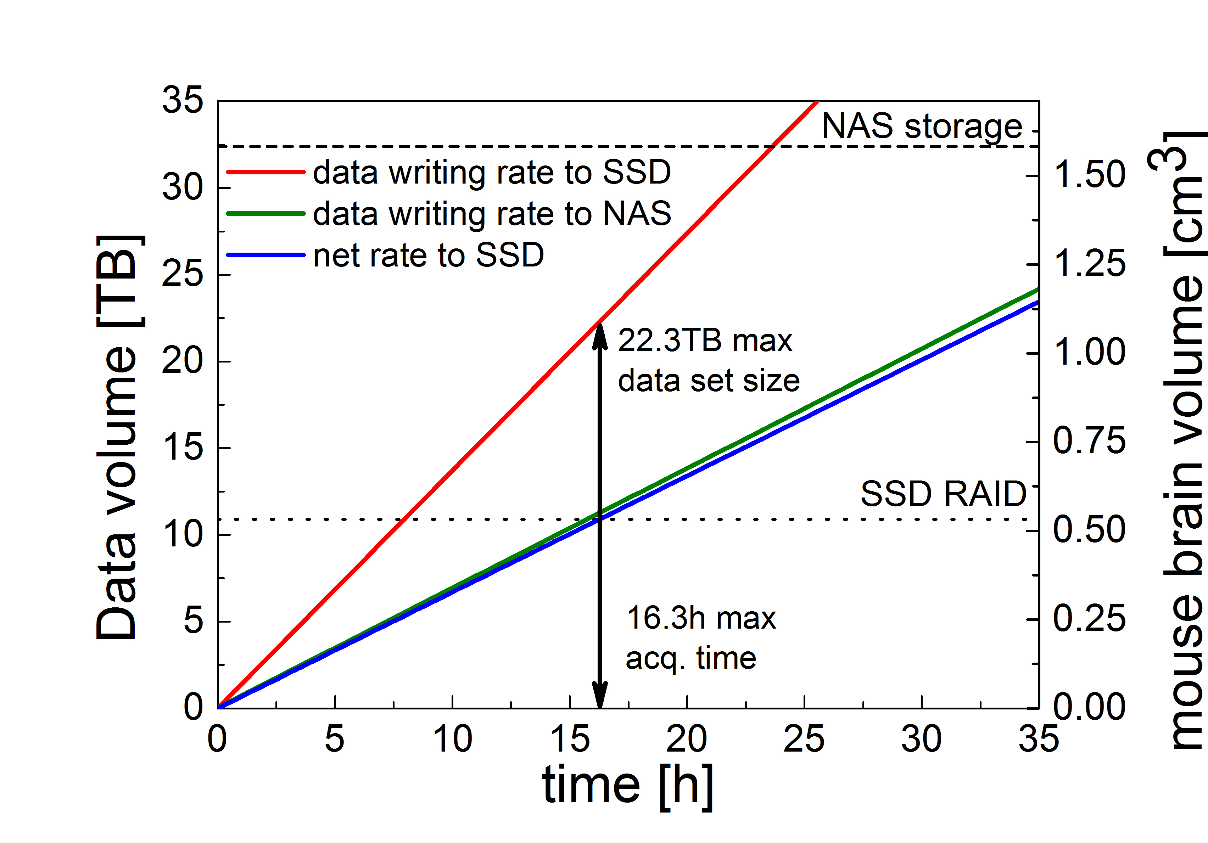
Neurophotonics/Stuff/origin_graph.jpg
