CarolineMuellenbroich/Giovanni-goes-Giorgio/Neurophotonics/Stuff/PanelSampel.png

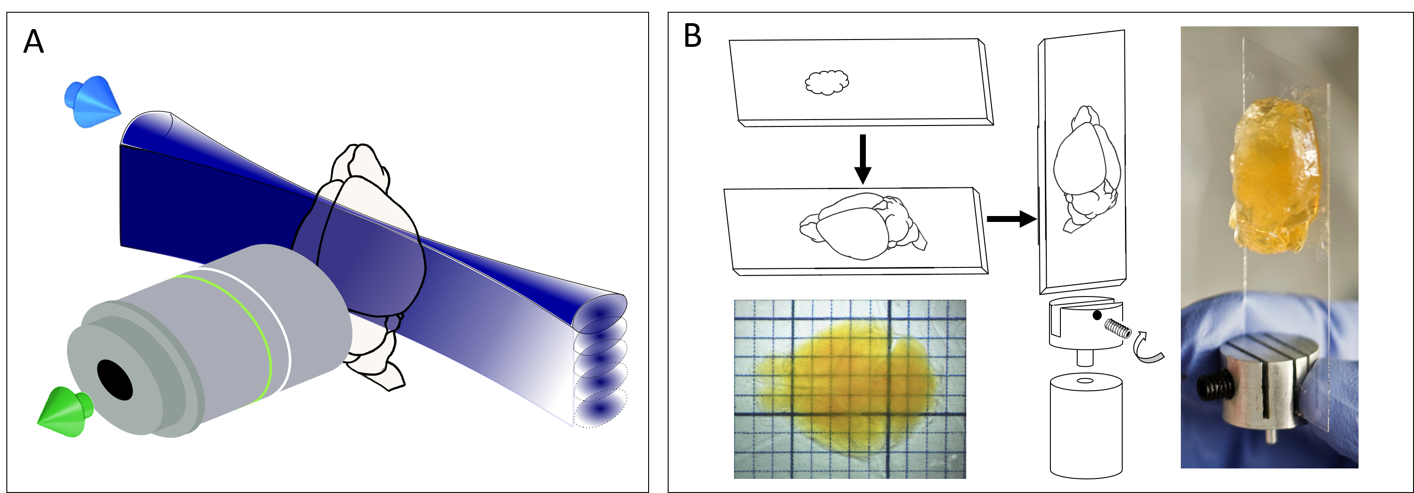
Neurophotonics/Stuff/PanelSampel.png
