CarolineMuellenbroich/Giovanni-goes-Giorgio/Neurophotonics/Stuff/Picture1.png

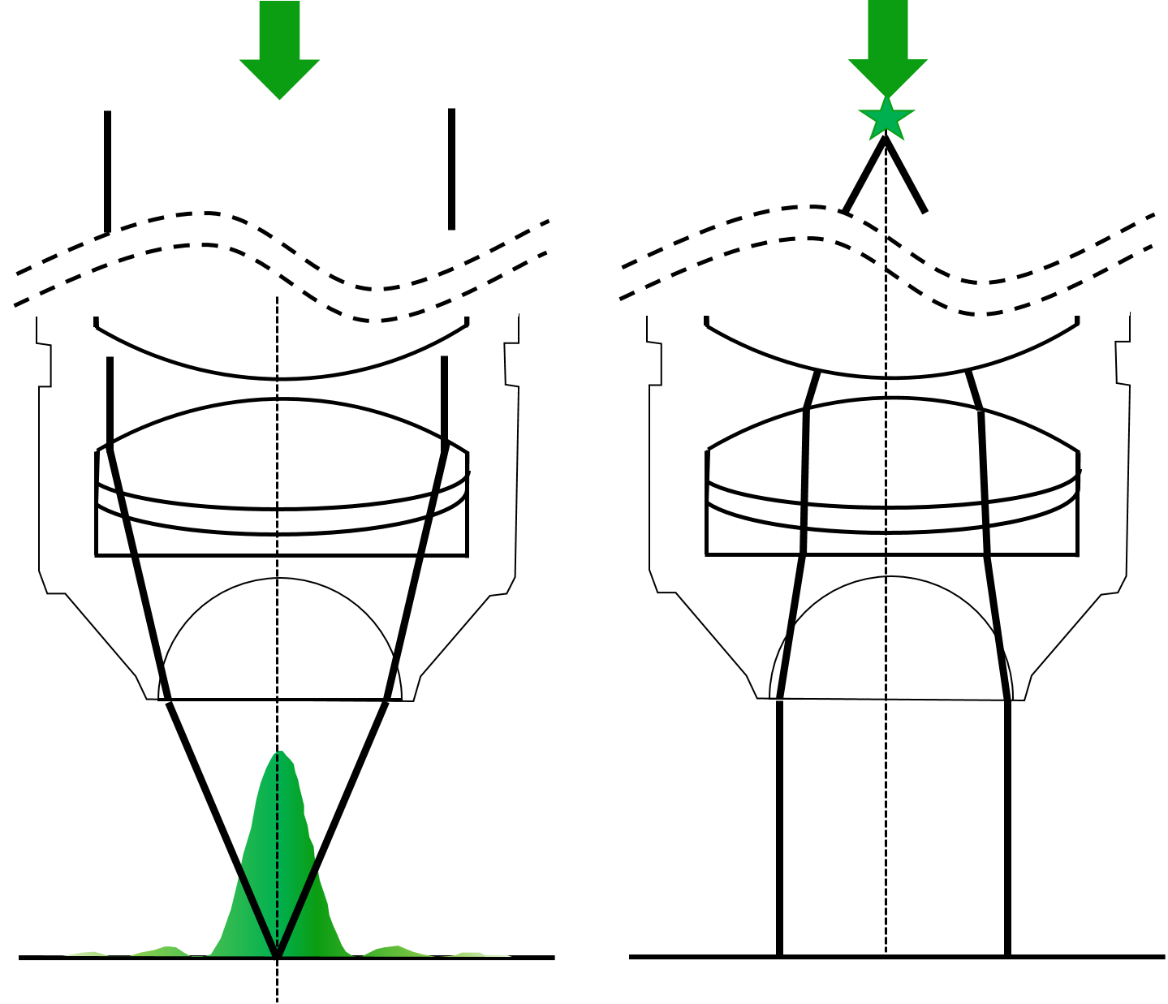
Neurophotonics/Stuff/Picture1.png
