CarolineMuellenbroich/Giovanni-goes-Giorgio/Neurophotonics/Stuff/SNR_slitwidth.jpg

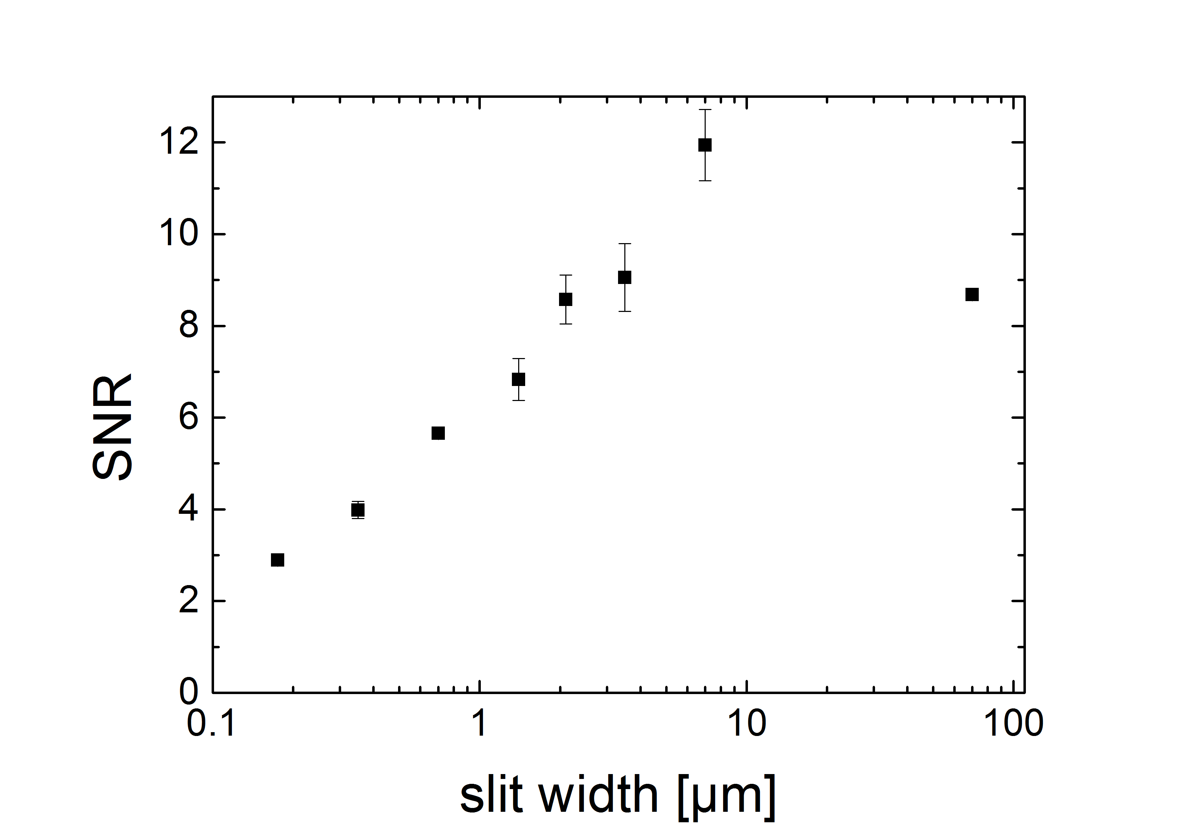
Neurophotonics/Stuff/SNR_slitwidth.jpg
