CarolineMuellenbroich/Giovanni-goes-Giorgio/Neurophotonics/Stuff/SNR_units.jpg

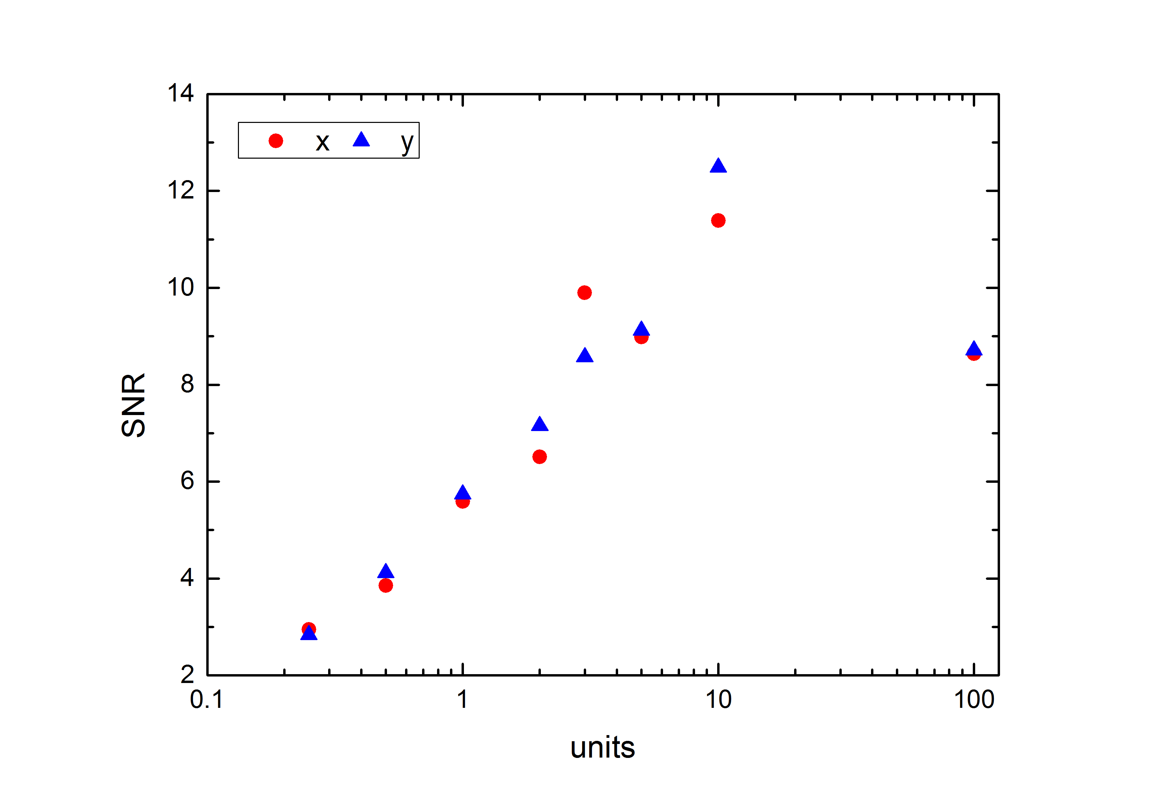
Neurophotonics/Stuff/SNR_units.jpg
