CarolineMuellenbroich/Giovanni-goes-Giorgio/Neurophotonics/Stuff/TDE63%5.bmp

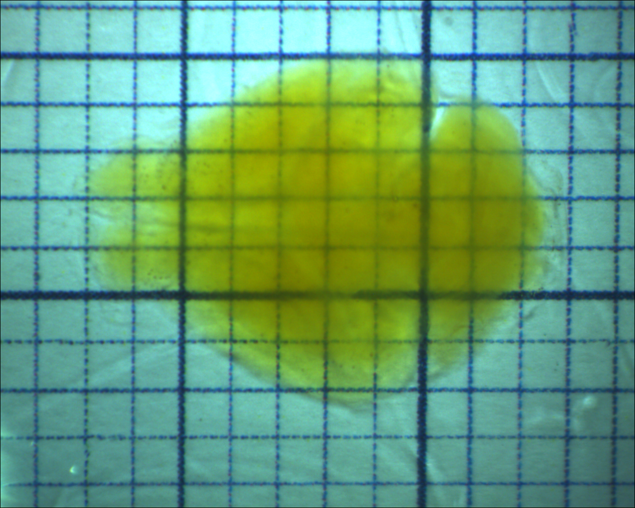
Neurophotonics/Stuff/TDE63%5.bmp
