CarolineMuellenbroich/Giovanni-goes-Giorgio/Neurophotonics/Stuff/TDE63%5.jpg

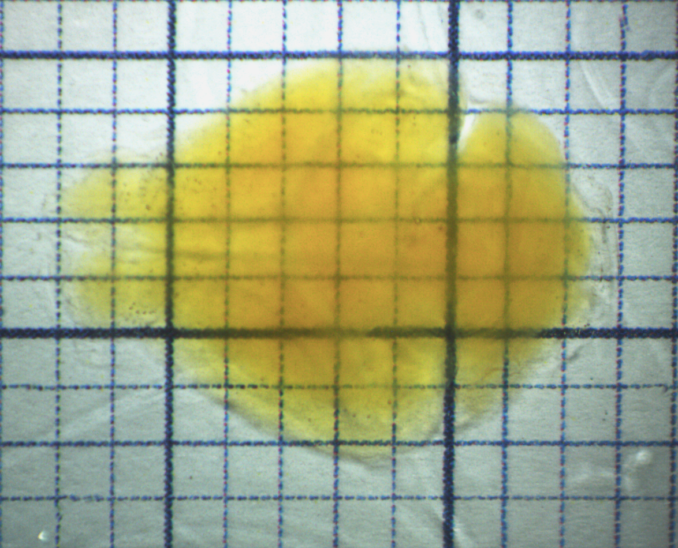
Neurophotonics/Stuff/TDE63%5.jpg
