CarolineMuellenbroich/Giovanni-goes-Giorgio/Neurophotonics/Stuff/Components scheme.pptx

Tomo

aquire image sweep:
# of frames

file name

Stack

Data transfer

Camera

move:
speed
step

PI stages

SPIM imaging

AOTF

Laser

DM mirror

cameralink

DAQmx

serial

AOTF

USB

stages

serial

Laser

Pockels cell

Galvos

Camera

DM mirror
