CarolineMuellenbroich/Giovanni-goes-Giorgio/Neurophotonics/CAD/Imported Components/18U(DX)002/18U(DX)002.htm

Autodesk Inventor Translation Report | venerdì 16 gennaio 2015 ( 10:04)
Source File: | C:\Users\Caroline\Documents\GitHub\Giovanni-goes-Giorgio\CAD\18U(DX)002.stp
Translator Type: | STEP | Sending System: | Autodesk Inventor 2013
Author: | Meccanica | Translation Time: | 00:01:01
Options
Import Type: | N/A
Entity Types to Import: | Solids, Surfaces, Wires, Points
Import into Repair Environment: | Yes
Import Assembly as Single Part: | No
Create Surfaces As: | Single Composite Feature
Check Parts during Load: | No
Auto Stitch: | No
Enable Advanced Healing: | N/A
+/- | Name | Inventor File | Status
[ ] | 18U(DX)002.iam | C:\Users\Caroline\Documents\GitHub\Giovanni-goes-Giorgio\CAD\Imported Components\18U(DX)002\18U(DX)002.iam | Successful
[ ] | BB1.ipt | C:\Users\Caroline\Documents\GitHub\Giovanni-goes-Giorgio\CAD\Imported Components\18U(DX)002\BB1.ipt | Successful
[ ] | Sostegno cameretta.ipt | C:\Users\Caroline\Documents\GitHub\Giovanni-goes-Giorgio\CAD\Imported Components\18U(DX)002\Sostegno cameretta.ipt | Successful
[ ] | 18U(DX)001_9a.ipt | C:\Users\Caroline\Documents\GitHub\Giovanni-goes-Giorgio\CAD\Imported Components\18U(DX)002\18U(DX)001_9a.ipt | Successful
[ ] | 18U(DX)001_12.ipt | C:\Users\Caroline\Documents\GitHub\Giovanni-goes-Giorgio\CAD\Imported Components\18U(DX)002\18U(DX)001_12.ipt | Successful
[ ] | 18U(DX)001_8b.ipt | C:\Users\Caroline\Documents\GitHub\Giovanni-goes-Giorgio\CAD\Imported Components\18U(DX)002\18U(DX)001_8b.ipt | Successful
[ ] | 18U(DX)001_11.ipt | C:\Users\Caroline\Documents\GitHub\Giovanni-goes-Giorgio\CAD\Imported Components\18U(DX)002\18U(DX)001_11.ipt | Successful
[ ] | 18U(DX)001_18.ipt | C:\Users\Caroline\Documents\GitHub\Giovanni-goes-Giorgio\CAD\Imported Components\18U(DX)002\18U(DX)001_18.ipt | Successful
[ ] | Disco schiaccia OR di29.ipt | C:\Users\Caroline\Documents\GitHub\Giovanni-goes-Giorgio\CAD\Imported Components\18U(DX)002\Disco schiaccia OR di29.ipt | Successful
[ ] | AS 568 O-Ring DASH # 123.ipt | C:\Users\Caroline\Documents\GitHub\Giovanni-goes-Giorgio\CAD\Imported Components\18U(DX)002\AS 568 O-Ring DASH # 123.ipt | Successful
[ ] | Anello tenuta diametro29.ipt | C:\Users\Caroline\Documents\GitHub\Giovanni-goes-Giorgio\CAD\Imported Components\18U(DX)002\Anello tenuta diametro29.ipt | Successful
[+] [-] | Nik_TPF 10x.ipt | C:\Users\Caroline\Documents\GitHub\Giovanni-goes-Giorgio\CAD\Imported Components\18U(DX)002\Nik_TPF 10x.ipt | Warning
Severity | Entity Id | Message
Warning | 68821 | Some Surfaces have been simplified
[+] [-] | newport_LP-1A.ipt | C:\Users\Caroline\Documents\GitHub\Giovanni-goes-Giorgio\CAD\Imported Components\18U(DX)002\newport_LP-1A.ipt | Warning
Severity | Entity Id | Message
Warning | 108689 | Some Surfaces have been simplified
[ ] | Sistema XYZ.iam | C:\Users\Caroline\Documents\GitHub\Giovanni-goes-Giorgio\CAD\Imported Components\18U(DX)002\Sistema XYZ.iam | Successful
[ ] | 18U(DX)001_10.ipt | C:\Users\Caroline\Documents\GitHub\Giovanni-goes-Giorgio\CAD\Imported Components\18U(DX)002\18U(DX)001_10.ipt | Successful
[ ] | 18U(DX)001_2.ipt | C:\Users\Caroline\Documents\GitHub\Giovanni-goes-Giorgio\CAD\Imported Components\18U(DX)002\18U(DX)001_2.ipt | Successful
[ ] | 18U(DX)001_1a.iam | C:\Users\Caroline\Documents\GitHub\Giovanni-goes-Giorgio\CAD\Imported Components\18U(DX)002\18U(DX)001_1a.iam | Successful
[ ] | 18U(DX)001_5.ipt | C:\Users\Caroline\Documents\GitHub\Giovanni-goes-Giorgio\CAD\Imported Components\18U(DX)002\18U(DX)001_5.ipt | Successful
[ ] | 18U(DX)001_4.ipt | C:\Users\Caroline\Documents\GitHub\Giovanni-goes-Giorgio\CAD\Imported Components\18U(DX)002\18U(DX)001_4.ipt | Successful
[ ] | 18U(DX)001_7.ipt | C:\Users\Caroline\Documents\GitHub\Giovanni-goes-Giorgio\CAD\Imported Components\18U(DX)002\18U(DX)001_7.ipt | Successful
[ ] | 18U(DX)001_6.ipt | C:\Users\Caroline\Documents\GitHub\Giovanni-goes-Giorgio\CAD\Imported Components\18U(DX)002\18U(DX)001_6.ipt | Successful
[ ] | 18U(DX)001_13.ipt | C:\Users\Caroline\Documents\GitHub\Giovanni-goes-Giorgio\CAD\Imported Components\18U(DX)002\18U(DX)001_13.ipt | Successful
[ ] | 18U(DX)001_15.ipt | C:\Users\Caroline\Documents\GitHub\Giovanni-goes-Giorgio\CAD\Imported Components\18U(DX)002\18U(DX)001_15.ipt | Successful
[ ] | AS 568 O-Ring nazionali DASH # 015.ipt | C:\Users\Caroline\Documents\GitHub\Giovanni-goes-Giorgio\CAD\Imported Components\18U(DX)002\AS 568 O-Ring nazionali DASH # 015.ipt | Successful
[ ] | PI_M-116.XX.iam | C:\Users\Caroline\Documents\GitHub\Giovanni-goes-Giorgio\CAD\Imported Components\18U(DX)002\PI_M-116.XX.iam | Successful
[ ] | PI_M116_1.ipt | C:\Users\Caroline\Documents\GitHub\Giovanni-goes-Giorgio\CAD\Imported Components\18U(DX)002\PI_M116_1.ipt | Successful
[ ] | PI_M116_3.ipt | C:\Users\Caroline\Documents\GitHub\Giovanni-goes-Giorgio\CAD\Imported Components\18U(DX)002\PI_M116_3.ipt | Successful
[ ] | PI_M116_5.ipt | C:\Users\Caroline\Documents\GitHub\Giovanni-goes-Giorgio\CAD\Imported Components\18U(DX)002\PI_M116_5.ipt | Successful
[ ] | PI_M116_4.ipt | C:\Users\Caroline\Documents\GitHub\Giovanni-goes-Giorgio\CAD\Imported Components\18U(DX)002\PI_M116_4.ipt | Successful
[ ] | PI_M116_6.ipt | C:\Users\Caroline\Documents\GitHub\Giovanni-goes-Giorgio\CAD\Imported Components\18U(DX)002\PI_M116_6.ipt | Successful
[ ] | PI_M116_7.ipt | C:\Users\Caroline\Documents\GitHub\Giovanni-goes-Giorgio\CAD\Imported Components\18U(DX)002\PI_M116_7.ipt | Successful
[ ] | PI_M116_2.ipt | C:\Users\Caroline\Documents\GitHub\Giovanni-goes-Giorgio\CAD\Imported Components\18U(DX)002\PI_M116_2.ipt | Successful
[ ] | CNS 4560 M2 x 6.ipt | C:\Users\Caroline\Documents\GitHub\Giovanni-goes-Giorgio\CAD\Imported Components\18U(DX)002\CNS 4560 M2 x 6.ipt | Successful
[ ] | ISO 4762 M2 x 4.ipt | C:\Users\Caroline\Documents\GitHub\Giovanni-goes-Giorgio\CAD\Imported Components\18U(DX)002\ISO 4762 M2 x 4.ipt | Successful
[ ] | ISO 4026 M2 x 2.ipt | C:\Users\Caroline\Documents\GitHub\Giovanni-goes-Giorgio\CAD\Imported Components\18U(DX)002\ISO 4026 M2 x 2.ipt | Successful
[ ] | ISO 4027 M1,6 x 2,5.ipt | C:\Users\Caroline\Documents\GitHub\Giovanni-goes-Giorgio\CAD\Imported Components\18U(DX)002\ISO 4027 M1,6 x 2,5.ipt | Successful
[ ] | PI_M122_2.iam | C:\Users\Caroline\Documents\GitHub\Giovanni-goes-Giorgio\CAD\Imported Components\18U(DX)002\PI_M122_2.iam | Successful
[ ] | M122_4.ipt | C:\Users\Caroline\Documents\GitHub\Giovanni-goes-Giorgio\CAD\Imported Components\18U(DX)002\M122_4.ipt | Successful
[ ] | Viti_M1.6.ipt | C:\Users\Caroline\Documents\GitHub\Giovanni-goes-Giorgio\CAD\Imported Components\18U(DX)002\Viti_M1.6.ipt | Successful
[ ] | M122_3.ipt | C:\Users\Caroline\Documents\GitHub\Giovanni-goes-Giorgio\CAD\Imported Components\18U(DX)002\M122_3.ipt | Successful
[ ] | PI_M122.iam | C:\Users\Caroline\Documents\GitHub\Giovanni-goes-Giorgio\CAD\Imported Components\18U(DX)002\PI_M122.iam | Successful
[ ] | M122_1.ipt | C:\Users\Caroline\Documents\GitHub\Giovanni-goes-Giorgio\CAD\Imported Components\18U(DX)002\M122_1.ipt | Successful
[ ] | M122_5.ipt | C:\Users\Caroline\Documents\GitHub\Giovanni-goes-Giorgio\CAD\Imported Components\18U(DX)002\M122_5.ipt | Successful
[ ] | M122_2.ipt | C:\Users\Caroline\Documents\GitHub\Giovanni-goes-Giorgio\CAD\Imported Components\18U(DX)002\M122_2.ipt | Successful
[ ] | M122_7.ipt | C:\Users\Caroline\Documents\GitHub\Giovanni-goes-Giorgio\CAD\Imported Components\18U(DX)002\M122_7.ipt | Successful
[ ] | M122_8.ipt | C:\Users\Caroline\Documents\GitHub\Giovanni-goes-Giorgio\CAD\Imported Components\18U(DX)002\M122_8.ipt | Successful
[ ] | cuscinetto.ipt | C:\Users\Caroline\Documents\GitHub\Giovanni-goes-Giorgio\CAD\Imported Components\18U(DX)002\cuscinetto.ipt | Successful
[ ] | M122_6.ipt | C:\Users\Caroline\Documents\GitHub\Giovanni-goes-Giorgio\CAD\Imported Components\18U(DX)002\M122_6.ipt | Successful
[ ] | M122_9.ipt | C:\Users\Caroline\Documents\GitHub\Giovanni-goes-Giorgio\CAD\Imported Components\18U(DX)002\M122_9.ipt | Successful
[ ] | M122_10.ipt | C:\Users\Caroline\Documents\GitHub\Giovanni-goes-Giorgio\CAD\Imported Components\18U(DX)002\M122_10.ipt | Successful
[ ] | M122_11.ipt | C:\Users\Caroline\Documents\GitHub\Giovanni-goes-Giorgio\CAD\Imported Components\18U(DX)002\M122_11.ipt | Successful
[ ] | M122_12.ipt | C:\Users\Caroline\Documents\GitHub\Giovanni-goes-Giorgio\CAD\Imported Components\18U(DX)002\M122_12.ipt | Successful
[ ] | Viti_M2.5.ipt | C:\Users\Caroline\Documents\GitHub\Giovanni-goes-Giorgio\CAD\Imported Components\18U(DX)002\Viti_M2.5.ipt | Successful
[ ] | Viti_M2.ipt | C:\Users\Caroline\Documents\GitHub\Giovanni-goes-Giorgio\CAD\Imported Components\18U(DX)002\Viti_M2.ipt | Successful
[ ] | M122_13.ipt | C:\Users\Caroline\Documents\GitHub\Giovanni-goes-Giorgio\CAD\Imported Components\18U(DX)002\M122_13.ipt | Successful
[ ] | M122_14.ipt | C:\Users\Caroline\Documents\GitHub\Giovanni-goes-Giorgio\CAD\Imported Components\18U(DX)002\M122_14.ipt | Successful
[ ] | Parte1.ipt | C:\Users\Caroline\Documents\GitHub\Giovanni-goes-Giorgio\CAD\Imported Components\18U(DX)002\Parte1.ipt | Successful
[ ] | Parte2.ipt | C:\Users\Caroline\Documents\GitHub\Giovanni-goes-Giorgio\CAD\Imported Components\18U(DX)002\Parte2.ipt | Successful
[ ] | 18U(DX)001_13-2.ipt | C:\Users\Caroline\Documents\GitHub\Giovanni-goes-Giorgio\CAD\Imported Components\18U(DX)002\18U(DX)001_13-2.ipt | Successful
[ ] | 18U(DX)004.iam | C:\Users\Caroline\Documents\GitHub\Giovanni-goes-Giorgio\CAD\Imported Components\18U(DX)002\18U(DX)004.iam | Successful
[ ] | 18U(DX)003_1.ipt | C:\Users\Caroline\Documents\GitHub\Giovanni-goes-Giorgio\CAD\Imported Components\18U(DX)002\18U(DX)003_1.ipt | Successful
[ ] | 18U(DX)003_2.ipt | C:\Users\Caroline\Documents\GitHub\Giovanni-goes-Giorgio\CAD\Imported Components\18U(DX)002\18U(DX)003_2.ipt | Successful
[ ] | Profilati1.ipt | C:\Users\Caroline\Documents\GitHub\Giovanni-goes-Giorgio\CAD\Imported Components\18U(DX)002\Profilati1.ipt | Successful
[ ] | Aste.ipt | C:\Users\Caroline\Documents\GitHub\Giovanni-goes-Giorgio\CAD\Imported Components\18U(DX)002\Aste.ipt | Successful
[ ] | AS 568 O-Ring DASH # 138.ipt | C:\Users\Caroline\Documents\GitHub\Giovanni-goes-Giorgio\CAD\Imported Components\18U(DX)002\AS 568 O-Ring DASH # 138.ipt | Successful
[ ] | Assieme2.iam | C:\Users\Caroline\Documents\GitHub\Giovanni-goes-Giorgio\CAD\Imported Components\18U(DX)002\Assieme2.iam | Successful
[ ] | Base in alluminio.ipt | C:\Users\Caroline\Documents\GitHub\Giovanni-goes-Giorgio\CAD\Imported Components\18U(DX)002\Base in alluminio.ipt | Successful
[ ] | Supporto in Ottone.ipt | C:\Users\Caroline\Documents\GitHub\Giovanni-goes-Giorgio\CAD\Imported Components\18U(DX)002\Supporto in Ottone.ipt | Successful
[+] [-] | Olymp_XLSLPLN25XGMP.ipt | C:\Users\Caroline\Documents\GitHub\Giovanni-goes-Giorgio\CAD\Imported Components\18U(DX)002\Olymp_XLSLPLN25XGMP.ipt | Warning
Severity | Entity Id | Message
Warning | 185435 | Some Surfaces have been simplified
[ ] | Obiettivo XGMP.ipt | C:\Users\Caroline\Documents\GitHub\Giovanni-goes-Giorgio\CAD\Imported Components\18U(DX)002\Obiettivo XGMP.ipt | Successful
[ ] | Staffa_50x20x20.ipt | C:\Users\Caroline\Documents\GitHub\Giovanni-goes-Giorgio\CAD\Imported Components\18U(DX)002\Staffa_50x20x20.ipt | Successful
