CarolineMuellenbroich/Giovanni-goes-Giorgio/(list of files, cad)

Other CAD files:
Neurophotonics/CAD/Esploso Cameretta.ipn
Neurophotonics/CAD/Imported Components/18U(DX)002/18U(DX)001_10.ipt
Neurophotonics/CAD/Imported Components/18U(DX)002/18U(DX)001_11.ipt
Neurophotonics/CAD/Imported Components/18U(DX)002/18U(DX)001_12.ipt
Neurophotonics/CAD/Imported Components/18U(DX)002/18U(DX)001_13-2.ipt
Neurophotonics/CAD/Imported Components/18U(DX)002/18U(DX)001_13.ipt
Neurophotonics/CAD/Imported Components/18U(DX)002/18U(DX)001_15.ipt
Neurophotonics/CAD/Imported Components/18U(DX)002/18U(DX)001_18.ipt
Neurophotonics/CAD/Imported Components/18U(DX)002/18U(DX)001_1a.iam
Neurophotonics/CAD/Imported Components/18U(DX)002/18U(DX)001_2.ipt
Neurophotonics/CAD/Imported Components/18U(DX)002/18U(DX)001_4.ipt
Neurophotonics/CAD/Imported Components/18U(DX)002/18U(DX)001_5.ipt
Neurophotonics/CAD/Imported Components/18U(DX)002/18U(DX)001_6.ipt
Neurophotonics/CAD/Imported Components/18U(DX)002/18U(DX)001_7.ipt
Neurophotonics/CAD/Imported Components/18U(DX)002/18U(DX)001_8b.ipt
Neurophotonics/CAD/Imported Components/18U(DX)002/18U(DX)001_9a.ipt
Neurophotonics/CAD/Imported Components/18U(DX)002/18U(DX)002.iam
Neurophotonics/CAD/Imported Components/18U(DX)002/18U(DX)003_1.ipt
Neurophotonics/CAD/Imported Components/18U(DX)002/18U(DX)003_2.ipt
Neurophotonics/CAD/Imported Components/18U(DX)002/18U(DX)004.iam
Neurophotonics/CAD/Imported Components/18U(DX)002/AS 568 O-Ring DASH # 123.ipt
Neurophotonics/CAD/Imported Components/18U(DX)002/AS 568 O-Ring DASH # 138.ipt
Neurophotonics/CAD/Imported Components/18U(DX)002/AS 568 O-Ring nazionali DASH # 015.ipt
Neurophotonics/CAD/Imported Components/18U(DX)002/Anello tenuta diametro29.ipt
Neurophotonics/CAD/Imported Components/18U(DX)002/Assieme2.iam
Neurophotonics/CAD/Imported Components/18U(DX)002/Aste.ipt
Neurophotonics/CAD/Imported Components/18U(DX)002/BB1.ipt
Neurophotonics/CAD/Imported Components/18U(DX)002/Base in alluminio.ipt
Neurophotonics/CAD/Imported Components/18U(DX)002/CNS 4560 M2 x 6.ipt
Neurophotonics/CAD/Imported Components/18U(DX)002/Disco schiaccia OR di29.ipt
Neurophotonics/CAD/Imported Components/18U(DX)002/ISO 4026 M2 x 2.ipt
Neurophotonics/CAD/Imported Components/18U(DX)002/ISO 4027 M1,6 x 2,5.ipt
Neurophotonics/CAD/Imported Components/18U(DX)002/ISO 4762 M2 x 4.ipt
Neurophotonics/CAD/Imported Components/18U(DX)002/M122_1.ipt
Neurophotonics/CAD/Imported Components/18U(DX)002/M122_10.ipt
Neurophotonics/CAD/Imported Components/18U(DX)002/M122_11.ipt
Neurophotonics/CAD/Imported Components/18U(DX)002/M122_12.ipt
Neurophotonics/CAD/Imported Components/18U(DX)002/M122_13.ipt
Neurophotonics/CAD/Imported Components/18U(DX)002/M122_14.ipt
Neurophotonics/CAD/Imported Components/18U(DX)002/M122_2.ipt
Neurophotonics/CAD/Imported Components/18U(DX)002/M122_3.ipt
Neurophotonics/CAD/Imported Components/18U(DX)002/M122_4.ipt
Neurophotonics/CAD/Imported Components/18U(DX)002/M122_5.ipt
Neurophotonics/CAD/Imported Components/18U(DX)002/M122_6.ipt
Neurophotonics/CAD/Imported Components/18U(DX)002/M122_7.ipt
Neurophotonics/CAD/Imported Components/18U(DX)002/M122_8.ipt
Neurophotonics/CAD/Imported Components/18U(DX)002/M122_9.ipt
Neurophotonics/CAD/Imported Components/18U(DX)002/Nik_TPF 10x.ipt
Neurophotonics/CAD/Imported Components/18U(DX)002/Obiettivo XGMP.ipt
Neurophotonics/CAD/Imported Components/18U(DX)002/OldVersions/18U(DX)001_13-2.0001.ipt
Neurophotonics/CAD/Imported Components/18U(DX)002/OldVersions/18U(DX)003_1.0001.ipt
Neurophotonics/CAD/Imported Components/18U(DX)002/OldVersions/18U(DX)003_2.0001.ipt
Neurophotonics/CAD/Imported Components/18U(DX)002/OldVersions/18U(DX)004.0001.iam
Neurophotonics/CAD/Imported Components/18U(DX)002/OldVersions/AS 568 O-Ring DASH # 138.0001.ipt
Neurophotonics/CAD/Imported Components/18U(DX)002/OldVersions/Assieme2.0001.iam
Neurophotonics/CAD/Imported Components/18U(DX)002/OldVersions/Aste.0001.ipt
Neurophotonics/CAD/Imported Components/18U(DX)002/OldVersions/Base in alluminio.0001.ipt
Neurophotonics/CAD/Imported Components/18U(DX)002/OldVersions/CNS 4560 M2 x 6.0001.ipt
Neurophotonics/CAD/Imported Components/18U(DX)002/OldVersions/ISO 4026 M2 x 2.0001.ipt
Neurophotonics/CAD/Imported Components/18U(DX)002/OldVersions/ISO 4027 M1,6 x 2,5.0001.ipt
Neurophotonics/CAD/Imported Components/18U(DX)002/OldVersions/ISO 4762 M2 x 4.0001.ipt
Neurophotonics/CAD/Imported Components/18U(DX)002/OldVersions/M122_1.0001.ipt
Neurophotonics/CAD/Imported Components/18U(DX)002/OldVersions/M122_10.0001.ipt
Neurophotonics/CAD/Imported Components/18U(DX)002/OldVersions/M122_11.0001.ipt
Neurophotonics/CAD/Imported Components/18U(DX)002/OldVersions/M122_12.0001.ipt
Neurophotonics/CAD/Imported Components/18U(DX)002/OldVersions/M122_13.0001.ipt
Neurophotonics/CAD/Imported Components/18U(DX)002/OldVersions/M122_14.0001.ipt
Neurophotonics/CAD/Imported Components/18U(DX)002/OldVersions/M122_2.0001.ipt
Neurophotonics/CAD/Imported Components/18U(DX)002/OldVersions/M122_3.0001.ipt
Neurophotonics/CAD/Imported Components/18U(DX)002/OldVersions/M122_4.0001.ipt
Neurophotonics/CAD/Imported Components/18U(DX)002/OldVersions/M122_5.0001.ipt
Neurophotonics/CAD/Imported Components/18U(DX)002/OldVersions/M122_6.0001.ipt
Neurophotonics/CAD/Imported Components/18U(DX)002/OldVersions/M122_7.0001.ipt
Neurophotonics/CAD/Imported Components/18U(DX)002/OldVersions/M122_8.0001.ipt
Neurophotonics/CAD/Imported Components/18U(DX)002/OldVersions/M122_9.0001.ipt
Neurophotonics/CAD/Imported Components/18U(DX)002/OldVersions/Obiettivo XGMP.0001.ipt
Neurophotonics/CAD/Imported Components/18U(DX)002/OldVersions/Olymp_XLSLPLN25XGMP.0001.ipt
Neurophotonics/CAD/Imported Components/18U(DX)002/OldVersions/PI_M116_2.0001.ipt
Neurophotonics/CAD/Imported Components/18U(DX)002/OldVersions/PI_M116_6.0001.ipt
Neurophotonics/CAD/Imported Components/18U(DX)002/OldVersions/PI_M116_7.0001.ipt
Neurophotonics/CAD/Imported Components/18U(DX)002/OldVersions/PI_M122.0001.iam
Neurophotonics/CAD/Imported Components/18U(DX)002/OldVersions/PI_M122_2.0001.iam
Neurophotonics/CAD/Imported Components/18U(DX)002/OldVersions/Parte1.0001.ipt
Neurophotonics/CAD/Imported Components/18U(DX)002/OldVersions/Parte2.0001.ipt
Neurophotonics/CAD/Imported Components/18U(DX)002/OldVersions/Profilati1.0001.ipt
Neurophotonics/CAD/Imported Components/18U(DX)002/OldVersions/Staffa_50x20x20.0001.ipt
Neurophotonics/CAD/Imported Components/18U(DX)002/OldVersions/Supporto in Ottone.0001.ipt
Neurophotonics/CAD/Imported Components/18U(DX)002/OldVersions/Viti_M1.6.0001.ipt
Neurophotonics/CAD/Imported Components/18U(DX)002/OldVersions/Viti_M2.0001.ipt
Neurophotonics/CAD/Imported Components/18U(DX)002/OldVersions/Viti_M2.5.0001.ipt
Neurophotonics/CAD/Imported Components/18U(DX)002/OldVersions/cuscinetto.0001.ipt
Neurophotonics/CAD/Imported Components/18U(DX)002/Olymp_XLSLPLN25XGMP.ipt
Neurophotonics/CAD/Imported Components/18U(DX)002/PI_M-116.XX.iam
Neurophotonics/CAD/Imported Components/18U(DX)002/PI_M116_1.ipt
Neurophotonics/CAD/Imported Components/18U(DX)002/PI_M116_2.ipt
Neurophotonics/CAD/Imported Components/18U(DX)002/PI_M116_3.ipt
Neurophotonics/CAD/Imported Components/18U(DX)002/PI_M116_4.ipt
Neurophotonics/CAD/Imported Components/18U(DX)002/PI_M116_5.ipt
Neurophotonics/CAD/Imported Components/18U(DX)002/PI_M116_6.ipt
Neurophotonics/CAD/Imported Components/18U(DX)002/PI_M116_7.ipt
Neurophotonics/CAD/Imported Components/18U(DX)002/PI_M122.iam
Neurophotonics/CAD/Imported Components/18U(DX)002/PI_M122_2.iam
Neurophotonics/CAD/Imported Components/18U(DX)002/Parte1.ipt
Neurophotonics/CAD/Imported Components/18U(DX)002/Parte2.ipt
Neurophotonics/CAD/Imported Components/18U(DX)002/Profilati1.ipt
Neurophotonics/CAD/Imported Components/18U(DX)002/Sistema XYZ.iam
Neurophotonics/CAD/Imported Components/18U(DX)002/Sostegno cameretta.ipt
Neurophotonics/CAD/Imported Components/18U(DX)002/Staffa_50x20x20.ipt
Neurophotonics/CAD/Imported Components/18U(DX)002/Supporto in Ottone.ipt
Neurophotonics/CAD/Imported Components/18U(DX)002/Viti_M1.6.ipt
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
