CarolineMuellenbroich/Giovanni-goes-Giorgio/Neurophotonics/inkscaping/DLSFM.pdf

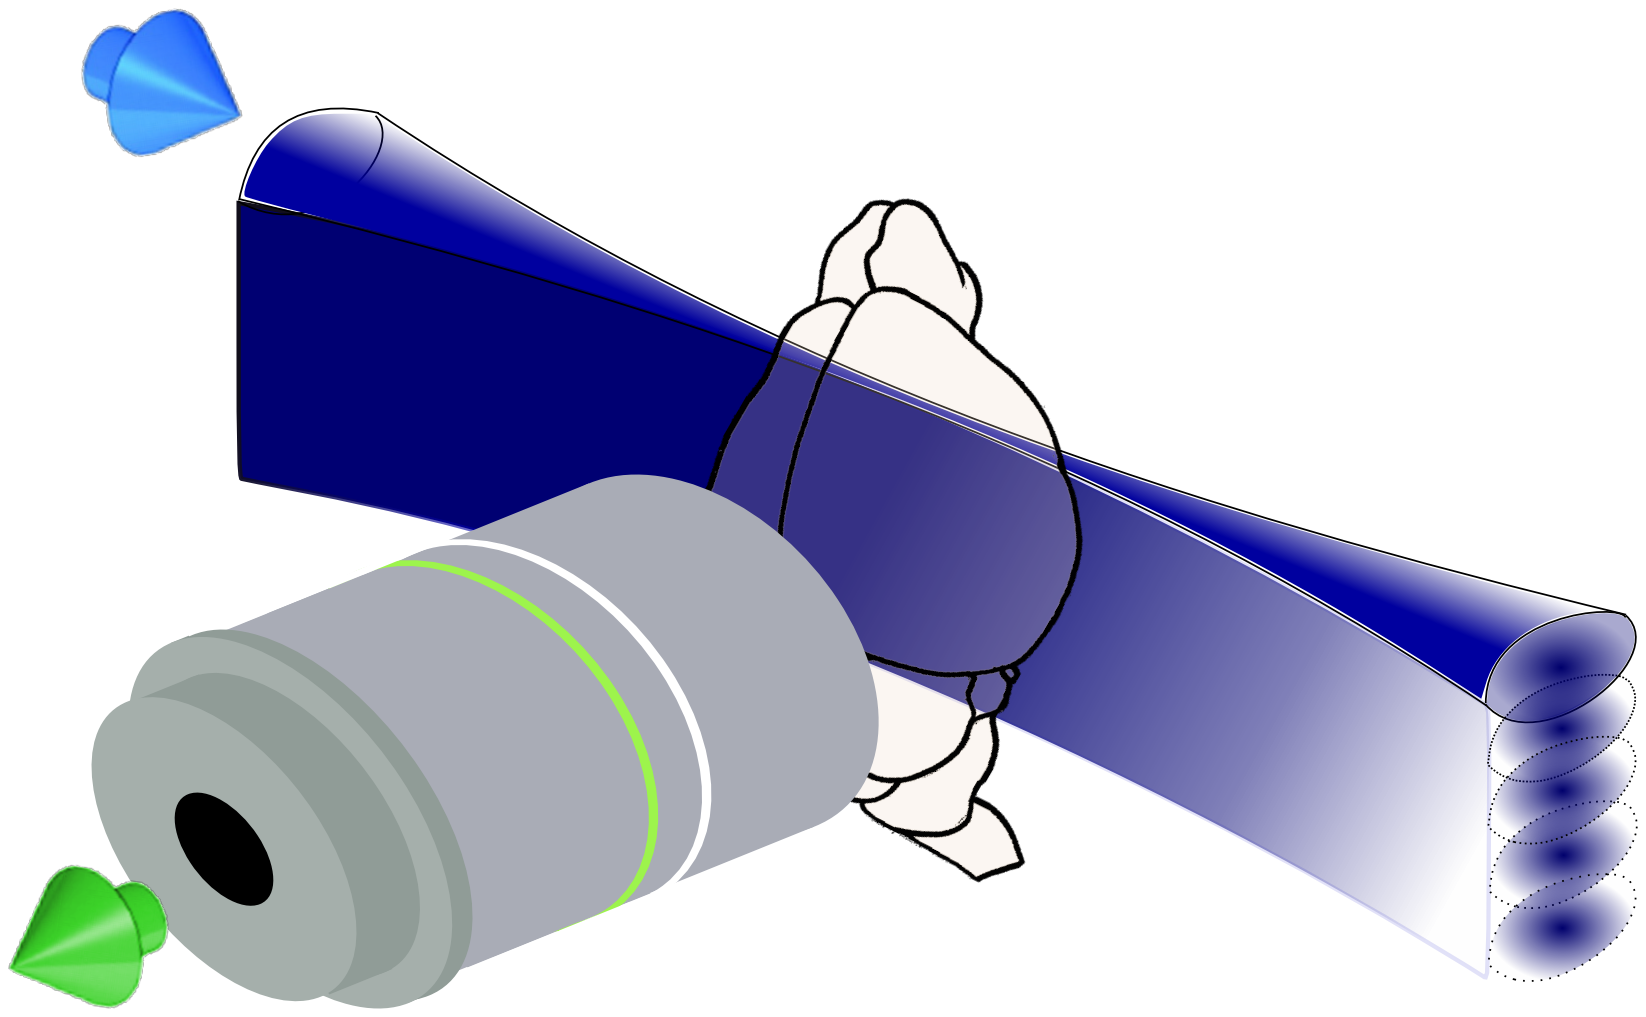
[picture p107: page 1]
