CarolineMuellenbroich/Giovanni-goes-Giorgio/(list of files, drawings)

Other design files:
Neurophotonics/data production.opj
