CarolineMuellenbroich/Giovanni-goes-Giorgio/(commit log)

2015-01-13 commit for sharing with Ludo
    [18U(DX)001_13-2.ipt, 18U(DX)003_1.ipt, 18U(DX)003_2.ipt, 18U(DX)004.iam, AS 568 O-Ring DASH # 138.ipt, Assieme2.iam, Aste.ipt, Base in alluminio.ipt]
2015-01-13 - new y axis scale on mouse brain size graph to include ludos new calculations - marcel's text crudely inserted and needs extensive review
    [data production.opj]
2015-01-15 - modification to PanelSample - citations - expansion on mounting
2015-01-16 - changes to carolines bits
    [18U(DX)001_10.ipt, 18U(DX)001_11.ipt, 18U(DX)001_12.ipt, 18U(DX)001_13-2.0001.ipt, 18U(DX)001_13-2.ipt, 18U(DX)001_13.ipt, 18U(DX)001_15.ipt, 18U(DX)001_18.ipt]
2015-02-03 Finished the software part, changed a bit a couple of figures and made a new one.
2015-02-04 first commit after Leo - no light sheet comic - change of order: light path first, sample stuff dopo - combined panel for chamber and sample mounting - alignment at bottom in supplementary information
2015-02-10 0. Changed the provisional title (just a proposal) 1. The part concerning software and synchronization is almost definitive. (of course it can be corrected and improved) 2. Added a 'theoretical' part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
2015-02-15 - method section to exclude sample preparation from optical characterisation paragraph - find out bead size and company
2015-02-17 manuscript_snellendo_Ludo: add section "representative results" and sample methods in supplementary materials. Slightly changed the caption of Data Figure.
2015-02-17 - merged with ludo: data text and data sample preparation - updated acknowledgement with copy pasta sentence and marco - new RS232 daisy chain in image - subdiffraction replaced with nanometric
2015-02-18 - commit version that went out to coauthors
    [data production.opj]
